Bruhdows/klink/hardware/electronics/hub/uart-allocation.csv

interface | tx_pin | tx_gpio | rx_pin | rx_gpio | af | rx_dma | tx_dma
USART1 | 58 | PB6 | 59 | PB7 | 7 | DMA2:S2:C4 | DMA2:S7:C4
USART2 | 16 | PA2 | 17 | PA3 | 7 | DMA1:S5:C4 | DMA1:S6:C4
USART3 | 29 | PB10 | 30 | PB11 | 7 | DMA1:S1:C4 | DMA1:S3:C4
UART4 | 14 | PA0 | 15 | PA1 | 8 | DMA1:S2:C4 | DMA1:S4:C4
UART5 | 53 | PC12 | 54 | PD2 | 8 | DMA1:S0:C4 | DMA1:S7:C4
USART6 | 37 | PC6 | 38 | PC7 | 8 | DMA2:S1:C5 | DMA2:S6:C5
