Bruhdows/klink/docs/images/gate-3d.png

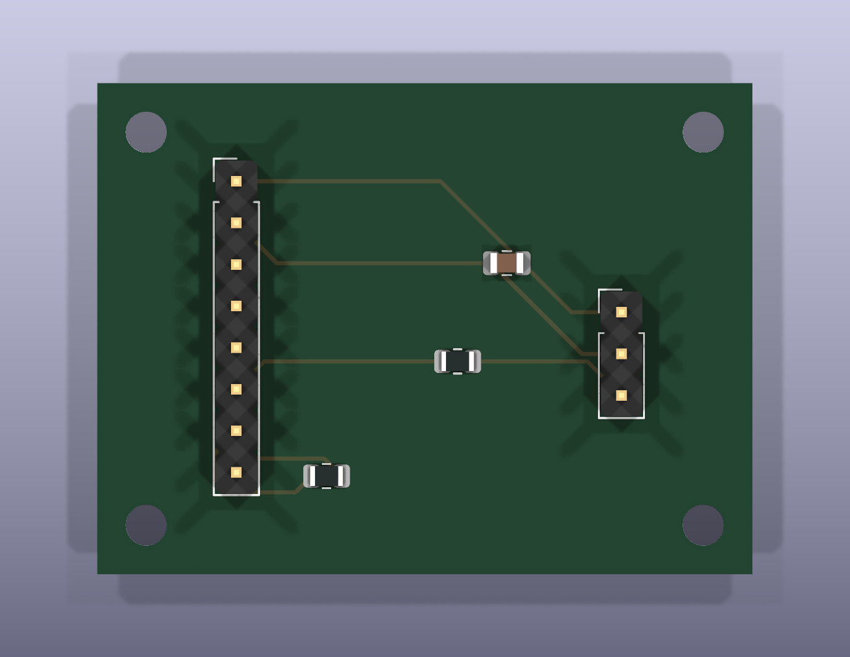
docs/images/gate-3d.png
