Bruhdows/klink/bom.csv

item | manufacturer | mpn | quantity_required | purchase_quantity | unit_price | extended_price | currency | purchase_url | supplier | ownership | price_status | checked_date | quantity_trial_3 | cost_trial_3 | quantity_trial_5 | cost_trial_5 | references | notes | budget_class
0466001.NR | Littelfuse | 0466001.NR | 80 | 80 | 0.555 | 44.4 | USD | https://www.mouser.com/en/ProductDetail/Littelfuse/0466001.NR?qs=ar9f0rk5DXDy6tpNfF8WnQ%3D%3D | Mouser | purchase required | supplier reference listing; not a quote | 2026-11-08 | 15 | 9.9 | 25 | 16.5 | tile:F1; tile:F2; tile:F3; tile:F4; tile:F5 | LCSC C151134 unavailable; use Mouser cut tape; 50+ USD 0.555. No full reel or MouseReel. | base_estimate
430476085716 | Wurth Elektronik | 430476085716 | 1 | 1 | 1.2 | 1.2 | USD | https://www.mouser.com/ProductDetail/Wurth-Elektronik/430476085716 | Mouser / assembler RFQ | purchase required | engineering allowance; NOT a verified supplier price |  | 1 | 1.2 | 1 | 1.2 | button:SW1 | Unquoted allowance; exact MPN retained; confirm stock, JLC classification and package before purchase. | base_estimate
120uF 6.3V | Panasonic | 6TPE120MAZB | 16 | 16 | 1.2 | 19.2 | USD | https://www.mouser.com/ProductDetail/Panasonic/6TPE120MAZB | Mouser / assembler RFQ | purchase required | engineering allowance; NOT a verified supplier price |  | 3 | 3.6 | 5 | 6.0 | tile:C7 | Unquoted allowance; exact MPN retained; confirm stock, JLC classification and package before purchase. | base_estimate
AP2112K-3.3TRG1 | Diodes Incorporated | AP2112K-3.3TRG1 | 19 | 20 | 0.1848 | 3.696 | USD | https://www.lcsc.com/product-detail/C51118.html | LCSC | purchase required | supplier reference listing; not a quote | 2026-11-08 | 10 | 1.848 | 10 | 1.848 | tile:U2; hub:U62; elevator:U2; marble-sensor:U1 | 9025 shown; minimum/multiple 5 | base_estimate
ASE-8.000MHZ-LC-T | Abracon | ASE-8.000MHZ-LC-T | 1 | 1 | 1.5 | 1.5 | USD | https://www.mouser.com/ProductDetail/Abracon/ASE-8.000MHZ-LC-T | Mouser / assembler RFQ | purchase required | engineering allowance; NOT a verified supplier price |  | 1 | 1.5 | 1 | 1.5 | hub:Y70 | Unquoted allowance; exact MPN retained; confirm stock, JLC classification and package before purchase. | base_estimate
ATtiny404-SSN | Microchip | ATTINY404-SSN | 1 | 1 | 0.7 | 0.7 | USD | https://www.mouser.com/ProductDetail/Microchip/ATTINY404-SSN | Mouser / assembler RFQ | purchase required | engineering allowance; NOT a verified supplier price |  | 1 | 0.7 | 1 | 0.7 | elevator:U4 | Unquoted allowance; exact MPN retained; confirm stock, JLC classification and package before purchase. | base_estimate
RESET | Omron | B3U-1000P | 3 | 3 | 0.7 | 2.1 | USD | https://www.mouser.com/ProductDetail/Omron/B3U-1000P | Mouser / assembler RFQ | purchase required | engineering allowance; NOT a verified supplier price |  | 3 | 2.1 | 3 | 2.1 | hub:SW1; hub:SW2; hub:SW3 | Unquoted allowance; exact MPN retained; confirm stock, JLC classification and package before purchase. | base_estimate
BAT54S,215 | Nexperia | BAT54S,215 | 1 | 1 | 0.15 | 0.15 | USD | https://www.mouser.com/ProductDetail/Nexperia/BAT54S%2C215 | Mouser / assembler RFQ | purchase required | engineering allowance; NOT a verified supplier price |  | 1 | 0.15 | 1 | 0.15 | elevator:D2 | Unquoted allowance; exact MPN retained; confirm stock, JLC classification and package before purchase. | base_estimate
BSS138LT1G | onsemi | BSS138LT1G | 9 | 9 | 0.15 | 1.35 | USD | https://www.mouser.com/ProductDetail/onsemi/BSS138LT1G | Mouser / assembler RFQ | purchase required | engineering allowance; NOT a verified supplier price |  | 9 | 1.35 | 9 | 1.35 | hub:Q2; hub:Q11; hub:Q13; hub:Q15; hub:Q17; hub:Q19; hub:Q21; hub:Q70; hub:Q71 | Unquoted allowance; exact MPN retained; confirm stock, JLC classification and package before purchase. | base_estimate
22uF 25V X7R | KEMET | C1210C226K3RACTU | 36 | 36 | 0.35 | 12.6 | USD | https://www.mouser.com/ProductDetail/KEMET/C1210C226K3RACTU | Mouser / assembler RFQ | purchase required | engineering allowance; NOT a verified supplier price |  | 10 | 3.5 | 14 | 4.9 | tile:C11; tile:C12; hub:C405; hub:C406; elevator:C4; elevator:C5 | Unquoted allowance; exact MPN retained; confirm stock, JLC classification and package before purchase. | base_estimate
1nF 50V | TDK | C2012C0G1H102J125AA | 1 | 1 | 0.1 | 0.1 | USD | https://www.mouser.com/ProductDetail/TDK/C2012C0G1H102J125AA | Mouser / assembler RFQ | purchase required | engineering allowance; NOT a verified supplier price |  | 1 | 0.1 | 1 | 0.1 | marble-sensor:C3 | Unquoted allowance; exact MPN retained; confirm stock, JLC classification and package before purchase. | base_estimate
22nF 50V C0G | TDK | C2012C0G1H223J125AA | 7 | 7 | 0.1 | 0.7 | USD | https://www.mouser.com/ProductDetail/TDK/C2012C0G1H223J125AA | Mouser / assembler RFQ | purchase required | engineering allowance; NOT a verified supplier price |  | 7 | 0.7 | 7 | 0.7 | hub:C103; hub:C113; hub:C123; hub:C133; hub:C143; hub:C153; elevator:C11 | Unquoted allowance; exact MPN retained; confirm stock, JLC classification and package before purchase. | base_estimate
2.2uF 16V X7R | TDK | C2012X7R1C225K125AB | 2 | 2 | 0.1 | 0.2 | USD | https://www.mouser.com/ProductDetail/TDK/C2012X7R1C225K125AB | Mouser / assembler RFQ | purchase required | engineering allowance; NOT a verified supplier price |  | 2 | 0.2 | 2 | 0.2 | hub:C415; hub:C416 | Unquoted allowance; exact MPN retained; confirm stock, JLC classification and package before purchase. | base_estimate
4.7uF | TDK | C2012X7R1C475K125AB | 18 | 18 | 0.1 | 1.8 | USD | https://www.mouser.com/ProductDetail/TDK/C2012X7R1C475K125AB | Mouser / assembler RFQ | purchase required | engineering allowance; NOT a verified supplier price |  | 5 | 0.5 | 7 | 0.7 | tile:C2; hub:C414; elevator:C8 | Unquoted allowance; exact MPN retained; confirm stock, JLC classification and package before purchase. | base_estimate
100nF 50V X7R | TDK | C2012X7R1H104K125AE | 322 | 322 | 0.1 | 32.2 | USD | https://www.mouser.com/ProductDetail/TDK/C2012X7R1H104K125AE | Mouser / assembler RFQ | purchase required | engineering allowance; NOT a verified supplier price |  | 101 | 10.1 | 135 | 13.5 | tile:C1; tile:C5; tile:C6; tile:C9; tile:C10; tile:C14; tile:C15; tile:C17; tile:C20; tile:C21; tile:C22; tile:C23; tile:C25; tile:C29; tile:C30; tile:C31; tile:C32; hub:C4; hub:C5; hub:C7; hub:C8; hub:C10; hub:C11; hub:C12; hub:C13; hub:C462; hub:C104; hub:C114; hub:C124; hub:C134; hub:C144; hub:C154; hub:C300; hub:C303; hub:C306; hub:C307; hub:C308; hub:C309; hub:C310; hub:C311; hub:C312; hub:C313; hub:C400; hub:C401; hub:C403; hub:C410; hub:C411; hub:C412; hub:C413; hub:C417; hub:C419; hub:C420; hub:C421; hub:C440; hub:C443; hub:C450; hub:C451; hub:C452; hub:C453; hub:C460; hub:C461; elevator:C2; elevator:C9; elevator:C10; elevator:C12; elevator:C13; gate:C1 | Unquoted allowance; exact MPN retained; confirm stock, JLC classification and package before purchase. | base_estimate
1uF | TDK | C2012X7R1H105K125AB | 94 | 94 | 0.1 | 9.4 | USD | https://www.mouser.com/ProductDetail/TDK/C2012X7R1H105K125AB | Mouser / assembler RFQ | purchase required | engineering allowance; NOT a verified supplier price |  | 42 | 4.2 | 50 | 5.0 | tile:C3; tile:C18; tile:C19; tile:C24; hub:C1; hub:C2; hub:C3; hub:C6; hub:C14; hub:C100; hub:C101; hub:C102; hub:C110; hub:C111; hub:C112; hub:C120; hub:C121; hub:C122; hub:C130; hub:C131; hub:C132; hub:C140; hub:C141; hub:C142; hub:C150; hub:C151; hub:C152; hub:C404; hub:C407; hub:C418; elevator:C3; elevator:C7; marble-sensor:C1; marble-sensor:C2 | Unquoted allowance; exact MPN retained; confirm stock, JLC classification and package before purchase. | base_estimate
10µF | TDK | C3216X7R1C106K160AC | 17 | 17 | 0.35 | 5.95 | USD | https://www.mouser.com/ProductDetail/TDK/C3216X7R1C106K160AC | Mouser / assembler RFQ | purchase required | engineering allowance; NOT a verified supplier price |  | 4 | 1.4 | 6 | 2.1 | tile:C4; hub:C408 | Unquoted allowance; exact MPN retained; confirm stock, JLC classification and package before purchase. | base_estimate
10uF 50V X7R | TDK | C3216X7R1H106K160AC | 19 | 19 | 0.35 | 6.65 | USD | https://www.mouser.com/ProductDetail/TDK/C3216X7R1H106K160AC | Mouser / assembler RFQ | purchase required | engineering allowance; NOT a verified supplier price |  | 6 | 2.1 | 8 | 2.8 | tile:C8; hub:C9; hub:C402; elevator:C1 | Unquoted allowance; exact MPN retained; confirm stock, JLC classification and package before purchase. | base_estimate
10nF 50V | Yageo | CC0805KRX7R9BB103 | 50 | 50 | 0.1 | 5.0 | USD | https://www.mouser.com/ProductDetail/Yageo/CC0805KRX7R9BB103 | Mouser / assembler RFQ | purchase required | engineering allowance; NOT a verified supplier price |  | 11 | 1.1 | 17 | 1.7 | tile:C13; tile:C16; tile:C33; elevator:C14; elevator:C15 | Unquoted allowance; exact MPN retained; confirm stock, JLC classification and package before purchase. | base_estimate
CH32X035G8U6 | WCH | CH32X035G8U6 | 16 | 16 | 0.4234 | 6.7744 | USD | https://www.lcsc.com/product-detail/C7437027.html | LCSC | purchase required | supplier reference listing; not a quote | 2026-11-08 | 3 | 1.6197 | 5 | 2.6995 | tile:U1 | 8785 shown | base_estimate
CSD19537Q3 | Texas Instruments | CSD19537Q3 | 7 | 7 | 1.5 | 10.5 | USD | https://www.mouser.com/ProductDetail/Texas-Instruments/CSD19537Q3 | Mouser / assembler RFQ | purchase required | engineering allowance; NOT a verified supplier price |  | 7 | 10.5 | 7 | 10.5 | hub:Q1; hub:Q10; hub:Q12; hub:Q14; hub:Q16; hub:Q18; hub:Q20 | Unquoted allowance; exact MPN retained; confirm stock, JLC classification and package before purchase. | base_estimate
DRV8876PWPR |  | DRV8876PWPR | 1 | 1 | 2.5 | 2.5 | USD | https://www.mouser.com/ProductDetail//DRV8876PWPR | Mouser / assembler RFQ | purchase required | engineering allowance; NOT a verified supplier price |  | 1 | 2.5 | 1 | 2.5 | elevator:U3 | Unquoted allowance; exact MPN retained; confirm stock, JLC classification and package before purchase. | base_estimate
100uF 25V | Panasonic | EEH-ZC1E101XP | 1 | 1 | 1.5 | 1.5 | USD | https://www.mouser.com/ProductDetail/Panasonic/EEH-ZC1E101XP | Mouser / assembler RFQ | purchase required | engineering allowance; NOT a verified supplier price |  | 1 | 1.5 | 1 | 1.5 | elevator:C6 | Unquoted allowance; exact MPN retained; confirm stock, JLC classification and package before purchase. | base_estimate
10.5k 0.1% | Panasonic | ERA6AEB1052V | 1 | 1 | 0.3 | 0.3 | USD | https://www.mouser.com/ProductDetail/Panasonic/ERA6AEB1052V | Mouser / assembler RFQ | purchase required | engineering allowance; NOT a verified supplier price |  | 1 | 0.3 | 1 | 0.3 | hub:R14 | Unquoted allowance; exact MPN retained; confirm stock, JLC classification and package before purchase. | base_estimate
INA301A1IDGKR | Texas Instruments | INA301A1IDGKR | 7 | 7 | 3.5 | 24.5 | USD | https://www.mouser.com/ProductDetail/Texas-Instruments/INA301A1IDGKR | Mouser / assembler RFQ | purchase required | engineering allowance; NOT a verified supplier price |  | 7 | 24.5 | 7 | 24.5 | hub:U4; hub:U21; hub:U23; hub:U25; hub:U27; hub:U29; hub:U31 | Unquoted allowance; exact MPN retained; confirm stock, JLC classification and package before purchase. | base_estimate
LMR36510ADDAR | Texas Instruments | LMR36510ADDAR | 1 | 1 | 1.7 | 1.7 | USD | https://www.mouser.com/ProductDetail/Texas-Instruments/LMR36510ADDAR | Mouser / assembler RFQ | purchase required | engineering allowance; NOT a verified supplier price |  | 1 | 1.7 | 1 | 1.7 | elevator:U1 | Unquoted allowance; exact MPN retained; confirm stock, JLC classification and package before purchase. | base_estimate
LMR36520ADDAR | Texas Instruments | LMR36520ADDAR | 17 | 17 | 1.0022 | 17.0374 | USD | https://www.lcsc.com/product-detail/C2879422.html | LCSC | purchase required | supplier reference listing; not a quote | 2026-11-08 | 4 | 4.8516 | 6 | 7.2774 | tile:U4; hub:U61 | 5727 shown | base_estimate
IR_EMITTER | Harwin | M20-9990246 | 2 | 2 | 0.7 | 1.4 | USD | https://www.mouser.com/ProductDetail/Harwin/M20-9990246 | Mouser / assembler RFQ | purchase required | engineering allowance; NOT a verified supplier price |  | 2 | 1.4 | 2 | 1.4 | marble-sensor:J2; marble-sensor:J3 | Unquoted allowance; exact MPN retained; confirm stock, JLC classification and package before purchase. | base_estimate
FS90_SERVO | Harwin | M20-9990346 | 1 | 1 | 0.7 | 0.7 | USD | https://www.mouser.com/ProductDetail/Harwin/M20-9990346 | Mouser / assembler RFQ | purchase required | engineering allowance; NOT a verified supplier price |  | 1 | 0.7 | 1 | 0.7 | gate:J2 | Unquoted allowance; exact MPN retained; confirm stock, JLC classification and package before purchase. | base_estimate
MODULE_SERVICE | Harwin | M20-9990846 | 3 | 3 | 0.7 | 2.1 | USD | https://www.mouser.com/ProductDetail/Harwin/M20-9990846 | Mouser / assembler RFQ | purchase required | engineering allowance; NOT a verified supplier price |  | 3 | 2.1 | 3 | 2.1 | button:J1; marble-sensor:J1; gate:J1 | Unquoted allowance; exact MPN retained; confirm stock, JLC classification and package before purchase. | base_estimate
100k | Yageo | RC0805FR-07100KL | 76 | 76 | 0.04 | 3.04 | USD | https://www.mouser.com/ProductDetail/Yageo/RC0805FR-07100KL | Mouser / assembler RFQ | purchase required | engineering allowance; NOT a verified supplier price |  | 24 | 0.96 | 32 | 1.28 | tile:R10; tile:R13; tile:R14; tile:R47; hub:R303; hub:R404; hub:R416; hub:R471; hub:R472; hub:R494; elevator:R2; elevator:R10; elevator:R11; elevator:R12; elevator:R13; elevator:R14 | Unquoted allowance; exact MPN retained; confirm stock, JLC classification and package before purchase. | base_estimate
10k | Yageo | RC0805FR-0710KL | 222 | 300 | 0.0049 | 1.47 | USD | https://www.lcsc.com/product-detail/C84376.html | LCSC | purchase required | supplier reference listing; not a quote | 2026-11-08 | 100 | 0.49 | 100 | 0.49 | tile:R4; tile:R7; tile:R8; tile:R9; tile:R12; tile:R15; tile:R19; tile:R20; tile:R27; tile:R46; tile:R48; tile:R49; hub:R2; hub:R6; hub:R7; hub:R16; hub:R17; hub:R18; hub:R473; hub:R109; hub:R129; hub:R149; hub:R169; hub:R189; hub:R209; hub:R405; hub:R408; hub:R412; hub:R413; hub:R414; hub:R415; hub:R417; hub:R418; hub:R420; hub:R480; hub:R481; hub:R482; hub:R470; elevator:R3; elevator:R9; elevator:R18; marble-sensor:R3 | supplier reference listing; verify current tier | base_estimate
12k 1% | Yageo | RC0805FR-0712KL | 16 | 16 | 0.04 | 0.64 | USD | https://www.mouser.com/ProductDetail/Yageo/RC0805FR-0712KL | Mouser / assembler RFQ | purchase required | engineering allowance; NOT a verified supplier price |  | 3 | 0.12 | 5 | 0.2 | tile:R21 | Unquoted allowance; exact MPN retained; confirm stock, JLC classification and package before purchase. | base_estimate
150k 1% | Yageo | RC0805FR-07150KL | 17 | 17 | 0.04 | 0.68 | USD | https://www.mouser.com/ProductDetail/Yageo/RC0805FR-07150KL | Mouser / assembler RFQ | purchase required | engineering allowance; NOT a verified supplier price |  | 4 | 0.16 | 6 | 0.24 | tile:R11; elevator:R16 | Unquoted allowance; exact MPN retained; confirm stock, JLC classification and package before purchase. | base_estimate
1k | Yageo | RC0805FR-071KL | 74 | 74 | 0.04 | 2.96 | USD | https://www.mouser.com/ProductDetail/Yageo/RC0805FR-071KL | Mouser / assembler RFQ | purchase required | engineering allowance; NOT a verified supplier price |  | 22 | 0.88 | 30 | 1.2 | tile:R5; tile:R6; tile:R24; tile:R50; hub:R419; hub:R483; hub:R484; hub:R485; elevator:R15; elevator:R20; button:R1; button:R2; marble-sensor:R4; gate:R2 | Unquoted allowance; exact MPN retained; confirm stock, JLC classification and package before purchase. | base_estimate
1M 1% | Yageo | RC0805FR-071ML | 1 | 1 | 0.04 | 0.04 | USD | https://www.mouser.com/ProductDetail/Yageo/RC0805FR-071ML | Mouser / assembler RFQ | purchase required | engineering allowance; NOT a verified supplier price |  | 1 | 0.04 | 1 | 0.04 | hub:R495 | Unquoted allowance; exact MPN retained; confirm stock, JLC classification and package before purchase. | base_estimate
22k 1% | Yageo | RC0805FR-0722KL | 17 | 17 | 0.04 | 0.68 | USD | https://www.mouser.com/ProductDetail/Yageo/RC0805FR-0722KL | Mouser / assembler RFQ | purchase required | engineering allowance; NOT a verified supplier price |  | 17 | 0.68 | 17 | 0.68 | hub:R15; hub:R19; hub:R103; hub:R104; hub:R123; hub:R124; hub:R143; hub:R144; hub:R163; hub:R164; hub:R183; hub:R184; hub:R203; hub:R204; hub:R302; elevator:R1; elevator:R17 | Unquoted allowance; exact MPN retained; confirm stock, JLC classification and package before purchase. | base_estimate
22 1% | Yageo | RC0805FR-0722RL | 2 | 2 | 0.04 | 0.08 | USD | https://www.mouser.com/ProductDetail/Yageo/RC0805FR-0722RL | Mouser / assembler RFQ | purchase required | engineering allowance; NOT a verified supplier price |  | 2 | 0.08 | 2 | 0.08 | hub:R492; hub:R493 | Unquoted allowance; exact MPN retained; confirm stock, JLC classification and package before purchase. | base_estimate
24k 1% | Yageo | RC0805FR-0724KL | 16 | 16 | 0.04 | 0.64 | USD | https://www.mouser.com/ProductDetail/Yageo/RC0805FR-0724KL | Mouser / assembler RFQ | purchase required | engineering allowance; NOT a verified supplier price |  | 3 | 0.12 | 5 | 0.2 | tile:R16 | Unquoted allowance; exact MPN retained; confirm stock, JLC classification and package before purchase. | base_estimate
2.2k 1% | Yageo | RC0805FR-072K2L | 1 | 1 | 0.04 | 0.04 | USD | https://www.mouser.com/ProductDetail/Yageo/RC0805FR-072K2L | Mouser / assembler RFQ | purchase required | engineering allowance; NOT a verified supplier price |  | 1 | 0.04 | 1 | 0.04 | marble-sensor:R1 | Unquoted allowance; exact MPN retained; confirm stock, JLC classification and package before purchase. | base_estimate
330 | Yageo | RC0805FR-07330RL | 16 | 16 | 0.04 | 0.64 | USD | https://www.mouser.com/ProductDetail/Yageo/RC0805FR-07330RL | Mouser / assembler RFQ | purchase required | engineering allowance; NOT a verified supplier price |  | 3 | 0.12 | 5 | 0.2 | tile:R3 | Unquoted allowance; exact MPN retained; confirm stock, JLC classification and package before purchase. | base_estimate
33 1% | Yageo | RC0805FR-0733RL | 1 | 1 | 0.04 | 0.04 | USD | https://www.mouser.com/ProductDetail/Yageo/RC0805FR-0733RL | Mouser / assembler RFQ | purchase required | engineering allowance; NOT a verified supplier price |  | 1 | 0.04 | 1 | 0.04 | hub:R411 | Unquoted allowance; exact MPN retained; confirm stock, JLC classification and package before purchase. | base_estimate
402k 1% | Yageo | RC0805FR-07402KL | 33 | 33 | 0.04 | 1.32 | USD | https://www.mouser.com/ProductDetail/Yageo/RC0805FR-07402KL | Mouser / assembler RFQ | purchase required | engineering allowance; NOT a verified supplier price |  | 7 | 0.28 | 11 | 0.44 | tile:R22; tile:R23; hub:R401 | Unquoted allowance; exact MPN retained; confirm stock, JLC classification and package before purchase. | base_estimate
40.2k 1% | Yageo | RC0805FR-0740K2L | 1 | 1 | 0.04 | 0.04 | USD | https://www.mouser.com/ProductDetail/Yageo/RC0805FR-0740K2L | Mouser / assembler RFQ | purchase required | engineering allowance; NOT a verified supplier price |  | 1 | 0.04 | 1 | 0.04 | hub:R400 | Unquoted allowance; exact MPN retained; confirm stock, JLC classification and package before purchase. | base_estimate
47k | Yageo | RC0805FR-0747KL | 142 | 142 | 0.04 | 5.68 | USD | https://www.mouser.com/ProductDetail/Yageo/RC0805FR-0747KL | Mouser / assembler RFQ | purchase required | engineering allowance; NOT a verified supplier price |  | 38 | 1.52 | 54 | 2.16 | tile:R32; tile:R33; tile:R36; tile:R37; tile:R40; tile:R41; tile:R44; tile:R45; hub:R304; hub:R442; hub:R443; hub:R446; hub:R447; hub:R450; hub:R451; hub:R454; hub:R455; hub:R458; hub:R459; hub:R462; hub:R463; hub:R496 | Unquoted allowance; exact MPN retained; confirm stock, JLC classification and package before purchase. | base_estimate
4.7k | Yageo | RC0805FR-074K7L | 36 | 36 | 0.04 | 1.44 | USD | https://www.mouser.com/ProductDetail/Yageo/RC0805FR-074K7L | Mouser / assembler RFQ | purchase required | engineering allowance; NOT a verified supplier price |  | 10 | 0.4 | 14 | 0.56 | tile:R1; tile:R2; hub:R3; hub:R4; hub:R5; gate:R1 | Unquoted allowance; exact MPN retained; confirm stock, JLC classification and package before purchase. | base_estimate
5.1k 1% | Yageo | RC0805FR-075K1L | 2 | 2 | 0.04 | 0.08 | USD | https://www.mouser.com/ProductDetail/Yageo/RC0805FR-075K1L | Mouser / assembler RFQ | purchase required | engineering allowance; NOT a verified supplier price |  | 2 | 0.08 | 2 | 0.08 | hub:R490; hub:R491 | Unquoted allowance; exact MPN retained; confirm stock, JLC classification and package before purchase. | base_estimate
150 1% 0.25W | Yageo | RC1206FR-07150RL | 1 | 1 | 0.1 | 0.1 | USD | https://www.mouser.com/ProductDetail/Yageo/RC1206FR-07150RL | Mouser / assembler RFQ | purchase required | engineering allowance; NOT a verified supplier price |  | 1 | 0.1 | 1 | 0.1 | elevator:R19 | Unquoted allowance; exact MPN retained; confirm stock, JLC classification and package before purchase. | base_estimate
220 1% 0.25W | Yageo | RC1206FR-07220RL | 1 | 1 | 0.1 | 0.1 | USD | https://www.mouser.com/ProductDetail/Yageo/RC1206FR-07220RL | Mouser / assembler RFQ | purchase required | engineering allowance; NOT a verified supplier price |  | 1 | 0.1 | 1 | 0.1 | marble-sensor:R2 | Unquoted allowance; exact MPN retained; confirm stock, JLC classification and package before purchase. | base_estimate
2.2k 1% 0.25W | Yageo | RC1206FR-072K2L | 140 | 140 | 0.1 | 14.0 | USD | https://www.mouser.com/ProductDetail/Yageo/RC1206FR-072K2L | Mouser / assembler RFQ | purchase required | engineering allowance; NOT a verified supplier price |  | 36 | 3.6 | 52 | 5.2 | tile:R30; tile:R31; tile:R34; tile:R35; tile:R38; tile:R39; tile:R42; tile:R43; hub:R440; hub:R441; hub:R444; hub:R445; hub:R448; hub:R449; hub:R452; hub:R453; hub:R456; hub:R457; hub:R460; hub:R461 | Unquoted allowance; exact MPN retained; confirm stock, JLC classification and package before purchase. | base_estimate
10k 1% 0.25W | Yageo | RC1206FR0710KL | 7 | 7 | 0.1 | 0.7 | USD | https://www.mouser.com/ProductDetail/Yageo/RC1206FR0710KL | Mouser / assembler RFQ | purchase required | engineering allowance; NOT a verified supplier price |  | 7 | 0.7 | 7 | 0.7 | hub:R20; hub:R110; hub:R130; hub:R150; hub:R170; hub:R190; hub:R210 | Unquoted allowance; exact MPN retained; confirm stock, JLC classification and package before purchase. | base_estimate
470 1% 2W | Yageo | RC2512FK-7W470RL | 1 | 1 | 0.1 | 0.1 | USD | https://www.mouser.com/ProductDetail/Yageo/RC2512FK-7W470RL | Mouser / assembler RFQ | purchase required | engineering allowance; NOT a verified supplier price |  | 1 | 0.1 | 1 | 0.1 | hub:R1 | Unquoted allowance; exact MPN retained; confirm stock, JLC classification and package before purchase. | base_estimate
100k 0.1% | Yageo | RT0805BRD07100KL | 17 | 17 | 0.3 | 5.1 | USD | https://www.mouser.com/ProductDetail/Yageo/RT0805BRD07100KL | Mouser / assembler RFQ | purchase required | engineering allowance; NOT a verified supplier price |  | 4 | 1.2 | 6 | 1.8 | tile:R28; hub:R406 | Unquoted allowance; exact MPN retained; confirm stock, JLC classification and package before purchase. | base_estimate
103k 0.1% | Yageo | RT0805BRD07103KL | 16 | 16 | 0.3 | 4.8 | USD | https://www.mouser.com/ProductDetail/Yageo/RT0805BRD07103KL | Mouser / assembler RFQ | purchase required | engineering allowance; NOT a verified supplier price |  | 3 | 0.9 | 5 | 1.5 | tile:R51 | Unquoted allowance; exact MPN retained; confirm stock, JLC classification and package before purchase. | base_estimate
10k 0.1% | Yageo | RT0805BRD0710KL | 67 | 80 | 0.0433 | 3.464 | USD | https://www.lcsc.com/product-detail/C110775.html | LCSC | purchase required | supplier reference listing; not a quote | 2026-11-08 | 20 | 0.866 | 40 | 1.732 | tile:R18; tile:R55; tile:R26; tile:R52; hub:R403; elevator:R5; elevator:R7 | supplier reference listing; verify current tier | base_estimate
110k 0.1% | Yageo | RT0805BRD07110KL | 1 | 1 | 0.3 | 0.3 | USD | https://www.mouser.com/ProductDetail/Yageo/RT0805BRD07110KL | Mouser / assembler RFQ | purchase required | engineering allowance; NOT a verified supplier price |  | 1 | 0.3 | 1 | 0.3 | elevator:R4 | Unquoted allowance; exact MPN retained; confirm stock, JLC classification and package before purchase. | base_estimate
187k 0.1% | Yageo | RT0805BRD07187KL | 33 | 33 | 0.3 | 9.9 | USD | https://www.mouser.com/ProductDetail/Yageo/RT0805BRD07187KL | Mouser / assembler RFQ | purchase required | engineering allowance; NOT a verified supplier price |  | 7 | 2.1 | 11 | 3.3 | tile:R17; tile:R25; hub:R402 | Unquoted allowance; exact MPN retained; confirm stock, JLC classification and package before purchase. | base_estimate
23.2k 0.1% | Yageo | RT0805BRD0723K2L | 1 | 1 | 0.3 | 0.3 | USD | https://www.mouser.com/ProductDetail/Yageo/RT0805BRD0723K2L | Mouser / assembler RFQ | purchase required | engineering allowance; NOT a verified supplier price |  | 1 | 0.3 | 1 | 0.3 | elevator:R6 | Unquoted allowance; exact MPN retained; confirm stock, JLC classification and package before purchase. | base_estimate
24.9k 0.1% | Yageo | RT0805BRD0724K9L | 17 | 17 | 0.3 | 5.1 | USD | https://www.mouser.com/ProductDetail/Yageo/RT0805BRD0724K9L | Mouser / assembler RFQ | purchase required | engineering allowance; NOT a verified supplier price |  | 4 | 1.2 | 6 | 1.8 | tile:R29; hub:R407 | Unquoted allowance; exact MPN retained; confirm stock, JLC classification and package before purchase. | base_estimate
2.87k 0.1% | Yageo | RT0805BRD072K87L | 1 | 1 | 0.3 | 0.3 | USD | https://www.mouser.com/ProductDetail/Yageo/RT0805BRD072K87L | Mouser / assembler RFQ | purchase required | engineering allowance; NOT a verified supplier price |  | 1 | 0.3 | 1 | 0.3 | elevator:R8 | Unquoted allowance; exact MPN retained; confirm stock, JLC classification and package before purchase. | base_estimate
35.7k 0.1% | Yageo | RT0805BRD0735K7L | 16 | 16 | 0.3 | 4.8 | USD | https://www.mouser.com/ProductDetail/Yageo/RT0805BRD0735K7L | Mouser / assembler RFQ | purchase required | engineering allowance; NOT a verified supplier price |  | 3 | 0.9 | 5 | 1.5 | tile:R54 | Unquoted allowance; exact MPN retained; confirm stock, JLC classification and package before purchase. | base_estimate
3.32k 0.1% | Yageo | RT0805BRD073K32L | 16 | 16 | 0.3 | 4.8 | USD | https://www.mouser.com/ProductDetail/Yageo/RT0805BRD073K32L | Mouser / assembler RFQ | purchase required | engineering allowance; NOT a verified supplier price |  | 3 | 0.9 | 5 | 1.5 | tile:R53 | Unquoted allowance; exact MPN retained; confirm stock, JLC classification and package before purchase. | base_estimate
SMBJ13A-E3/52 | Vishay | SMBJ13A-E3/52 | 1 | 1 | 0.35 | 0.35 | USD | https://www.mouser.com/ProductDetail/Vishay/SMBJ13A-E3%2F52 | Mouser / assembler RFQ | purchase required | engineering allowance; NOT a verified supplier price |  | 1 | 0.35 | 1 | 0.35 | elevator:D1 | Unquoted allowance; exact MPN retained; confirm stock, JLC classification and package before purchase. | base_estimate
SMBJ22A-E3/52 | Vishay | SMBJ22A-E3/52 | 39 | 39 | 0.35 | 13.65 | USD | https://www.mouser.com/ProductDetail/Vishay/SMBJ22A-E3%2F52 | Mouser / assembler RFQ | purchase required | engineering allowance; NOT a verified supplier price |  | 13 | 4.55 | 17 | 5.95 | tile:D6; tile:D7; hub:D8; hub:D100; hub:D101; hub:D102; hub:D103; hub:D104; hub:D105 | Unquoted allowance; exact MPN retained; confirm stock, JLC classification and package before purchase. | base_estimate
SMBJ22CA-E3/52 | Vishay | SMBJ22CA-E3/52 | 32 | 32 | 0.35 | 11.2 | USD | https://www.mouser.com/ProductDetail/Vishay/SMBJ22CA-E3%2F52 | Mouser / assembler RFQ | purchase required | engineering allowance; NOT a verified supplier price |  | 6 | 2.1 | 10 | 3.5 | tile:D4; tile:D5 | Unquoted allowance; exact MPN retained; confirm stock, JLC classification and package before purchase. | base_estimate
SN74AHCT1G125DBVR | Texas Instruments | SN74AHCT1G125DBVR | 16 | 20 | 0.1009 | 2.018 | USD | https://www.lcsc.com/product-detail/C7484.html | LCSC | purchase required | supplier reference listing; not a quote | 2026-11-08 | 5 | 0.5045 | 5 | 0.5045 | tile:U6 | 13395 shown; minimum/multiple 5 | base_estimate
SN74HCS11PWR | Texas Instruments | SN74HCS11PWR | 2 | 2 | 0.7 | 1.4 | USD | https://www.mouser.com/ProductDetail/Texas-Instruments/SN74HCS11PWR | Mouser / assembler RFQ | purchase required | engineering allowance; NOT a verified supplier price |  | 2 | 1.4 | 2 | 1.4 | hub:U40; hub:U43 | Unquoted allowance; exact MPN retained; confirm stock, JLC classification and package before purchase. | base_estimate
SN74LVC1G04DBVR | Texas Instruments | SN74LVC1G04DBVR | 1 | 1 | 0.7 | 0.7 | USD | https://www.mouser.com/ProductDetail/Texas-Instruments/SN74LVC1G04DBVR | Mouser / assembler RFQ | purchase required | engineering allowance; NOT a verified supplier price |  | 1 | 0.7 | 1 | 0.7 | hub:U49 | Unquoted allowance; exact MPN retained; confirm stock, JLC classification and package before purchase. | base_estimate
SN74LVC1G08DBVR | Texas Instruments | SN74LVC1G08DBVR | 17 | 20 | 0.0489 | 0.978 | USD | https://www.lcsc.com/product-detail/C7666.html | LCSC | purchase required | supplier reference listing; not a quote | 2026-11-08 | 10 | 0.489 | 10 | 0.489 | tile:U15; hub:U47 | 90360 shown; minimum/multiple 10 | base_estimate
SN74LVC1G11DBVR | Texas Instruments | SN74LVC1G11DBVR | 1 | 1 | 0.7 | 0.7 | USD | https://www.mouser.com/ProductDetail/Texas-Instruments/SN74LVC1G11DBVR | Mouser / assembler RFQ | purchase required | engineering allowance; NOT a verified supplier price |  | 1 | 0.7 | 1 | 0.7 | hub:U6 | Unquoted allowance; exact MPN retained; confirm stock, JLC classification and package before purchase. | base_estimate
SN74LVC1G14DBVR | Texas Instruments | SN74LVC1G14DBVR | 1 | 1 | 0.7 | 0.7 | USD | https://www.mouser.com/ProductDetail/Texas-Instruments/SN74LVC1G14DBVR | Mouser / assembler RFQ | purchase required | engineering allowance; NOT a verified supplier price |  | 1 | 0.7 | 1 | 0.7 | hub:U5 | Unquoted allowance; exact MPN retained; confirm stock, JLC classification and package before purchase. | base_estimate
SN74LVC1G32DBVR | Texas Instruments | SN74LVC1G32DBVR | 2 | 2 | 0.7 | 1.4 | USD | https://www.mouser.com/ProductDetail/Texas-Instruments/SN74LVC1G32DBVR | Mouser / assembler RFQ | purchase required | engineering allowance; NOT a verified supplier price |  | 2 | 1.4 | 2 | 1.4 | hub:U46; hub:U48 | Unquoted allowance; exact MPN retained; confirm stock, JLC classification and package before purchase. | base_estimate
SN74LVC1G97DBVR | Texas Instruments | SN74LVC1G97DBVR | 1 | 1 | 0.7 | 0.7 | USD | https://www.mouser.com/ProductDetail/Texas-Instruments/SN74LVC1G97DBVR | Mouser / assembler RFQ | purchase required | engineering allowance; NOT a verified supplier price |  | 1 | 0.7 | 1 | 0.7 | hub:U79 | Unquoted allowance; exact MPN retained; confirm stock, JLC classification and package before purchase. | base_estimate
SN74LVC244APWR | Texas Instruments | SN74LVC244APWR | 18 | 20 | 0.3026 | 6.052 | USD | https://www.lcsc.com/product-detail/C7668.html | LCSC | purchase required | supplier reference listing; not a quote | 2026-11-08 | 5 | 1.513 | 10 | 3.026 | tile:U8; hub:U80; hub:U83 | search-index listing; recheck before ordering | base_estimate
SN74LVC2G17DBVR | Texas Instruments | SN74LVC2G17DBVR | 2 | 2 | 0.7 | 1.4 | USD | https://www.mouser.com/ProductDetail/Texas-Instruments/SN74LVC2G17DBVR | Mouser / assembler RFQ | purchase required | engineering allowance; NOT a verified supplier price |  | 2 | 1.4 | 2 | 1.4 | hub:U51; hub:U53 | Unquoted allowance; exact MPN retained; confirm stock, JLC classification and package before purchase. | base_estimate
SN74LVC74APWR | Texas Instruments | SN74LVC74APWR | 1 | 1 | 0.7 | 0.7 | USD | https://www.mouser.com/ProductDetail/Texas-Instruments/SN74LVC74APWR | Mouser / assembler RFQ | purchase required | engineering allowance; NOT a verified supplier price |  | 1 | 0.7 | 1 | 0.7 | hub:U50 | Unquoted allowance; exact MPN retained; confirm stock, JLC classification and package before purchase. | base_estimate
SRP7050TA-150M | Bourns | SRP7050TA-150M | 17 | 17 | 1.1 | 18.7 | USD | https://www.mouser.com/ProductDetail/Bourns/SRP7050TA-150M | Mouser / assembler RFQ | purchase required | engineering allowance; NOT a verified supplier price |  | 4 | 4.4 | 6 | 6.6 | tile:L1; hub:L60 | Unquoted allowance; exact MPN retained; confirm stock, JLC classification and package before purchase. | base_estimate
33uH | Bourns | SRP7050TA-330M | 1 | 1 | 1.5 | 1.5 | USD | https://www.mouser.com/ProductDetail/Bourns/SRP7050TA-330M | Mouser / assembler RFQ | purchase required | engineering allowance; NOT a verified supplier price |  | 1 | 1.5 | 1 | 1.5 | elevator:L1 | Unquoted allowance; exact MPN retained; confirm stock, JLC classification and package before purchase. | base_estimate
STM32F405RGT6 | STMicroelectronics | STM32F405RGT6 | 1 | 1 | 7 | 7 | USD | https://www.mouser.com/ProductDetail/STMicroelectronics/STM32F405RGT6 | Mouser / assembler RFQ | purchase required | engineering allowance; NOT a verified supplier price |  | 1 | 7 | 1 | 7 | hub:U70 | Unquoted allowance; exact MPN retained; confirm stock, JLC classification and package before purchase. | base_estimate
STUSB4500QTR | STMicroelectronics | STUSB4500QTR | 1 | 1 | 3 | 3 | USD | https://www.mouser.com/ProductDetail/STMicroelectronics/STUSB4500QTR | Mouser / assembler RFQ | purchase required | engineering allowance; NOT a verified supplier price |  | 1 | 3 | 1 | 3 | hub:U1 | Unquoted allowance; exact MPN retained; confirm stock, JLC classification and package before purchase. | base_estimate
TCA9535PWR | Texas Instruments | TCA9535PWR | 1 | 1 | 1 | 1 | USD | https://www.mouser.com/ProductDetail/Texas-Instruments/TCA9535PWR | Mouser / assembler RFQ | purchase required | engineering allowance; NOT a verified supplier price |  | 1 | 1 | 1 | 1 | hub:U77 | Unquoted allowance; exact MPN retained; confirm stock, JLC classification and package before purchase. | base_estimate
TEFT4300 (off-board) | Vishay | TEFT4300 | 1 | 1 | 0.55 | 0.55 | USD | https://www.mouser.com/ProductDetail/Vishay/TEFT4300 | Mouser / assembler RFQ | purchase required | engineering allowance; NOT a verified supplier price |  | 1 | 0.55 | 1 | 0.55 | marble-sensor:Q1 | Unquoted allowance; exact MPN retained; confirm stock, JLC classification and package before purchase. | base_estimate
TMUX1511PWR | Texas Instruments | TMUX1511PWR | 35 | 35 | 0.3304 | 11.564 | USD | https://www.lcsc.com/product-detail/C2866750.html | LCSC | purchase required | supplier reference listing; not a quote | 2026-11-08 | 9 | 4.0293 | 13 | 4.9179 | tile:U12; tile:U13; hub:U74; hub:U75; hub:U76 | 7205 shown | base_estimate
10k 0.1% | Vishay | TNPW080510K0BEEA | 20 | 20 | 0.3 | 6.0 | USD | https://www.mouser.com/ProductDetail/Vishay/TNPW080510K0BEEA | Mouser / assembler RFQ | purchase required | engineering allowance; NOT a verified supplier price |  | 20 | 6.0 | 20 | 6.0 | hub:R10; hub:R12; hub:R101; hub:R106; hub:R108; hub:R121; hub:R126; hub:R128; hub:R141; hub:R146; hub:R148; hub:R161; hub:R166; hub:R168; hub:R181; hub:R186; hub:R188; hub:R201; hub:R206; hub:R208 | Unquoted allowance; exact MPN retained; confirm stock, JLC classification and package before purchase. | base_estimate
130k 0.1% | Vishay | TNPW0805130KBEEA | 6 | 6 | 0.3 | 1.8 | USD | https://www.mouser.com/ProductDetail/Vishay/TNPW0805130KBEEA | Mouser / assembler RFQ | purchase required | engineering allowance; NOT a verified supplier price |  | 6 | 1.8 | 6 | 1.8 | hub:R105; hub:R125; hub:R145; hub:R165; hub:R185; hub:R205 | Unquoted allowance; exact MPN retained; confirm stock, JLC classification and package before purchase. | base_estimate
135k 0.1% | Vishay | TNPW0805135KBEEA | 1 | 1 | 0.3 | 0.3 | USD | https://www.mouser.com/ProductDetail/Vishay/TNPW0805135KBEEA | Mouser / assembler RFQ | purchase required | engineering allowance; NOT a verified supplier price |  | 1 | 0.3 | 1 | 0.3 | hub:R9 | Unquoted allowance; exact MPN retained; confirm stock, JLC classification and package before purchase. | base_estimate
172k 0.1% | Vishay | TNPW0805172KBEEA | 7 | 7 | 0.3 | 2.1 | USD | https://www.mouser.com/ProductDetail/Vishay/TNPW0805172KBEEA | Mouser / assembler RFQ | purchase required | engineering allowance; NOT a verified supplier price |  | 7 | 2.1 | 7 | 2.1 | hub:R11; hub:R107; hub:R127; hub:R147; hub:R167; hub:R187; hub:R207 | Unquoted allowance; exact MPN retained; confirm stock, JLC classification and package before purchase. | base_estimate
3k 0.1% | Vishay | TNPW08053K00BEEA | 7 | 7 | 0.3 | 2.1 | USD | https://www.mouser.com/ProductDetail/Vishay/TNPW08053K00BEEA | Mouser / assembler RFQ | purchase required | engineering allowance; NOT a verified supplier price |  | 7 | 2.1 | 7 | 2.1 | hub:R13; hub:R102; hub:R122; hub:R142; hub:R162; hub:R182; hub:R202 | Unquoted allowance; exact MPN retained; confirm stock, JLC classification and package before purchase. | base_estimate
TPS259470LRPWR | Texas Instruments | TPS259470LRPWR | 16 | 16 | .9211 | 14.7376 | USD | https://www.lcsc.com/product-image/C3662793.html | LCSC | purchase required | supplier reference listing; not a quote | 2026-11-09 | 3 | 3.0630 | 5 | 5.1050 | tile:U3 | Image-page reference listing: 10+ USD 0.9211, 1+ USD 1.021, 1333 shown, versus earlier cached 4. Product-detail page did not expose live stock. Reconfirm 16 plus assembler attrition and JLC availability before order. Not a reserved quote. | base_estimate
TPS26600PWPR | Texas Instruments | TPS26600PWPR | 33 | 33 | 1.0992 | 36.2736 | USD | https://www.lcsc.com/product-detail/C544399.html | LCSC | purchase required | supplier reference listing; not a quote | 2026-11-08 | 7 | 10.6631 | 11 | 13.7434 | tile:U5; tile:U7; hub:U60 | 6387 shown | base_estimate
TPS26630RGER | Texas Instruments | TPS26630RGER | 7 | 7 | 4.81 | 33.67 | USD | https://www.digikey.com/en/products/detail/texas-instruments/TPS26630RGET/10434724 | DigiKey (approved RGET packaging alternate) | purchase required | supplier reference listing; OUT OF STOCK; NOT a quote | 2026-11-09 | 7 | 33.67 | 7 | 33.67 | hub:U2; hub:U20; hub:U22; hub:U24; hub:U26; hub:U28; hub:U30 | Schematic MPN RGER retained; purchase same-die TPS26630RGET cut tape (296-TPS26630RGETCT-ND), approved 250-reel packaging alternate per TI SLVSE94G ordering table. Seven at USD4.81 cost33.67, less than buying ten at3.659 (36.59). No full reel/Digi-Reel fee. Stock0; 250 expected19-Nov-2026 is not a promise. TI also unavailable. Do not substitute another functional variant. | base_estimate
TPS3808G01DBVR | Texas Instruments | TPS3808G01DBVR | 17 | 17 | 0.7 | 11.9 | USD | https://www.mouser.com/ProductDetail/Texas-Instruments/TPS3808G01DBVR | Mouser / assembler RFQ | purchase required | engineering allowance; NOT a verified supplier price |  | 4 | 2.8 | 6 | 4.2 | tile:U14; hub:U52 | Unquoted allowance; exact MPN retained; confirm stock, JLC classification and package before purchase. | base_estimate
TPS3808G30DBVR | Texas Instruments | TPS3808G30DBVR | 2 | 2 | 0.7 | 1.4 | USD | https://www.mouser.com/ProductDetail/Texas-Instruments/TPS3808G30DBVR | Mouser / assembler RFQ | purchase required | engineering allowance; NOT a verified supplier price |  | 2 | 1.4 | 2 | 1.4 | hub:U7; hub:U78 | Unquoted allowance; exact MPN retained; confirm stock, JLC classification and package before purchase. | base_estimate
TPS70933DBVR | Texas Instruments | TPS70933DBVR | 1 | 1 | 0.7 | 0.7 | USD | https://www.mouser.com/ProductDetail/Texas-Instruments/TPS70933DBVR | Mouser / assembler RFQ | purchase required | engineering allowance; NOT a verified supplier price |  | 1 | 0.7 | 1 | 0.7 | hub:U3 | Unquoted allowance; exact MPN retained; confirm stock, JLC classification and package before purchase. | base_estimate
TS3USB30EDGSR | Texas Instruments | TS3USB30EDGSR | 1 | 1 | 0.7 | 0.7 | USD | https://www.mouser.com/ProductDetail/Texas-Instruments/TS3USB30EDGSR | Mouser / assembler RFQ | purchase required | engineering allowance; NOT a verified supplier price |  | 1 | 0.7 | 1 | 0.7 | hub:U72 | Unquoted allowance; exact MPN retained; confirm stock, JLC classification and package before purchase. | base_estimate
TSAL6200 (off-board) | Vishay | TSAL6200 | 1 | 1 | 0.45 | 0.45 | USD | https://www.mouser.com/ProductDetail/Vishay/TSAL6200 | Mouser / assembler RFQ | purchase required | engineering allowance; NOT a verified supplier price |  | 1 | 0.45 | 1 | 0.45 | marble-sensor:D1 | Unquoted allowance; exact MPN retained; confirm stock, JLC classification and package before purchase. | base_estimate
MOTOR | Samtec | TSW-102-07-G-S | 2 | 2 | 0.7 | 1.4 | USD | https://www.mouser.com/ProductDetail/Samtec/TSW-102-07-G-S | Mouser / assembler RFQ | purchase required | engineering allowance; NOT a verified supplier price |  | 2 | 1.4 | 2 | 1.4 | elevator:J2; elevator:J3 | Unquoted allowance; exact MPN retained; confirm stock, JLC classification and package before purchase. | base_estimate
UPDI | Samtec | TSW-103-07-G-S | 1 | 1 | 0.7 | 0.7 | USD | https://www.mouser.com/ProductDetail/Samtec/TSW-103-07-G-S | Mouser / assembler RFQ | purchase required | engineering allowance; NOT a verified supplier price |  | 1 | 0.7 | 1 | 0.7 | elevator:J5 | Unquoted allowance; exact MPN retained; confirm stock, JLC classification and package before purchase. | base_estimate
INDEX_SENSOR | Samtec | TSW-104-07-G-S | 1 | 1 | 0.7 | 0.7 | USD | https://www.mouser.com/ProductDetail/Samtec/TSW-104-07-G-S | Mouser / assembler RFQ | purchase required | engineering allowance; NOT a verified supplier price |  | 1 | 0.7 | 1 | 0.7 | elevator:J4 | Unquoted allowance; exact MPN retained; confirm stock, JLC classification and package before purchase. | base_estimate
SWD | Samtec | TSW-106-07-G-S | 1 | 1 | 0.7 | 0.7 | USD | https://www.mouser.com/ProductDetail/Samtec/TSW-106-07-G-S | Mouser / assembler RFQ | purchase required | engineering allowance; NOT a verified supplier price |  | 1 | 0.7 | 1 | 0.7 | hub:J4 | Unquoted allowance; exact MPN retained; confirm stock, JLC classification and package before purchase. | base_estimate
PD_SERVICE | Samtec | TSW-108-07-G-S | 2 | 2 | 0.7 | 1.4 | USD | https://www.mouser.com/ProductDetail/Samtec/TSW-108-07-G-S | Mouser / assembler RFQ | purchase required | engineering allowance; NOT a verified supplier price |  | 2 | 1.4 | 2 | 1.4 | hub:J2; elevator:J1 | Unquoted allowance; exact MPN retained; confirm stock, JLC classification and package before purchase. | base_estimate
USB4105-GF-A | GCT | USB4105-GF-A | 2 | 2 | 0.9 | 1.8 | USD | https://www.mouser.com/ProductDetail/GCT/USB4105-GF-A | Mouser / assembler RFQ | purchase required | engineering allowance; NOT a verified supplier price |  | 2 | 1.8 | 2 | 1.8 | hub:J1; hub:J3 | Unquoted allowance; exact MPN retained; confirm stock, JLC classification and package before purchase. | base_estimate
USBLC6-2SC6 | STMicroelectronics | USBLC6-2SC6 | 1 | 1 | 0.7 | 0.7 | USD | https://www.mouser.com/ProductDetail/STMicroelectronics/USBLC6-2SC6 | Mouser / assembler RFQ | purchase required | engineering allowance; NOT a verified supplier price |  | 1 | 0.7 | 1 | 0.7 | hub:U73 | Unquoted allowance; exact MPN retained; confirm stock, JLC classification and package before purchase. | base_estimate
W25Q32JVSSIQ | Winbond | W25Q32JVSSIQ | 1 | 1 | 0.8 | 0.8 | USD | https://www.mouser.com/ProductDetail/Winbond/W25Q32JVSSIQ | Mouser / assembler RFQ | purchase required | engineering allowance; NOT a verified supplier price |  | 1 | 0.8 | 1 | 0.8 | hub:U71 | Unquoted allowance; exact MPN retained; confirm stock, JLC classification and package before purchase. | base_estimate
WS2812B-V5 | Worldsemi | WS2812B-V5 | 32 | 32 | 0.18 | 5.76 | USD | https://www.mouser.com/ProductDetail/Worldsemi/WS2812B-V5 | Mouser / assembler RFQ | purchase required | engineering allowance; NOT a verified supplier price |  | 6 | 1.08 | 10 | 1.8 | tile:D1; tile:D3 | Unquoted allowance; exact MPN retained; confirm stock, JLC classification and package before purchase. | base_estimate
10m 1% 1W | Vishay | WSL2512R0100FEA | 7 | 7 | 0.7 | 4.9 | USD | https://www.mouser.com/ProductDetail/Vishay/WSL2512R0100FEA | Mouser / assembler RFQ | purchase required | engineering allowance; NOT a verified supplier price |  | 7 | 4.9 | 7 | 4.9 | hub:R8; hub:R100; hub:R120; hub:R140; hub:R160; hub:R180; hub:R200 | Unquoted allowance; exact MPN retained; confirm stock, JLC classification and package before purchase. | base_estimate
Tile main PCB fabrication, 4 layers 68x68mm |  |  | 16 | 16 | 2 | 32 | USD | https://cart.jlcpcb.com/quote/ | supplier selection pending | purchase required | engineering allowance; NOT a quote |  | 5 | 10 | 5 | 10 |  | 1.6mm; standard stackup; green; geometry and connector release pending. Batch price allowance, not a quote. | base_estimate
Tile assembly including setup/stencil/feeders/X-ray |  |  | 1 | 1 | 170 | 170 | USD | https://jlcpcb.com/help/article/pcb-assembly-price | supplier selection pending | purchase required | engineering allowance; NOT a quote |  | 1 | 155 | 1 | 160 |  | 16 boards. Economic eligibility requires 0.10mm fanout, parts, stencil and assembly approval. Quote before release. | base_estimate
Hub PCB fabrication and assembly |  |  | 1 | 1 | 150 | 150 | USD | https://cart.jlcpcb.com/quote/ | supplier selection pending | purchase required | engineering allowance; NOT a quote |  | 1 | 150 | 1 | 150 |  | 148x68mm plus USB tabs; assembler minimum population quantity and TPS26630 supply unresolved; quote required. | base_estimate
Elevator PCB fabrication and assembly |  |  | 1 | 1 | 65 | 65 | USD | https://cart.jlcpcb.com/quote/ | supplier selection pending | purchase required | engineering allowance; NOT a quote |  | 1 | 65 | 1 | 65 |  | 60x44mm notched 4-layer; minimum fabrication/assembly batch is unquoted; no production release. | base_estimate
Button, sensor and gate PCB fabrication/hand assembly |  |  | 1 | 1 | 20 | 20 | USD | https://cart.jlcpcb.com/quote/ | supplier selection pending | purchase required | engineering allowance; NOT a quote |  | 1 | 20 | 1 | 20 |  | Owned tools and labor; unquoted batch allowance; five-part gate service board is routed. | base_estimate
Edge carrier PCB fabrication and attachment |  |  | 70 | 70 | 0.65 | 45.5 | USD | https://cart.jlcpcb.com/quote/ | supplier selection pending | purchase required | engineering allowance; NOT a quote |  | 18 | 11.7 | 26 | 16.9 |  | 64 tile + 6 Hub faces. Retained budget until qualified direct contacts replace them. Finish and attachment unquoted. | base_estimate
SAMZO edge spring sample/production bodies | SAMZO | 03E315320 | 35 | 35 | 0.6 | 21.0 | USD | https://www.lcsc.com/product-detail/C42402947.html | LCSC | purchase required | engineering allowance; NOT a quote |  | 9 | 5.4 | 13 | 7.8 |  | 32 tile +3 Hub sprung faces; sample candidate only. 2026-11-09 image-page listing shows25 stock, below35 production +5 wear bodies. 30+ USD0.4748 tier cannot currently supply required40; retain USD0.60 allowance pending delivered quotation. No carrier-removal saving assumed. | base_estimate
SAMZO qualification wear samples | SAMZO | 03E315320 | 5 | 5 | .6701 | 3.3505 | USD | https://www.lcsc.com/product-image/C42402947.html?whichImg=0 | LCSC | purchase required | supplier reference listing; not a quote | 2026-11-09 | 5 | 3.3505 | 5 | 3.3505 |  | Five consumed qualification bodies, 25 contacts, separate from35 production bodies. Listing25 stock; 1+ USD0.6701, 10+0.5399, 30+0.4748. Combined40-body kit exceeds shown stock; no unavailable30+ saving counted. Do not fit worn samples to production. | base_estimate
Top module qualification contacts |  | candidate C7471693 | 8 | 8 | 0.3 | 2.4 | USD | https://www.lcsc.com/product-detail/C7471693.html | LCSC | purchase required | engineering allowance; NOT a quote |  | 8 | 2.4 | 8 | 2.4 |  | One eight-contact interface for destructive/misalignment qualification, separate from final module contacts. Candidate only; obtain drawing before purchase. | base_estimate
Top module spring contacts |  | candidate C7471693 | 32 | 32 | 0.3 | 9.6 | USD | https://www.lcsc.com/product-detail/C7471693.html | LCSC | purchase required | engineering allowance; NOT a quote |  | 32 | 9.6 | 32 | 9.6 |  | Four electronic modules x8; provisional candidate, not selected. Passive tracks need no contacts. | base_estimate
6x3mm axial magnets including module and Hub retention | Magnesy Hunter | MAGN_17#4_W/6x3 | 268 | 268 | 0.1262120988 | 33.8248 | USD | https://magnesyhunter.pl/pl/p/Magnes-neodymowy-6x3-mm-N45-walcowy/175 | Magnesy Hunter (Poland) | purchase required | quantity-tier supplier listing; FX estimate including listed domestic shipping; NOT a quote | 2026-11-09 | 70 | 11.0947 | 100 | 14.5386 |  | 268 modeled requirement: 192 bases +12 Hub +64 module. Piece sales; no ten-piece MOQ. N45, axial, NiCuNi, nominal 6x3mm; tolerance, holding force, adhesive and printed fit require samples. PLN 0.45 gross at 10+; 268 cost PLN 120.60 +11.99 domestic delivery =132.59 gross. Page also shows conflicting headline prices; conservative published 10+ table used, basket confirmation pending. USD conversion at NBP table 218/A/2026, 2026-11-09: 1 USD=3.9199 PLN. Unit price includes allocated delivery. No order placed. | base_estimate
Magnet-retention adhesive (small epoxy pack) | Bison | Epoxy 5 Minutes 24ml | 1 | 1 | 6 | 6 | USD | https://www.bison.net/en-en/products/bison-epoxy-5-minutes-blister-24-ml-multi-lan-1 | supplier selection pending | purchase required | engineering allowance; NOT a quote |  | 1 | 6 | 1 | 6 |  | 24ml maximum pack allowance. Candidate only; PETG/Ni-Cu-Ni adhesion and retention need sample tests. Select a local retailer quote; do not assume this bond is qualified. | base_estimate
PETG from existing stock (kg) |  |  | 3 | 3 | 0 | 0 | USD | https://www.prusa3d.com/product/prusament-petg-jet-black-1kg/ | supplier selection pending | owned | owned; no purchase requested |  | 1 | 0 | 1 | 0 |  | Owned stock, brand unspecified; link is a material reference. Confirm sliced mass and available stock; no grant charge. | owned
Elevator gearmotor | Pololu | 3044 | 1 | 1 | 26.45 | 26.45 | USD | https://www.pololu.com/product/3044 | Pololu | purchase required | manufacturer reference listing checked 2026-11-08; not a quote |  | 1 | 26.45 | 1 | 26.45 |  | Retain selected 12V 250:1 HPCB motor. Manufacturer price last checked 2026-11-06; recheck. Cheaper N20 not qualified. | base_estimate
Gate servo | FEETECH | FS90 | 1 | 1 | 8.4 | 8.4 | USD | https://www.pololu.com/product/2818 | Pololu | purchase required | engineering allowance; NOT a quote |  | 1 | 8.4 | 1 | 8.4 |  | FS90 selected for the gate service prototype; 3.3V-compatible control. Clamp, horn and stall/load qualification required. | base_estimate
Elevator index sensor | Vishay | TCST2103 | 1 | 1 | 2 | 2 | USD | https://www.mouser.com/ProductDetail/Vishay-Semiconductors/TCST2103 | supplier selection pending | purchase required | engineering allowance; NOT a quote |  | 1 | 2 | 1 | 2 |  | Off-board; PCB J4 cable required. | base_estimate
Normally closed stop switch | Omron | D2F-01L | 1 | 1 | 2 | 2 | USD | https://www.mouser.com/ProductDetail/Omron-Electronics/D2F-01L | supplier selection pending | purchase required | engineering allowance; NOT a quote |  | 1 | 2 | 1 | 2 |  | Use NC and COM; wire opening must stop motor; lever/interface fit pending. | base_estimate
Elevator idler bearing | SKF | 623-2Z | 1 | 1 | 2 | 2 | USD | https://www.skf.com/group/products/rolling-bearings/ball-bearings/deep-groove-ball-bearings/productid-623-2Z | supplier selection pending | purchase required | engineering allowance; NOT a quote |  | 1 | 2 | 1 | 2 |  | 3x10x4mm; retention/shaft fit test required. | base_estimate
M2x16 chain hinge screws and M2 nuts (pairs) |  |  | 30 | 30 | 0.1 | 3.0 | USD | https://www.accu.co.uk/metric-cap-head-screws/426961-SSC-M2-16-A2 | supplier selection pending | purchase required | engineering allowance; NOT a quote |  | 30 | 3.0 | 30 | 3.0 |  | 30 links; nut <=1.6mm high; washers under heads only. | base_estimate
PCB/frame screws, nuts, washers and axle hardware (lot) |  |  | 1 | 1 | 12 | 12 | USD | https://www.accu.co.uk/metric-cap-head-screws | supplier selection pending | purchase required | engineering allowance; NOT a quote |  | 1 | 12 | 1 | 12 |  | PCB mounts: 64 M2x8 (tile) and 6 M2x30 with two thin washers each (Hub), 4 M2x10 (elevator), 4 M2x6 (gate) and 8 input-board mounts with unfinished cases. M2 nuts <=1.6mm. Gate clamp 2 M2x30; gate axle M3x12; idler axle M3x40; lift frame/idler hardware remain fit-review items. M4/M6 support fixings are separate rows. | base_estimate
M6 rod material (one-metre lengths) |  |  | 5 | 5 | 2 | 10 | USD | https://www.accu.co.uk/metric-threaded-rods | supplier selection pending | purchase required | engineering allowance; NOT a quote |  | 0 | 0 | 0 | 0 |  | Eighteen cut support rods; public rod-cut-list.csv fits five 1m bars with 2mm kerf and 4mm end trim per bar. Assumes 12mm baseboard; measure before cutting. | base_estimate
M6 nuts and washers (pairs) |  |  | 96 | 96 | 0.08 | 7.68 | USD | https://www.accu.co.uk/metric-hexagon-nuts | supplier selection pending | purchase required | engineering allowance; NOT a quote |  | 0 | 0 | 0 | 0 |  | 30 modeled rod/track seats use two nuts/washers each; 18 rod anchors use two more each: 96 pairs total. Confirm washer/nut stack before cutting. | base_estimate
M4x25 support-foot bolt/nut/washer sets |  |  | 36 | 36 | 0.15 | 5.4 | USD | https://www.accu.co.uk/metric-cap-head-screws | supplier selection pending | purchase required | engineering allowance; NOT a quote |  | 0 | 0.0 | 0 | 0.0 |  | Four fixings per foot for nine feet; 6mm foot + 12mm plywood + washer/nut. Unquoted set allowance. | base_estimate
Baseboard 700x700x12mm |  |  | 1 | 1 | 12 | 12 | USD | https://www.castorama.pl/produkty/budowa/drewno-i-plyty-drewnopochodne/plyty-drewnopochodne/sklejki.html | supplier selection pending | purchase required | engineering allowance; NOT a quote |  | 0 | 0 | 0 | 0 |  | 12mm nominal plywood allowance; local cut-to-size quote and actual thickness needed; include support-foot fasteners. | base_estimate
16mm glass marbles |  |  | 10 | 10 | 0.2 | 2.0 | USD | https://www.opitec.com/ | supplier selection pending | purchase required | engineering allowance; NOT a quote |  | 10 | 2.0 | 10 | 2.0 |  | Minimum circulation/test set; exact product link and diameter tolerance pending. | base_estimate
20V USB-C PD supply, 100W class |  |  | 1 | 1 | 30 | 30 | USD | https://www.meanwell.co.uk/power-supplies/external-power-supplies/nge100-series | supplier selection pending | purchase required | engineering allowance; NOT a quote |  | 1 | 30 | 1 | 30 |  | NGE100 candidate: manufacturer specifies 20V/5A on USB-C with other ports unused. Regional plug, stock and delivered quote pending. Hub cutoff around 4.2A, not guaranteed 100W delivery. | base_estimate
5A electronically marked USB-C power cable | StarTech | USB2C5C1M | 1 | 1 | 8 | 8 | USD | https://www.startech.com/en-us/cables/usb2c5c1m | supplier selection pending | purchase required | engineering allowance; NOT a quote |  | 1 | 8 | 1 | 8 |  | 1m USB2C5C1M candidate; 20V/5A capability and current supply listing to confirm. | base_estimate
Separate USB data cable | StarTech | USB2AC1M | 1 | 1 | 4 | 4 | USD | https://www.startech.com/en-us/cables/usb2ac1m | supplier selection pending | purchase required | engineering allowance; NOT a quote |  | 1 | 4 | 1 | 4 |  | USB-A to C or host-compatible data cable; exact host connection pending. | base_estimate
Module harnesses, motor leads and mating headers (lot) |  |  | 1 | 1 | 10 | 10 | USD | https://www.harwin.com/products/M20-1060800 | supplier selection pending | purchase required | engineering allowance; NOT a quote |  | 1 | 10 | 1 | 10 |  | Service-header prototypes; final top contact assembly remains unreleased. Crimp contacts and wire included as an allowance. | base_estimate
Contact qualification coupons and fixture fabrication (lot) |  |  | 1 | 1 | 18 | 18 | USD | https://cart.jlcpcb.com/quote/ | supplier selection pending | purchase required | engineering allowance; NOT a quote |  | 1 | 18 | 1 | 18 |  | Existing SAMZO plus direct side-contact coupons; use owned PETG. No main-board order until contact/protection release. | base_estimate
Harwin side-contact samples | Harwin | S1961-46R | 5 | 5 | 0.75 | 3.75 | USD | https://www.harwin.com/products/S1961-46R | supplier selection pending | purchase required | engineering allowance; NOT a quote |  | 5 | 3.75 | 5 | 3.75 |  | Five-channel test coupon only; no speculative production stock. Distributor quote required. | base_estimate
Shipping, import charges and VAT allowance |  |  | 1 | 1 | 140 | 140 | USD | https://www.lcsc.com/shipping | supplier selection pending | purchase required | engineering allowance; NOT a quote |  | 1 | 80 | 1 | 85 |  | Unquoted Poland electronics/import/VAT reserve; magnet domestic freight and VAT now included in magnet line. Other baskets/tax/assembly quotes still pending; not a tax determination. | base_estimate
Uncertainty allowance (25 percent) |  |  | 1 | 0 | 343.22 | 343.22 | USD | https://github.com/Bruhdows/klink/blob/main/docs/specifications/BOM.md | not a purchase item | budget allowance | uncertainty allowance; NOT a supplier quote |  | 1 | 224.32 | 1 | 240.47 |  | Budget contingency, not a purchasable item. Replace allowances with delivered supplier quotes and request only the confirmed required amount. | uncertainty
