Bruhdows/klink/hardware/manufacturing/button/assembly-bom.csv

Comment | Designator | Footprint | LCSC Part # | MPN | Assembly status
1k 1% | R1 | Resistor_SMD:R_0805_2012Metric |  | RC0805FR-071KL | quote and rotation review required
1k 1% | R2 | Resistor_SMD:R_0805_2012Metric |  | RC0805FR-071KL | quote and rotation review required
