Bruhdows/klink/hardware/cad/step/manifest.csv

step_file | design_source | source_sha256 | step_sha256 | export_type | solid_count | volume_mm3 | extent_x_mm | extent_y_mm | extent_z_mm
base.step | hardware/cad/base/base_tile.scad | 2e37439acec7ab25fe511692aa8559a325c66442196c7dea1cadb71aaae2ac55 | ccef84b18530e76869c1f2c25618286cb1ba72fda005896e21d756a21896af05 | faceted print-mesh BRep | 1 | 45449.417 | 80.0 | 80.0 | 20.0
baseboard.step | hardware/cad/tracks/continuous_return.scad | 695afc458c34bb881ba1da2c6967240722880962c42af5388692db79ae59e686 | b8c88fc5c4b1bfe9d35e162d492419754e8ba2d4314911e85b62ebeb5e6d9041 | CSG-derived BRep | 1 | 5865961.793 | 700.0 | 700.0 | 12.0
elevator-carrier.step | hardware/cad/elevator/elevator.scad | aabd5648ff9c57e232d1a73a492ea436f617041655be35951e40a48b6071ca42 | 738ac734ecd4c2152dacee318f9470cc396785df917684262116f1ec5be03a01 | CSG-derived BRep | 1 | 1565.622 | 31.2 | 30.4 | 16.8
elevator-drive.step | hardware/cad/elevator/elevator.scad | aabd5648ff9c57e232d1a73a492ea436f617041655be35951e40a48b6071ca42 | 0cd7622515c9d1cca2be77eb971e43590ea3a5306a3163a1f8e23662390c16bb | CSG-derived BRep | 1 | 11063.313 | 50.917 | 51.0 | 20.2
elevator-exit.step | hardware/cad/elevator/elevator.scad | aabd5648ff9c57e232d1a73a492ea436f617041655be35951e40a48b6071ca42 | 58b8fb4608eff60a52236fee1f0d829080a3d2ab5794494cb6be0b9ea7821061 | CSG-derived BRep | 1 | 4109.548 | 84.0 | 48.0 | 30.285
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
side-contact-bed.step | hardware/cad/base/side_contact_fixture.scad | abdb8330873e66137693fbdea601d5a09937c62445a49138565375ce4bae8ea4 | c38c472b514a390f4a2a07aac99148433031b111502bf0eb7f7bb7ced74dfc30 | CSG-derived BRep | 1 | 10638.123 | 56.0 | 52.0 | 10.0
side-contact-slider.step | hardware/cad/base/side_contact_fixture.scad | abdb8330873e66137693fbdea601d5a09937c62445a49138565375ce4bae8ea4 | 0ba83b906729f917ed0091f8d1fc249934280a166e0684db28d30c5a1408ff00 | CSG-derived BRep | 1 | 2938.821 | 46.0 | 10.0 | 15.0
straight-track.step | hardware/cad/tracks/straight_track.scad | 612be4a61fda30e6233dd967aa1002a9633def60d7a4862669992e52cc60de59 | ce6aeabc4b46038ec1f294c02134bf6db4b033ee97e5ef518e914c1de6d1e992 | CSG-derived BRep | 1 | 44241.992 | 80.0 | 80.0 | 16.5
