Bruhdows/klink/hardware/cad/assembly.FCStd

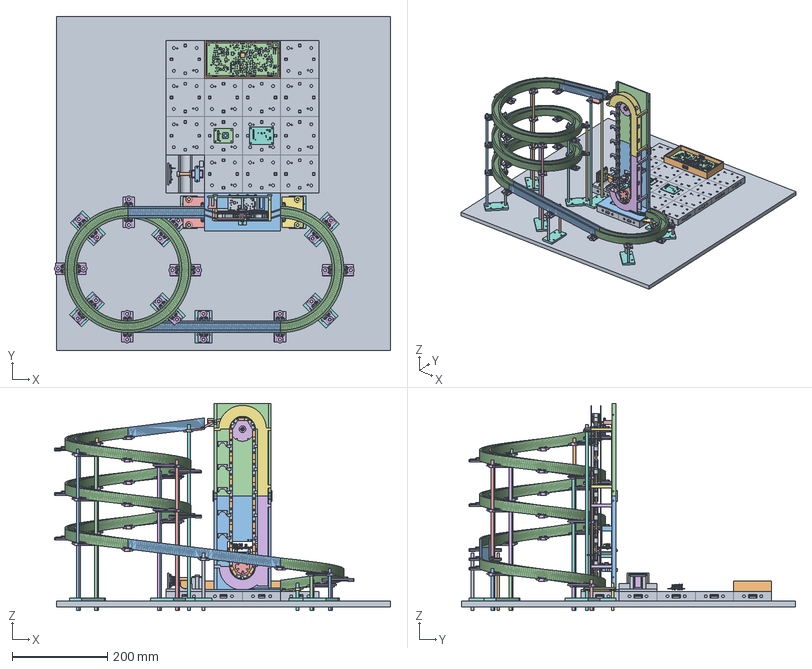
[picture p6: CAD file, 2026-11-09]
hardware/cad/assembly.FCStd
703.9 x 700.0 x 434.0 mm
BaseSource x 16
HubCase
LiftLowerFrame
LiftUpperFrame
LiftExit
LiftGuidesLower
LiftGuidesUpper
LiftSensorBracket
MotorStrap
AntiRollbackPawl
LiftSplice
LiftSplice001
DriveWheel
IdlerWheel
IdlerFrontSpacer
IdlerRearSpacer
CarrierSource x 15
PlainLinkSource x 15
ReturnStraightSource x 3
ReturnCurveSource x 24
ReturnEntrySource
ReturnSaddleSource x 26
ReturnEndSource
FootSource x 9
R_0805_2012Metric x 16
R_0805_2012Metric002 x 16
R_0805_2012Metric004 x 16
R_0805_2012Metric006 x 16
C_0805_2012Metric x 16
C_0805_2012Metric002 x 16
C_0805_2012Metric004 x 16
R_0805_2012Metric008 x 16
R_0805_2012Metric010 x 16
R_0805_2012Metric012 x 16
R_0805_2012Metric014 x 16
R_1206_3216Metric x 16
R_0805_2012Metric016 x 16
D_SMB x 16
R_0805_2012Metric018 x 16
C_0805_2012Metric006 x 16
R_0805_2012Metric020 x 16
R_0805_2012Metric022 x 16
C_0805_2012Metric008 x 16
Fuse_1206_3216Metric x 16
C_0805_2012Metric010 x 16
R_0805_2012Metric024 x 16
R_0805_2012Metric026 x 16
Fuse_1206_3216Metric002 x 16
R_0805_2012Metric028 x 16
TSSOP-14_4.4x5mm_P0.65mm x 16
R_0805_2012Metric030 x 16
R_0805_2012Metric032 x 16
C_1206_3216Metric x 16
R_0805_2012Metric034 x 16
C_0805_2012Metric012 x 16
R_0805_2012Metric036 x 16
R_0805_2012Metric038 x 16
R_0805_2012Metric040 x 16
C_0805_2012Metric014 x 16
R_1206_3216Metric002 x 16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
