Bruhdows/klink/hardware/cad/base/base_tile.stl

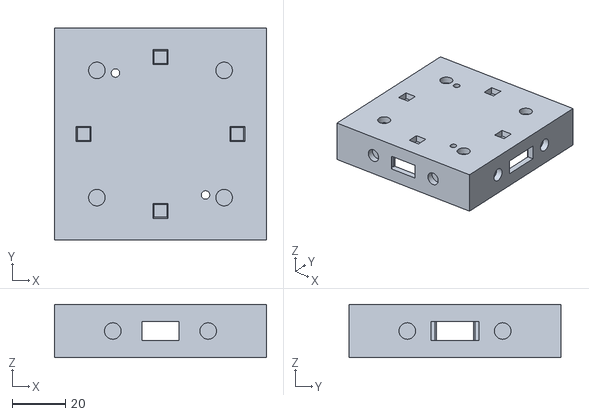
[picture p7: CAD file, 2026-11-09]
hardware/cad/base/base_tile.stl
80.0 x 80.0 x 20.0
