Bruhdows/klink/hardware/cad/base/print/side-contact-slider.stl

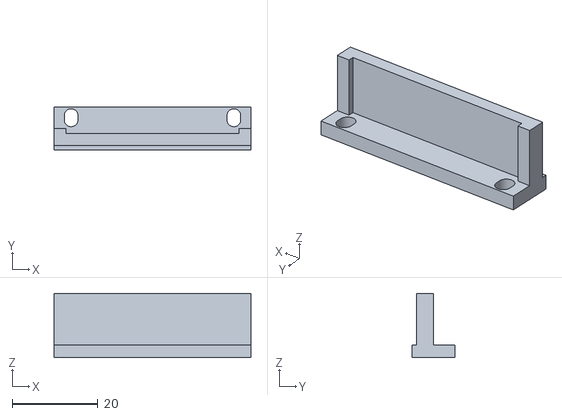
[picture p8: CAD file, 2026-11-09]
hardware/cad/base/print/side-contact-slider.stl
46.0 x 10.0 x 15.0
