Bruhdows/klink/hardware/cad/common/magnet_test.stl

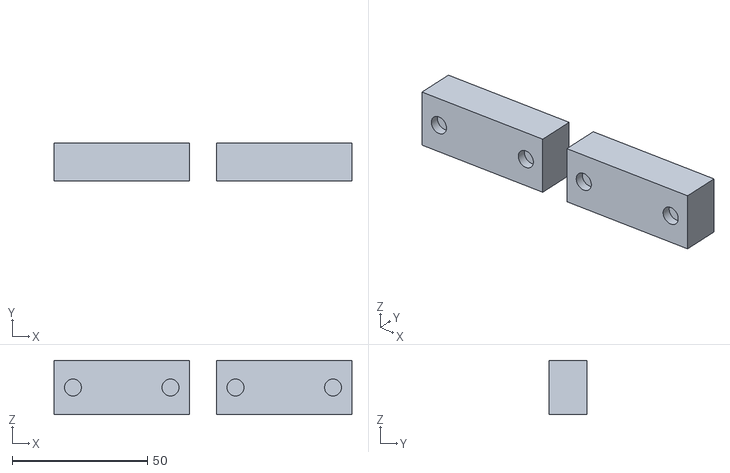
[picture p9: CAD file, 2026-11-01]
hardware/cad/common/magnet_test.stl
110.0 x 14.0 x 20.0
