Bruhdows/klink/hardware/cad/elevator/print/elevator-spacer_rear.stl

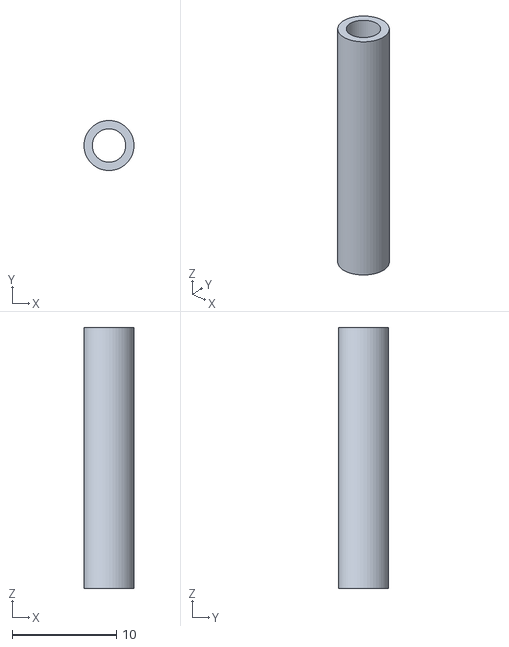
[picture p10: CAD file, 2026-11-09]
hardware/cad/elevator/print/elevator-spacer_rear.stl
4.80 x 4.80 x 25.0
