Bruhdows/klink/hardware/cad/hub/hub_envelope.stl

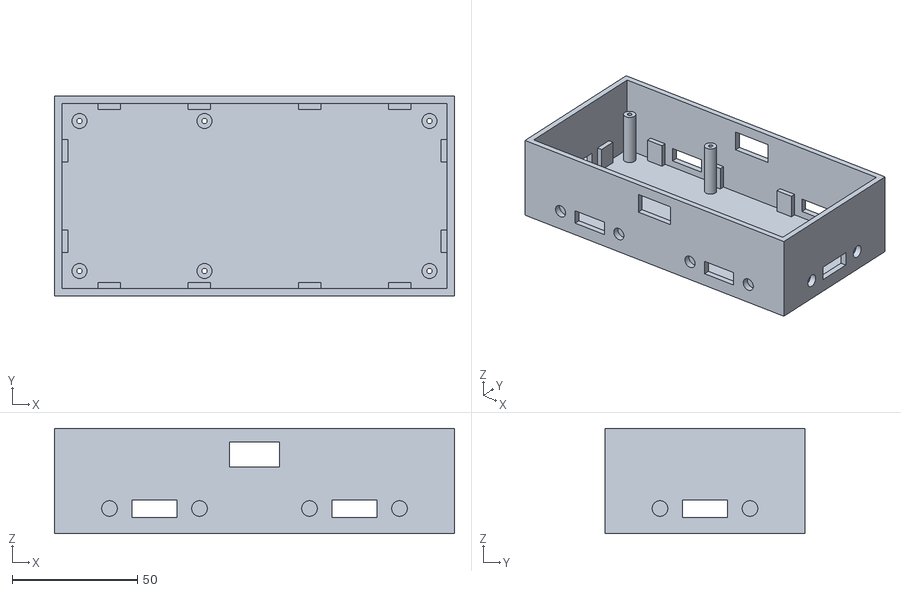
[picture p11: CAD file, 2026-11-09]
hardware/cad/hub/hub_envelope.stl
160.0 x 80.0 x 42.0
