Bruhdows/klink/hardware/cad/modules/print/key-tile.stl

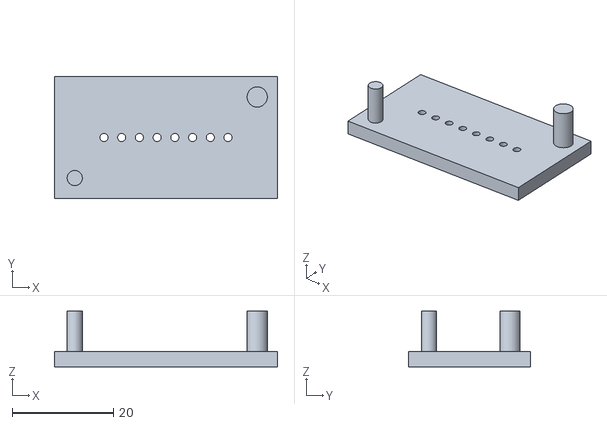
[picture p12: CAD file, 2026-11-09]
hardware/cad/modules/print/key-tile.stl
44.0 x 24.0 x 11.0
