Bruhdows/klink/hardware/cad/pcb/elevator.step

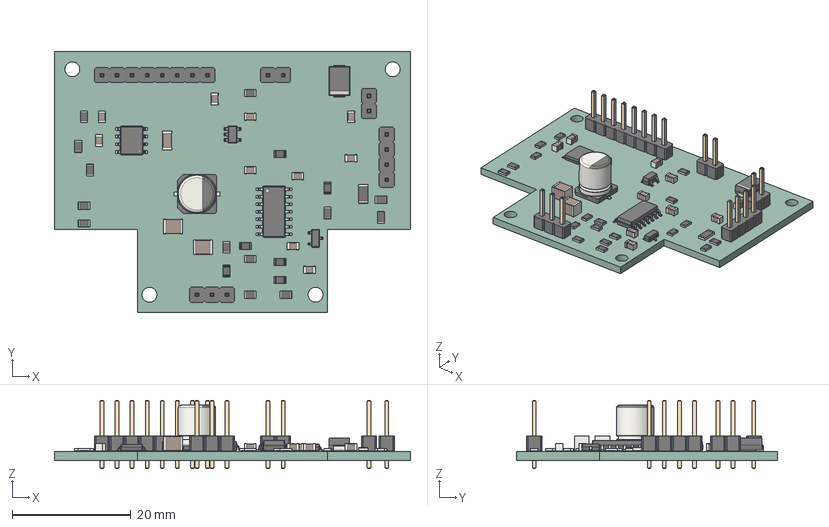
[picture p13: CAD file, 2026-11-09]
hardware/cad/pcb/elevator.step
60.0 x 44.0 x 11.5 mm
C_0805_2012Metric x 10
PinHeader_1x03_P254mm_Vertical
PinHeader_1x04_P254mm_Vertical
R_0805_2012Metric x 19
TI_SO-PowerPAD-8
C_1210_3225Metric x 2
PinHeader_1x02_P254mm_Vertical x 2
D_SMB
C_1206_3216Metric
R_1206_3216Metric
PinHeader_1x08_P254mm_Vertical
SOIC-14_3.9x8.7mm_P1.27mm
CP_Elec_63x77
SOT-23
SOT-23-5
elevator_PCB
