Bruhdows/klink/hardware/cad/step/samzo-neighbor.step

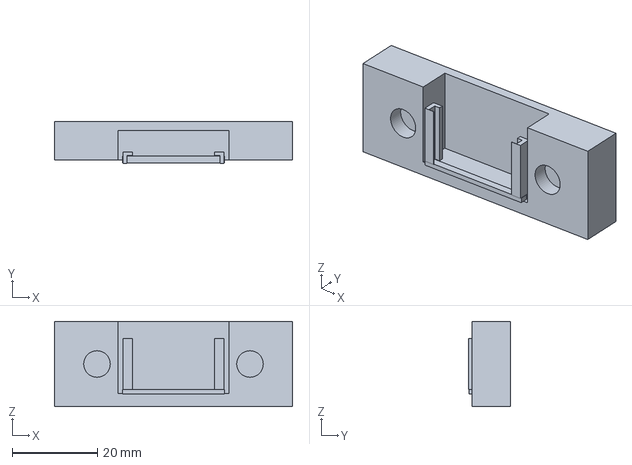
[picture p14: CAD file, 2026-11-09]
hardware/cad/step/samzo-neighbor.step
56.0 x 9.88 x 20.0 mm
