Bruhdows/klink/hardware/cad/tracks/print/return-entry-support.stl

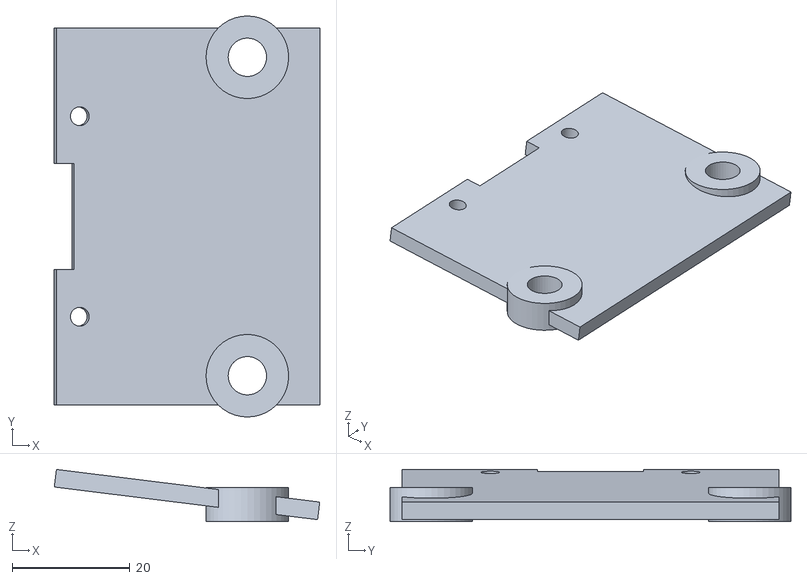
[picture p15: CAD file, 2026-11-09]
hardware/cad/tracks/print/return-entry-support.stl
45.0 x 68.0 x 8.84
