Bruhdows/klink/hardware/cad/tracks/straight_track.stl

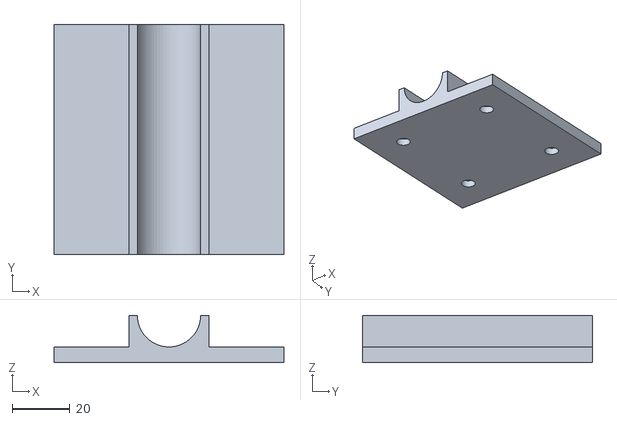
[picture p16: CAD file, 2026-11-09]
hardware/cad/tracks/straight_track.stl
80.0 x 80.0 x 16.5
