Bruhdows/klink/hardware/cad/base/base_tile_fit_test.stl

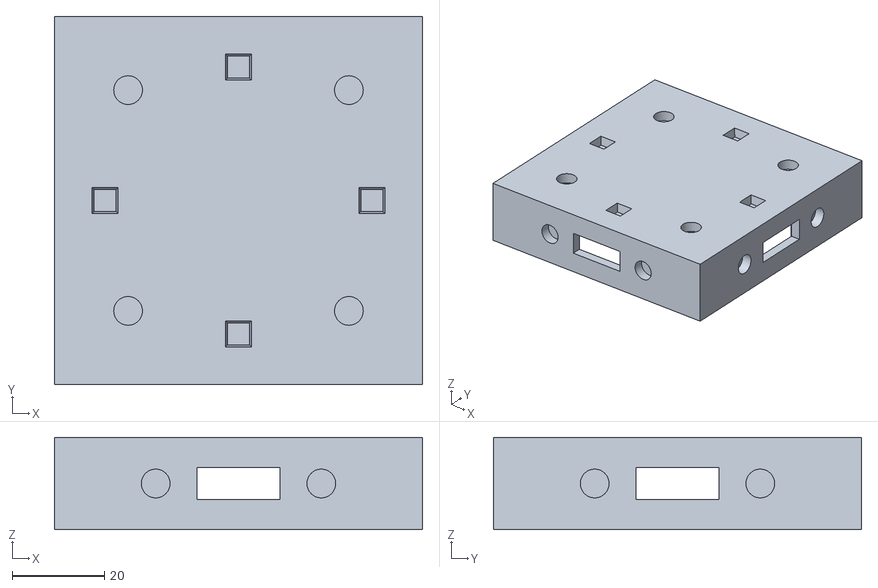
[picture p17: CAD file, 2026-11-04]
hardware/cad/base/base_tile_fit_test.stl
80.0 x 80.0 x 20.0
