Bruhdows/klink/hardware/cad/elevator/print/elevator-upper_frame.stl

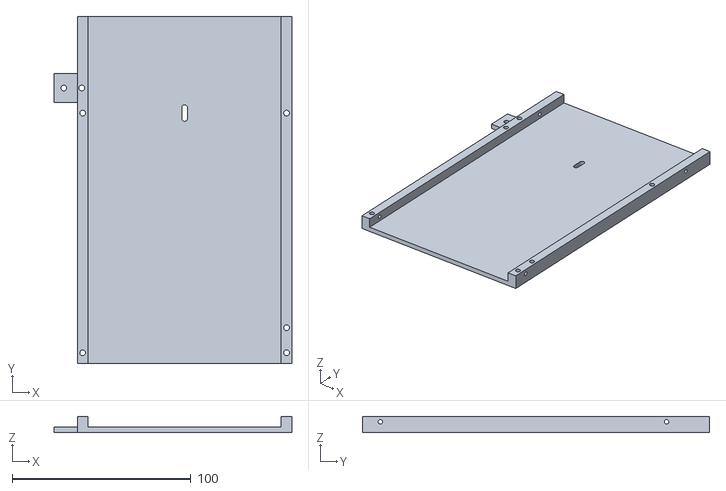
[picture p18: CAD file, 2026-11-09]
hardware/cad/elevator/print/elevator-upper_frame.stl
133.0 x 194.0 x 9.00
