Bruhdows/klink/hardware/cad/modules/print/gate-clamp.stl

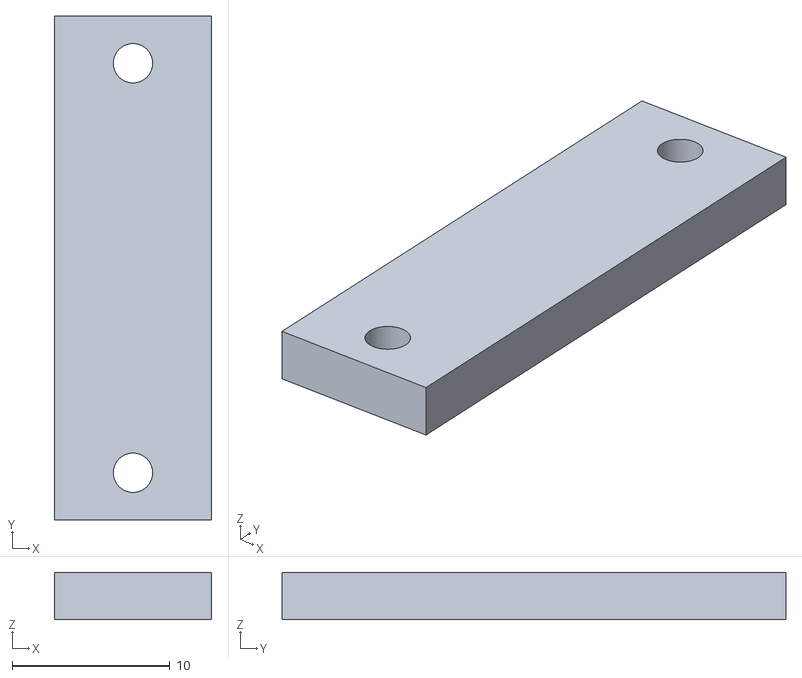
[picture p19: CAD file, 2026-11-09]
hardware/cad/modules/print/gate-clamp.stl
10.0 x 32.0 x 3.00
