Bruhdows/klink/hardware/cad/pcb/hub.step

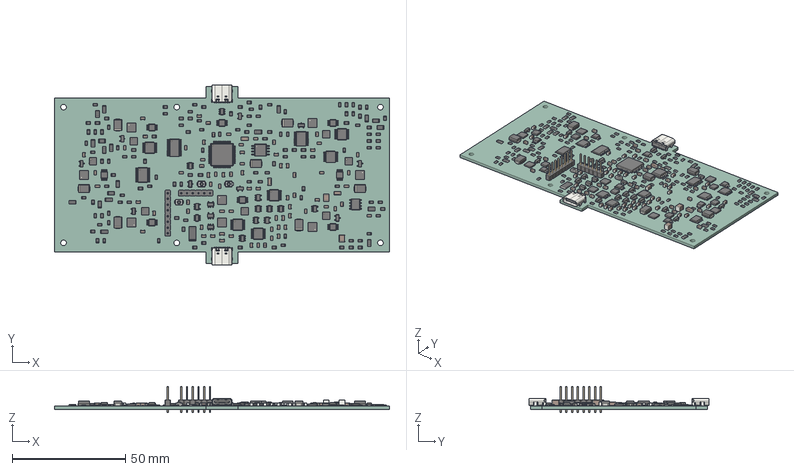
[picture p20: CAD file, 2026-11-09]
hardware/cad/pcb/hub.step
148.0 x 79.3 x 11.5 mm
C_0805_2012Metric x 73
R_0805_2012Metric x 122
TSSOP-14_4.4x5mm_P0.65mm x 6
VSON_8_33x33mm_Pitch065mm_NexFET x 7
C_1210_3225Metric x 2
SOT-23 x 9
C_1206_3216Metric x 3
Texas_RGE0024H_VQFN-24-1EP_4x4mm_P0.5mm_EP2.7x2.7mm x 7
SW_SPST_B3U-1000P x 3
SOT-23-6 x 8
VSSOP-8_3x3mm_P0.65mm x 7
USB_C_Receptacle_16P_TopMnt_Horizontal_GCT_USB4105-xx-A x 2
D_SMB x 7
R_1206_3216Metric x 19
TSSOP-10_3x3mm_P0.5mm
SOT-23-5 x 7
TSSOP-20_4.4x6.5mm_P0.65mm x 2
TSSOP-24_4.4x7.8mm_P0.65mm
R_2512_6332Metric
TI_SO-PowerPAD-8
PinHeader_1x06_P254mm_Vertical
SOIC-8_5.3x5.3mm_P1.27mm
QFN-24-1EP_4x4mm_P0.5mm_EP2.7x2.7mm
LQFP-64_10x10mm_P0.5mm
PinHeader_1x08_P254mm_Vertical
hub_PCB
