Bruhdows/klink/hardware/cad/step/elevator-pawl.step

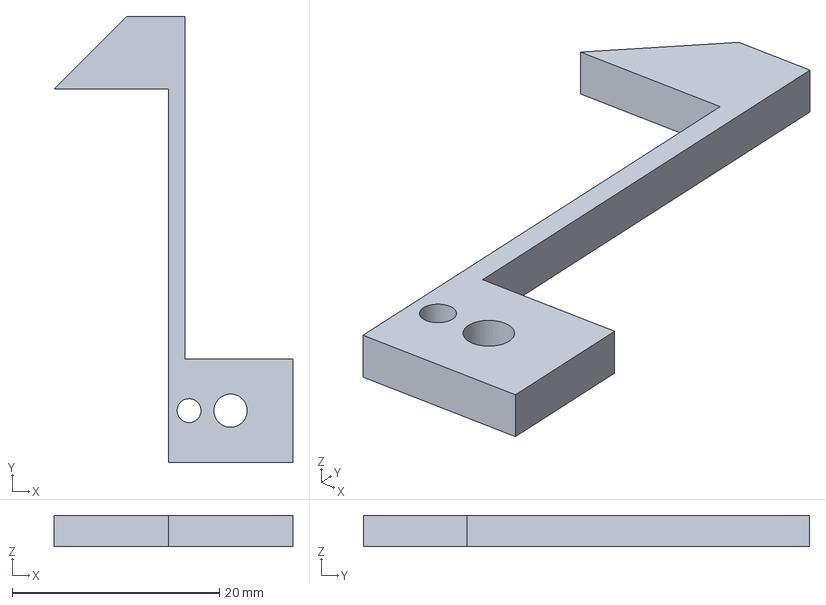
[picture p21: CAD file, 2026-11-09]
hardware/cad/step/elevator-pawl.step
23.0 x 43.0 x 3.00 mm
