Bruhdows/klink/hardware/cad/tracks/print/return-straight160.stl

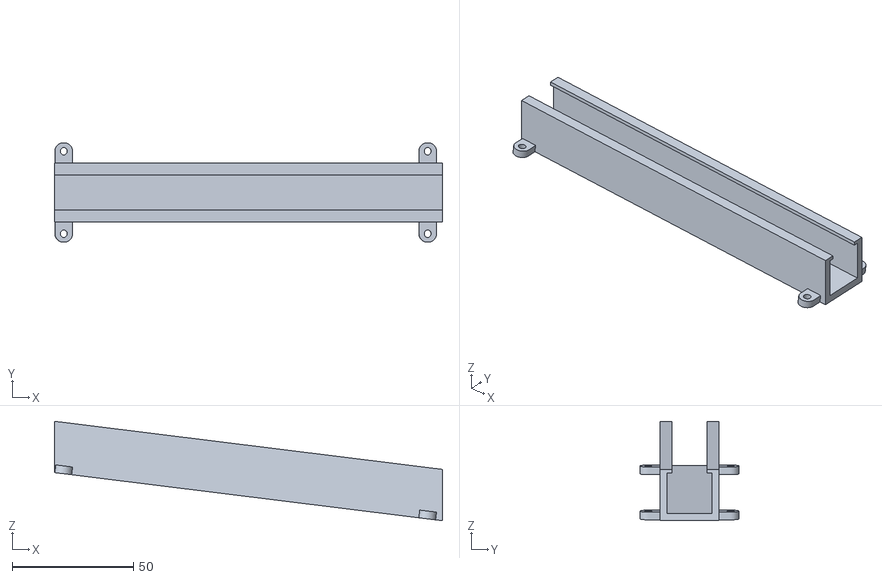
[picture p22: CAD file, 2026-11-09]
hardware/cad/tracks/print/return-straight160.stl
160.0 x 41.0 x 41.0
