Bruhdows/klink/hardware/cad/base/edge_fit_test.FCStd

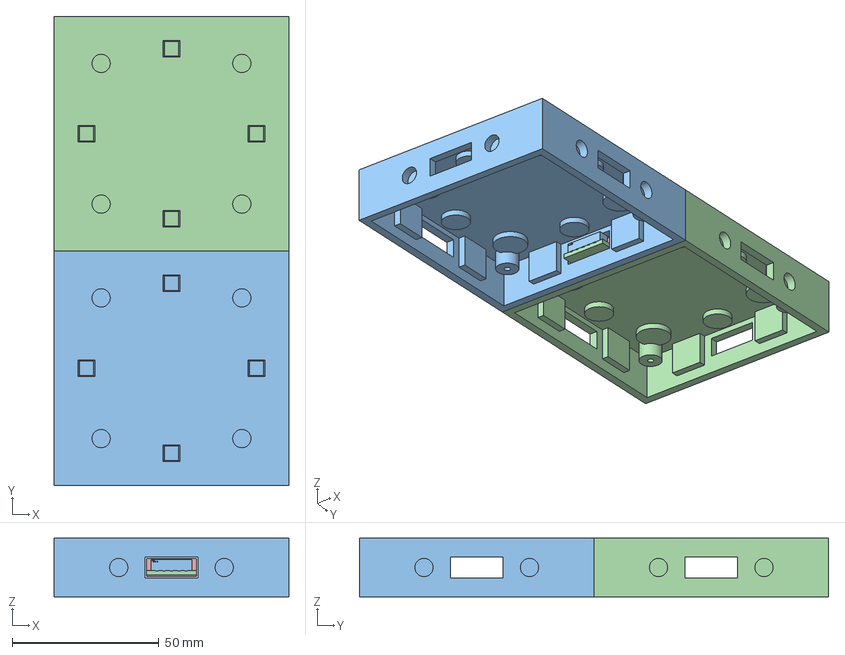
[picture p23: CAD file, 2026-11-04]
hardware/cad/base/edge_fit_test.FCStd
80.0 x 160.0 x 20.0 mm
BAT-SMD_009155004541006
BAT-SMD_009155004541007
BAT-SMD_009155004541008
BAT-SMD_009155004541009
BAT-SMD_009155004541010
BAT-SMD_009155004541011
BAT-SMD_009155004541012
BAT-SMD_009155004541013
BAT-SMD_009155004541014
BAT-SMD_009155004541015
BAT-SMD_009155004541016
BAT-SMD_009155004541017
BAT-SMD_009155004541018
BAT-SMD_009155004541019
BAT-SMD_009155004541020
BAT-SMD_009155004541021
BAT-SMD_009155004541022
BAT-SMD_009155004541023
BAT-SMD_009155004541024
NorthPCBTab
LandingPCBPreview
LandingPad1
LandingPad2
LandingPad3
LandingPad4
LandingPad5
base_tile_fit_test
NorthNeighbor
