Bruhdows/klink/hardware/cad/base/print/samzo-center.stl

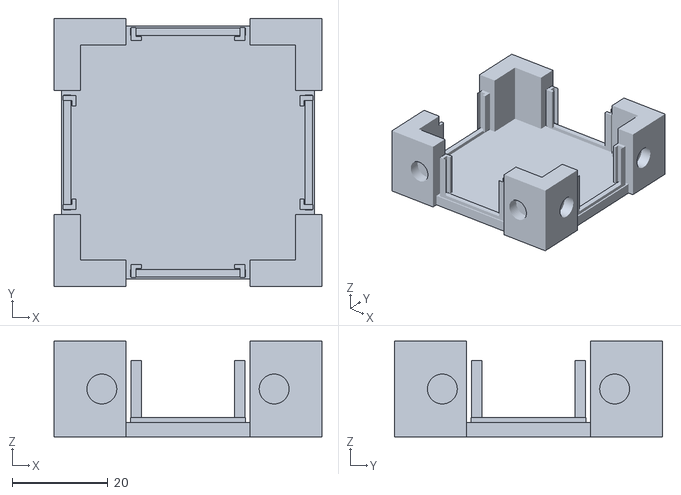
[picture p24: CAD file, 2026-11-09]
hardware/cad/base/print/samzo-center.stl
56.0 x 56.0 x 20.0
