Bruhdows/klink/hardware/cad/elevator/print/elevator-idler.stl

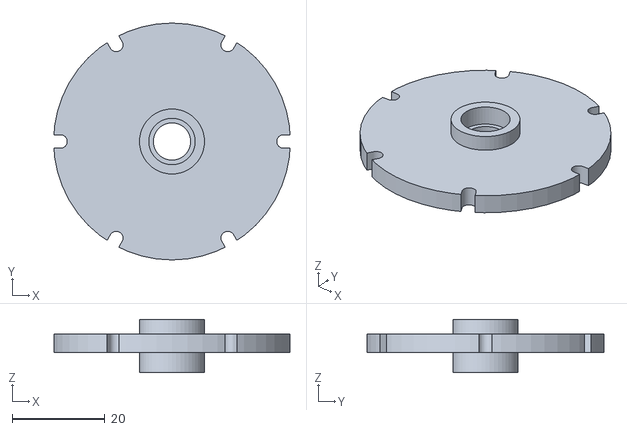
[picture p25: CAD file, 2026-11-09]
hardware/cad/elevator/print/elevator-idler.stl
50.8 x 51.0 x 11.5
