Bruhdows/klink/hardware/cad/modules/print/gate-flap.stl

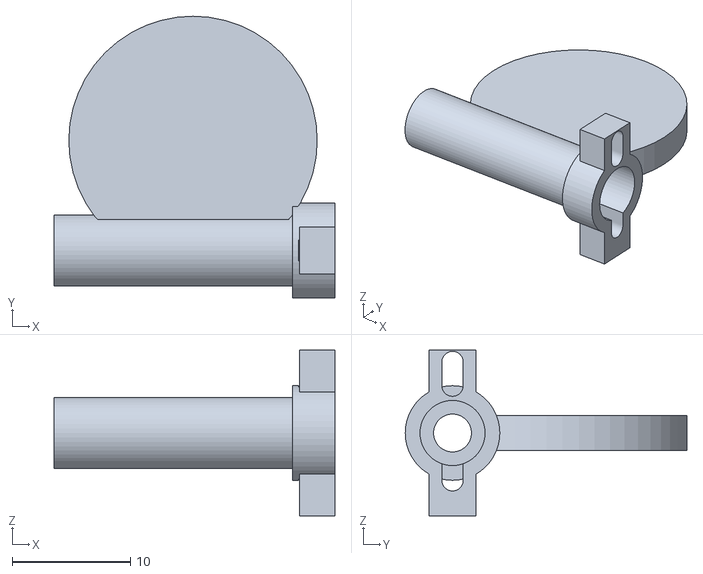
[picture p26: CAD file, 2026-11-09]
hardware/cad/modules/print/gate-flap.stl
23.8 x 23.8 x 14.0
