Bruhdows/klink/hardware/cad/pcb/button.step

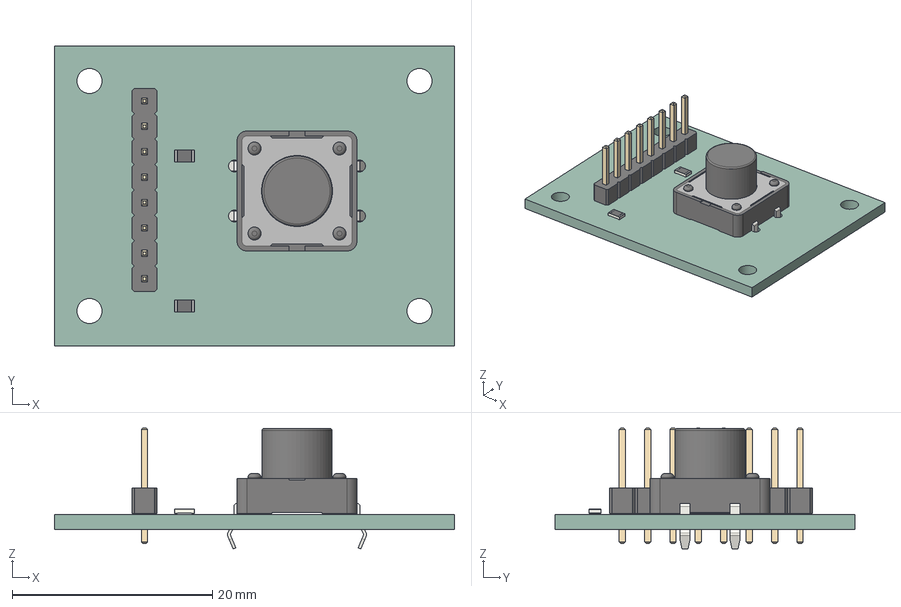
[picture p27: CAD file, 2026-11-09]
hardware/cad/pcb/button.step
40.0 x 30.0 x 12.1 mm
R_0805_2012Metric x 2
PinHeader_1x08_P254mm_Vertical
SW_PUSH-12mm_Wuerth-430476085716
button_PCB
