Bruhdows/klink/hardware/cad/step/gate-base.step

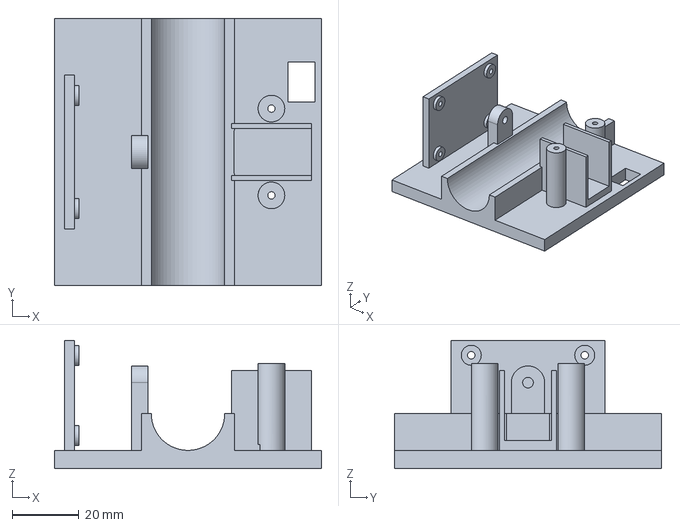
[picture p28: CAD file, 2026-11-09]
hardware/cad/step/gate-base.step
80.0 x 80.0 x 38.5 mm
