Bruhdows/klink/hardware/cad/tracks/print/return-foot.stl

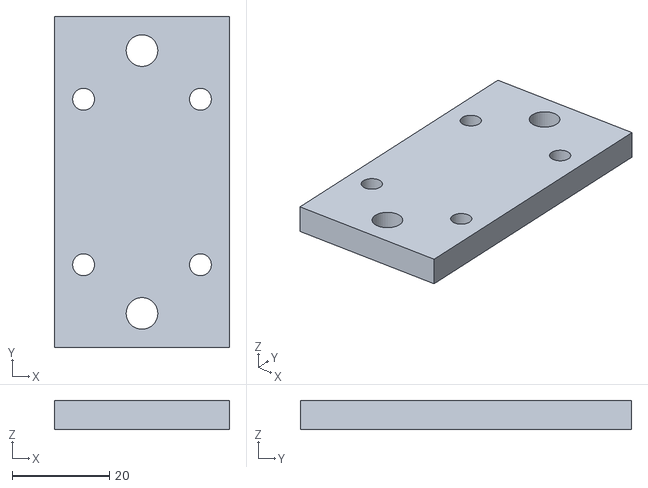
[picture p29: CAD file, 2026-11-09]
hardware/cad/tracks/print/return-foot.stl
36.0 x 68.0 x 6.00
