Bruhdows/klink/hardware/cad/base/magnet_test.stl

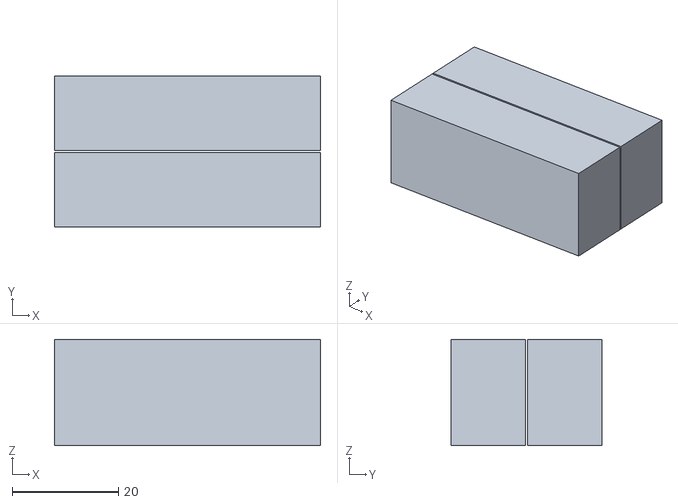
[picture p30: CAD file, 2026-10-31]
hardware/cad/base/magnet_test.stl
50.0 x 28.4 x 20.0
