Bruhdows/klink/hardware/cad/base/print/side-contact-bed.stl

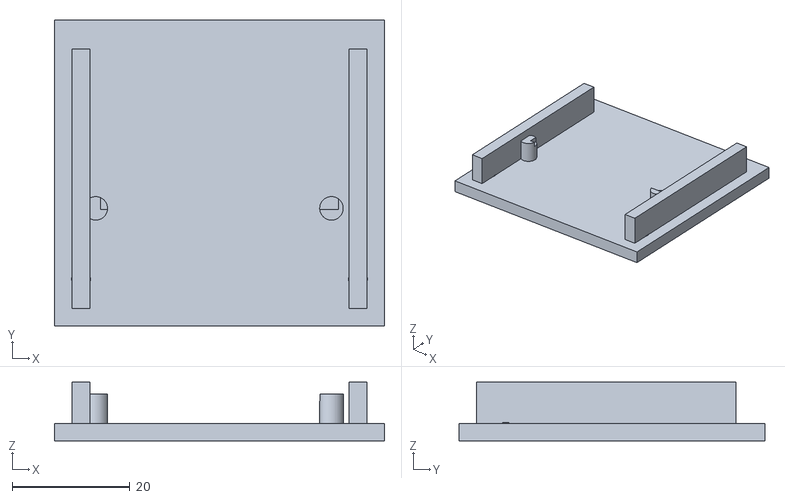
[picture p31: CAD file, 2026-11-09]
hardware/cad/base/print/side-contact-bed.stl
56.0 x 52.0 x 10.0
