Bruhdows/klink/hardware/cad/elevator/print/elevator-strap.stl

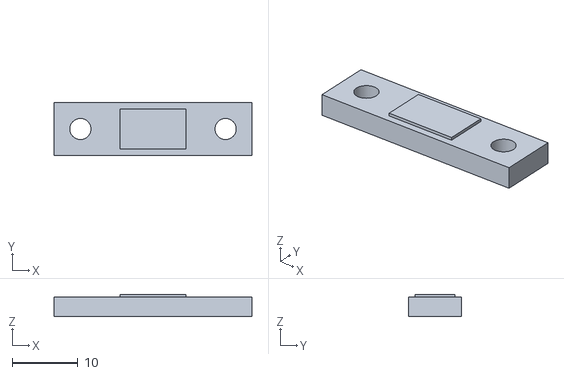
[picture p32: CAD file, 2026-11-09]
hardware/cad/elevator/print/elevator-strap.stl
30.0 x 8.00 x 3.40
