Bruhdows/klink/hardware/cad/pcb/marble-sensor.step

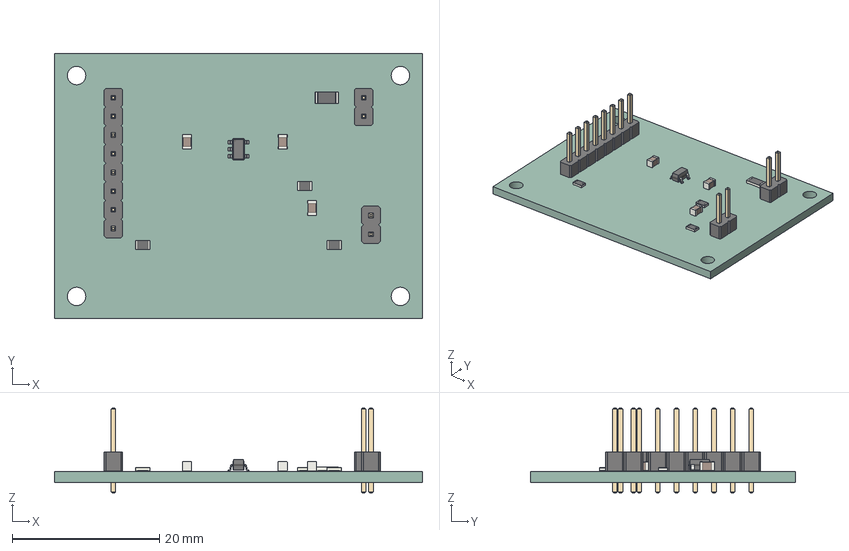
[picture p33: CAD file, 2026-11-09]
hardware/cad/pcb/marble-sensor.step
50.0 x 36.0 x 11.5 mm
C_0805_2012Metric x 3
R_0805_2012Metric x 3
PinHeader_1x02_P254mm_Vertical x 2
R_1206_3216Metric
PinHeader_1x08_P254mm_Vertical
SOT-23-5
marble-sensor_PCB
