Bruhdows/klink/hardware/cad/tracks/print/return-saddle.stl

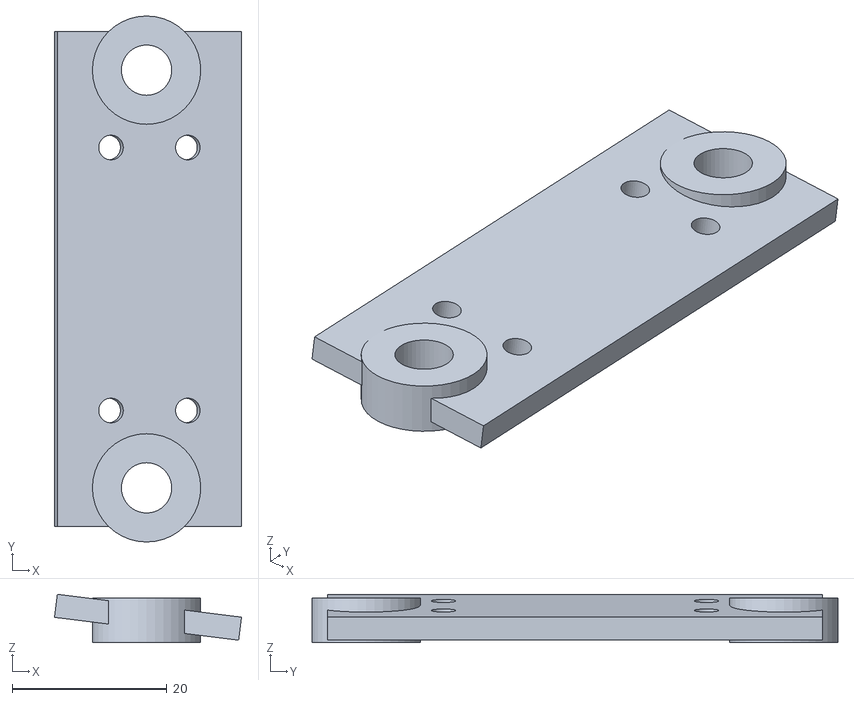
[picture p34: CAD file, 2026-11-09]
hardware/cad/tracks/print/return-saddle.stl
24.2 x 68.0 x 6.25
