Bruhdows/klink/hardware/cad/elevator/print/elevator-lower_frame.stl

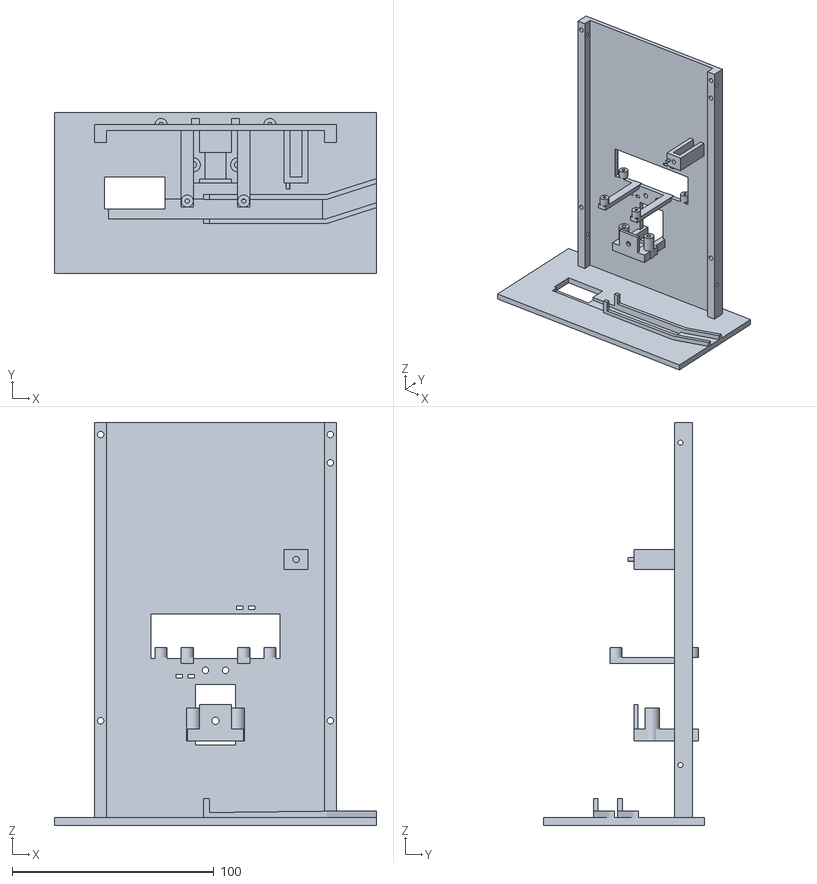
[picture p35: CAD file, 2026-11-09]
hardware/cad/elevator/print/elevator-lower_frame.stl
160.0 x 80.0 x 200.0
