Bruhdows/klink/hardware/cad/modules/print/key-module.stl

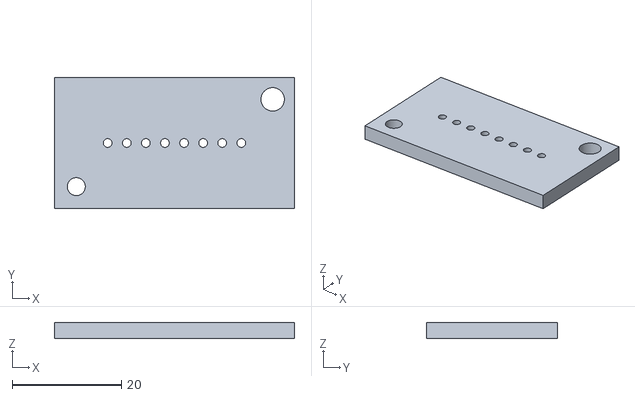
[picture p36: CAD file, 2026-11-09]
hardware/cad/modules/print/key-module.stl
44.0 x 24.0 x 3.00
