Bruhdows/klink/hardware/cad/pcb/gate.step

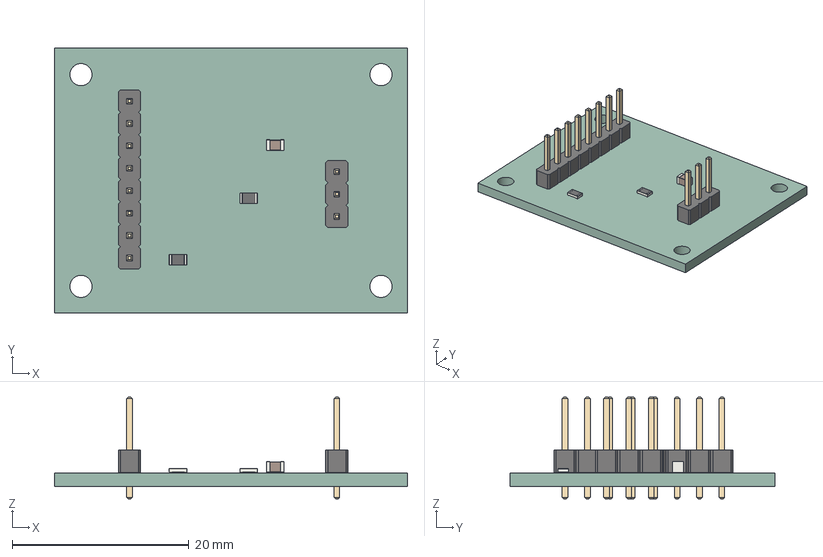
[picture p37: CAD file, 2026-11-09]
hardware/cad/pcb/gate.step
40.0 x 30.0 x 11.5 mm
PinHeader_1x08_P254mm_Vertical
R_0805_2012Metric x 2
PinHeader_1x03_P254mm_Vertical
C_0805_2012Metric
gate_PCB
