Bruhdows/klink/hardware/cad/tracks/print/return-end-support.stl

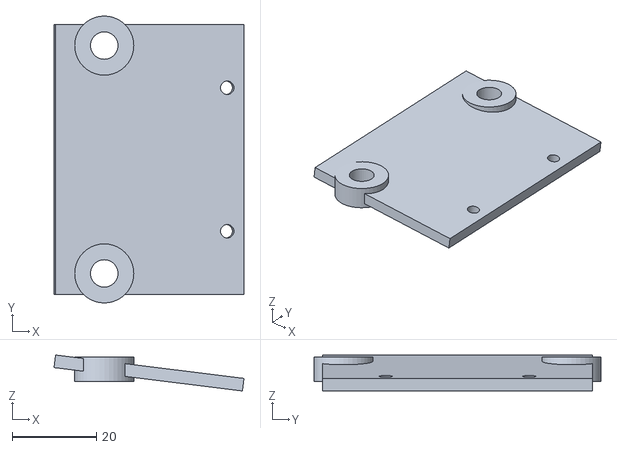
[picture p38: CAD file, 2026-11-09]
hardware/cad/tracks/print/return-end-support.stl
45.0 x 68.0 x 8.51
