Bruhdows/klink/hardware/cad/elevator/print/elevator-guides_upper.stl

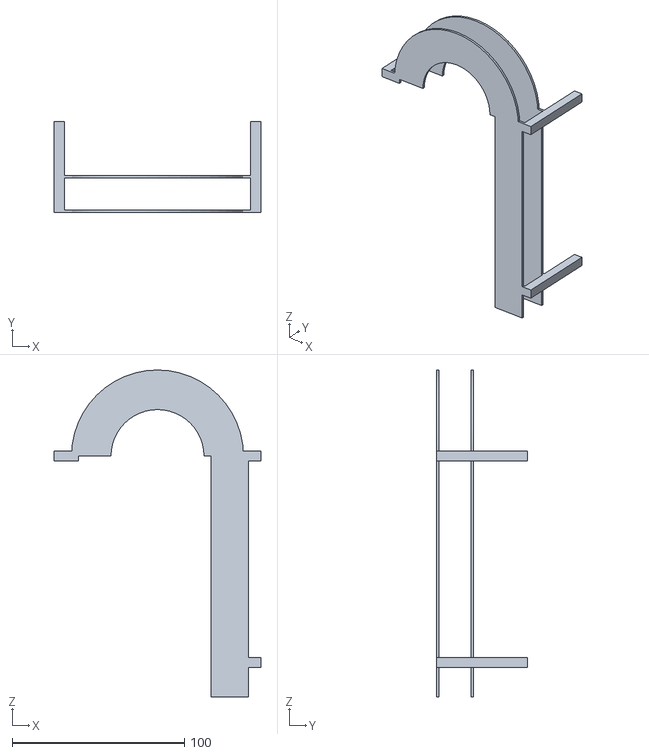
[picture p39: CAD file, 2026-11-09]
hardware/cad/elevator/print/elevator-guides_upper.stl
120.0 x 52.8 x 190.0
