Bruhdows/klink/hardware/cad/pcb/tile.step

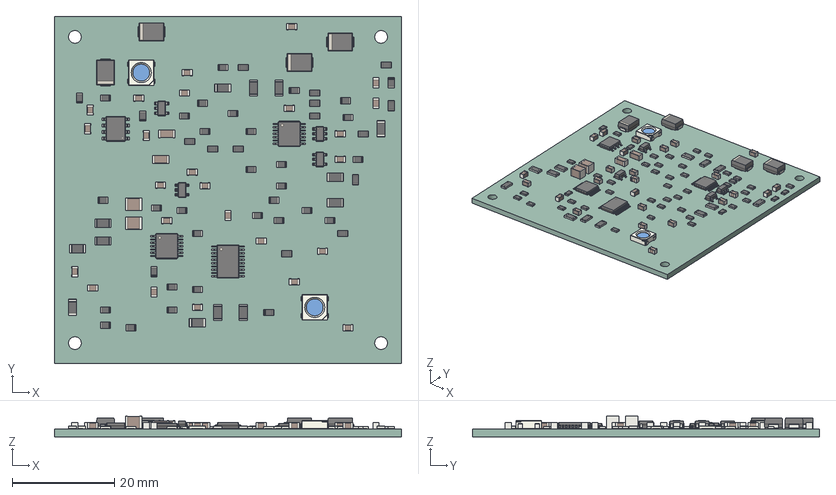
[picture p40: CAD file, 2026-11-09]
hardware/cad/pcb/tile.step
68.0 x 68.0 x 4.09 mm
R_0805_2012Metric x 47
C_0805_2012Metric x 25
R_1206_3216Metric x 8
D_SMB x 4
Fuse_1206_3216Metric x 5
TSSOP-14_4.4x5mm_P0.65mm x 2
C_1206_3216Metric x 2
LED_WS2812B_PLCC4_50x50mm_P32mm x 2
TI_SO-PowerPAD-8
SOT-23-5 x 3
TSSOP-20_4.4x6.5mm_P0.65mm
C_1210_3225Metric x 2
SOT-23-6
tile_PCB
