Bruhdows/klink/hardware/cad/step/return-curve45.step

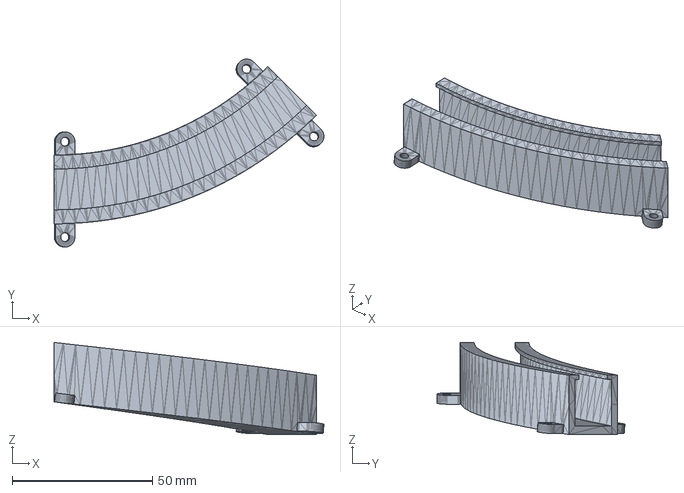
[picture p41: CAD file, 2026-11-09]
hardware/cad/step/return-curve45.step
96.2 x 67.0 x 32.9 mm
