Bruhdows/klink/hardware/cad/elevator/print/elevator-carrier.stl

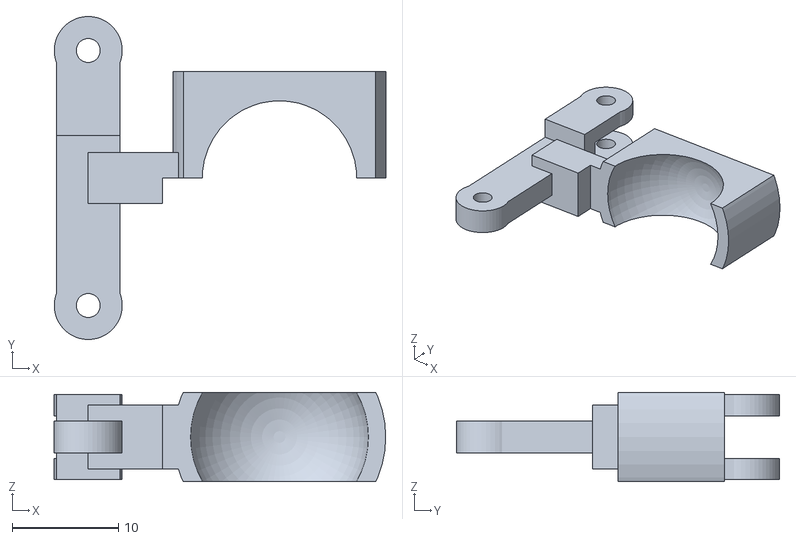
[picture p42: CAD file, 2026-11-09]
hardware/cad/elevator/print/elevator-carrier.stl
31.2 x 30.4 x 8.40
