Bruhdows/klink/hardware/cad/step/elevator-guard_upper.step

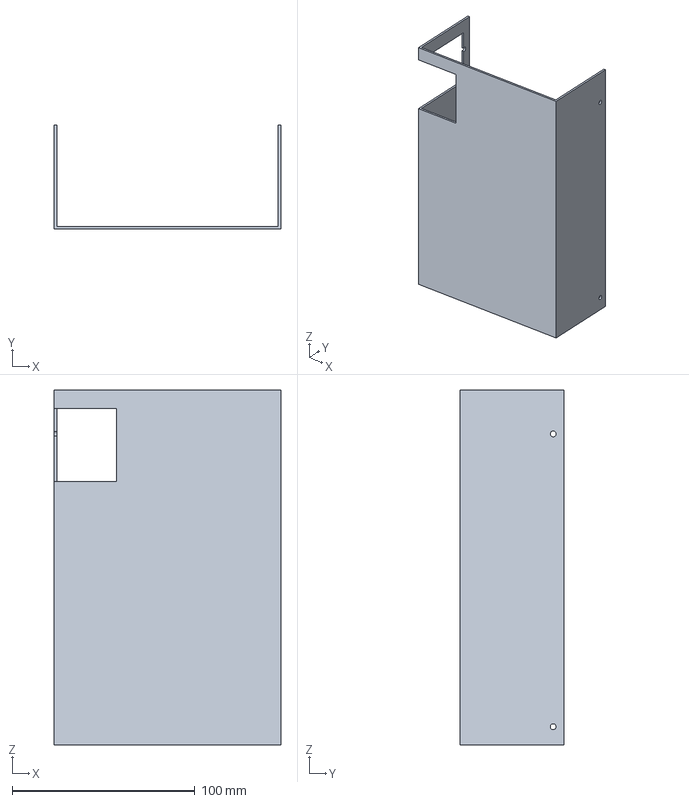
[picture p43: CAD file, 2026-11-09]
hardware/cad/step/elevator-guard_upper.step
124.0 x 57.0 x 194.0 mm
