Bruhdows/klink/hardware/cad/elevator/print/elevator-guides_lower.stl

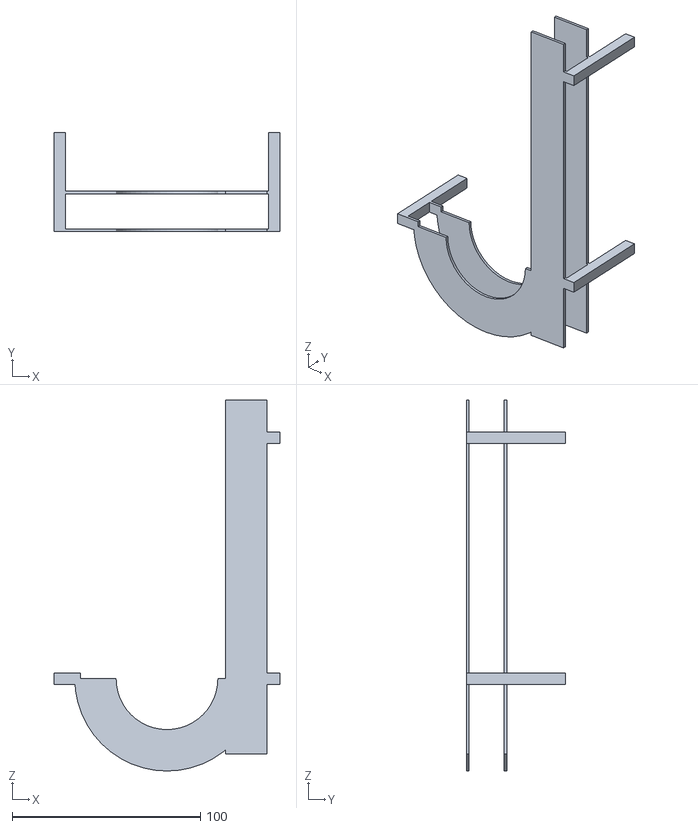
[picture p44: CAD file, 2026-11-09]
hardware/cad/elevator/print/elevator-guides_lower.stl
120.0 x 52.8 x 197.0
