Bruhdows/klink/hardware/cad/elevator/print/elevator-link.stl

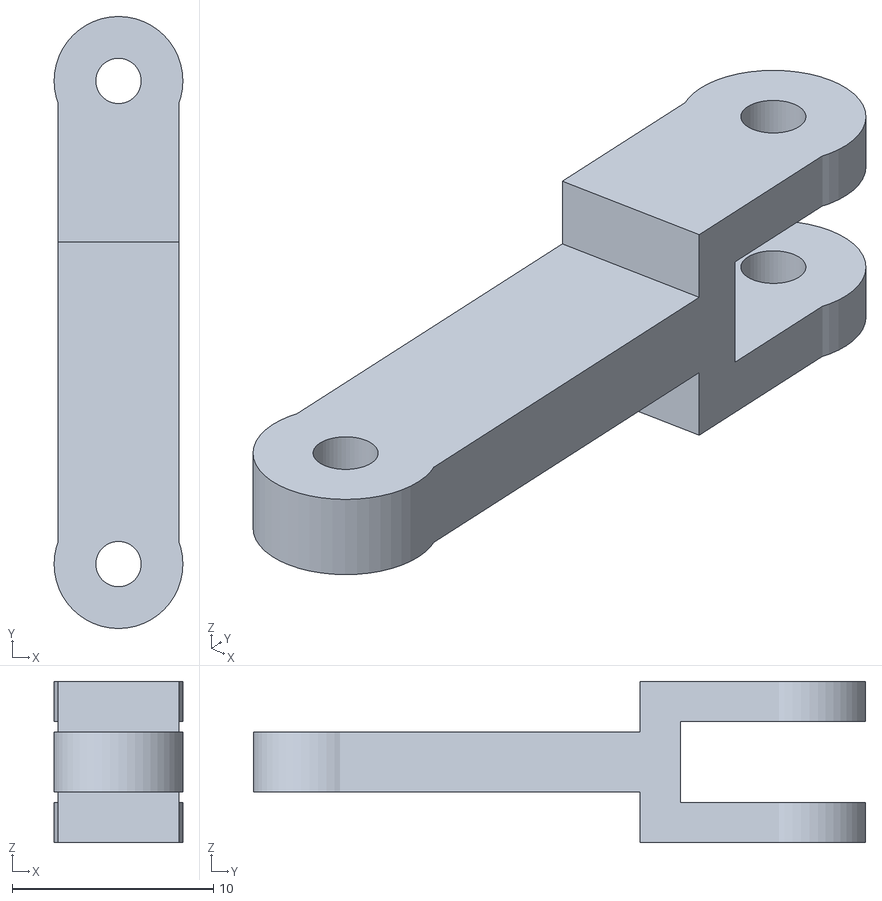
[picture p45: CAD file, 2026-11-09]
hardware/cad/elevator/print/elevator-link.stl
6.40 x 30.4 x 8.00
