Bruhdows/klink/hardware/cad/step/elevator-spacer_front.step

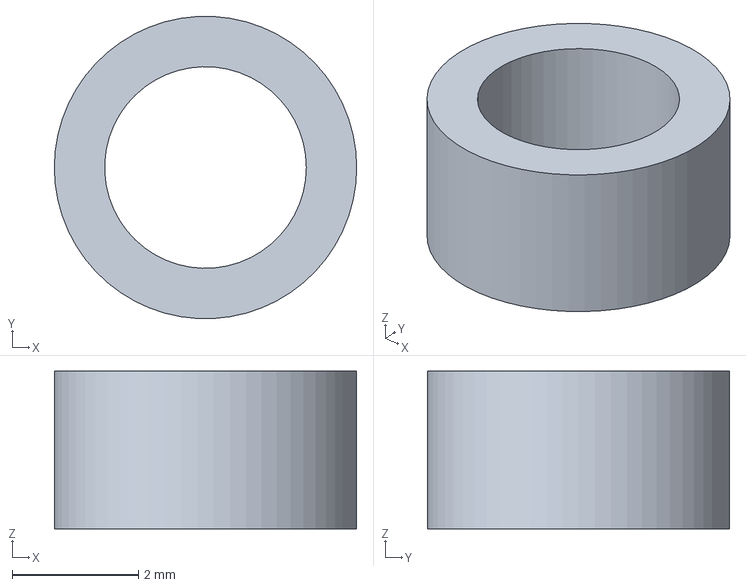
[picture p46: CAD file, 2026-11-09]
hardware/cad/step/elevator-spacer_front.step
4.80 x 4.79 x 2.50 mm
