Bruhdows/klink/hardware/cad/elevator/print/elevator-drive.stl

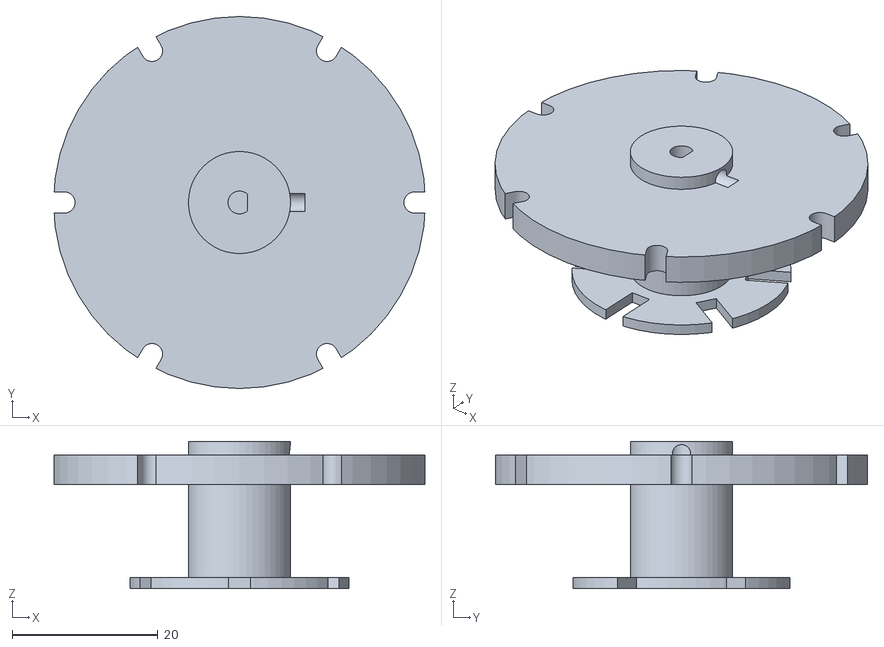
[picture p47: CAD file, 2026-11-09]
hardware/cad/elevator/print/elevator-drive.stl
50.8 x 51.0 x 20.2
