Bruhdows/klink/hardware/cad/elevator/print/elevator-sensor_bracket.stl

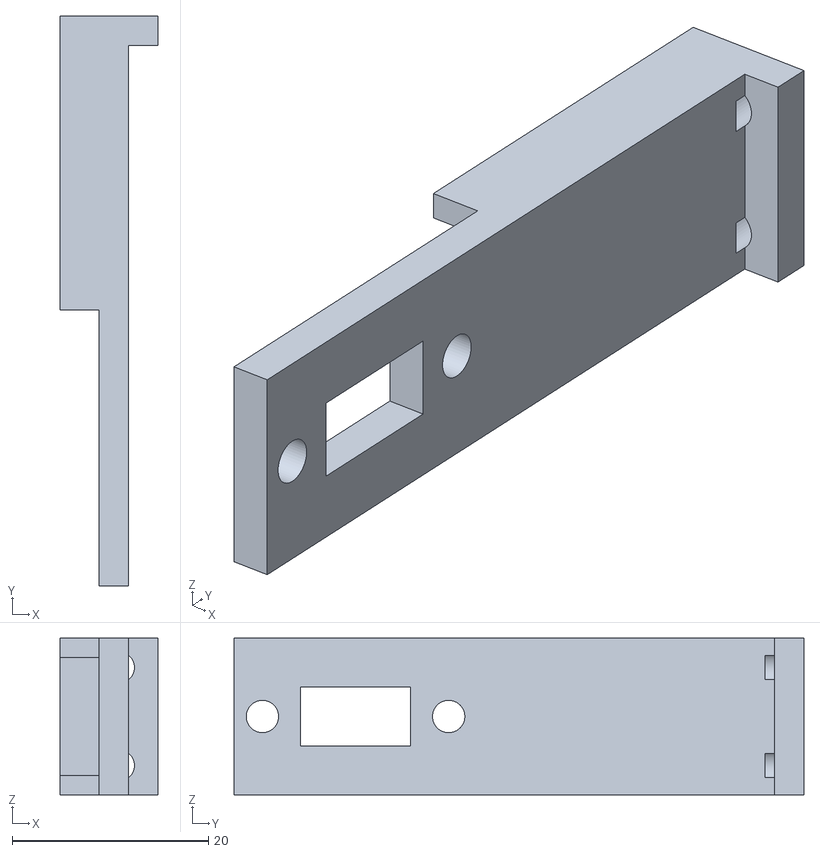
[picture p48: CAD file, 2026-11-09]
hardware/cad/elevator/print/elevator-sensor_bracket.stl
10.0 x 58.1 x 16.0
