Bruhdows/klink/hardware/cad/elevator/print/elevator-guard_lower.stl

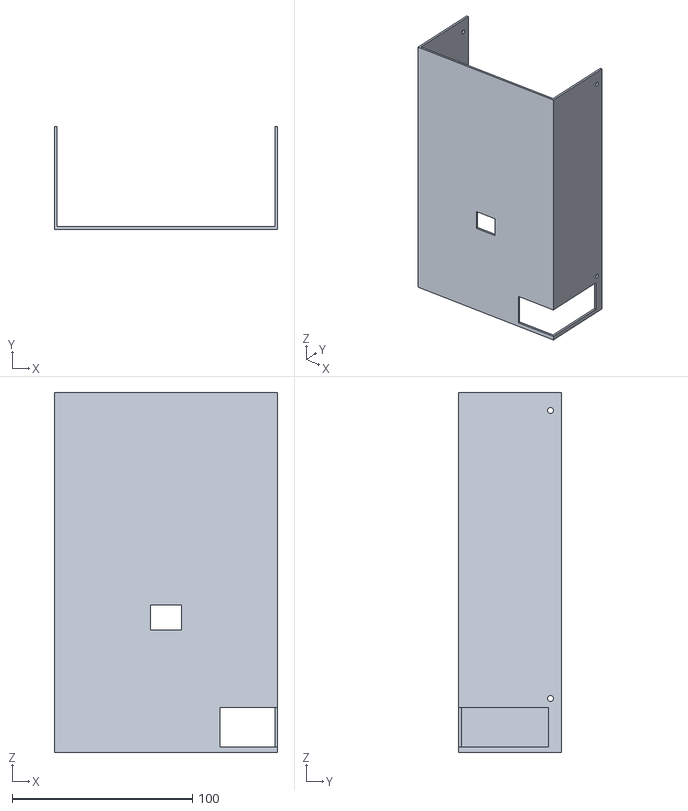
[picture p49: CAD file, 2026-11-09]
hardware/cad/elevator/print/elevator-guard_lower.stl
124.0 x 57.0 x 200.0
