Bruhdows/klink/hardware/cad/step/elevator-splice.step

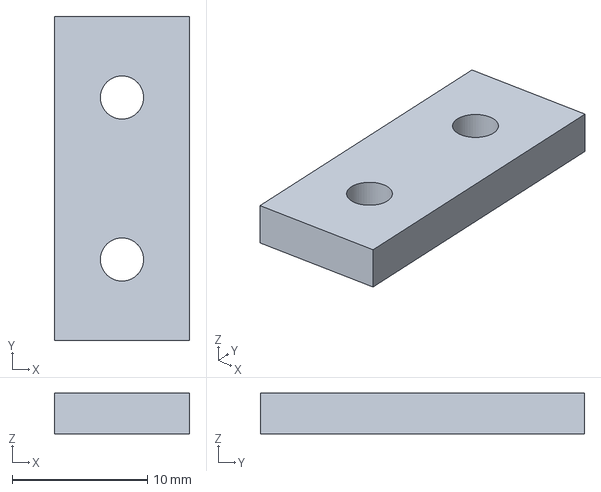
[picture p50: CAD file, 2026-11-09]
hardware/cad/step/elevator-splice.step
10.0 x 24.0 x 3.00 mm
