Bruhdows/klink/hardware/cad/elevator/print/elevator-exit.stl

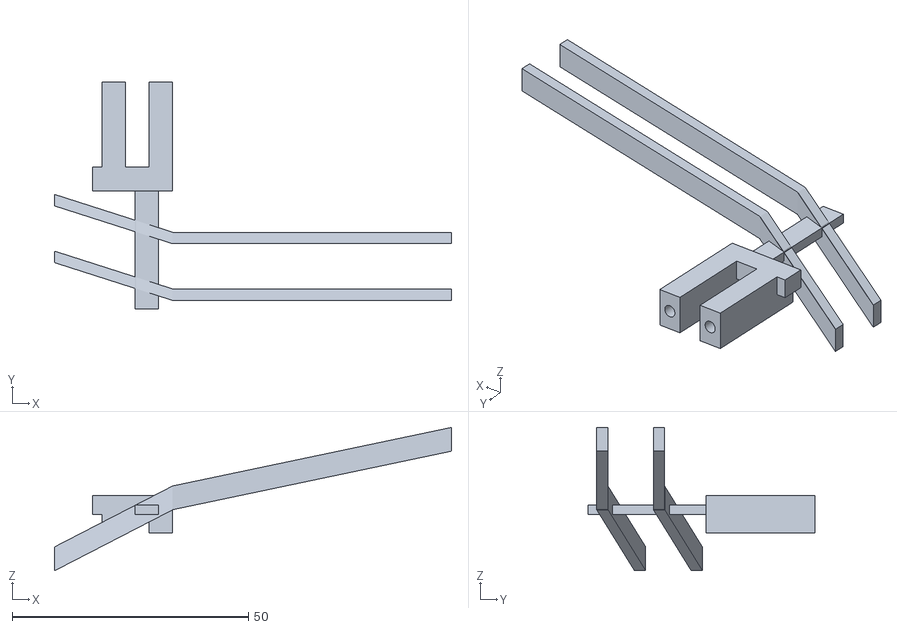
[picture p51: CAD file, 2026-11-09]
hardware/cad/elevator/print/elevator-exit.stl
84.0 x 48.0 x 30.3
