Bruhdows/klink/hardware/cad/step/baseboard.step

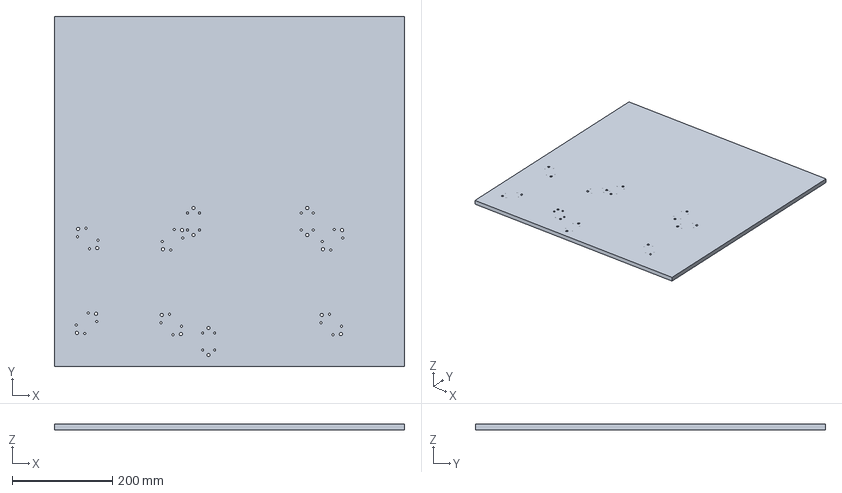
[picture p52: CAD file, 2026-11-09]
hardware/cad/step/baseboard.step
700.0 x 700.0 x 12.0 mm
