Bruhdows/klink/hardware/cad/common/connector_03e315320.scad

// SAMZO drawing 03E31-P991 A1 (2018-06-14), five-contact variant.
// Envelope only: no spring curve, working stroke, force or mating qualification.
samzo_pitch = 2;
samzo_contacts = 5;
samzo_body_width = 10;
samzo_body_depth = 6.5;
samzo_free_height = 1.27;
samzo_peg_pitch = 8;
samzo_peg_diameter = 0.8;
samzo_peg_length = 1.05; // drawing tolerance +/-0.20
samzo_hole_diameter = 1;
samzo_land_row_pitch = 5.38;
samzo_land_length = 1.62;
// Drawing omits recommended land width. This is a test-coupon choice.
samzo_test_land_width = 1.4;
samzo_test_board_width = 20;
samzo_test_board_height = 12;
