Bruhdows/klink/(list of files, cad)

Other CAD files:
hardware/cad/base/print/samzo-neighbor.stl
hardware/cad/modules/print/gate-base.stl
hardware/cad/step/return-foot.step
hardware/cad/step/elevator-idler.step
hardware/cad/tracks/print/return-curve45.stl
hardware/cad/step/hub-envelope.step
hardware/cad/step/elevator-link.step
hardware/cad/elevator/print/elevator-pawl.stl
hardware/cad/step/return-end-support.step
hardware/cad/step/gate-clamp.step
hardware/cad/step/elevator-guides_upper.step
hardware/cad/elevator/print/elevator-guard_upper.stl
hardware/cad/elevator/print/elevator-splice.stl
hardware/cad/step/elevator-drive.step
hardware/cad/elevator/print/elevator-spacer_front.stl
hardware/cad/step/key-tile.step
hardware/cad/step/side-contact-slider.step
hardware/cad/step/side-contact-bed.step
hardware/cad/step/straight-track.step
hardware/cad/step/elevator-sensor_bracket.step
hardware/cad/step/samzo-center.step
hardware/cad/step/return-saddle.step
hardware/cad/step/elevator-upper_frame.step
hardware/cad/step/base.step
hardware/cad/step/elevator-strap.step
hardware/cad/step/elevator-lower_frame.step
hardware/cad/step/key-module.step
hardware/cad/step/return-entry-support.step
hardware/cad/step/gate-flap.step
hardware/cad/step/elevator-guard_lower.step
hardware/cad/step/return-straight160.step
hardware/cad/step/elevator-spacer_rear.step
hardware/cad/step/elevator-carrier.step
hardware/cad/step/elevator-exit.step
hardware/cad/step/elevator-guides_lower.step
