Bruhdows/klink/hardware/manufacturing/baseboard-drill.csv

station | fixing | cad_x_mm | cad_y_mm | from_left_mm | from_front_mm | diameter_mm
0 | M6 | -112.019 | 27.0 | 277.981 | 317.0 | 6.5
0 | M6 | -112.019 | -27.0 | 277.981 | 263.0 | 6.5
0 | M4 | -100.019 | 17.0 | 289.981 | 307.0 | 4.5
0 | M4 | -100.019 | -17.0 | 289.981 | 273.0 | 4.5
0 | M4 | -124.019 | 17.0 | 265.981 | 307.0 | 4.5
0 | M4 | -124.019 | -17.0 | 265.981 | 273.0 | 4.5
2 | M6 | -342.726 | -14.837 | 47.274 | 275.163 | 6.5
2 | M6 | -304.543 | -53.021 | 85.457 | 236.979 | 6.5
2 | M4 | -327.17 | -13.423 | 62.83 | 276.577 | 4.5
2 | M4 | -303.129 | -37.465 | 86.871 | 252.535 | 4.5
2 | M4 | -344.141 | -30.393 | 45.859 | 259.607 | 4.5
2 | M4 | -320.099 | -54.435 | 69.901 | 235.565 | 4.5
4 | M6 | -345.163 | -222.726 | 44.837 | 67.274 | 6.5
4 | M6 | -306.979 | -184.543 | 83.021 | 105.457 | 6.5
4 | M4 | -346.577 | -207.17 | 43.423 | 82.83 | 4.5
4 | M4 | -322.535 | -183.129 | 67.465 | 106.871 | 4.5
4 | M4 | -329.607 | -224.141 | 60.393 | 65.859 | 4.5
4 | M4 | -305.565 | -200.099 | 84.435 | 89.901 | 4.5
6 | M6 | -137.274 | -225.163 | 252.726 | 64.837 | 6.5
6 | M6 | -175.457 | -186.979 | 214.543 | 103.021 | 6.5
6 | M4 | -152.83 | -226.577 | 237.17 | 63.423 | 4.5
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
