Bruhdows/klink/hardware/manufacturing/rod-cut-list.csv

stock_bar | station | side | cut_length_mm | nominal_model_length_mm | kerf_allowance_mm | stock_length_mm | end_trim_total_mm
1 | 0 | -1 | 390 | 389.422 | 2 | 1000 | 4
1 | 0 | 1 | 390 | 389.422 | 2 | 1000 | 4
1 | 22 | -1 | 121 | 120.193 | 2 | 1000 | 4
1 | 26 | -1 | 66 | 65.293 | 2 | 1000 | 4
2 | 2 | -1 | 363 | 362.08 | 2 | 1000 | 4
2 | 2 | 1 | 363 | 362.08 | 2 | 1000 | 4
2 | 22 | 1 | 121 | 120.193 | 2 | 1000 | 4
2 | 24 | -1 | 89 | 88.666 | 2 | 1000 | 4
3 | 4 | -1 | 339 | 338.706 | 2 | 1000 | 4
3 | 4 | 1 | 339 | 338.706 | 2 | 1000 | 4
3 | 8 | -1 | 292 | 291.96 | 2 | 1000 | 4
4 | 6 | -1 | 316 | 315.333 | 2 | 1000 | 4
4 | 6 | 1 | 316 | 315.333 | 2 | 1000 | 4
4 | 8 | 1 | 292 | 291.96 | 2 | 1000 | 4
4 | 27 | -1 | 58 | 57.79 | 2 | 1000 | 4
5 | 24 | 1 | 89 | 88.666 | 2 | 1000 | 4
5 | 26 | 1 | 66 | 65.293 | 2 | 1000 | 4
5 | 27 | 1 | 58 | 57.79 | 2 | 1000 | 4
