Bruhdows/klink/hardware/electronics/tile/tile.kicad_pcb

## KiCad design hardware/electronics/tile/tile.kicad_pcb (2026-11-09)

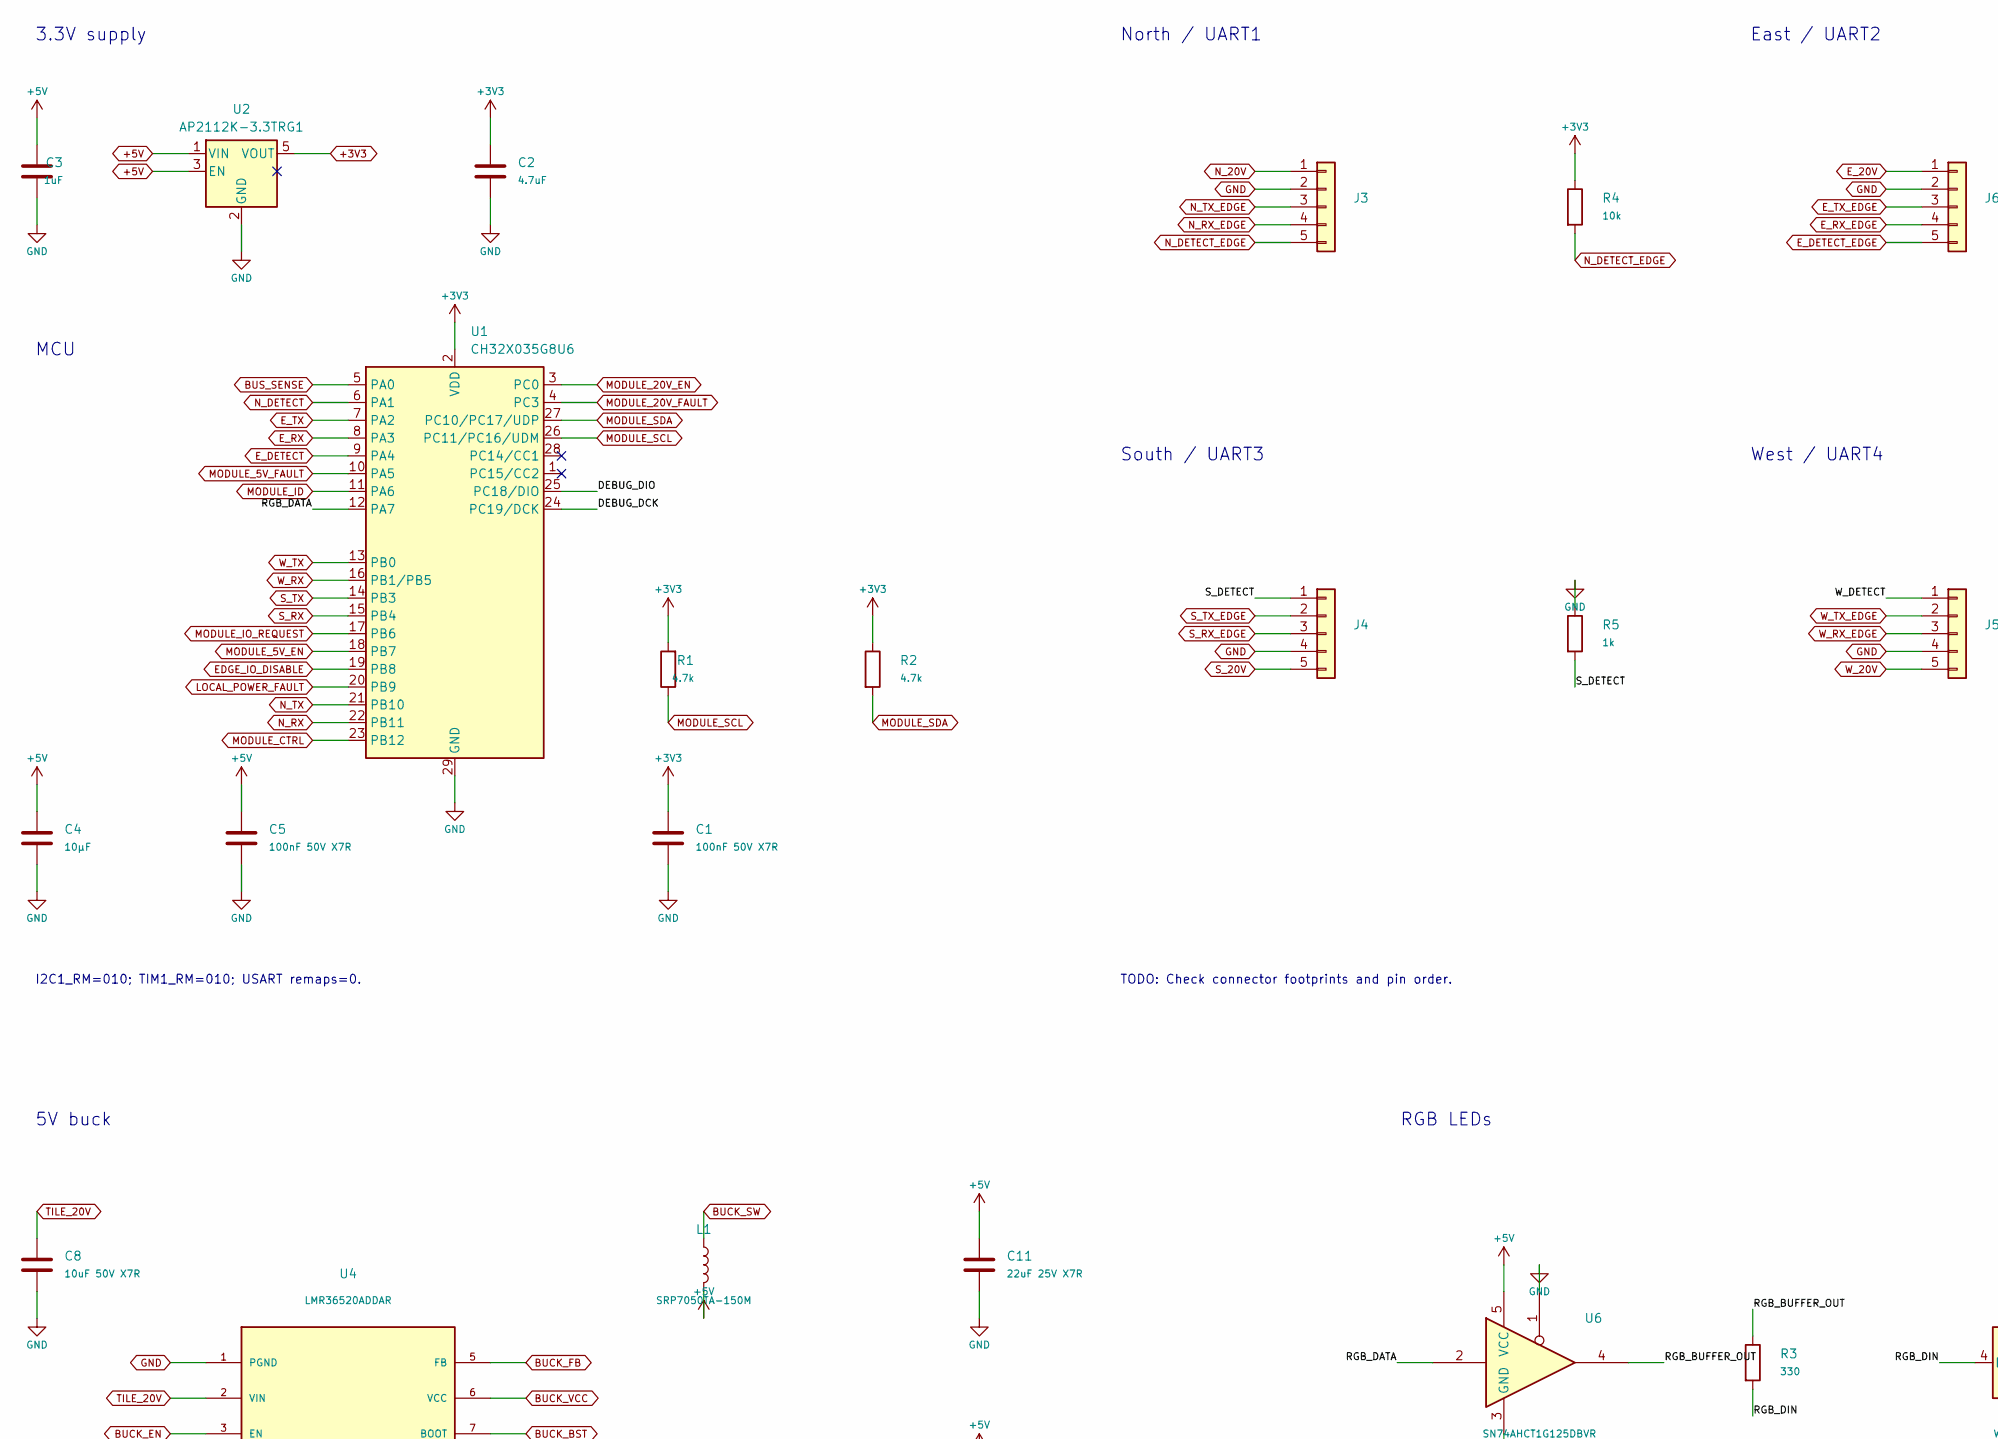
[picture p53: schematic tile.kicad_sch, Smart tile, part in row 1, column 1]

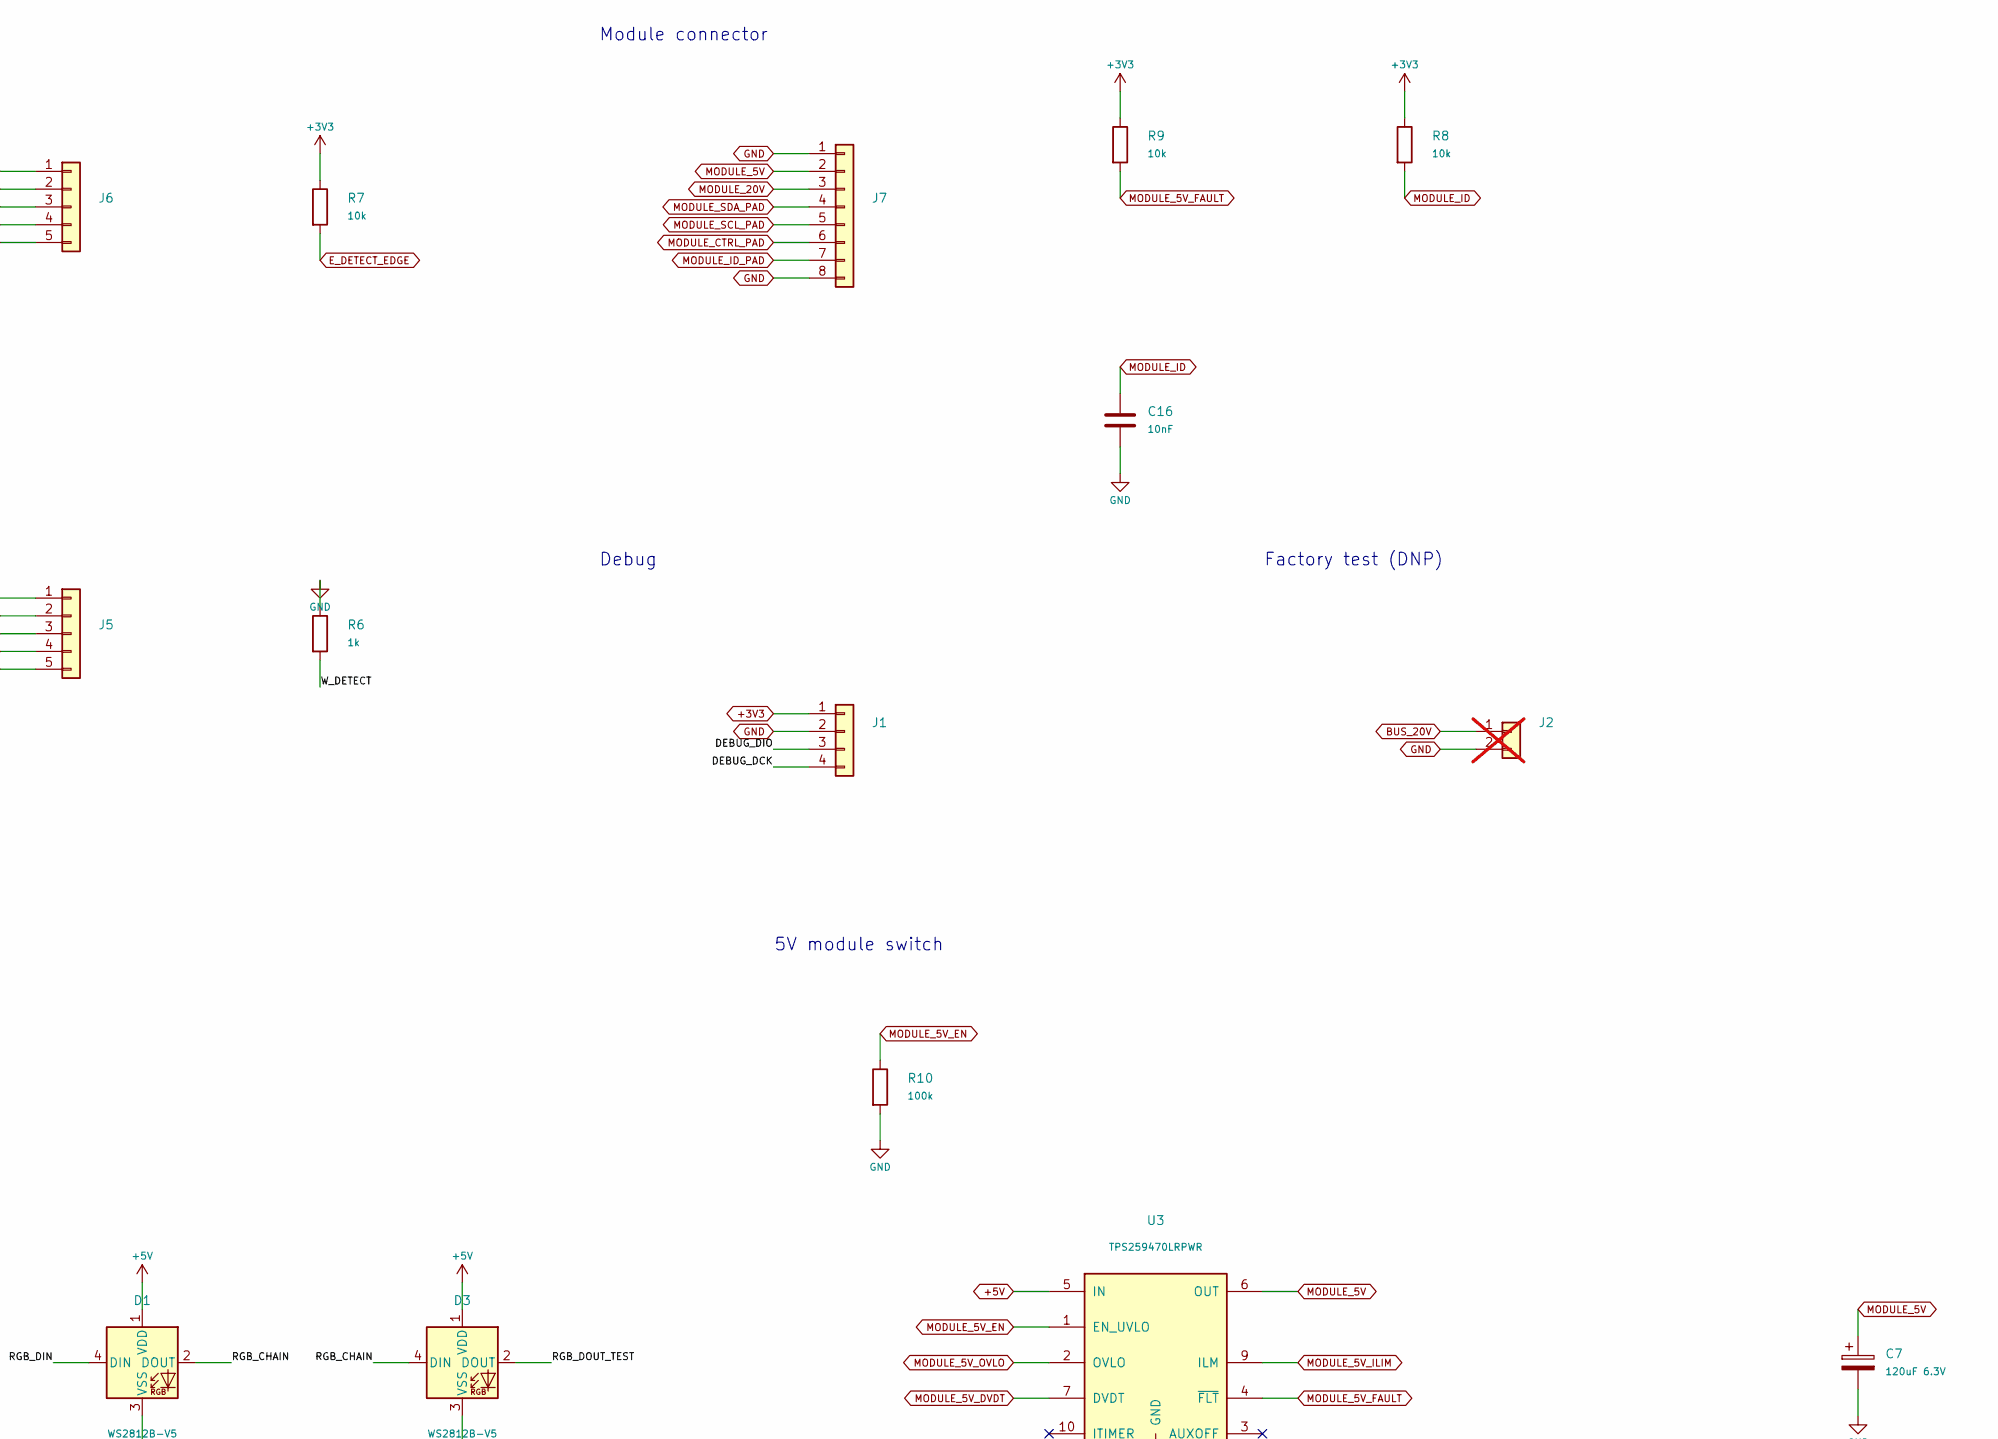
[picture p54: schematic tile.kicad_sch, Smart tile, part in row 1, column 2]

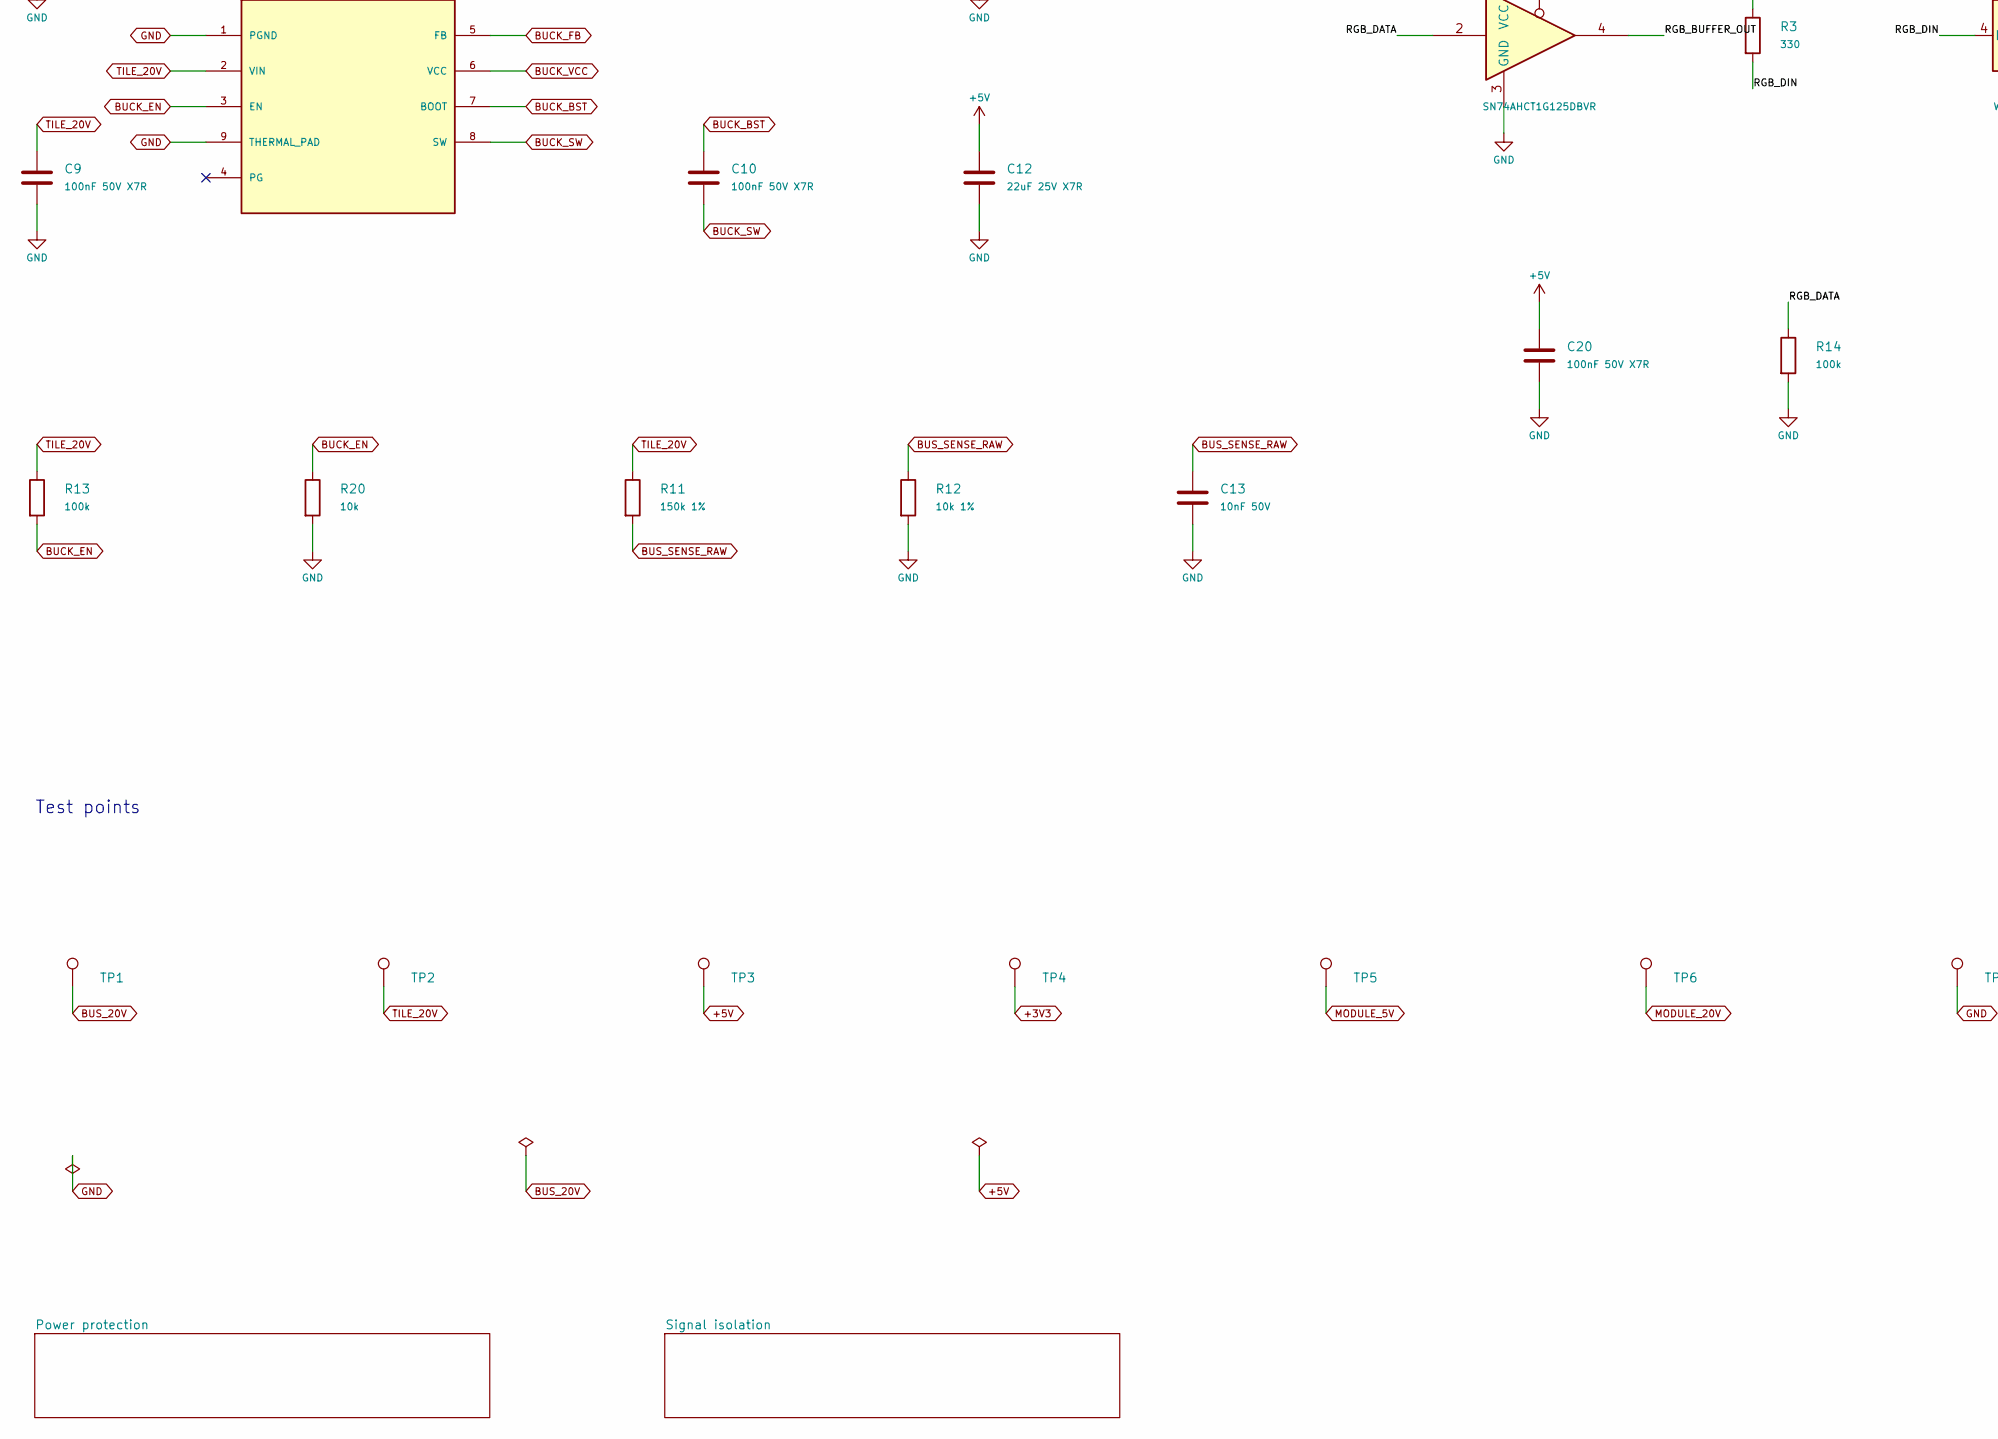
[picture p55: schematic tile.kicad_sch, Smart tile, part in row 2, column 1]

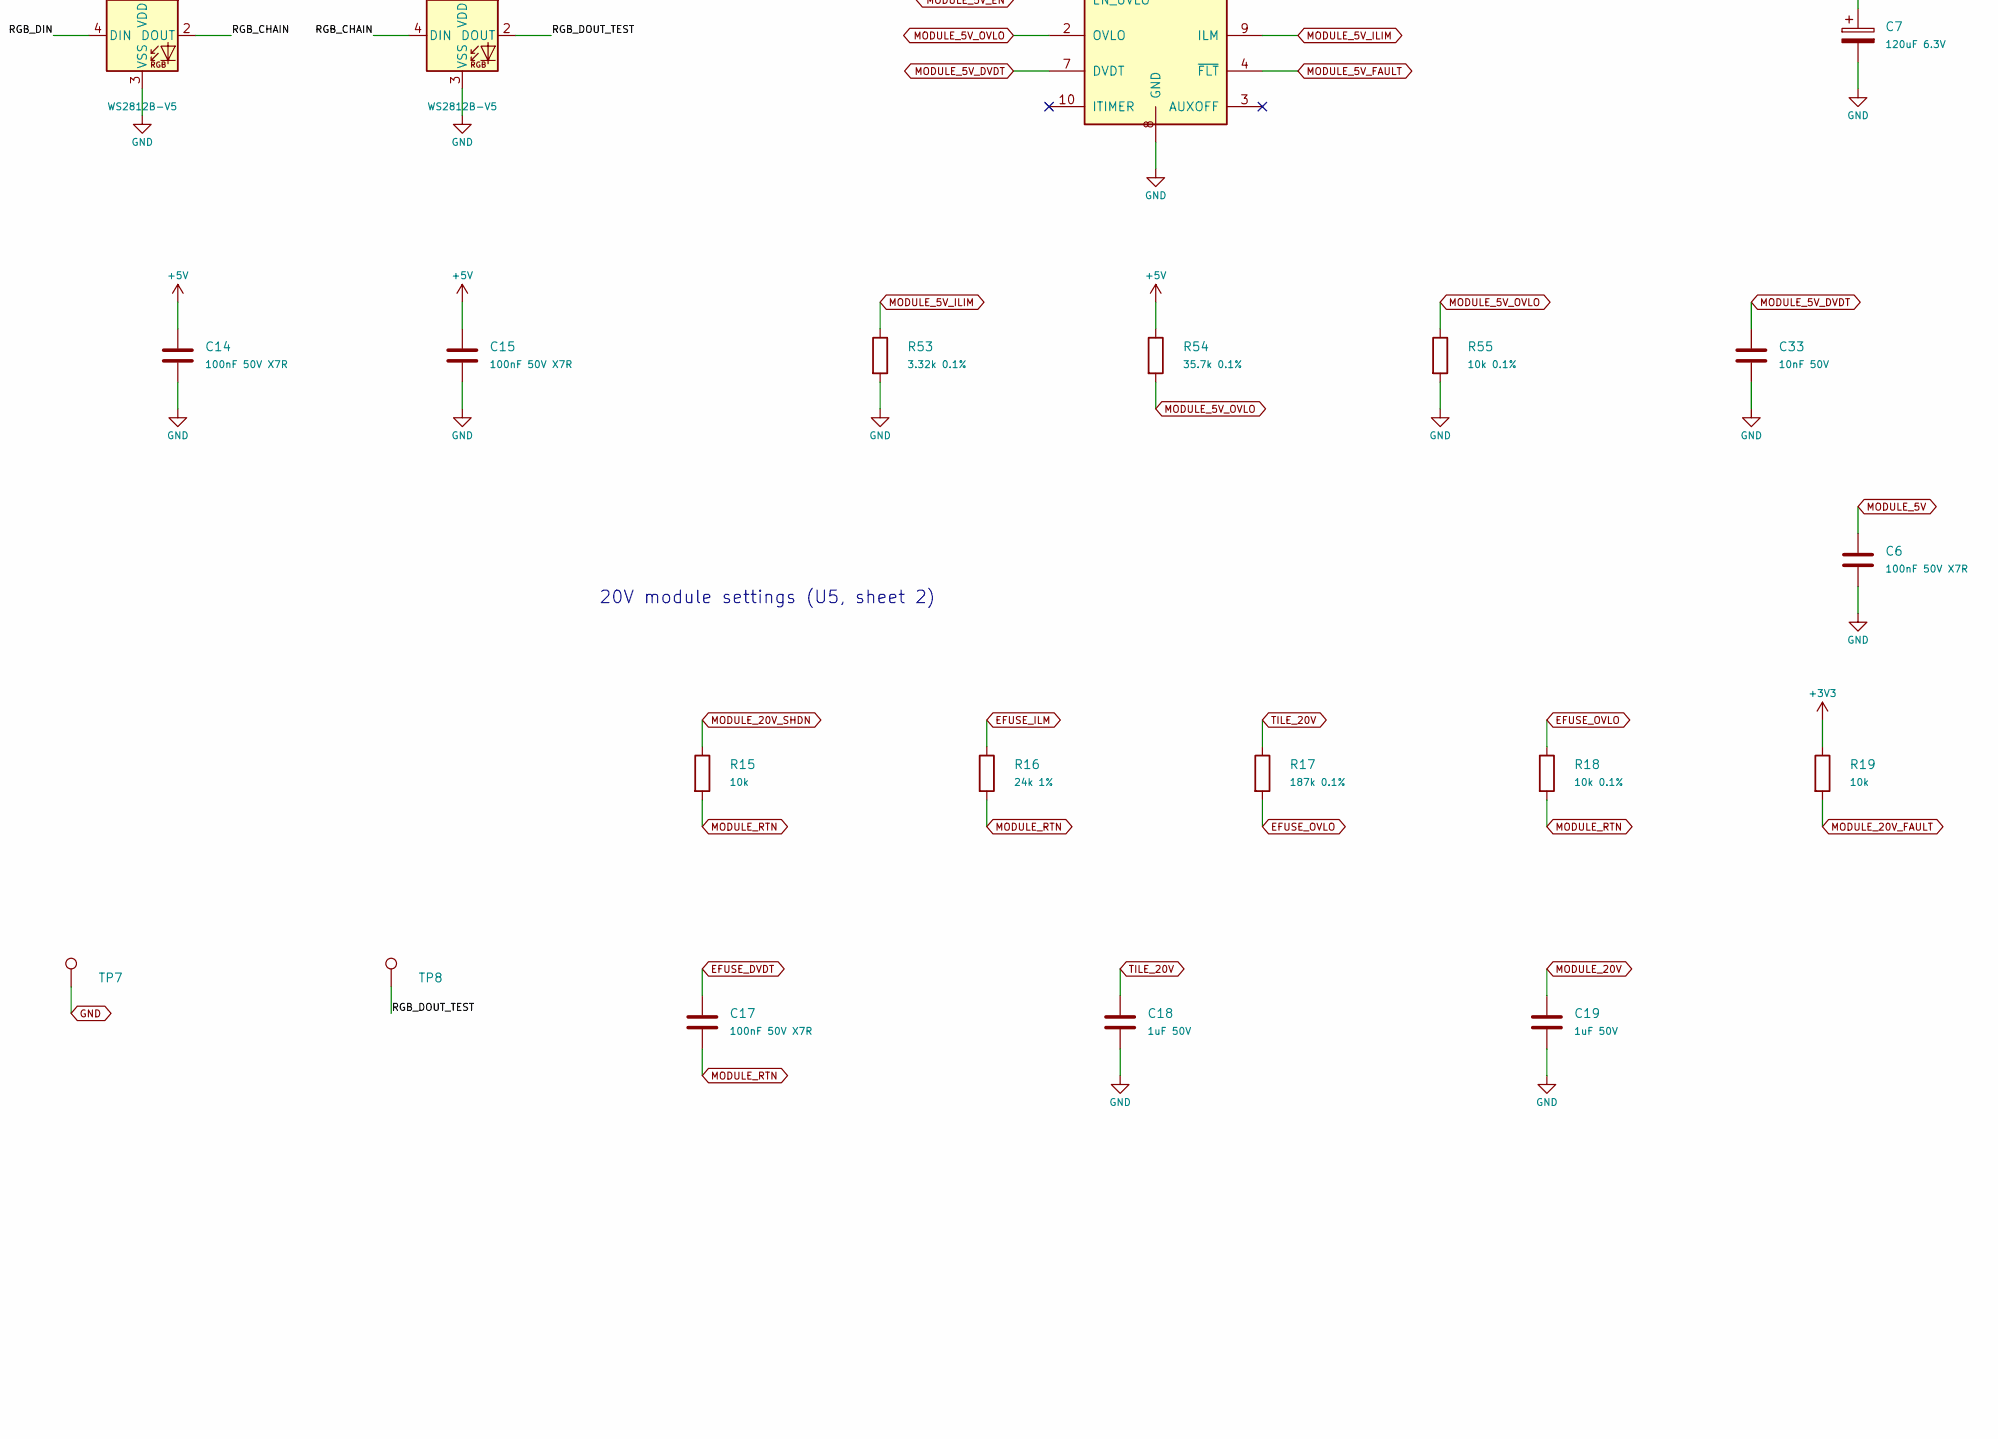
[picture p56: schematic tile.kicad_sch, Smart tile, part in row 2, column 2]

Parts:
C1, C5, C6, C9, C10, C14, C15, C17, C20: 100nF 50V X7R; C_0805_2012Metric; MPN C2012X7R1H104K125AE
C2: 4.7uF; C_0805_2012Metric; MPN C2012X7R1C475K125AB
C3: 1uF; C_0805_2012Metric; MPN C2012X7R1H105K125AB
C4: 10µF; C_1206_3216Metric; MPN C3216X7R1C106K160AC
C7: 120uF 6.3V; CP_Panasonic_POSCAP_B2; ManufacturerPartNumber 6TPE120MAZB
C8: 10uF 50V X7R; C_1206_3216Metric; MPN C3216X7R1H106K160AC
C11, C12: 22uF 25V X7R; C_1210_3225Metric; MPN C1210C226K3RACTU
C13, C33: 10nF 50V; C_0805_2012Metric; MPN CC0805KRX7R9BB103
C16: 10nF; C_0805_2012Metric; MPN CC0805KRX7R9BB103
C18, C19: 1uF 50V; C_0805_2012Metric; MPN C2012X7R1H105K125AB
D1, D3: WS2812B-V5; LED_WS2812B_PLCC4_5.0x5.0mm_P3.2mm
J1: DEBUG_3V3_MONITOR; Debug_1x04_P2.54_Pads
J2: DNP_FACTORY_BUS_TEST; not fitted
J3, J4, J5, J6: EDGE_5P_TBD
J7: Conn_01x08
L1: SRP7050TA-150M; L_Bourns_SRP7050TA
R1, R2: 4.7k; R_0805_2012Metric; MPN RC0805FR-074K7L
R3: 330; R_0805_2012Metric; MPN RC0805FR-07330RL
R4, R7, R8, R9, R15, R19, R20: 10k; R_0805_2012Metric; MPN RC0805FR-0710KL
R5, R6: 1k; R_0805_2012Metric; MPN RC0805FR-071KL
R10, R13, R14: 100k; R_0805_2012Metric; MPN RC0805FR-07100KL
R11: 150k 1%; R_0805_2012Metric; MPN RC0805FR-07150KL
R12: 10k 1%; R_0805_2012Metric; MPN RC0805FR-0710KL
R16: 24k 1%; R_0805_2012Metric; MPN RC0805FR-0724KL
R17: 187k 0.1%; R_0805_2012Metric; MPN RT0805BRD07187KL
R18, R55: 10k 0.1%; R_0805_2012Metric; MPN RT0805BRD0710KL
R53: 3.32k 0.1%; R_0805_2012Metric; MPN RT0805BRD073K32L
R54: 35.7k 0.1%; R_0805_2012Metric; MPN RT0805BRD0735K7L
TP1: BUS_20V; TestPoint_Pad_D2.0mm
TP2: TILE_20V; TestPoint_Pad_D2.0mm
TP3: +5V; TestPoint_Pad_D2.0mm
TP4: +3V3; TestPoint_Pad_D2.0mm
TP5: MODULE_5V; TestPoint_Pad_D2.0mm
TP6: MODULE_20V; TestPoint_Pad_D2.0mm
TP7: GND; TestPoint_Pad_D2.0mm
TP8: RGB_DOUT_TEST; TestPoint_Pad_D2.0mm
U1: CH32X035G8U6; WQFN-28-1EP_4x4mm_P0.4mm_EP2.7x2.7mm
U2: AP2112K-3.3TRG1; SOT-23-5
U3: TPS259470LRPWR; TI_RPW0010A_2x2mm
U4: LMR36520ADDAR; TI_SO-PowerPAD-8
U6: SN74AHCT1G125DBVR; SOT-23-5

Connections:
+3V3: C1.1, C2.1, J1.1, R1.2, R2.1, R4.1, R7.1, R8.1, R9.1, R19.1, TP4.1, U1.2 (VDD), U2.5 (VOUT); also elsewhere on the board
+5V: C3.2, C4.1, C5.1, C11.1, C12.1, C14.1, C15.1, C20.1, D1.1 (VDD), D3.1 (VDD), L1.2, R54.1, TP3.1, U2.1 (VIN), U2.3 (EN), U3.5 (IN), U6.5 (VCC); also elsewhere on the board
/DEBUG_DCK: J1.4, U1.24 (PC19/DCK)
/DEBUG_DIO: J1.3, U1.25 (PC18/DIO)
/RGB_BUFFER_OUT: R3.1, U6.4
/RGB_CHAIN: D1.2 (DOUT), D3.4 (DIN)
/RGB_DATA: R14.1, U1.12 (PA7), U6.2
/RGB_DIN: D1.4 (DIN), R3.2
/RGB_DOUT_TEST: D3.2 (DOUT), TP8.1
/S_DETECT: J4.1, R5.2
/W_DETECT: J5.1, R6.2
BUCK_BST: C10.1, U4.7 (BOOT)
BUCK_EN: R13.2, R20.1, U4.3 (EN)
BUCK_FB: U4.5 (FB); also elsewhere on the board
BUCK_SW: C10.2, L1.1, U4.8 (SW)
BUCK_VCC: U4.6 (VCC); also elsewhere on the board
BUS_20V: J2.1, TP1.1; also elsewhere on the board
BUS_SENSE: U1.5 (PA0); also elsewhere on the board
BUS_SENSE_RAW: C13.1, R11.2, R12.1; also elsewhere on the board
EDGE_IO_DISABLE: U1.19 (PB8); also elsewhere on the board
EFUSE_DVDT: C17.1; also elsewhere on the board
EFUSE_ILM: R16.1; also elsewhere on the board
EFUSE_OVLO: R17.2, R18.1; also elsewhere on the board
E_DETECT: U1.9 (PA4); also elsewhere on the board
E_DETECT_EDGE: J6.5, R7.2; also elsewhere on the board
E_RX: U1.8 (PA3); also elsewhere on the board
E_TX: U1.7 (PA2); also elsewhere on the board
GND: C1.2, C2.2, C3.1, C4.2, C5.2, C6.2, C7.2, C8.2, C9.2, C11.2, C12.2, C13.2, C14.2, C15.2, C16.2, C18.2, C19.2, C20.2, C33.2, D1.3 (VSS), D3.3 (VSS), J1.2, J2.2, J3.2, J4.4, J5.4, J6.2, J7.1, J7.8, R5.1, R6.1, R10.2, R12.2, R14.2, R20.2, R53.2, R55.2, TP7.1, U1.29 (GND), U2.2 (GND), U3.8 (GND), U4.1 (PGND), U4.9 (THERMAL_PAD), U6.1, U6.3 (GND); also elsewhere on the board
LOCAL_POWER_FAULT: U1.20 (PB9); also elsewhere on the board
MODULE_5V: C6.1, C7.1, J7.2, TP5.1, U3.6 (OUT); also elsewhere on the board
MODULE_5V_DVDT: C33.1, U3.7 (DVDT)
MODULE_5V_EN: R10.1, U1.18 (PB7), U3.1 (EN_UVLO)
MODULE_5V_FAULT: R9.2, U1.10 (PA5), U3.4 (~FLT)
MODULE_5V_ILIM: R53.1, U3.9 (ILM)
MODULE_5V_OVLO: R54.2, R55.1, U3.2 (OVLO)
MODULE_20V: C19.1, J7.3, TP6.1; also elsewhere on the board
MODULE_20V_EN: U1.3 (PC0); also elsewhere on the board
MODULE_20V_FAULT: R19.2, U1.4 (PC3); also elsewhere on the board
MODULE_20V_SHDN: R15.1; also elsewhere on the board
MODULE_CTRL: U1.23 (PB12); also elsewhere on the board
MODULE_ID: C16.1, R8.2, U1.11 (PA6); also elsewhere on the board
MODULE_IO_REQUEST: U1.17 (PB6); also elsewhere on the board
MODULE_RTN: C17.2, R15.2, R16.2, R18.2; also elsewhere on the board
MODULE_SCL: R1.1, U1.26 (PC11/PC16/UDM); also elsewhere on the board
MODULE_SDA: R2.2, U1.27 (PC10/PC17/UDP); also elsewhere on the board
N_DETECT: U1.6 (PA1); also elsewhere on the board
N_DETECT_EDGE: J3.5, R4.2; also elsewhere on the board
N_RX: U1.22 (PB11); also elsewhere on the board
N_TX: U1.21 (PB10); also elsewhere on the board
S_RX: U1.15 (PB4); also elsewhere on the board
S_TX: U1.14 (PB3); also elsewhere on the board
TILE_20V: C8.1, C9.1, C18.1, R11.1, R13.1, R17.1, TP2.1, U4.2 (VIN); also elsewhere on the board
W_RX: U1.16 (PB1/PB5); also elsewhere on the board
W_TX: U1.13 (PB0); also elsewhere on the board

Notes on the sheet:
3.3V supply
MCU
North / UART1
East / UART2
South / UART3
West / UART4
Module connector
Debug
Factory test (DNP)
5V buck
RGB LEDs
5V module switch
20V module settings (U5, sheet 2)
Test points
I2C1_RM=010; TIM1_RM=010; USART remaps=0.
TODO: Check connector footprints and pin order.
