Bruhdows/klink/hardware/electronics/tile/tile.kicad_pcb

## KiCad design hardware/electronics/tile/tile.kicad_pcb (continued)

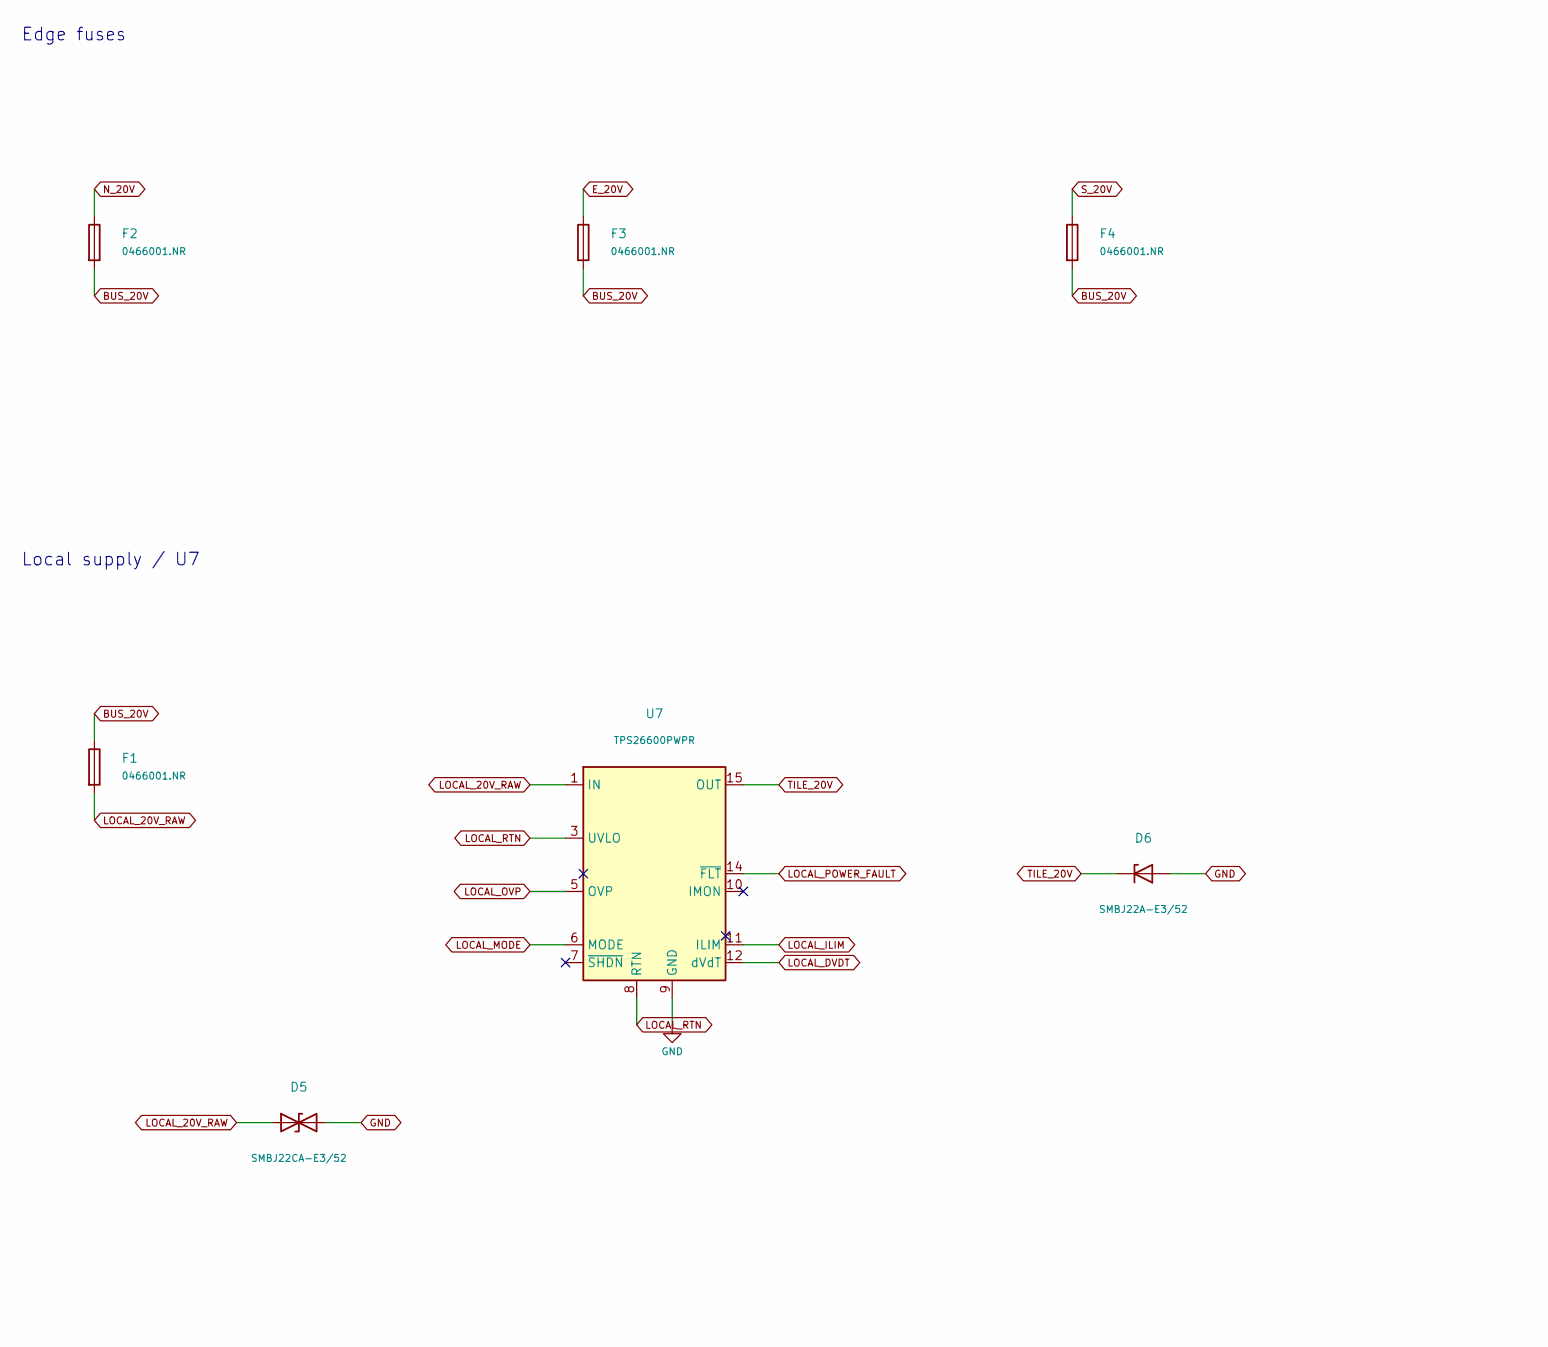
[picture p57: schematic power-protection.kicad_sch, 20V protection, part in row 1, column 1]

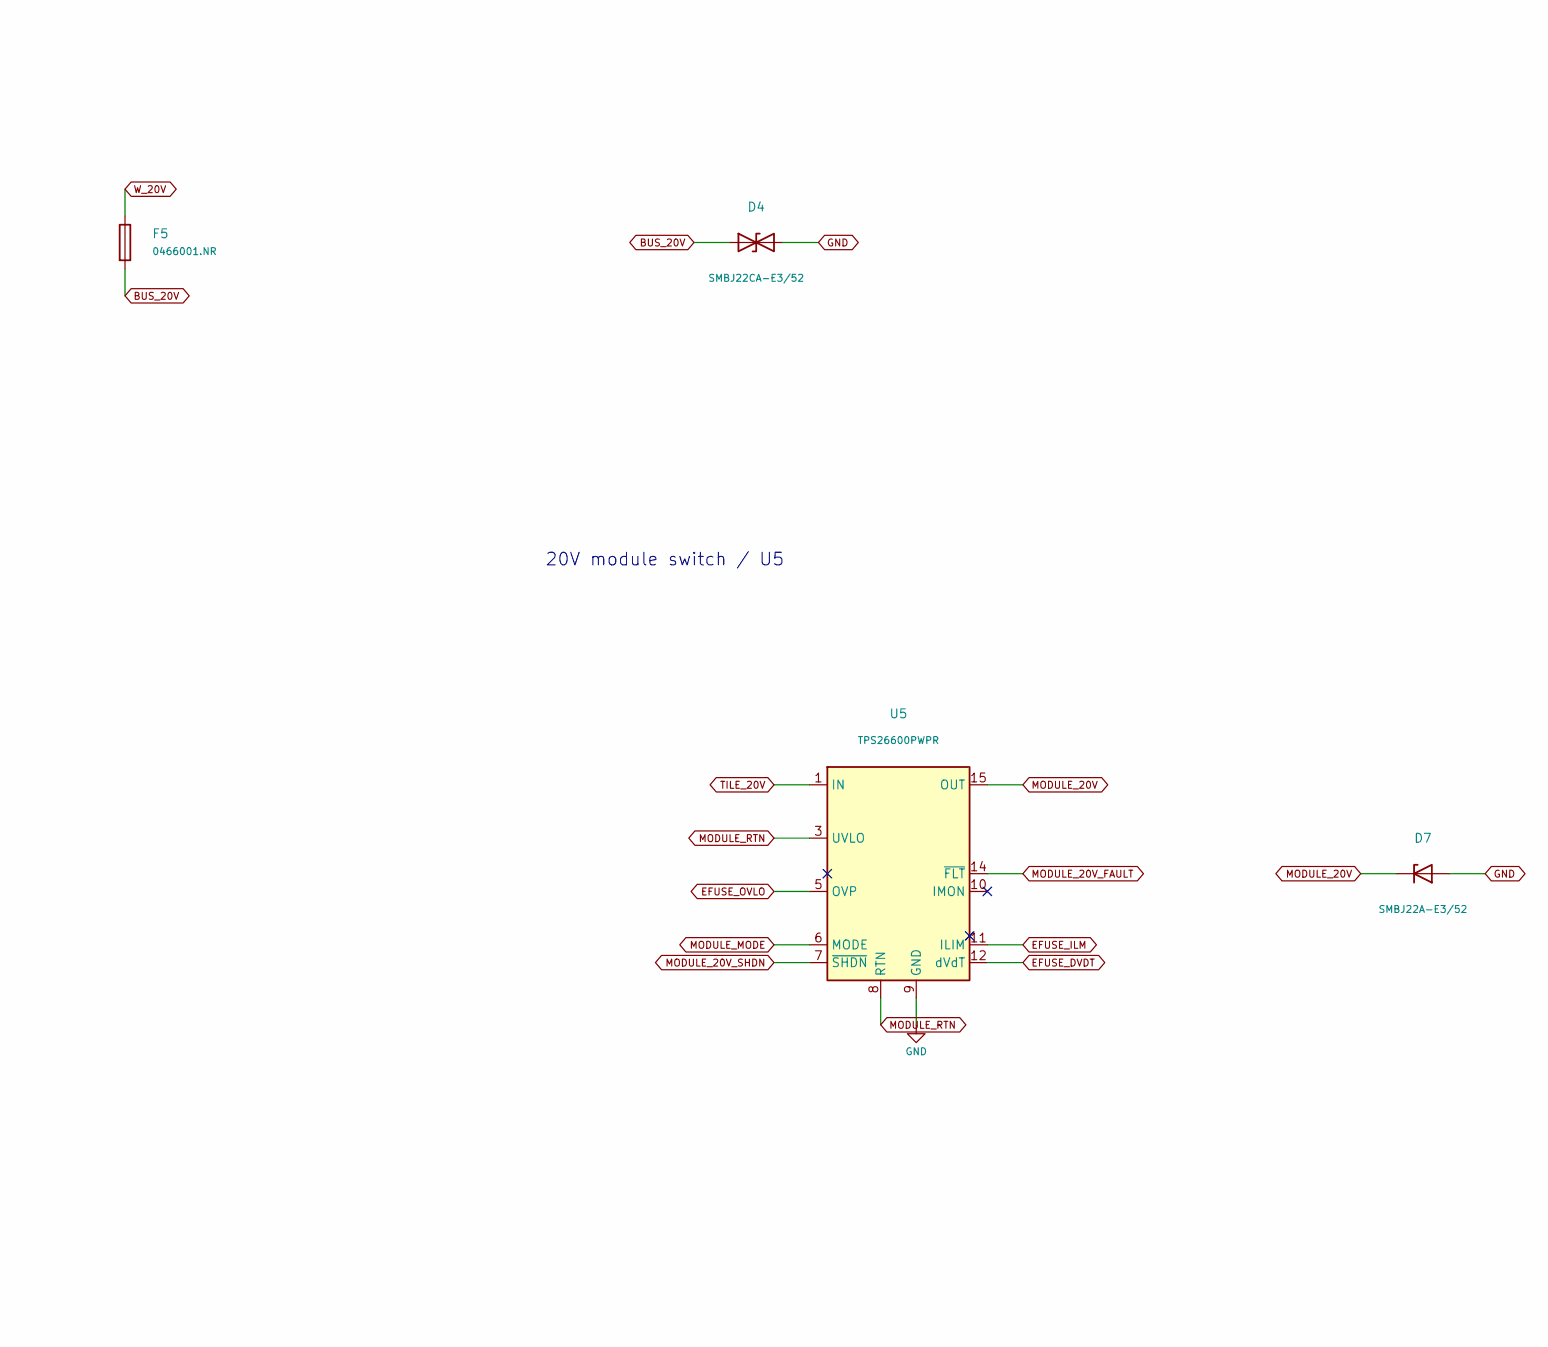
[picture p58: schematic power-protection.kicad_sch, 20V protection, part in row 1, column 2]

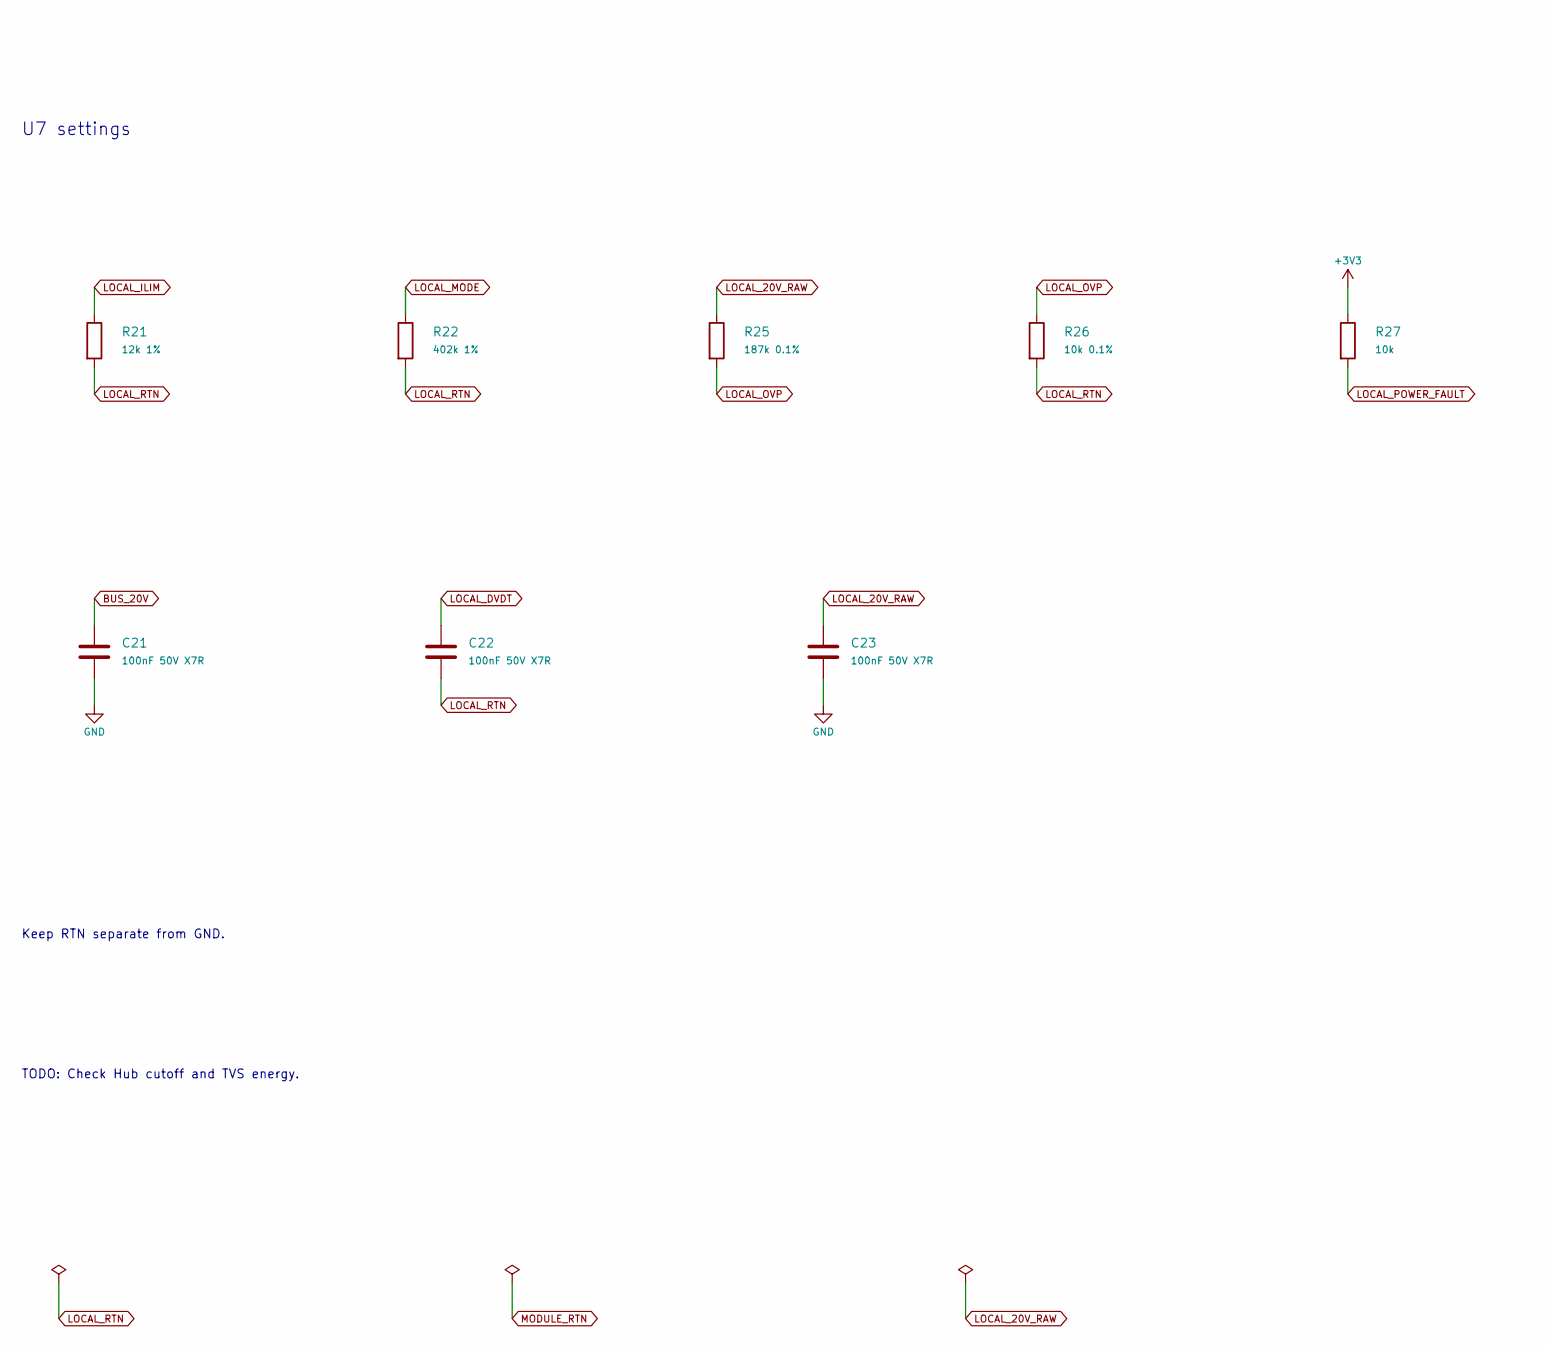
[picture p59: schematic power-protection.kicad_sch, 20V protection, part in row 2, column 1]

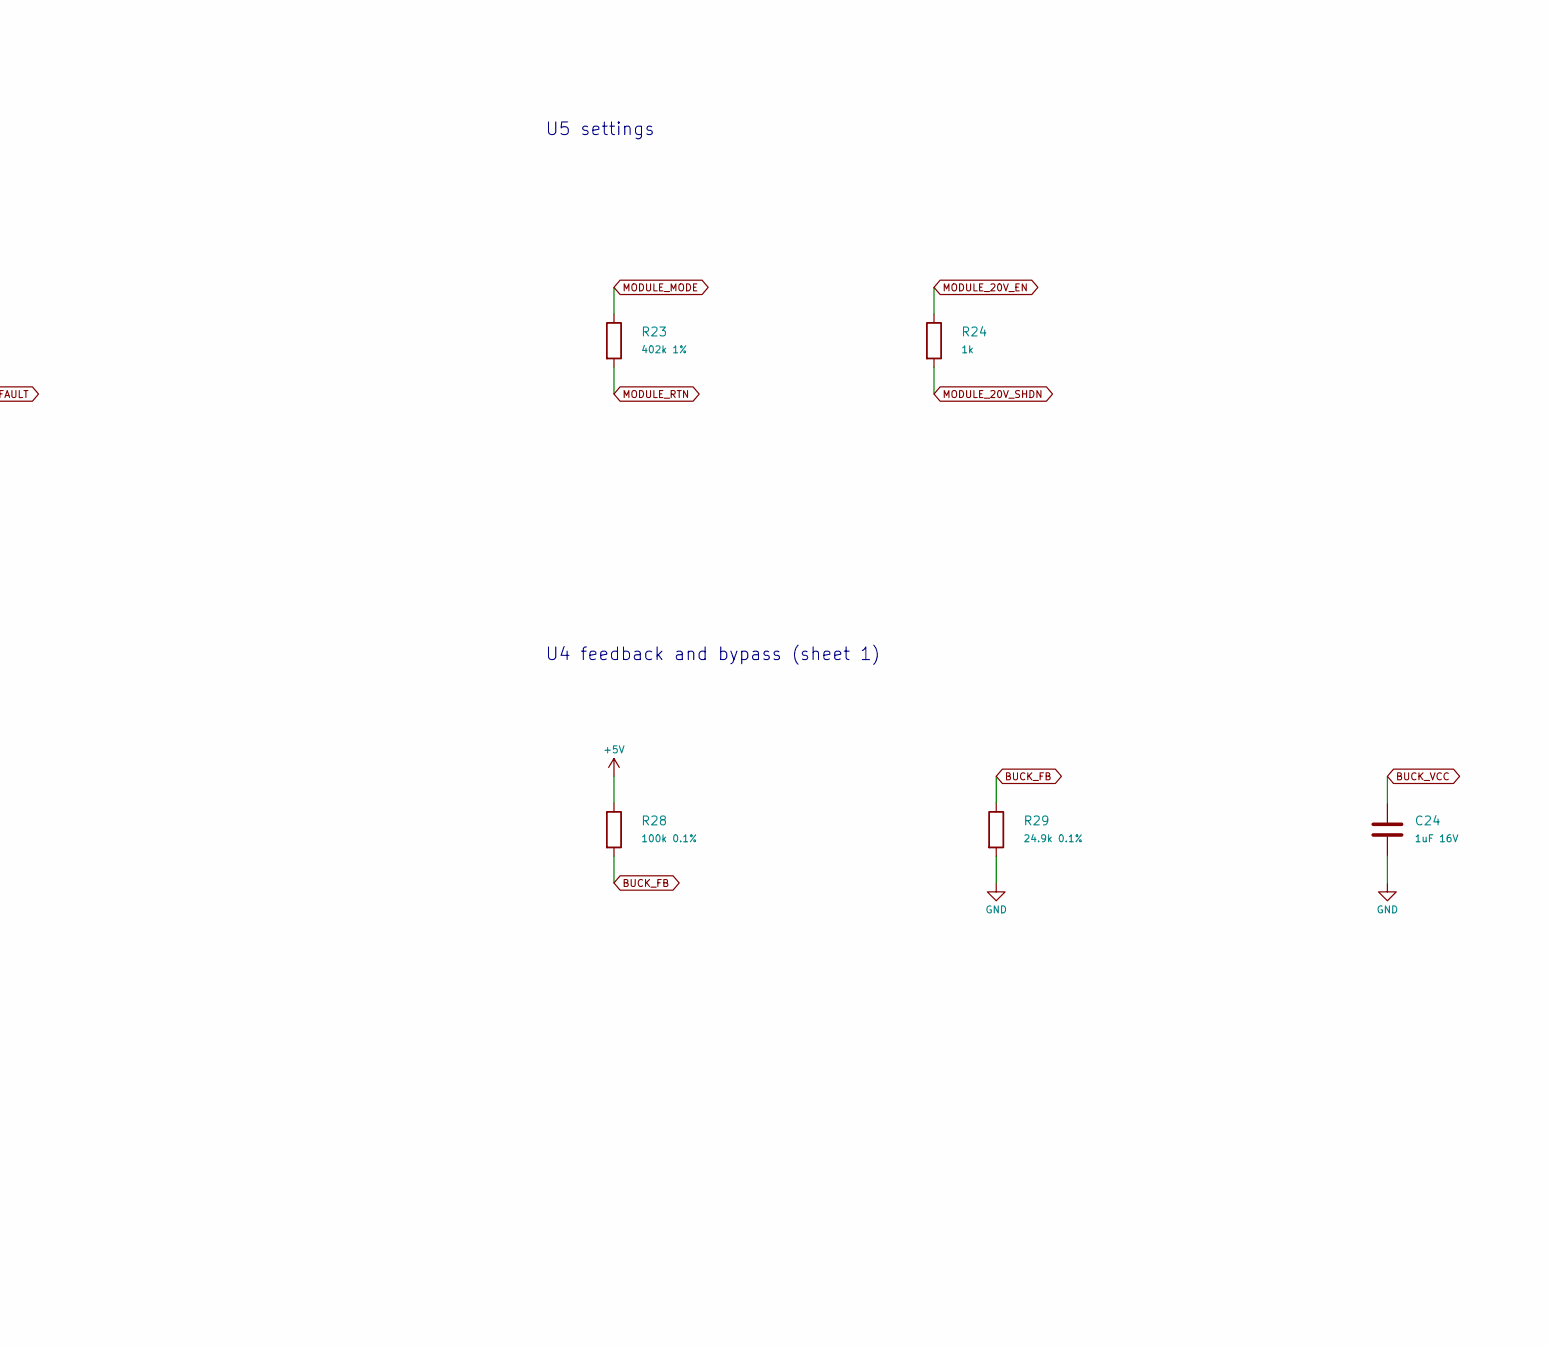
[picture p60: schematic power-protection.kicad_sch, 20V protection, part in row 2, column 2]

Parts:
C21, C22, C23: 100nF 50V X7R; C_0805_2012Metric; MPN C2012X7R1H104K125AE
C24: 1uF 16V; C_0805_2012Metric; MPN C2012X7R1H105K125AB
D4, D5: SMBJ22CA-E3/52; D_SMB
D6, D7: SMBJ22A-E3/52; D_SMB
F1, F2, F3, F4, F5: 0466001.NR; Fuse_1206_3216Metric
R21: 12k 1%; R_0805_2012Metric; MPN RC0805FR-0712KL
R22, R23: 402k 1%; R_0805_2012Metric; MPN RC0805FR-07402KL
R24: 1k; R_0805_2012Metric; MPN RC0805FR-071KL
R25: 187k 0.1%; R_0805_2012Metric; MPN RT0805BRD07187KL
R26: 10k 0.1%; R_0805_2012Metric; MPN RT0805BRD0710KL
R27: 10k; R_0805_2012Metric; MPN RC0805FR-0710KL
R28: 100k 0.1%; R_0805_2012Metric; MPN RT0805BRD07100KL
R29: 24.9k 0.1%; R_0805_2012Metric; MPN RT0805BRD0724K9L
U5, U7: TPS26600PWPR; TI_PWP0016A_Mask3.3x3.3

Connections:
+3V3: R27.1; also elsewhere on the board
+5V: R28.1; also elsewhere on the board
BUCK_FB: R28.2, R29.1; also elsewhere on the board
BUCK_VCC: C24.1; also elsewhere on the board
BUS_20V: C21.1, D4.1 (A1), F1.1, F2.2, F3.2, F4.2, F5.2; also elsewhere on the board
EFUSE_DVDT: U5.12 (dVdT); also elsewhere on the board
EFUSE_ILM: U5.11 (ILIM); also elsewhere on the board
EFUSE_OVLO: U5.5 (OVP); also elsewhere on the board
E_20V: F3.1
GND: C21.2, C23.2, C24.2, D4.2 (A2), D5.2 (A2), D6.2 (A), D7.2 (A), R29.2, U5.9 (GND), U7.9 (GND); also elsewhere on the board
LOCAL_20V_RAW: C23.1, D5.1 (A1), F1.2, R25.1, U7.1 (IN), U7.2 (IN)
LOCAL_DVDT: C22.1, U7.12 (dVdT)
LOCAL_ILIM: R21.1, U7.11 (ILIM)
LOCAL_MODE: R22.1, U7.6 (MODE)
LOCAL_OVP: R25.2, R26.1, U7.5 (OVP)
LOCAL_POWER_FAULT: R27.2, U7.14 (~FLT); also elsewhere on the board
LOCAL_RTN: C22.2, R21.2, R22.2, R26.2, U7.3 (UVLO), U7.8 (RTN), U7.17 (RTN)
MODULE_20V: D7.1 (K), U5.15 (OUT), U5.16 (OUT); also elsewhere on the board
MODULE_20V_EN: R24.1; also elsewhere on the board
MODULE_20V_FAULT: U5.14 (~FLT); also elsewhere on the board
MODULE_20V_SHDN: R24.2, U5.7 (~SHDN); also elsewhere on the board
MODULE_MODE: R23.1, U5.6 (MODE)
MODULE_RTN: R23.2, U5.3 (UVLO), U5.8 (RTN), U5.17 (RTN); also elsewhere on the board
N_20V: F2.1
S_20V: F4.1
TILE_20V: D6.1 (K), U5.1 (IN), U5.2 (IN), U7.15 (OUT), U7.16 (OUT); also elsewhere on the board
W_20V: F5.1

Notes on the sheet:
Edge fuses
Local supply / U7
20V module switch / U5
U7 settings
U5 settings
U4 feedback and bypass (sheet 1)
Keep RTN separate from GND.
TODO: Check Hub cutoff and TVS energy.

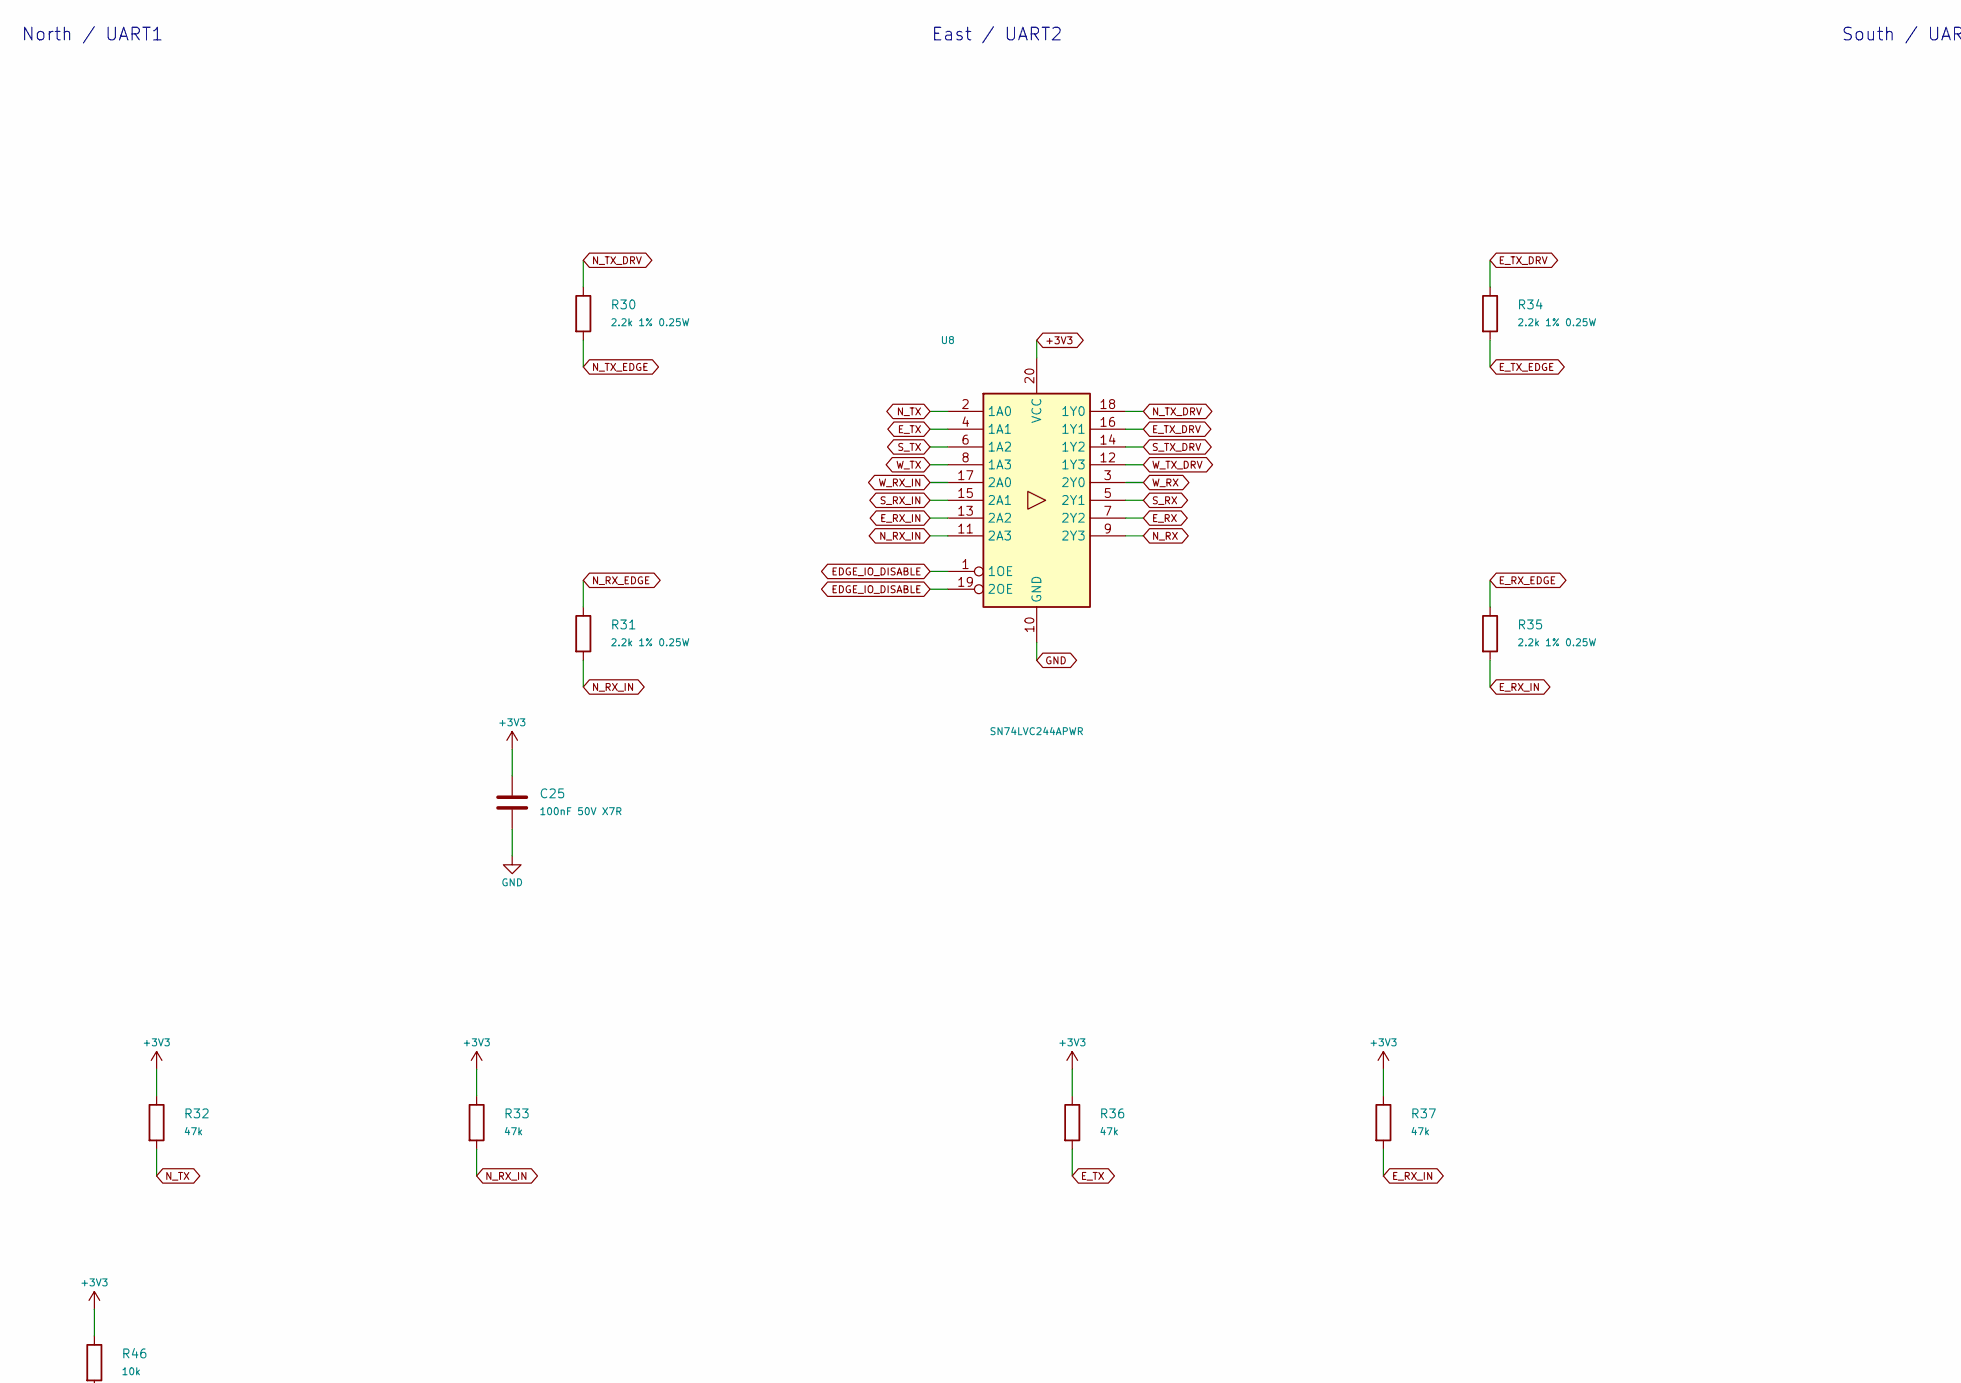
[picture p61: schematic signal-isolation.kicad_sch, Signal buffers, part in row 1, column 1]

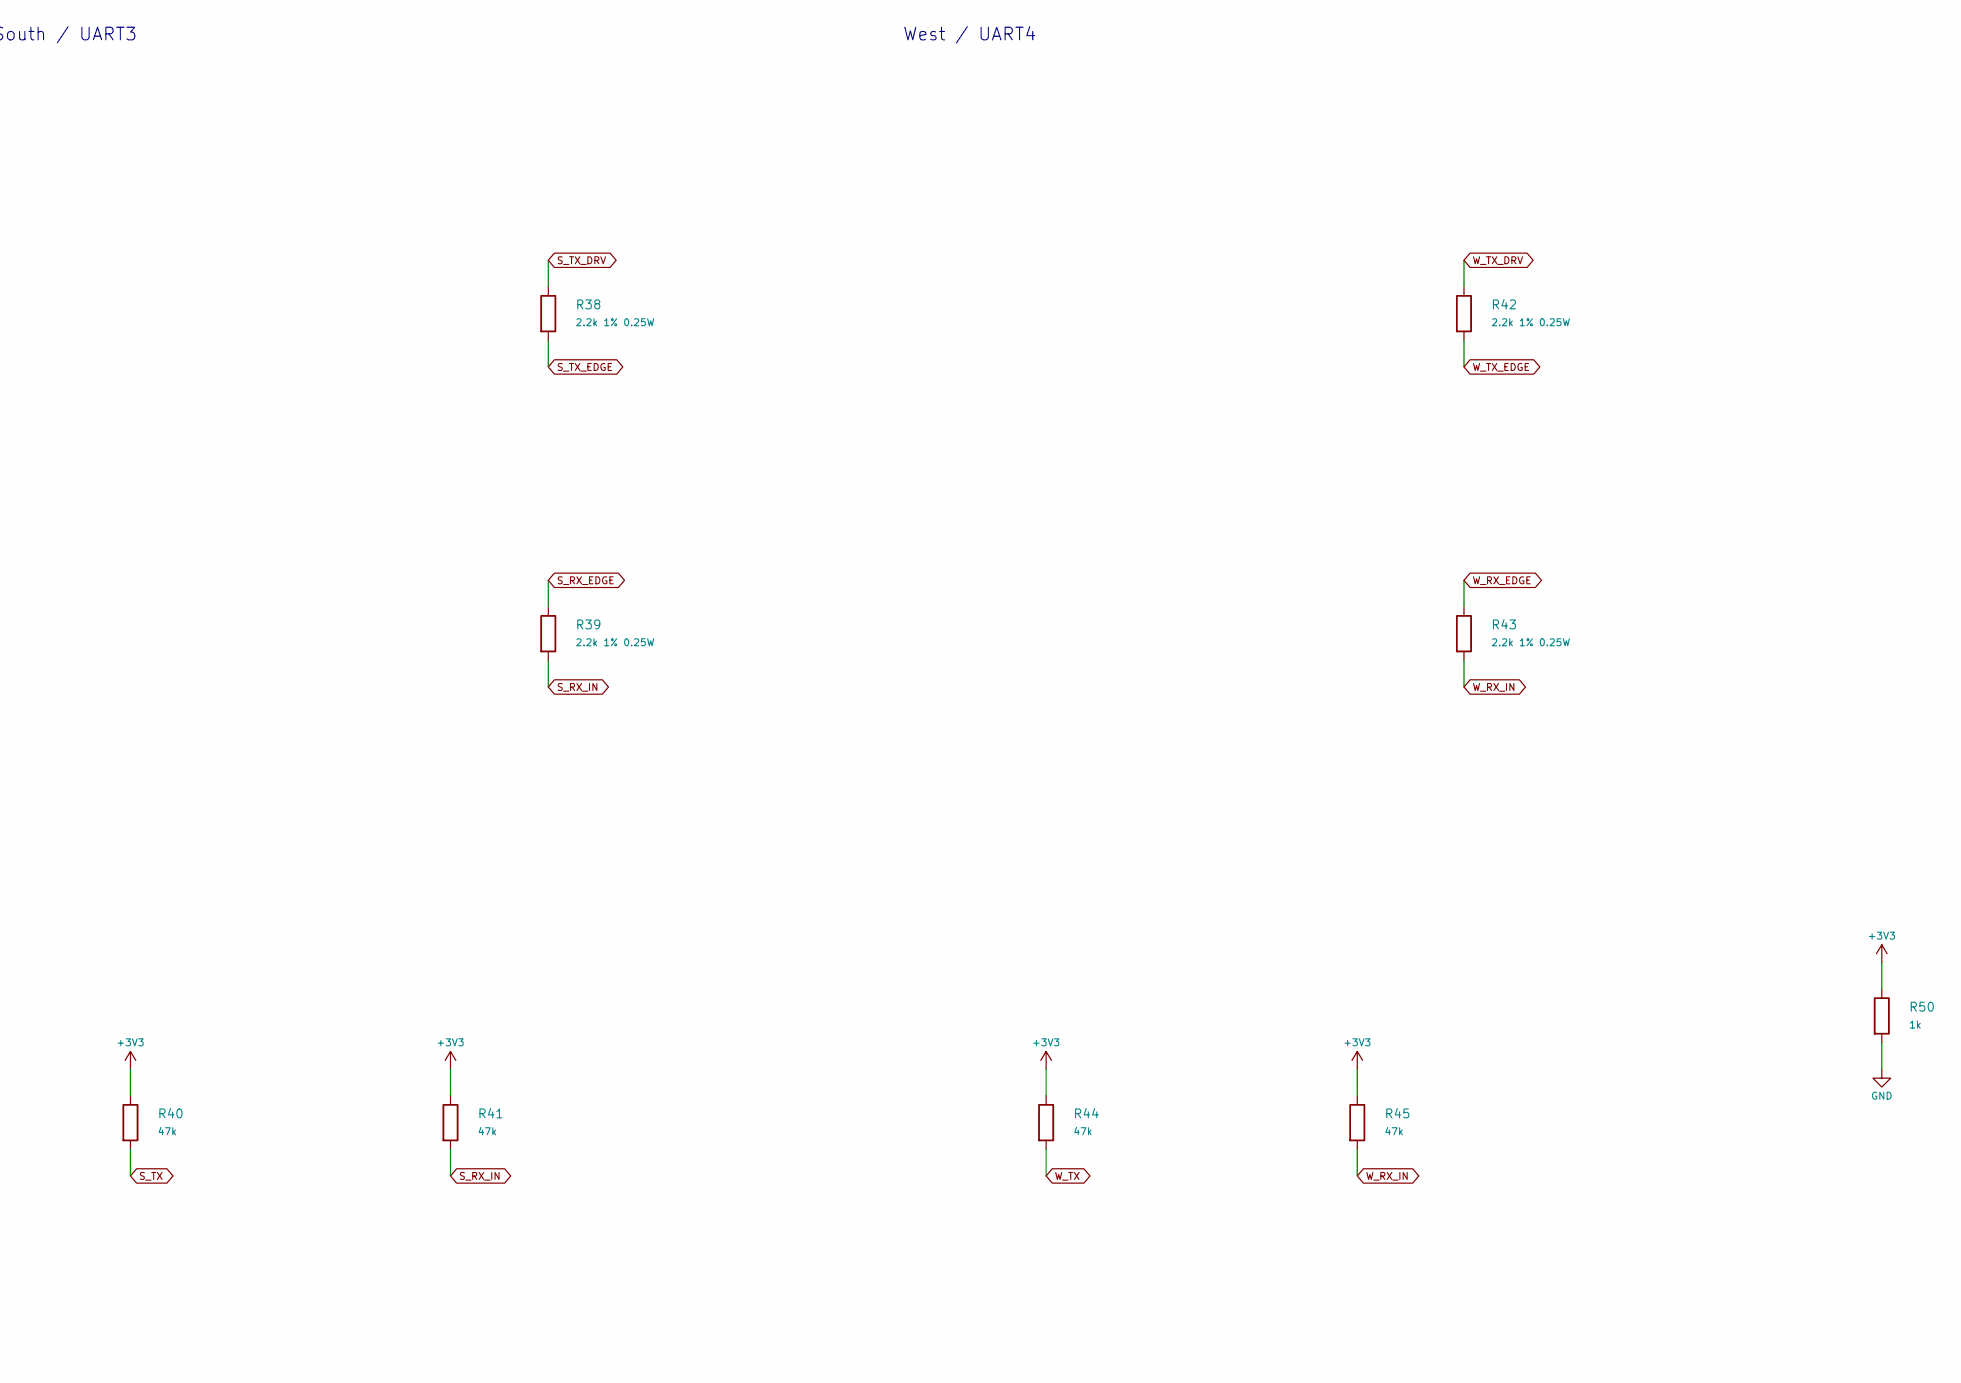
[picture p62: schematic signal-isolation.kicad_sch, Signal buffers, part in row 1, column 2]

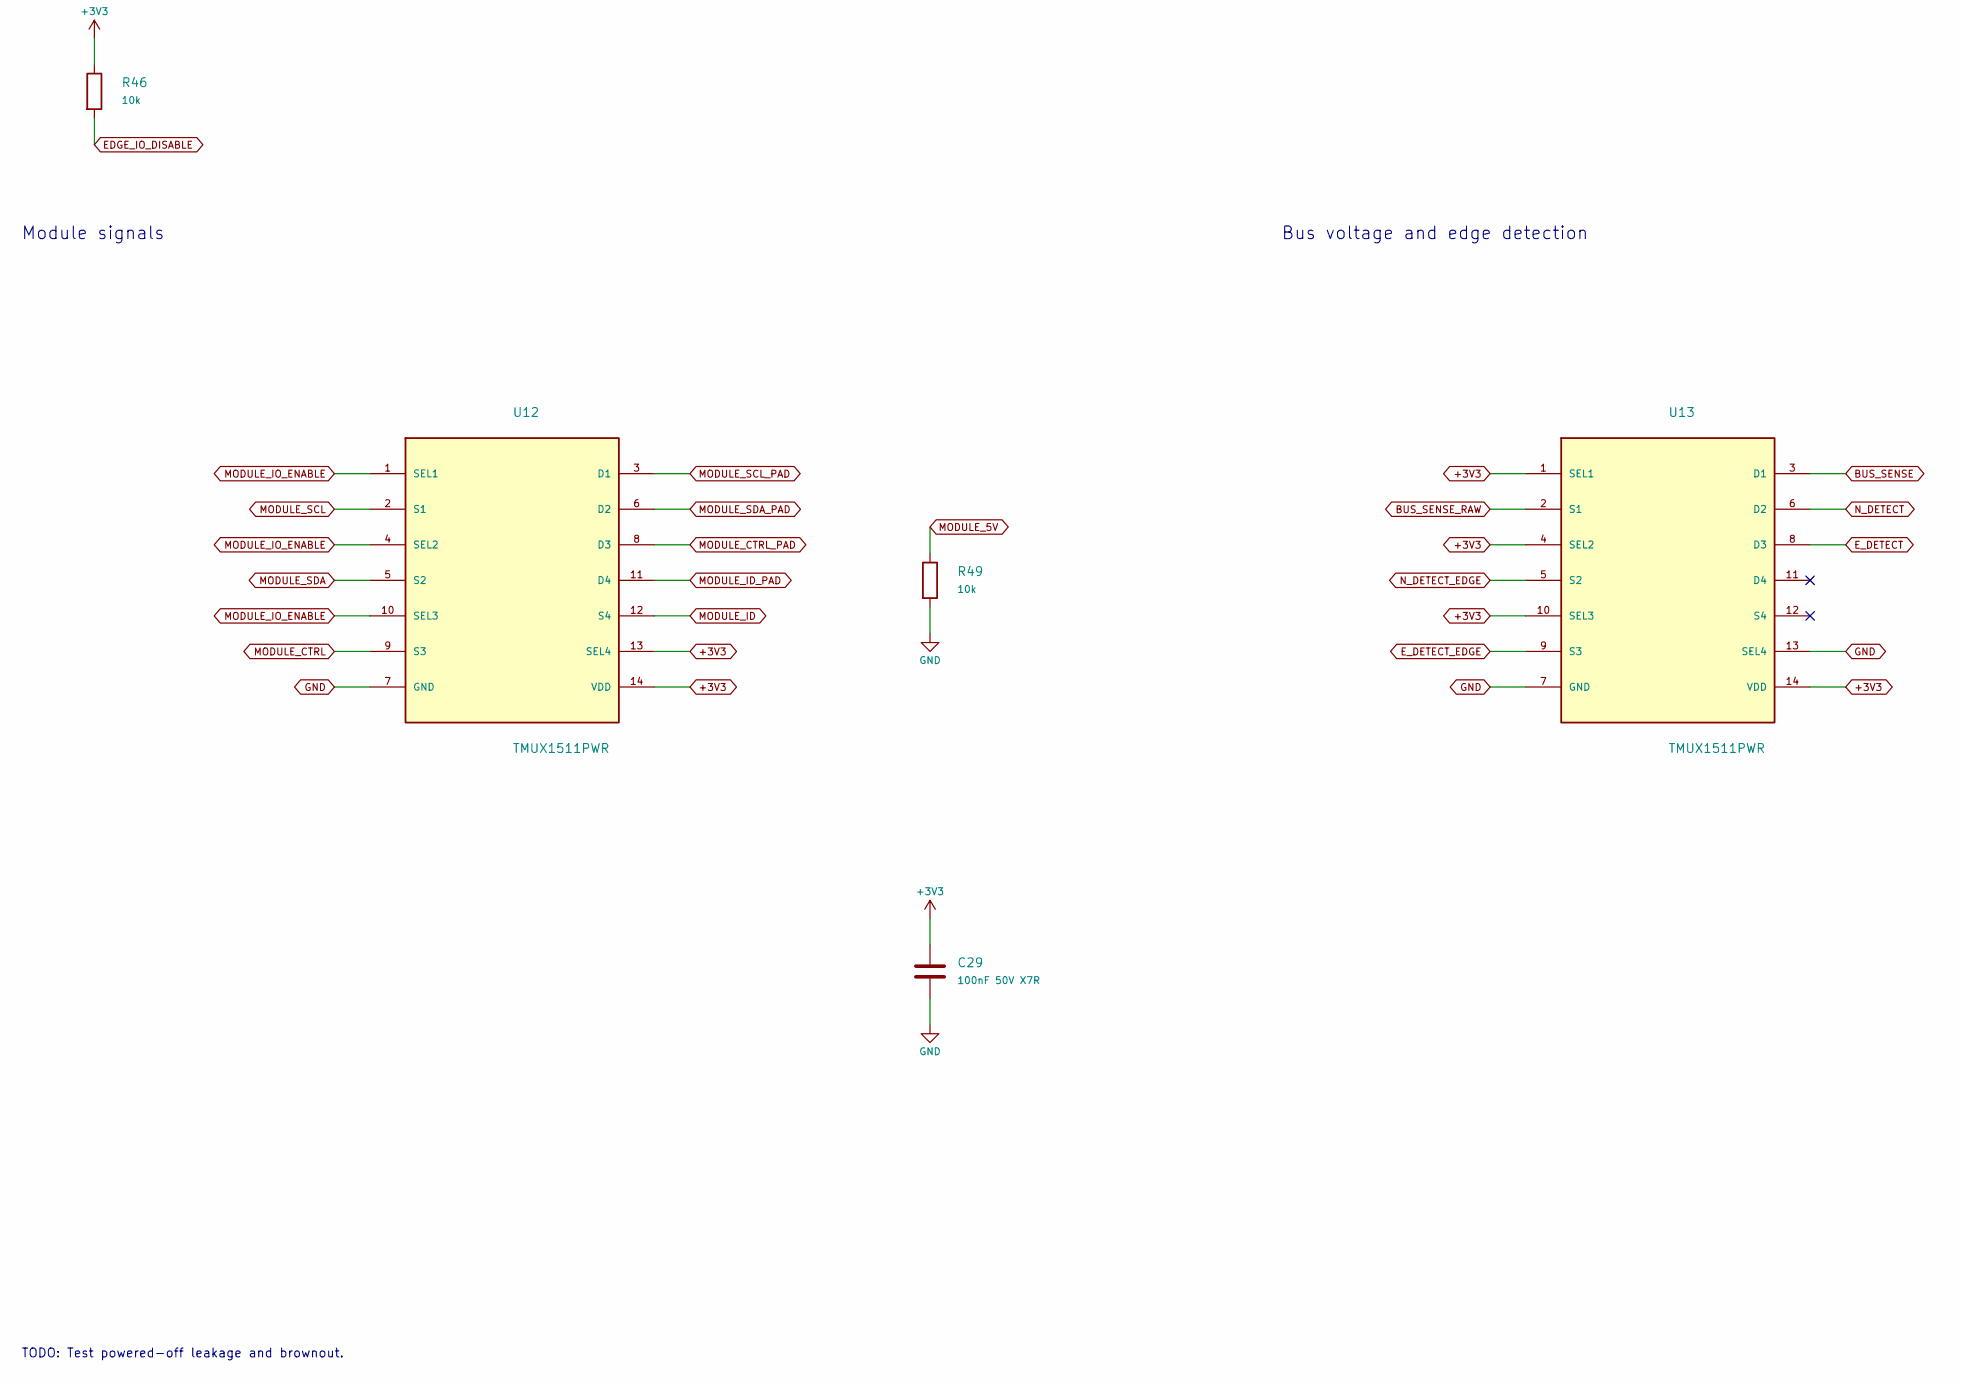
[picture p63: schematic signal-isolation.kicad_sch, Signal buffers, part in row 2, column 1]

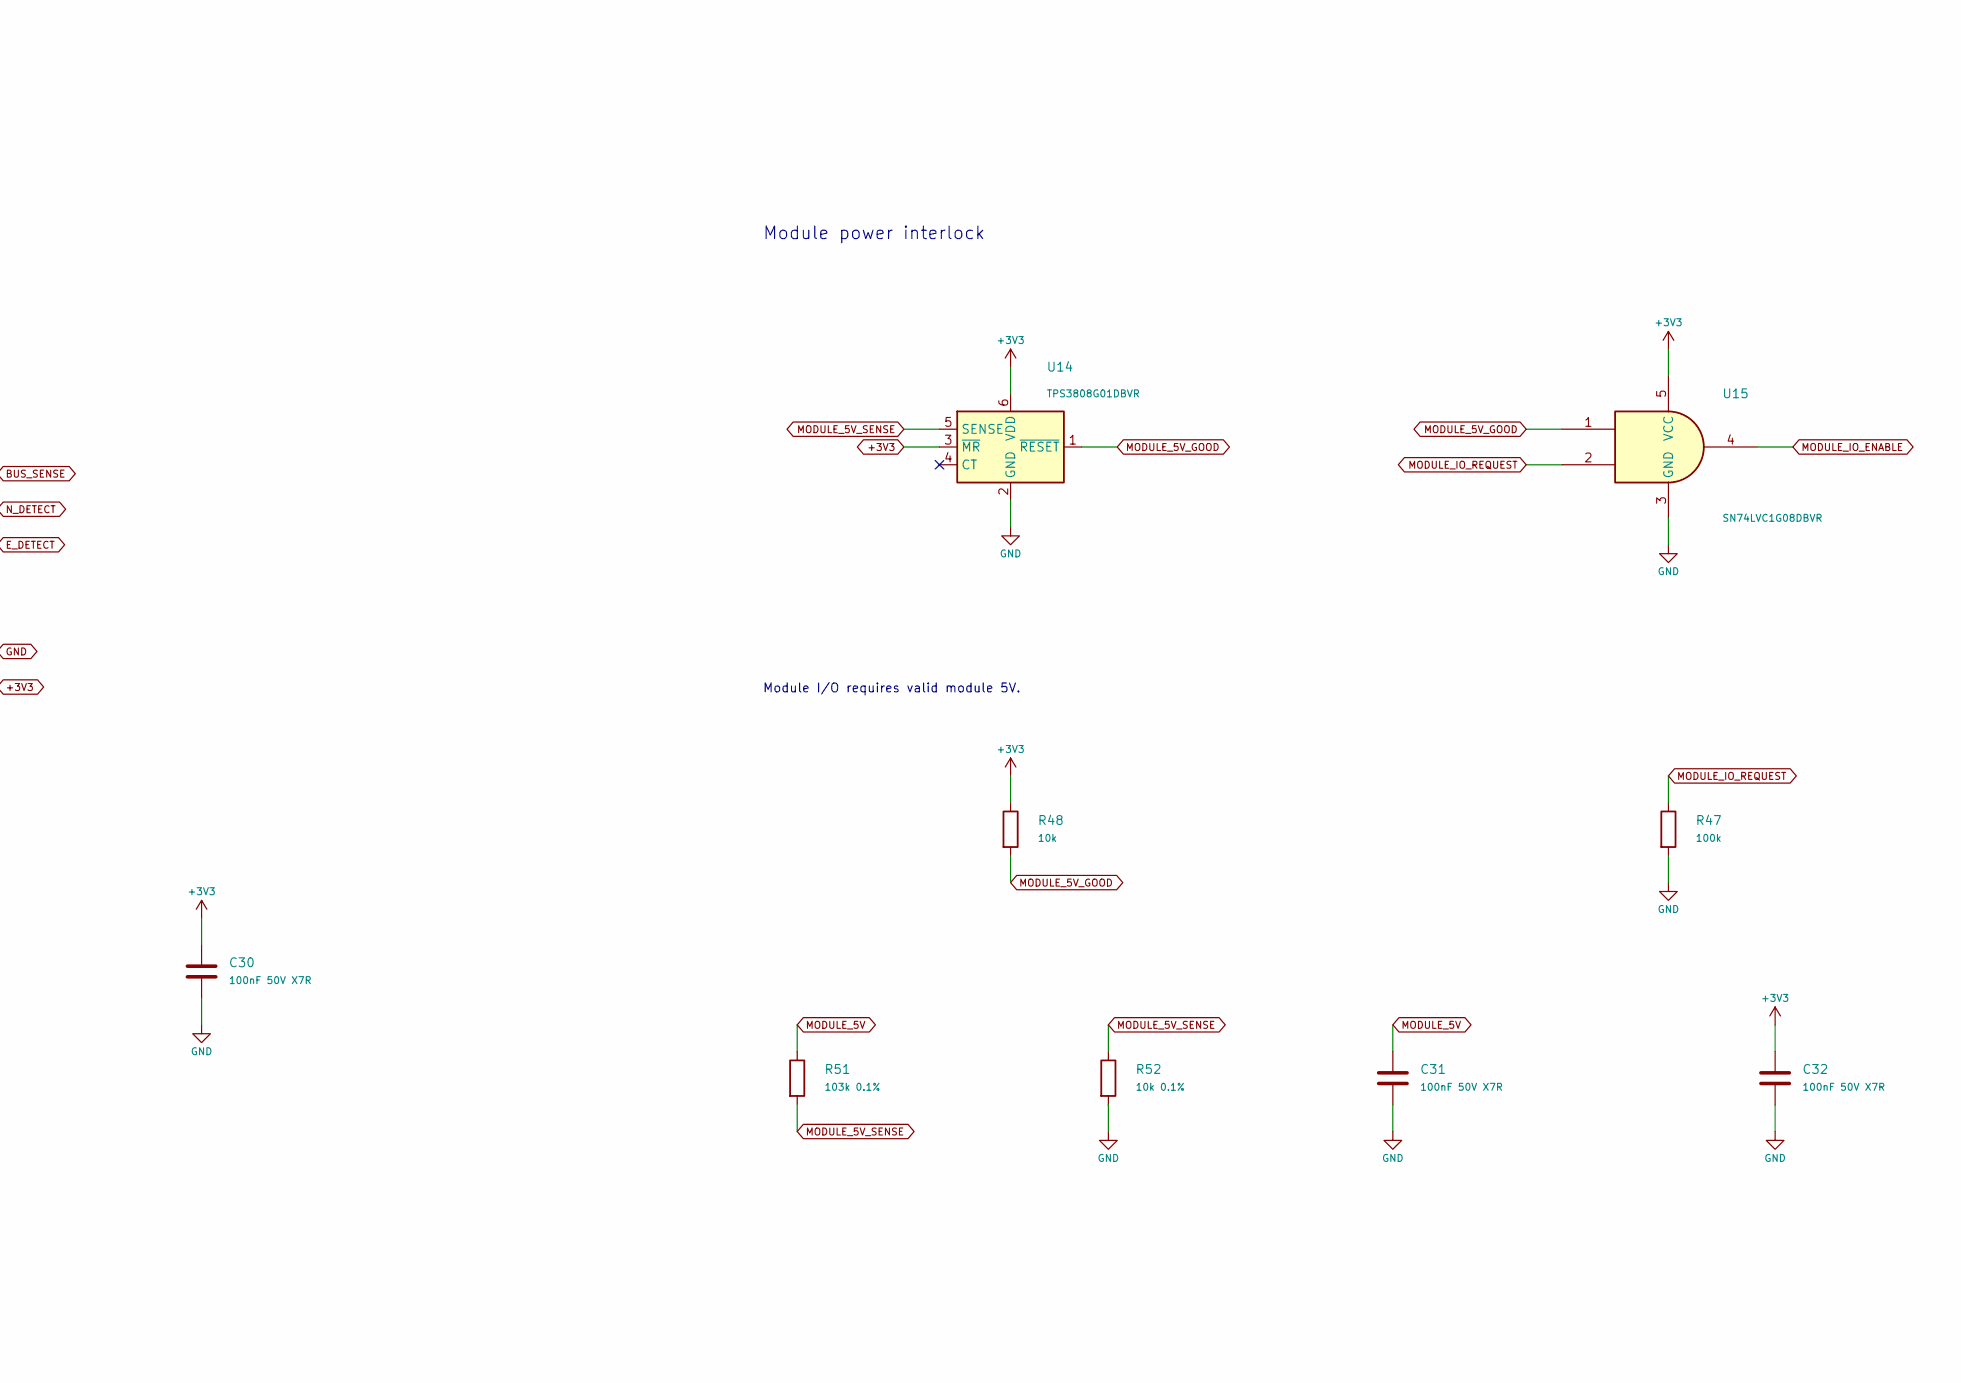
[picture p64: schematic signal-isolation.kicad_sch, Signal buffers, part in row 2, column 2]

Parts:
C25, C29, C30, C31, C32: 100nF 50V X7R; C_0805_2012Metric; MPN C2012X7R1H104K125AE
R30, R31, R34, R35, R38, R39, R42, R43: 2.2k 1% 0.25W; R_1206_3216Metric; MPN RC1206FR-072K2L
R32, R33, R36, R37, R40, R41, R44, R45: 47k; R_0805_2012Metric; MPN RC0805FR-0747KL
R46, R48, R49: 10k; R_0805_2012Metric; MPN RC0805FR-0710KL
R47: 100k; R_0805_2012Metric; MPN RC0805FR-07100KL
R50: 1k; R_0805_2012Metric; MPN RC0805FR-071KL
R51: 103k 0.1%; R_0805_2012Metric; MPN RT0805BRD07103KL
R52: 10k 0.1%; R_0805_2012Metric; MPN RT0805BRD0710KL
U8: SN74LVC244APWR; TSSOP-20_4.4x6.5mm_P0.65mm; MPN SN74LVC244APWR
U12, U13: TMUX1511PWR; TSSOP-14_4.4x5mm_P0.65mm
U14: TPS3808G01DBVR; SOT-23-6
U15: SN74LVC1G08DBVR; SOT-23-5

Connections:
+3V3: C25.1, C29.1, C30.1, C32.1, R32.1, R33.1, R36.1, R37.1, R40.1, R41.1, R44.1, R45.1, R46.1, R48.1, R50.1, U8.20 (VCC), U12.13 (SEL4), U12.14 (VDD), U13.1 (SEL1), U13.4 (SEL2), U13.10 (SEL3), U13.14 (VDD), U14.3 (~MR), U14.6 (VDD), U15.5 (VCC); also elsewhere on the board
BUS_SENSE: U13.3 (D1); also elsewhere on the board
BUS_SENSE_RAW: U13.2 (S1); also elsewhere on the board
EDGE_IO_DISABLE: R46.2, U8.1 (1OE), U8.19 (2OE); also elsewhere on the board
E_DETECT: U13.8 (D3); also elsewhere on the board
E_DETECT_EDGE: U13.9 (S3); also elsewhere on the board
E_RX: U8.7 (2Y2); also elsewhere on the board
E_RX_EDGE: R35.1
E_RX_IN: R35.2, R37.2, U8.13 (2A2)
E_TX: R36.2, U8.4 (1A1); also elsewhere on the board
E_TX_DRV: R34.1, U8.16 (1Y1)
E_TX_EDGE: R34.2
GND: C25.2, C29.2, C30.2, C31.2, C32.2, R47.2, R49.2, R50.2, R52.2, U8.10 (GND), U12.7 (GND), U13.7 (GND), U13.13 (SEL4), U14.2 (GND), U15.3 (GND); also elsewhere on the board
MODULE_5V: C31.1, R49.1, R51.1; also elsewhere on the board
MODULE_5V_GOOD: R48.2, U14.1 (~RESET), U15.1
MODULE_5V_SENSE: R51.2, R52.1, U14.5 (SENSE)
MODULE_CTRL: U12.9 (S3); also elsewhere on the board
MODULE_CTRL_PAD: U12.8 (D3)
MODULE_ID: U12.12 (S4); also elsewhere on the board
MODULE_ID_PAD: U12.11 (D4)
MODULE_IO_ENABLE: U12.1 (SEL1), U12.4 (SEL2), U12.10 (SEL3), U15.4
MODULE_IO_REQUEST: R47.1, U15.2; also elsewhere on the board
MODULE_SCL: U12.2 (S1); also elsewhere on the board
MODULE_SCL_PAD: U12.3 (D1)
MODULE_SDA: U12.5 (S2); also elsewhere on the board
MODULE_SDA_PAD: U12.6 (D2)
N_DETECT: U13.6 (D2); also elsewhere on the board
N_DETECT_EDGE: U13.5 (S2); also elsewhere on the board
N_RX: U8.9 (2Y3); also elsewhere on the board
N_RX_EDGE: R31.1
N_RX_IN: R31.2, R33.2, U8.11 (2A3)
N_TX: R32.2, U8.2 (1A0); also elsewhere on the board
N_TX_DRV: R30.1, U8.18 (1Y0)
N_TX_EDGE: R30.2
S_RX: U8.5 (2Y1); also elsewhere on the board
S_RX_EDGE: R39.1
S_RX_IN: R39.2, R41.2, U8.15 (2A1)
S_TX: R40.2, U8.6 (1A2); also elsewhere on the board
S_TX_DRV: R38.1, U8.14 (1Y2)
S_TX_EDGE: R38.2
W_RX: U8.3 (2Y0); also elsewhere on the board
W_RX_EDGE: R43.1
W_RX_IN: R43.2, R45.2, U8.17 (2A0)
W_TX: R44.2, U8.8 (1A3); also elsewhere on the board
W_TX_DRV: R42.1, U8.12 (1Y3)
W_TX_EDGE: R42.2

Notes on the sheet:
North / UART1
East / UART2
South / UART3
West / UART4
Module signals
Bus voltage and edge detection
Module power interlock
Module I/O requires valid module 5V.
TODO: Test powered-off leakage and brownout.
