Bruhdows/klink/hardware/electronics/tile/tile.kicad_pcb

## KiCad design hardware/electronics/tile/tile.kicad_pcb (continued)

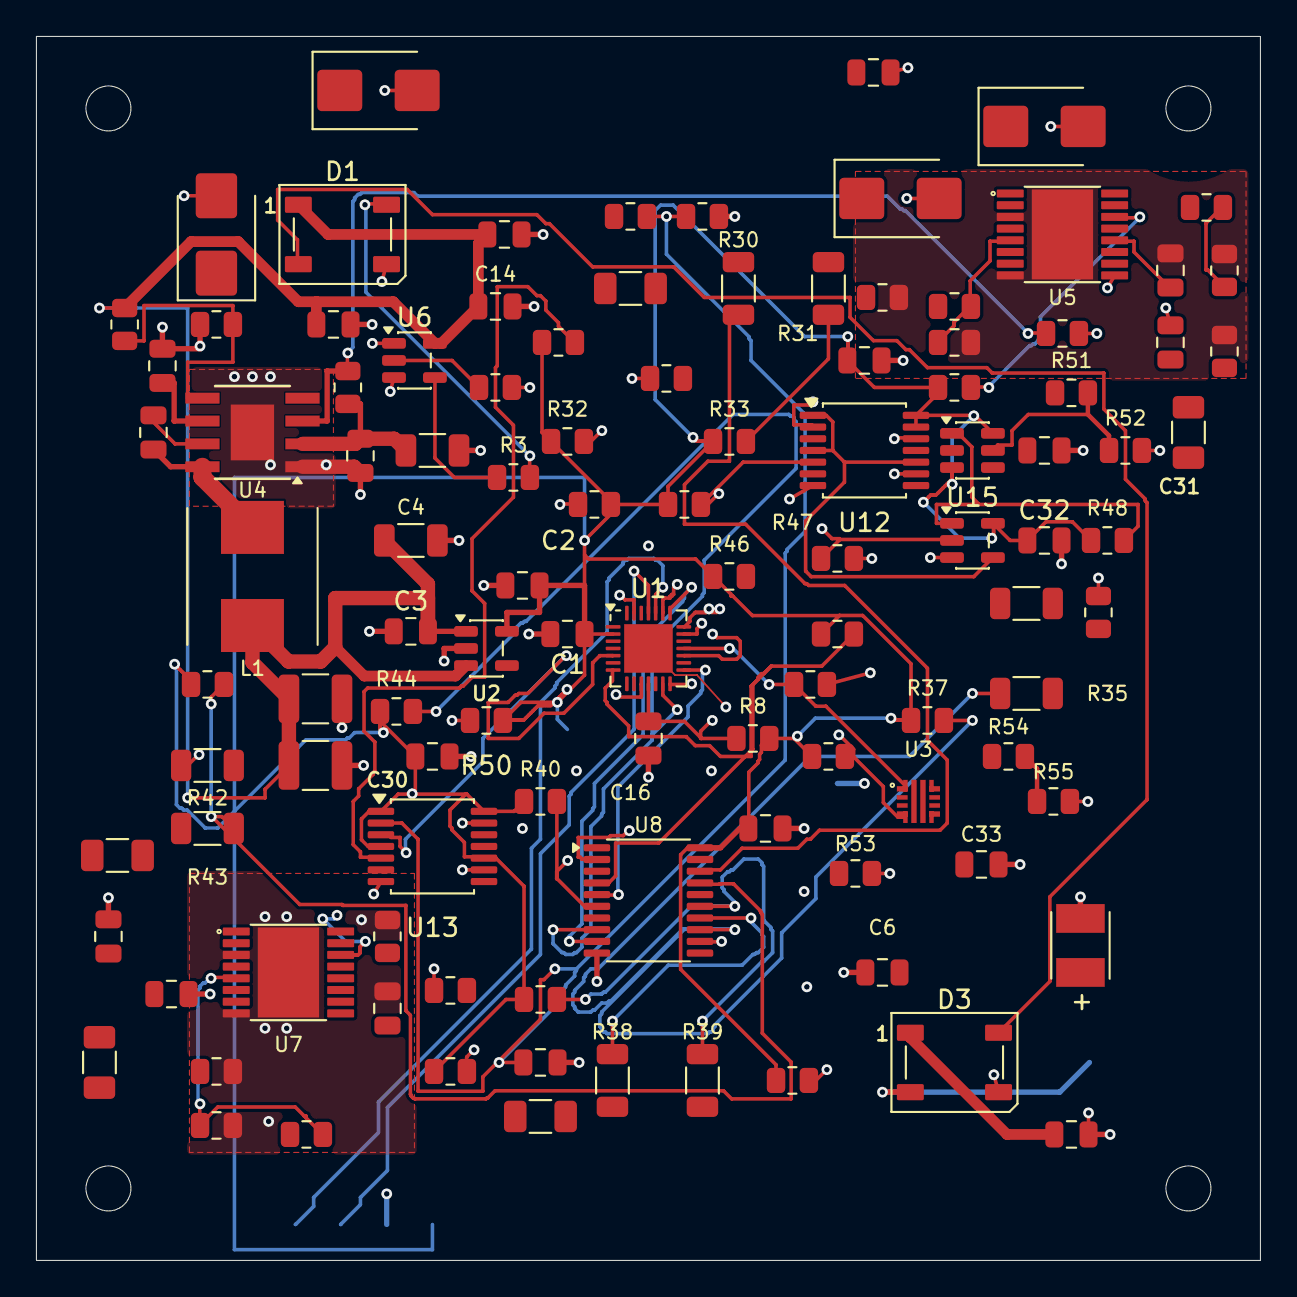
[picture p65: board tile.kicad_pcb from above]

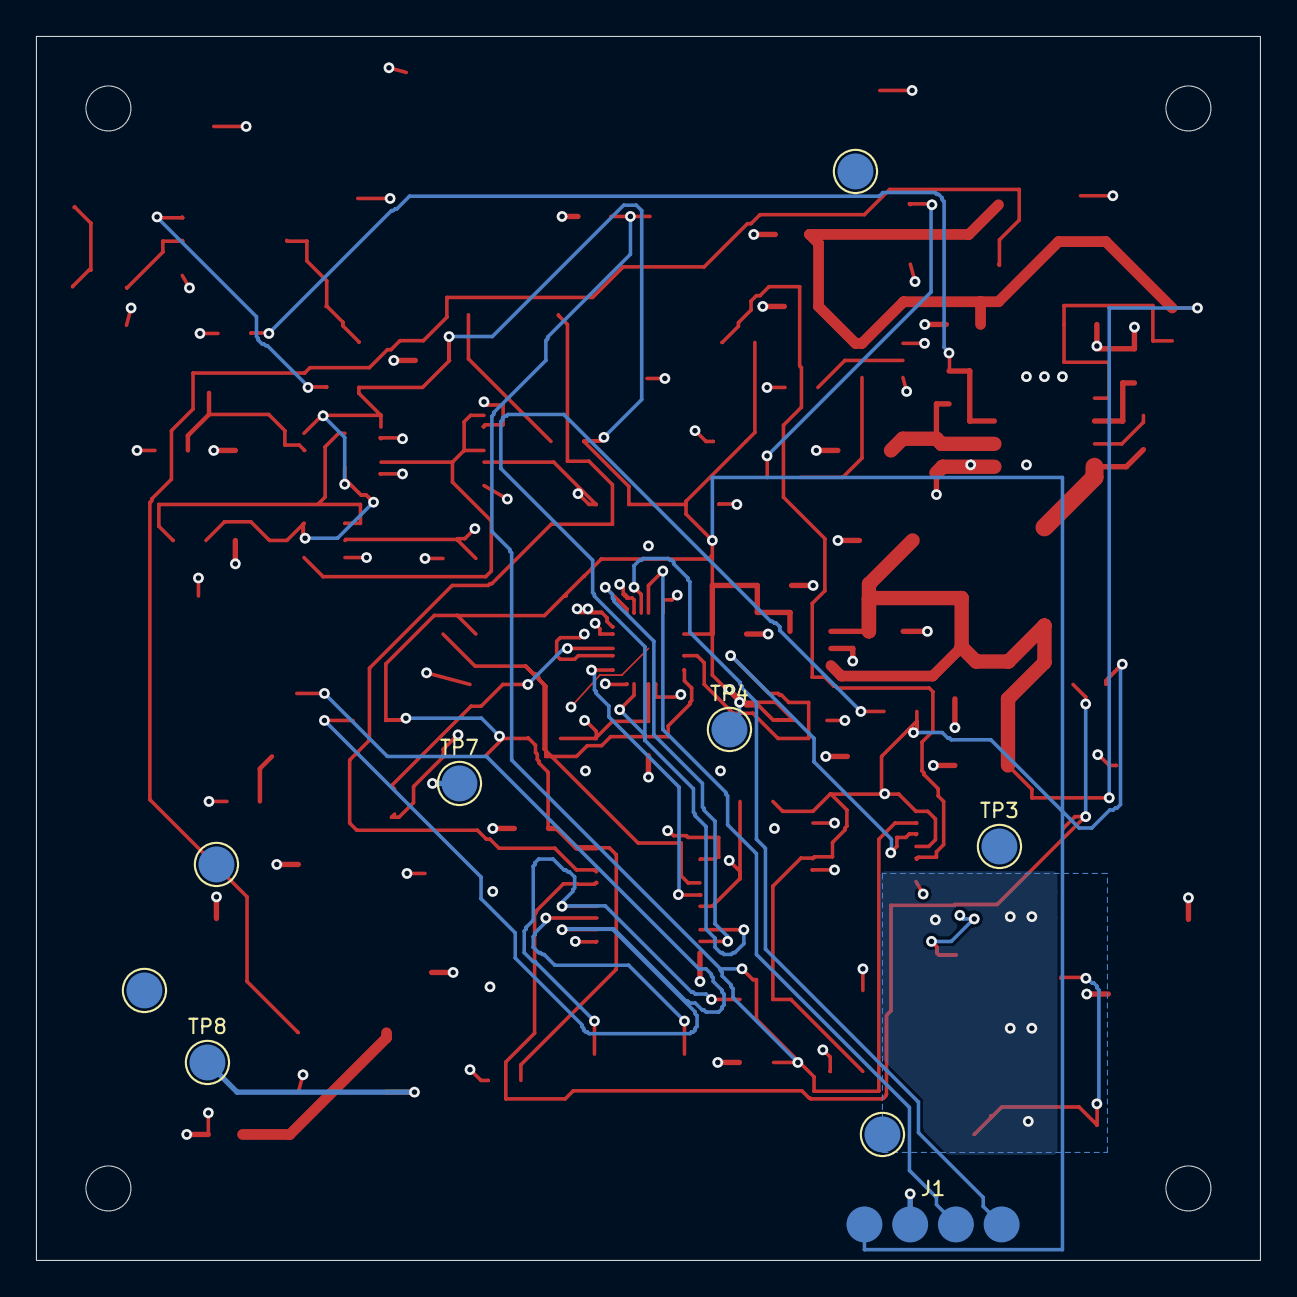
[picture p66: board tile.kicad_pcb from below]

Board: 4 copper layers, 68.0 x 68.0 mm, 122 parts (9 on the bottom side), 70 nets.

Other parts of the board:
H1, H2, H3, H4: MountingHole_2.5mm
