Bruhdows/klink/hardware/electronics/hub/hub.kicad_pcb

## KiCad design hardware/electronics/hub/hub.kicad_pcb (2026-11-09)

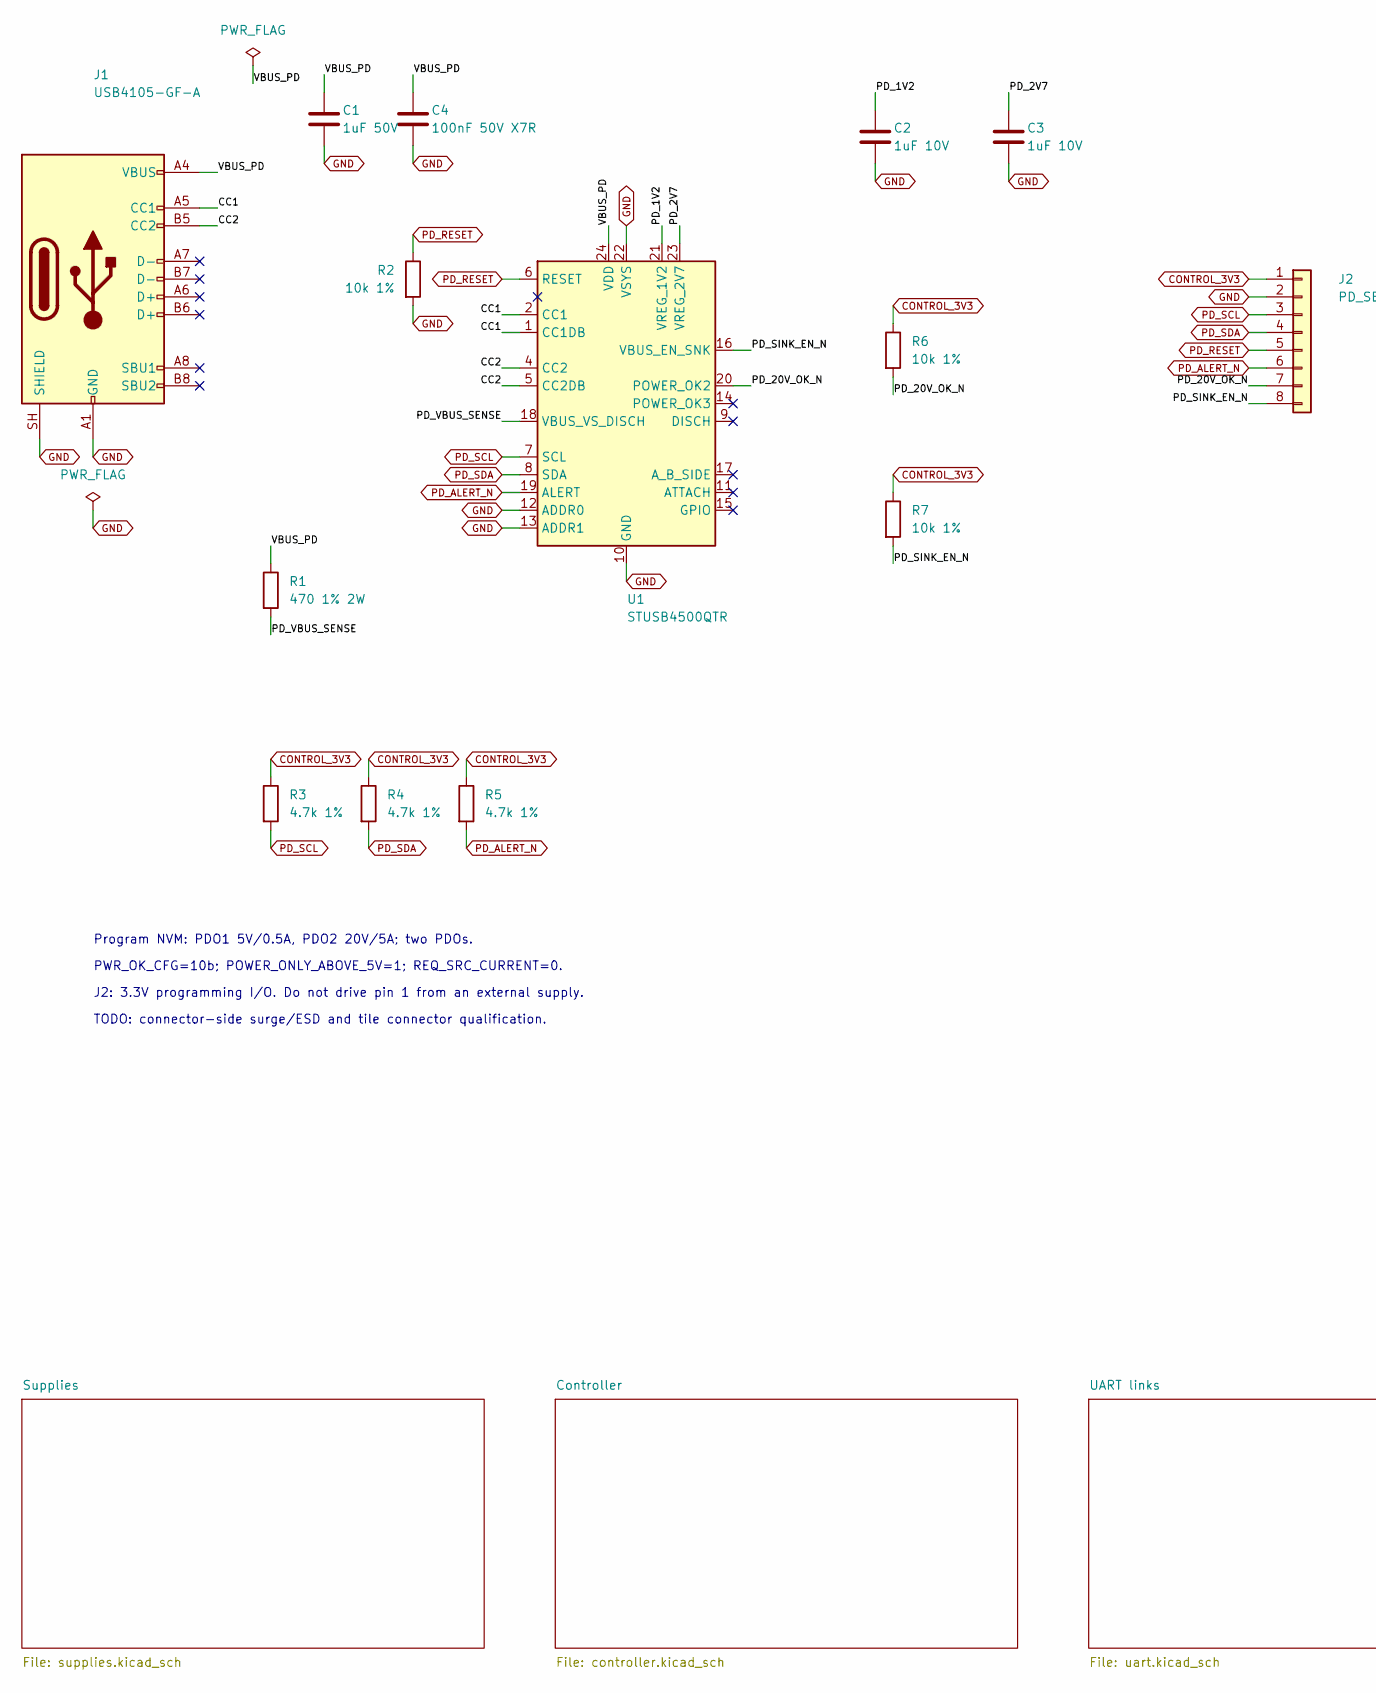
[picture p67: schematic hub.kicad_sch, Klink Hub, part in row 1, column 1]

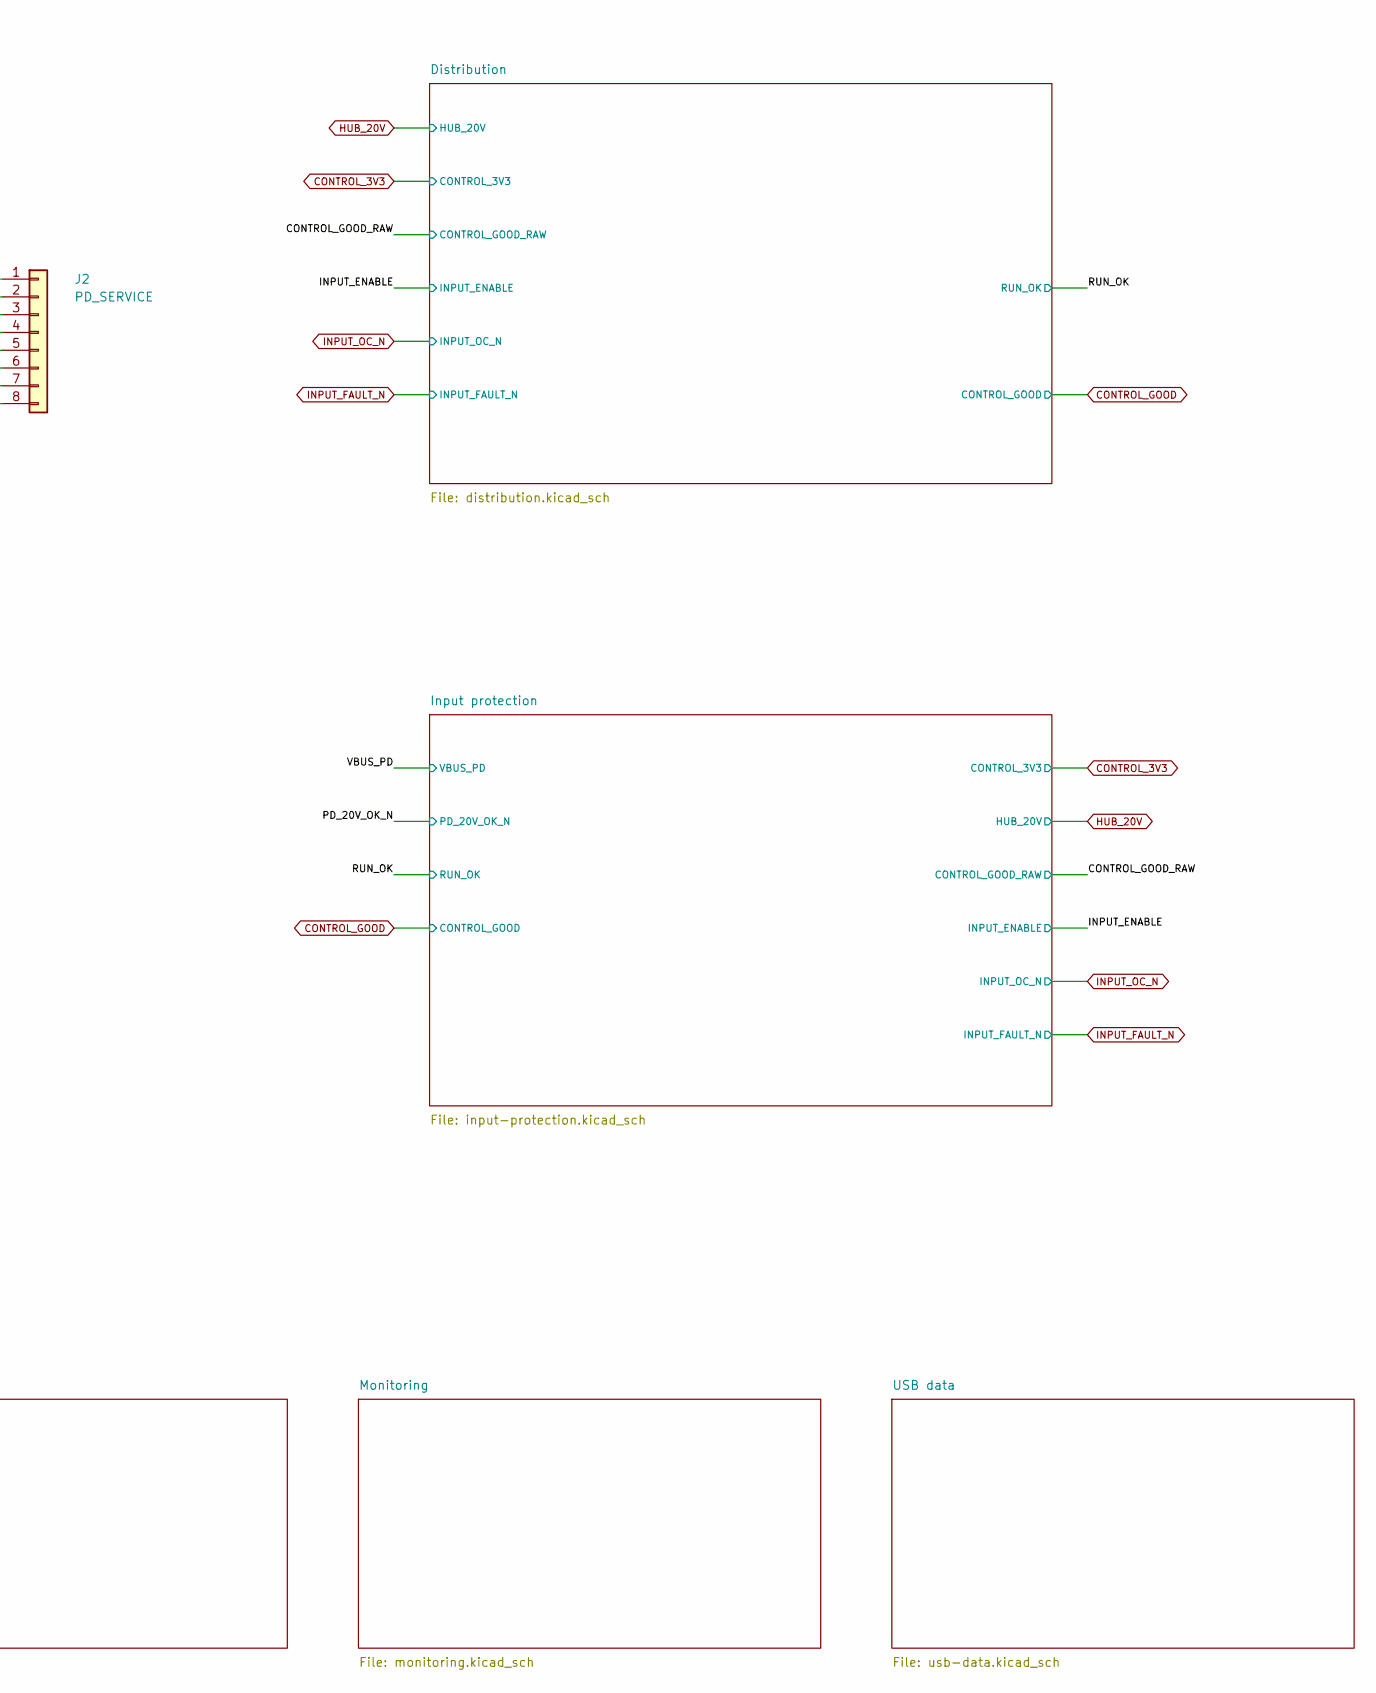
[picture p68: schematic hub.kicad_sch, Klink Hub, part in row 1, column 2]

Parts:
C1: 1uF 50V; C_0805_2012Metric; MPN C2012X7R1H105K125AB
C2, C3: 1uF 10V; C_0805_2012Metric; MPN C2012X7R1H105K125AB
C4: 100nF 50V X7R; C_0805_2012Metric; MPN C2012X7R1H104K125AE
J1: USB4105-GF-A; USB_C_Receptacle_GCT_USB4105_RoundedGround; MPN USB4105-GF-A
J2: PD_SERVICE; PinHeader_1x08_P2.54mm_Vertical; MPN TSW-108-07-G-S
R1: 470 1% 2W; R_2512_6332Metric; MPN RC2512FK-7W470RL
R2, R6, R7: 10k 1%; R_0805_2012Metric; MPN RC0805FR-0710KL
R3, R4, R5: 4.7k 1%; R_0805_2012Metric; MPN RC0805FR-074K7L
U1: STUSB4500QTR; QFN-24-1EP_4x4mm_P0.5mm_EP2.7x2.7mm; MPN STUSB4500QTR

Connections:
/CC1: J1.A5 (CC1), U1.1 (CC1DB), U1.2 (CC1)
/CC2: J1.B5 (CC2), U1.4 (CC2), U1.5 (CC2DB)
/PD_1V2: C2.1, U1.21 (VREG_1V2)
/PD_2V7: C3.1, U1.23 (VREG_2V7)
/PD_20V_OK_N: J2.7, R6.2, U1.20 (POWER_OK2); also elsewhere on the board
/PD_SINK_EN_N: J2.8, R7.2, U1.16 (VBUS_EN_SNK)
/PD_VBUS_SENSE: R1.2, U1.18 (VBUS_VS_DISCH)
/VBUS_PD: C1.1, C4.1, J1.A4 (VBUS), J1.A9 (VBUS), J1.B4 (VBUS), J1.B9 (VBUS), R1.1, U1.24 (VDD); also elsewhere on the board
CONTROL_3V3: J2.1, R3.1, R4.1, R5.1, R6.1, R7.1; also elsewhere on the board
GND: C1.2, C2.2, C3.2, C4.2, J1.A1 (GND), J1.A12 (GND), J1.B1 (GND), J1.B12 (GND), J1.SH (SHIELD), J2.2, R2.2, U1.10 (GND), U1.12 (ADDR0), U1.13 (ADDR1), U1.22 (VSYS), U1.25 (GND); also elsewhere on the board
PD_ALERT_N: J2.6, R5.2, U1.19 (ALERT); also elsewhere on the board
PD_RESET: J2.5, R2.1, U1.6 (RESET); also elsewhere on the board
PD_SCL: J2.3, R3.2, U1.7 (SCL); also elsewhere on the board
PD_SDA: J2.4, R4.2, U1.8 (SDA); also elsewhere on the board

Notes on the sheet:
Program NVM: PDO1 5V/0.5A, PDO2 20V/5A; two PDOs.
PWR_OK_CFG=10b; POWER_ONLY_ABOVE_5V=1; REQ_SRC_CURRENT=0.
J2: 3.3V programming I/O. Do not drive pin 1 from an external supply.
TODO: connector-side surge/ESD and tile connector qualification.

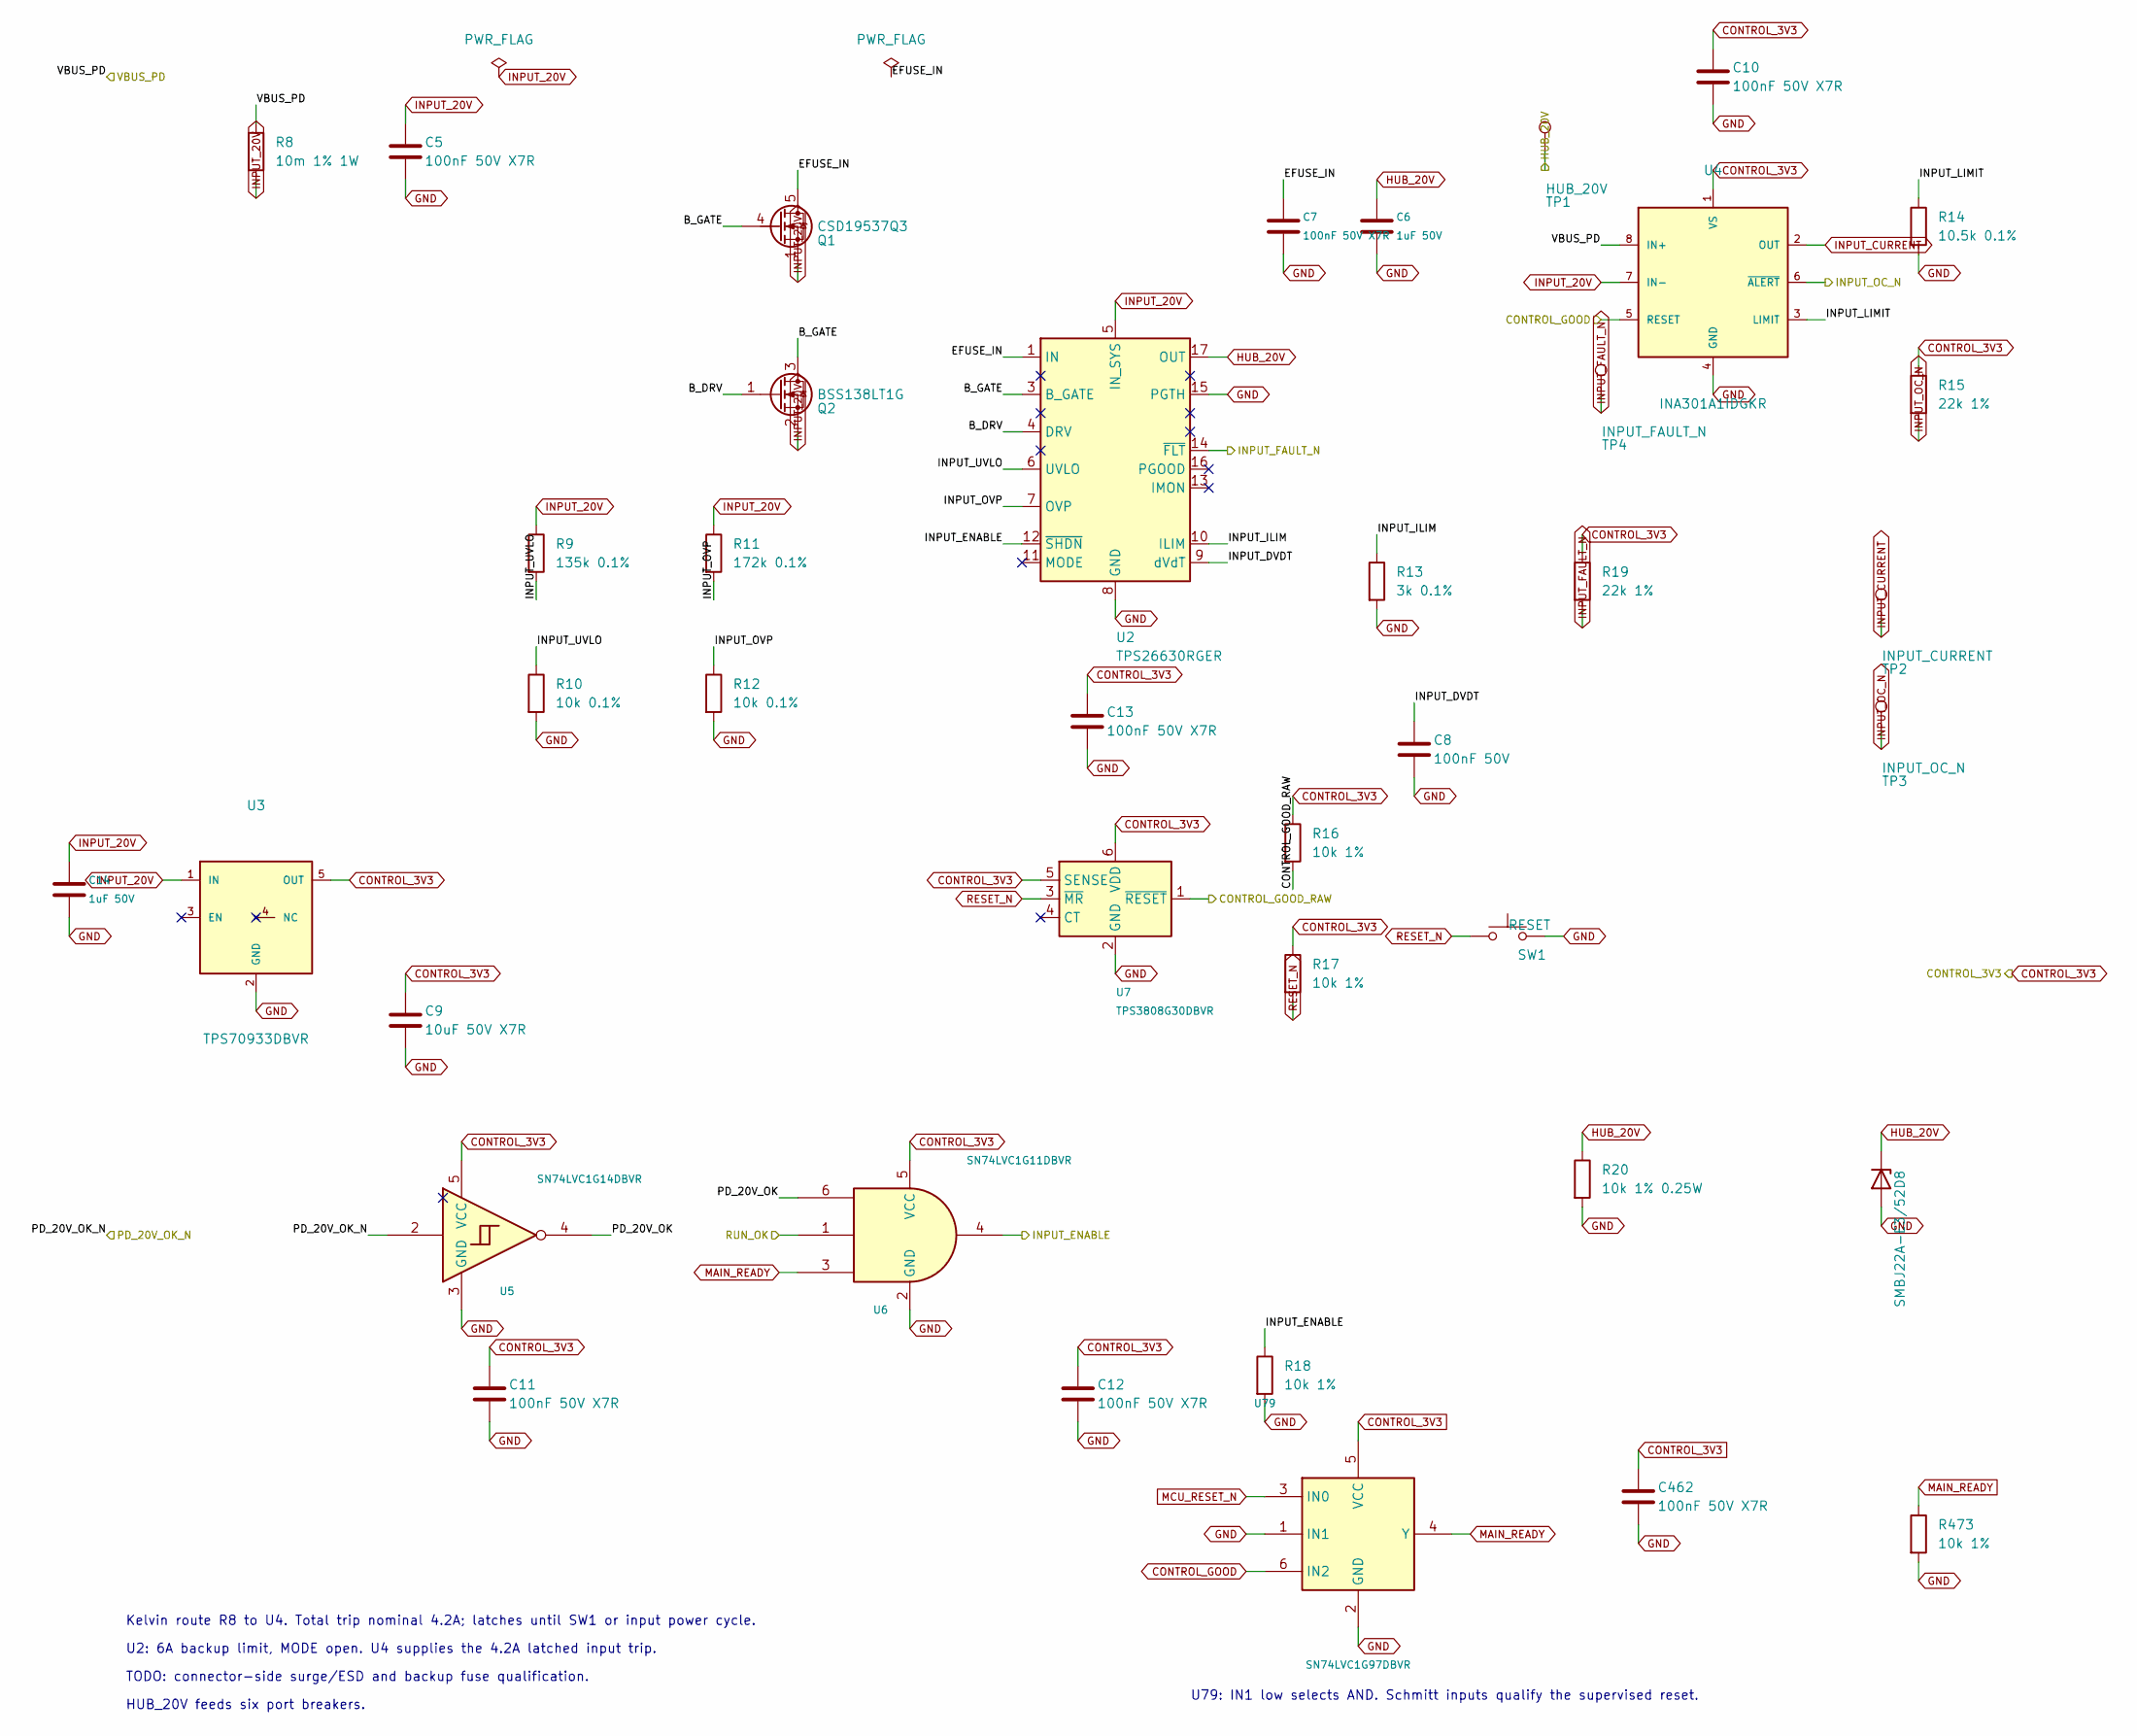
[picture p69: schematic input-protection.kicad_sch, Klink Hub - input protection]

Parts:
C5, C7, C10, C11, C12, C13, C462: 100nF 50V X7R; C_0805_2012Metric; MPN C2012X7R1H104K125AE
C6, C14: 1uF 50V; C_0805_2012Metric; MPN C2012X7R1H105K125AB
C8: 100nF 50V; C_0805_2012Metric; MPN C2012X7R1H104K125AE
C9: 10uF 50V X7R; C_1206_3216Metric; MPN C3216X7R1H106K160AC
D8: SMBJ22A-E3/52; D_SMB; MPN SMBJ22A-E3/52
Q1: CSD19537Q3; CSD19537Q3_TI; MPN CSD19537Q3
Q2: BSS138LT1G; SOT-23; MPN BSS138LT1G
R8: 10m 1% 1W; R_Vishay_WSL2512_10m; MPN WSL2512R0100FEA
R9: 135k 0.1%; R_0805_2012Metric; MPN TNPW0805135KBEEA
R10, R12: 10k 0.1%; R_0805_2012Metric; MPN TNPW080510K0BEEA
R11: 172k 0.1%; R_0805_2012Metric; MPN TNPW0805172KBEEA
R13: 3k 0.1%; R_0805_2012Metric; MPN TNPW08053K00BEEA
R14: 10.5k 0.1%; R_0805_2012Metric; MPN ERA6AEB1052V
R15, R19: 22k 1%; R_0805_2012Metric; MPN RC0805FR-0722KL
R16, R17, R18, R473: 10k 1%; R_0805_2012Metric; MPN RC0805FR-0710KL
R20: 10k 1% 0.25W; R_1206_3216Metric; MPN RC1206FR0710KL
SW1: RESET; SW_SPST_B3U-1000P; MPN B3U-1000P
TP1: HUB_20V; TestPoint_Pad_D2.0mm
TP2: INPUT_CURRENT; TestPoint_Pad_D2.0mm
TP3: INPUT_OC_N; TestPoint_Pad_D2.0mm
TP4: INPUT_FAULT_N; TestPoint_Pad_D2.0mm
U2: TPS26630RGER; Texas_RGE0024H_VQFN-24-1EP_4x4mm_P0.5mm_EP2.7x2.7mm_Thermal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; MPN TPS26630RGER
U3: TPS70933DBVR; SOT-23-5; MPN TPS70933DBVR
U4: INA301A1IDGKR; VSSOP-8_3x3mm_P0.65mm; MPN INA301A1IDGKR
U5: SN74LVC1G14DBVR; SOT-23-5; MPN SN74LVC1G14DBVR
U6: SN74LVC1G11DBVR; SOT-23-6; MPN SN74LVC1G11DBVR
U7: TPS3808G30DBVR; SOT-23-6; MPN TPS3808G30DBVR
U79: SN74LVC1G97DBVR; SOT-23-6; MPN SN74LVC1G97DBVR

Connections:
/CONTROL_GOOD_RAW: R16.2, U7.1 (~RESET); also elsewhere on the board
/INPUT_ENABLE: R18.1, U2.12 (~SHDN), U6.4; also elsewhere on the board
/Input protection/B_DRV: Q2.1 (G), U2.4 (DRV)
/Input protection/B_GATE: Q1.4 (G), Q2.3 (D), U2.3 (B_GATE)
/Input protection/EFUSE_IN: C7.1, Q1.5 (D), U2.1 (IN), U2.2 (IN)
/Input protection/INPUT_DVDT: C8.1, U2.9 (dVdT)
/Input protection/INPUT_ILIM: R13.1, U2.10 (ILIM)
/Input protection/INPUT_LIMIT: R14.1, U4.3 (LIMIT)
/Input protection/INPUT_OVP: R11.2, R12.1, U2.7 (OVP)
/Input protection/INPUT_UVLO: R9.2, R10.1, U2.6 (UVLO)
/Input protection/PD_20V_OK: U5.4, U6.6
/PD_20V_OK_N: U5.2; also elsewhere on the board
/RUN_OK: U6.1; also elsewhere on the board
/VBUS_PD: R8.1, U4.8 (IN+); also elsewhere on the board
CONTROL_3V3: C9.1, C10.1, C11.1, C12.1, C13.1, C462.1, R15.1, R16.1, R17.1, R19.1, U3.5 (OUT), U4.1 (VS), U5.5 (VCC), U6.5 (VCC), U7.5 (SENSE), U7.6 (VDD), U79.5 (VCC); also elsewhere on the board
CONTROL_GOOD: U4.5 (RESET), U79.6 (IN2); also elsewhere on the board
GND: C5.2, C6.2, C7.2, C8.2, C9.2, C10.2, C11.2, C12.2, C13.2, C14.2, C462.2, D8.2 (A), R10.2, R12.2, R13.2, R14.2, R18.2, R20.2, R473.2, SW1.2, U2.8 (GND), U2.15 (PGTH), U2.25 (GND), U3.2 (GND), U4.4 (GND), U5.3 (GND), U6.2 (GND), U7.2 (GND), U79.1 (IN1), U79.2 (GND); also elsewhere on the board
HUB_20V: C6.1, D8.1 (K), R20.1, TP1.1, U2.17 (OUT), U2.18 (OUT); also elsewhere on the board
INPUT_20V: C5.1, C14.1, Q1.1 (S), Q1.2 (S), Q1.3 (S), Q2.2 (S), R8.2, R9.1, R11.1, U2.5 (IN_SYS), U3.1 (IN), U4.7 (IN-); also elsewhere on the board
INPUT_CURRENT: TP2.1, U4.2 (OUT); also elsewhere on the board
INPUT_FAULT_N: R19.2, TP4.1, U2.14 (~FLT); also elsewhere on the board
INPUT_OC_N: R15.2, TP3.1, U4.6 (~ALERT); also elsewhere on the board
MAIN_READY: R473.1, U6.3, U79.4 (Y); also elsewhere on the board
MCU_RESET_N: U79.3 (IN0); also elsewhere on the board
RESET_N: R17.2, SW1.1, U7.3 (~MR); also elsewhere on the board

Notes on the sheet:
Kelvin route R8 to U4. Total trip nominal 4.2A; latches until SW1 or input power cycle.
U2: 6A backup limit, MODE open. U4 supplies the 4.2A latched input trip.
TODO: connector-side surge/ESD and backup fuse qualification.
HUB_20V feeds six port breakers.
U79: IN1 low selects AND. Schmitt inputs qualify the supervised reset.

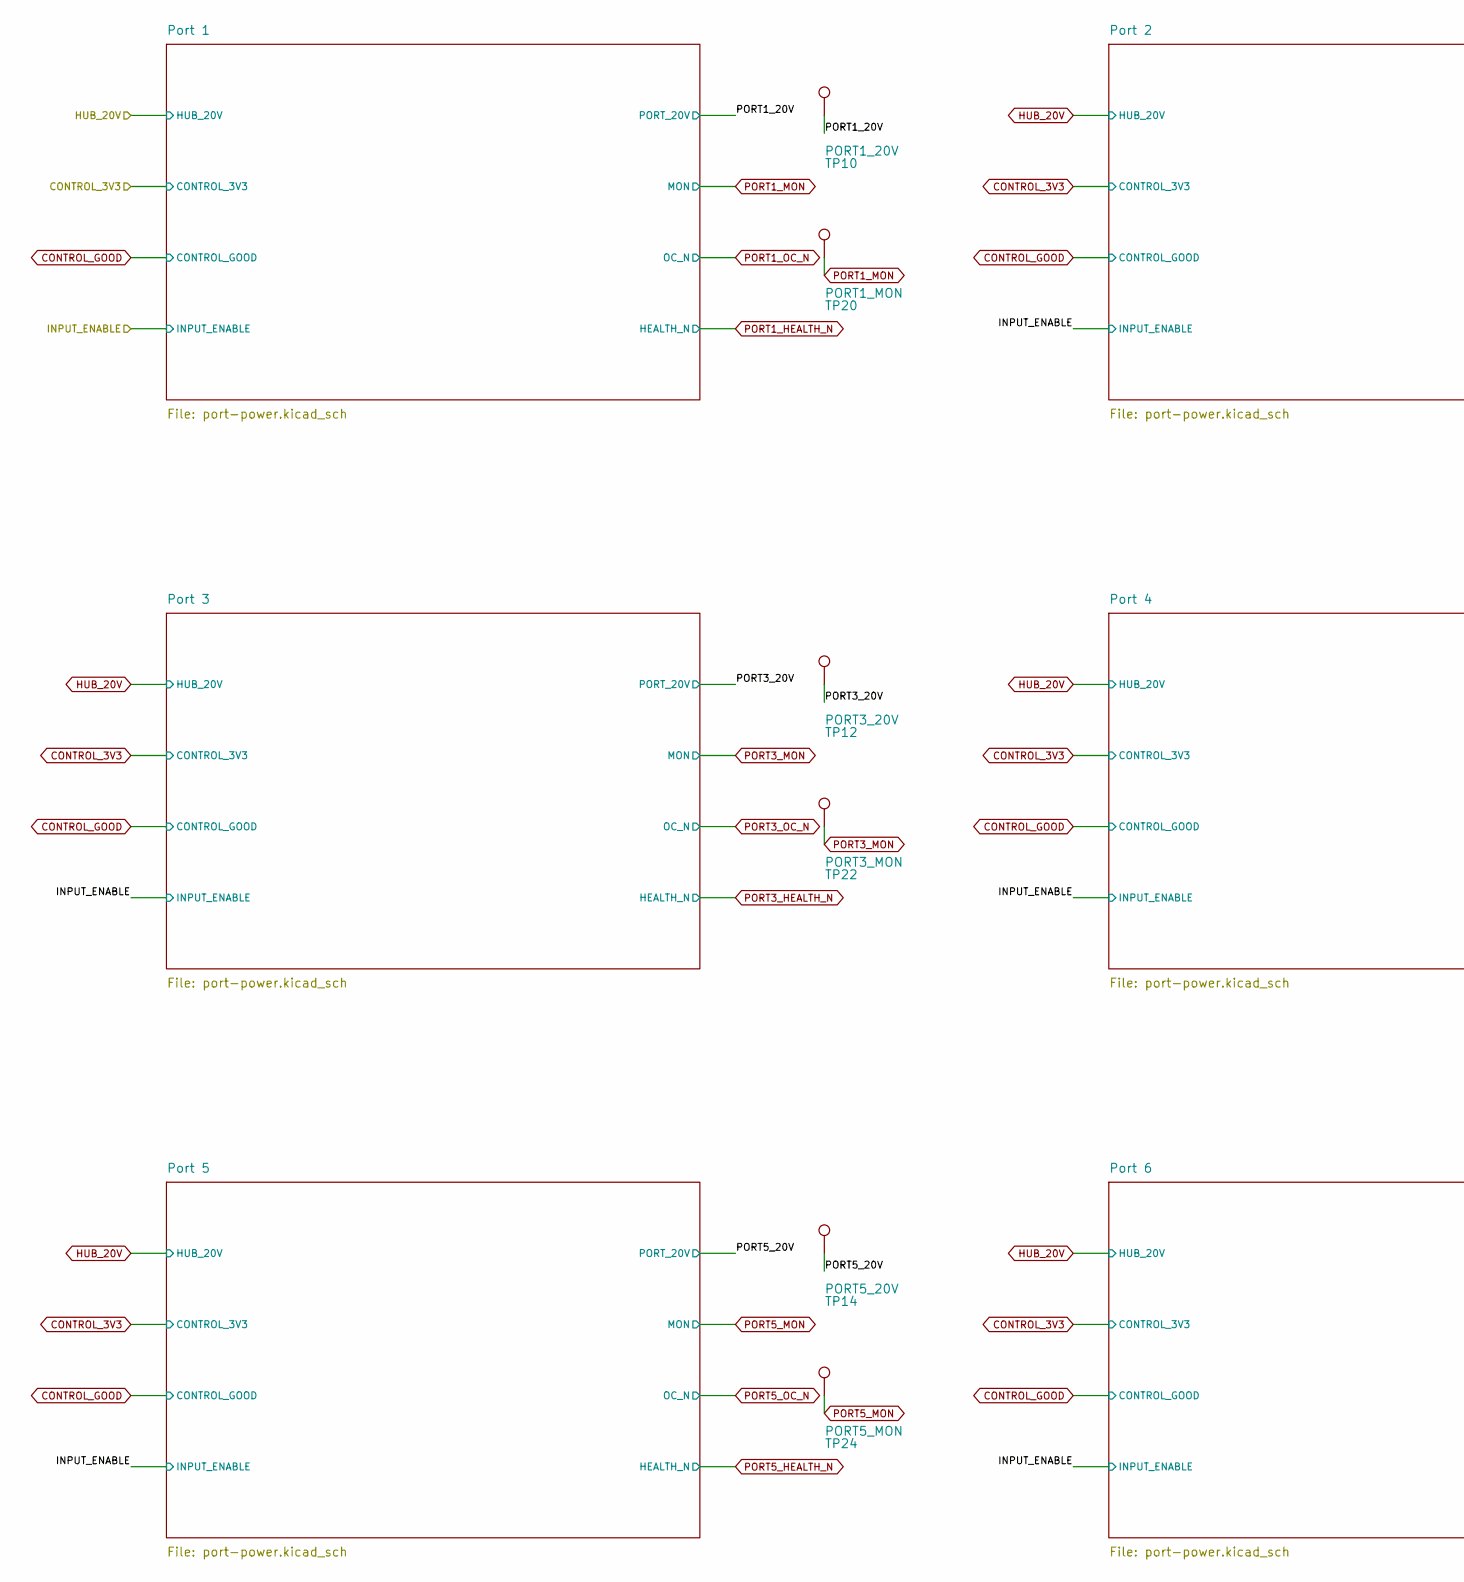
[picture p70: schematic distribution.kicad_sch, Klink Hub - distribution, part in row 1, column 1]

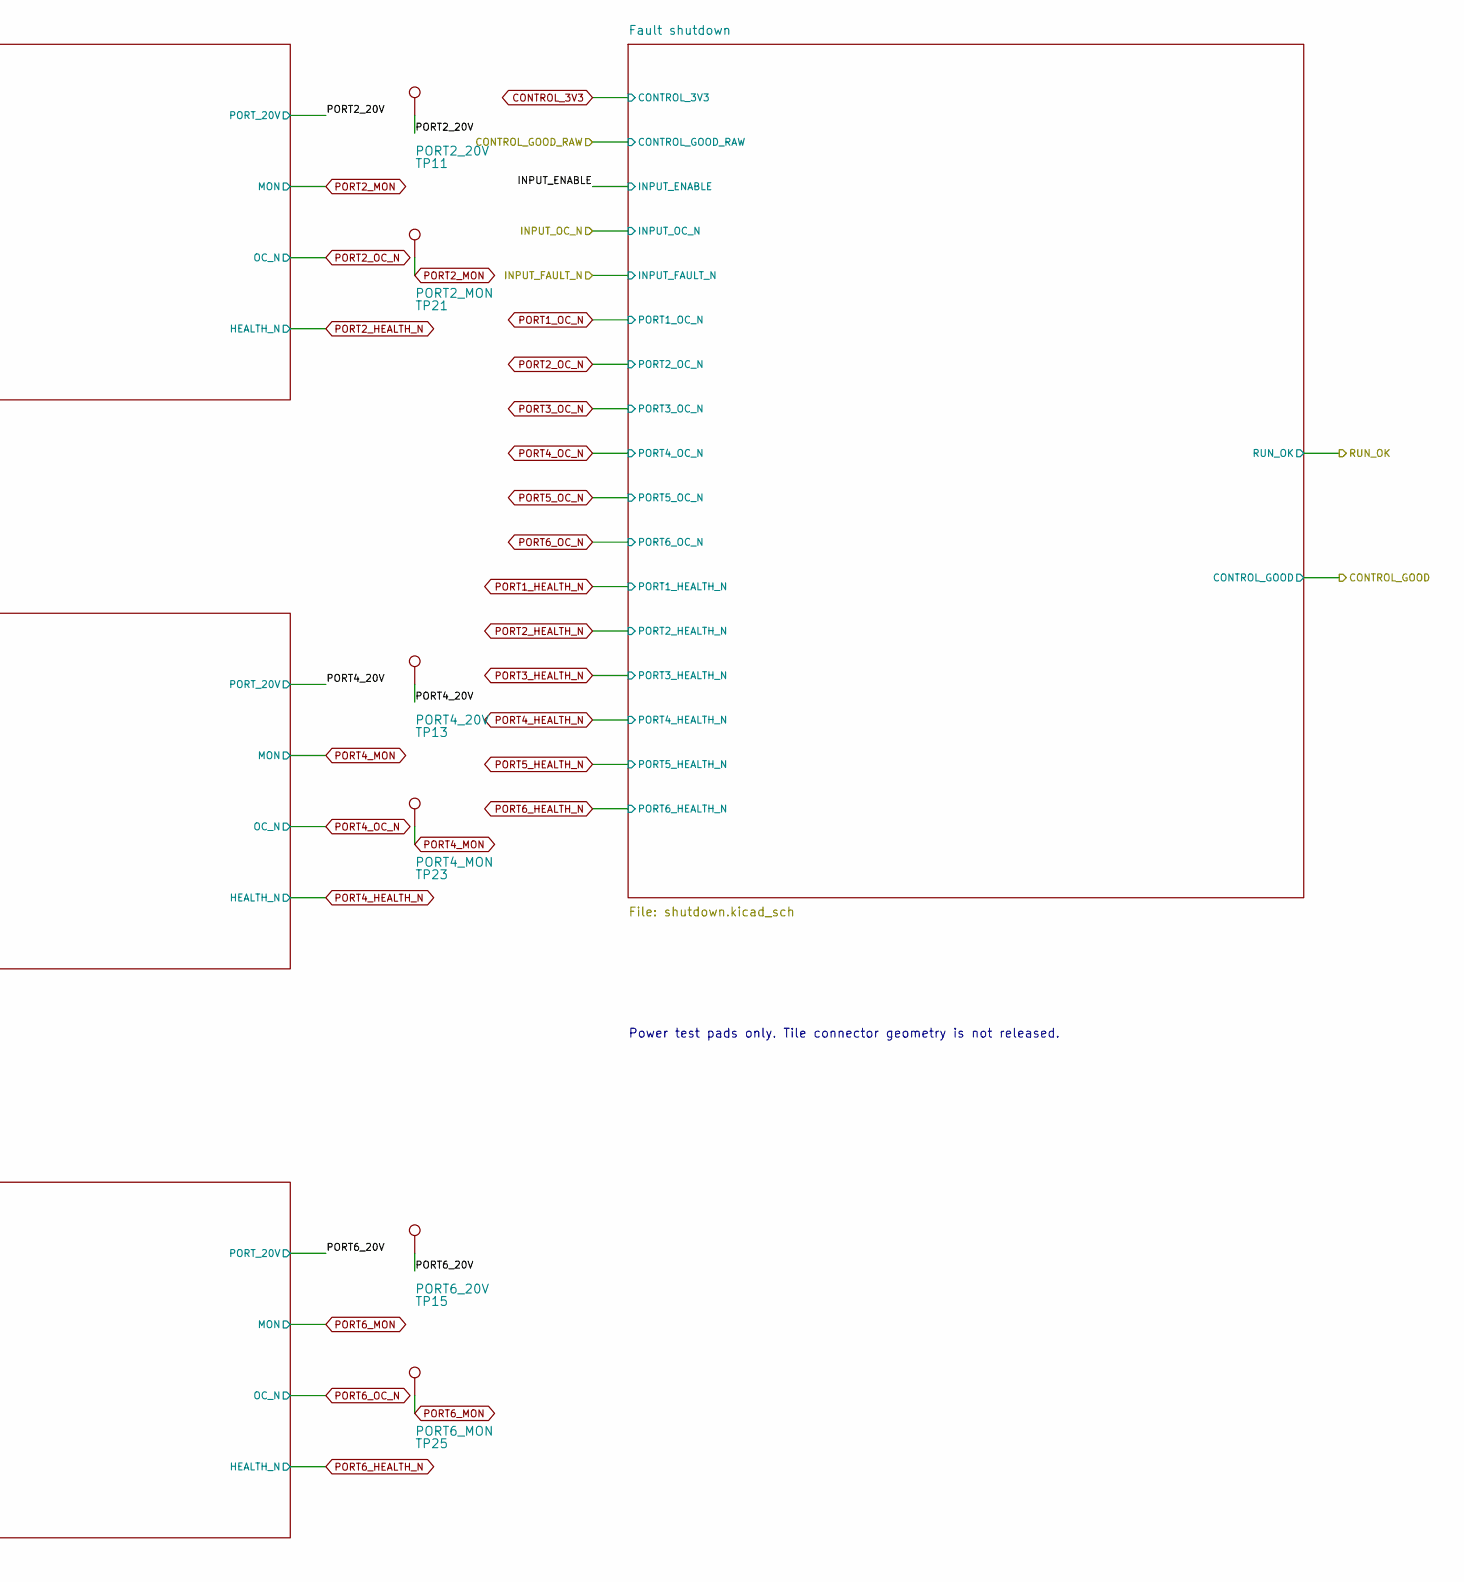
[picture p71: schematic distribution.kicad_sch, Klink Hub - distribution, part in row 1, column 2]

Parts:
TP10: PORT1_20V; TestPoint_Pad_D2.0mm
TP11: PORT2_20V; TestPoint_Pad_D2.0mm
TP12: PORT3_20V; TestPoint_Pad_D2.0mm
TP13: PORT4_20V; TestPoint_Pad_D2.0mm
TP14: PORT5_20V; TestPoint_Pad_D2.0mm
TP15: PORT6_20V; TestPoint_Pad_D2.0mm
TP20: PORT1_MON; TestPoint_Pad_D2.0mm
TP21: PORT2_MON; TestPoint_Pad_D2.0mm
TP22: PORT3_MON; TestPoint_Pad_D2.0mm
TP23: PORT4_MON; TestPoint_Pad_D2.0mm
TP24: PORT5_MON; TestPoint_Pad_D2.0mm
TP25: PORT6_MON; TestPoint_Pad_D2.0mm

Connections:
/Distribution/PORT1_20V: TP10.1; also elsewhere on the board
/Distribution/PORT2_20V: TP11.1; also elsewhere on the board
/Distribution/PORT3_20V: TP12.1; also elsewhere on the board
/Distribution/PORT4_20V: TP13.1; also elsewhere on the board
/Distribution/PORT5_20V: TP14.1; also elsewhere on the board
/Distribution/PORT6_20V: TP15.1; also elsewhere on the board
PORT1_MON: TP20.1; also elsewhere on the board
PORT2_MON: TP21.1; also elsewhere on the board
PORT3_MON: TP22.1; also elsewhere on the board
PORT4_MON: TP23.1; also elsewhere on the board
PORT5_MON: TP24.1; also elsewhere on the board
PORT6_MON: TP25.1; also elsewhere on the board

Notes on the sheet:
Power test pads only. Tile connector geometry is not released.
