Bruhdows/klink/hardware/electronics/hub/hub.kicad_pcb

## KiCad design hardware/electronics/hub/hub.kicad_pcb (continued)

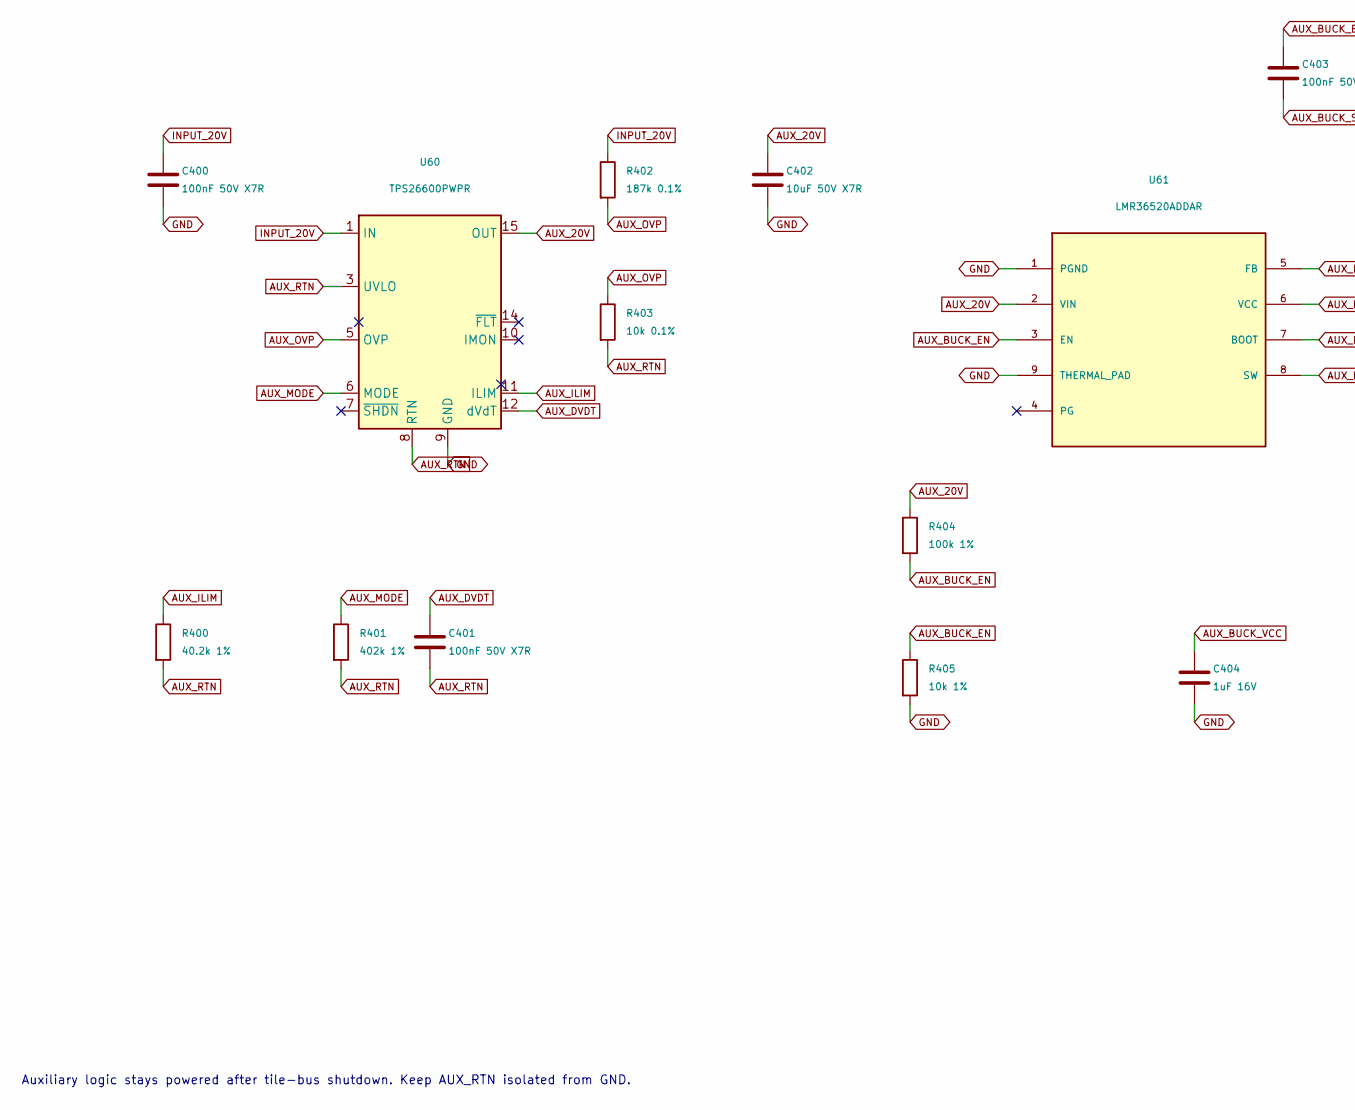
[picture p72: schematic supplies.kicad_sch, Klink Hub - supplies, part in row 1, column 1]

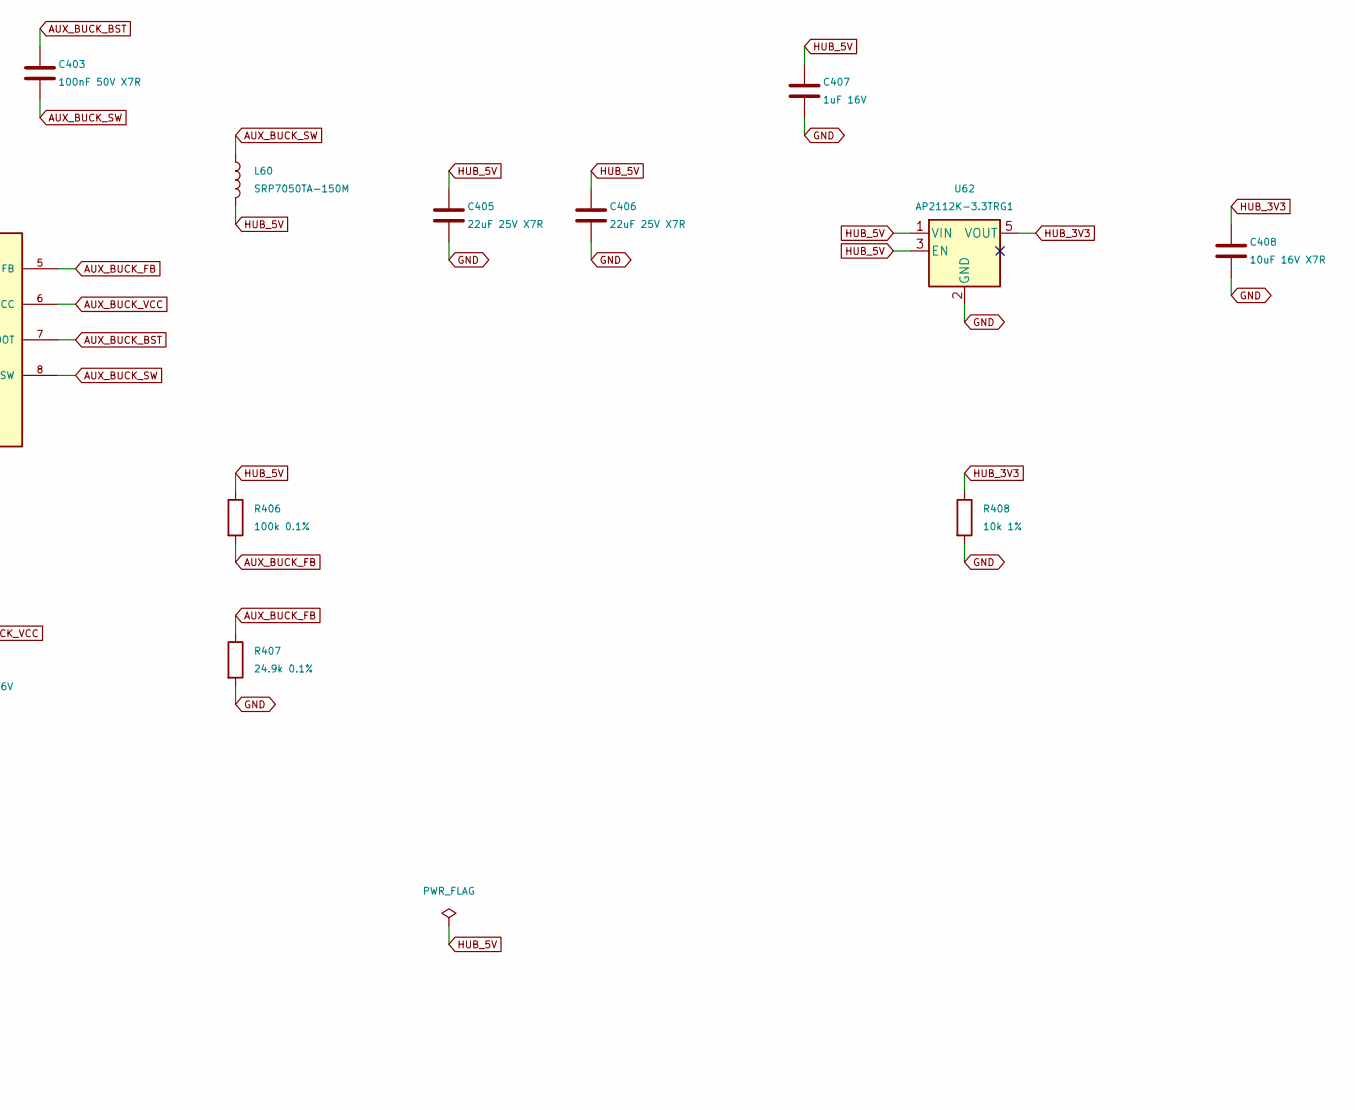
[picture p73: schematic supplies.kicad_sch, Klink Hub - supplies, part in row 1, column 2]

Parts:
C400, C401, C403: 100nF 50V X7R; C_0805_2012Metric; MPN C2012X7R1H104K125AE
C402: 10uF 50V X7R; C_1206_3216Metric; MPN C3216X7R1H106K160AC
C404, C407: 1uF 16V; C_0805_2012Metric; MPN C2012X7R1H105K125AB
C405, C406: 22uF 25V X7R; C_1210_3225Metric; MPN C1210C226K3RACTU
C408: 10uF 16V X7R; C_1206_3216Metric; MPN C3216X7R1C106K160AC
L60: SRP7050TA-150M; L_Bourns_SRP7050TA; MPN SRP7050TA-150M
R400: 40.2k 1%; R_0805_2012Metric; MPN RC0805FR-0740K2L
R401: 402k 1%; R_0805_2012Metric; MPN RC0805FR-07402KL
R402: 187k 0.1%; R_0805_2012Metric; MPN RT0805BRD07187KL
R403: 10k 0.1%; R_0805_2012Metric; MPN RT0805BRD0710KL
R404: 100k 1%; R_0805_2012Metric; MPN RC0805FR-07100KL
R405, R408: 10k 1%; R_0805_2012Metric; MPN RC0805FR-0710KL
R406: 100k 0.1%; R_0805_2012Metric; MPN RT0805BRD07100KL
R407: 24.9k 0.1%; R_0805_2012Metric; MPN RT0805BRD0724K9L
U60: TPS26600PWPR; TI_PWP0016A_Mask3.3x3.3; MPN TPS26600PWPR
U61: LMR36520ADDAR; TI_SO-PowerPAD-8; MPN LMR36520ADDAR
U62: AP2112K-3.3TRG1; SOT-23-5; MPN AP2112K-3.3TRG1

Connections:
AUX_20V: C402.1, R404.1, U60.15 (OUT), U60.16 (OUT), U61.2 (VIN)
AUX_BUCK_BST: C403.1, U61.7 (BOOT)
AUX_BUCK_EN: R404.2, R405.1, U61.3 (EN)
AUX_BUCK_FB: R406.2, R407.1, U61.5 (FB)
AUX_BUCK_SW: C403.2, L60.1, U61.8 (SW)
AUX_BUCK_VCC: C404.1, U61.6 (VCC)
AUX_DVDT: C401.1, U60.12 (dVdT)
AUX_ILIM: R400.1, U60.11 (ILIM)
AUX_MODE: R401.1, U60.6 (MODE)
AUX_OVP: R402.2, R403.1, U60.5 (OVP)
AUX_RTN: C401.2, R400.2, R401.2, R403.2, U60.3 (UVLO), U60.8 (RTN), U60.17 (RTN)
GND: C400.2, C402.2, C404.2, C405.2, C406.2, C407.2, C408.2, R405.2, R407.2, R408.2, U60.9 (GND), U61.1 (PGND), U61.9 (THERMAL_PAD), U62.2 (GND); also elsewhere on the board
HUB_3V3: C408.1, R408.1, U62.5 (VOUT); also elsewhere on the board
HUB_5V: C405.1, C406.1, C407.1, L60.2, R406.1, U62.1 (VIN), U62.3 (EN); also elsewhere on the board
INPUT_20V: C400.1, R402.1, U60.1 (IN), U60.2 (IN); also elsewhere on the board

Notes on the sheet:
Auxiliary logic stays powered after tile-bus shutdown. Keep AUX_RTN isolated from GND.

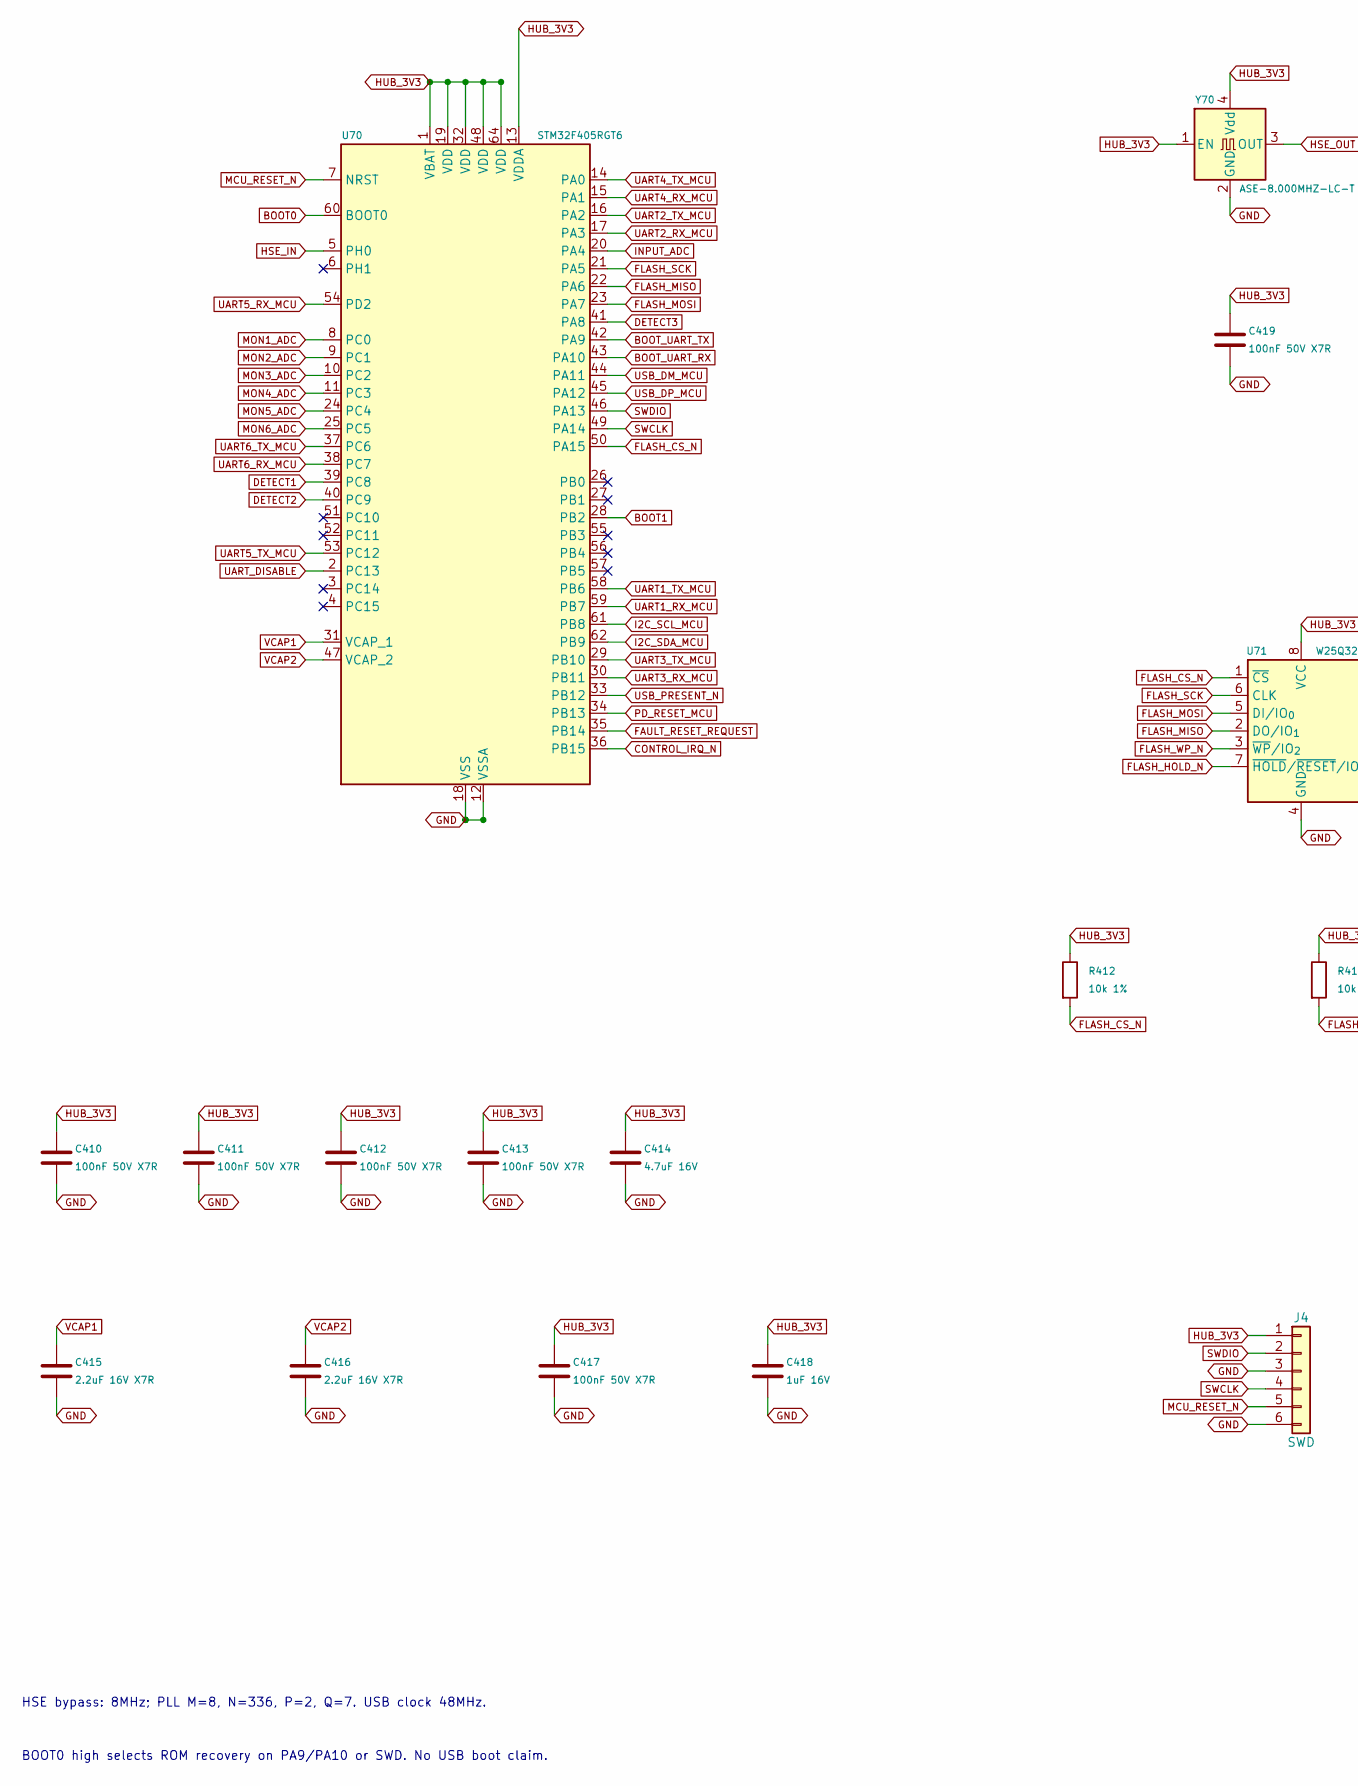
[picture p74: schematic controller.kicad_sch, Klink Hub - controller, part in row 1, column 1]

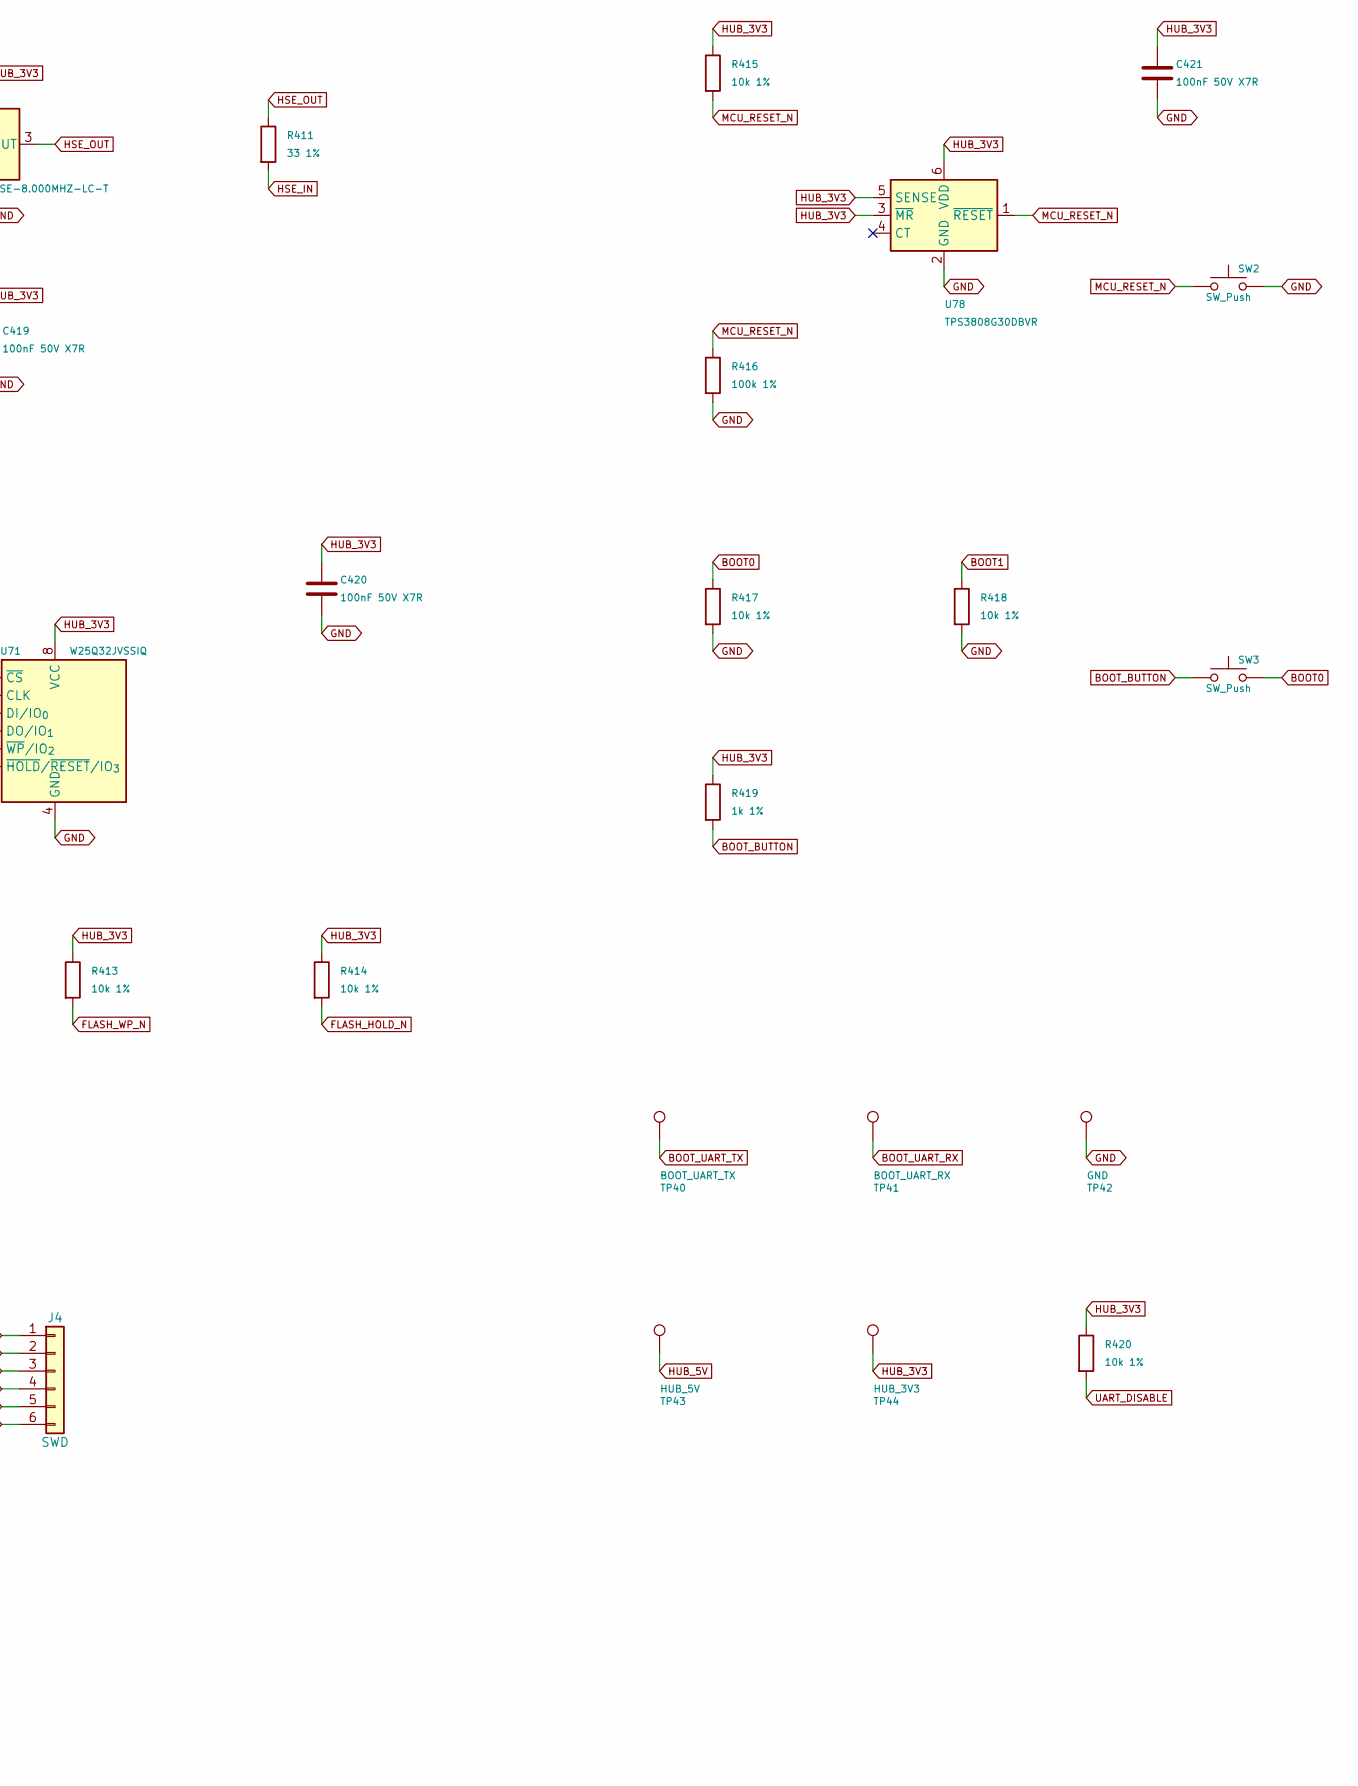
[picture p75: schematic controller.kicad_sch, Klink Hub - controller, part in row 1, column 2]

Parts:
C410, C411, C412, C413, C417, C419, C420, C421: 100nF 50V X7R; C_0805_2012Metric; MPN C2012X7R1H104K125AE
C414: 4.7uF 16V; C_0805_2012Metric; MPN C2012X7R1C475K125AB
C415, C416: 2.2uF 16V X7R; C_0805_2012Metric; MPN C2012X7R1C225K125AB
C418: 1uF 16V; C_0805_2012Metric; MPN C2012X7R1H105K125AB
J4: SWD; PinHeader_1x06_P2.54mm_Vertical; MPN TSW-106-07-G-S
R411: 33 1%; R_0805_2012Metric; MPN RC0805FR-0733RL
R412, R413, R414, R415, R417, R418, R420: 10k 1%; R_0805_2012Metric; MPN RC0805FR-0710KL
R416: 100k 1%; R_0805_2012Metric; MPN RC0805FR-07100KL
R419: 1k 1%; R_0805_2012Metric; MPN RC0805FR-071KL
SW2, SW3: SW_Push; SW_SPST_B3U-1000P; MPN B3U-1000P
TP40: BOOT_UART_TX; TestPoint_Pad_D2.0mm
TP41: BOOT_UART_RX; TestPoint_Pad_D2.0mm
TP42: GND; TestPoint_Pad_D2.0mm
TP43: HUB_5V; TestPoint_Pad_D2.0mm
TP44: HUB_3V3; TestPoint_Pad_D2.0mm
U70: STM32F405RGT6; LQFP-64_10x10mm_P0.5mm; MPN STM32F405RGT6
U71: W25Q32JVSSIQ; SOIC-8_5.3x5.3mm_P1.27mm; MPN W25Q32JVSSIQ
U78: TPS3808G30DBVR; SOT-23-6; MPN TPS3808G30DBVR
Y70: ASE-8.000MHZ-LC-T; Oscillator_SMD_Abracon_ASE-4Pin_3.2x2.5mm; MPN ASE-8.000MHZ-LC-T

Connections:
BOOT0: R417.1, SW3.2, U70.60 (BOOT0)
BOOT1: R418.1, U70.28 (PB2)
BOOT_BUTTON: R419.2, SW3.1
BOOT_UART_RX: TP41.1, U70.43 (PA10)
BOOT_UART_TX: TP40.1, U70.42 (PA9)
CONTROL_IRQ_N: U70.36 (PB15); also elsewhere on the board
DETECT1: U70.39 (PC8); also elsewhere on the board
DETECT2: U70.40 (PC9); also elsewhere on the board
DETECT3: U70.41 (PA8); also elsewhere on the board
FAULT_RESET_REQUEST: U70.35 (PB14); also elsewhere on the board
FLASH_CS_N: R412.2, U70.50 (PA15), U71.1 (~CS)
FLASH_HOLD_N: R414.2, U71.7 (~HOLD/~RESET/IO_{3})
FLASH_MISO: U70.22 (PA6), U71.2 (DO/IO_{1})
FLASH_MOSI: U70.23 (PA7), U71.5 (DI/IO_{0})
FLASH_SCK: U70.21 (PA5), U71.6 (CLK)
FLASH_WP_N: R413.2, U71.3 (~WP/IO_{2})
GND: C410.2, C411.2, C412.2, C413.2, C414.2, C415.2, C416.2, C417.2, C418.2, C419.2, C420.2, C421.2, J4.3, J4.6, R416.2, R417.2, R418.2, SW2.2, TP42.1, U70.12 (VSSA), U70.18 (VSS), U70.63 (VSS), U71.4 (GND), U78.2 (GND), Y70.2 (GND); also elsewhere on the board
HSE_IN: R411.2, U70.5 (PH0)
HSE_OUT: R411.1, Y70.3 (OUT)
HUB_3V3: C410.1, C411.1, C412.1, C413.1, C414.1, C417.1, C418.1, C419.1, C420.1, C421.1, J4.1, R412.1, R413.1, R414.1, R415.1, R419.1, R420.1, TP44.1, U70.1 (VBAT), U70.13 (VDDA), U70.19 (VDD), U70.32 (VDD), U70.48 (VDD), U70.64 (VDD), U71.8 (VCC), U78.3 (~MR), U78.5 (SENSE), U78.6 (VDD), Y70.1 (EN), Y70.4 (Vdd); also elsewhere on the board
HUB_5V: TP43.1; also elsewhere on the board
I2C_SCL_MCU: U70.61 (PB8); also elsewhere on the board
I2C_SDA_MCU: U70.62 (PB9); also elsewhere on the board
INPUT_ADC: U70.20 (PA4); also elsewhere on the board
MCU_RESET_N: J4.5, R415.2, R416.1, SW2.1, U70.7 (NRST), U78.1 (~RESET); also elsewhere on the board
MON1_ADC: U70.8 (PC0); also elsewhere on the board
MON2_ADC: U70.9 (PC1); also elsewhere on the board
MON3_ADC: U70.10 (PC2); also elsewhere on the board
MON4_ADC: U70.11 (PC3); also elsewhere on the board
MON5_ADC: U70.24 (PC4); also elsewhere on the board
MON6_ADC: U70.25 (PC5); also elsewhere on the board
PD_RESET_MCU: U70.34 (PB13); also elsewhere on the board
SWCLK: J4.4, U70.49 (PA14)
SWDIO: J4.2, U70.46 (PA13)
UART1_RX_MCU: U70.59 (PB7); also elsewhere on the board
UART1_TX_MCU: U70.58 (PB6); also elsewhere on the board
UART2_RX_MCU: U70.17 (PA3); also elsewhere on the board
UART2_TX_MCU: U70.16 (PA2); also elsewhere on the board
UART3_RX_MCU: U70.30 (PB11); also elsewhere on the board
UART3_TX_MCU: U70.29 (PB10); also elsewhere on the board
UART4_RX_MCU: U70.15 (PA1); also elsewhere on the board
UART4_TX_MCU: U70.14 (PA0); also elsewhere on the board
UART5_RX_MCU: U70.54 (PD2); also elsewhere on the board
UART5_TX_MCU: U70.53 (PC12); also elsewhere on the board
UART6_RX_MCU: U70.38 (PC7); also elsewhere on the board
UART6_TX_MCU: U70.37 (PC6); also elsewhere on the board
UART_DISABLE: R420.2, U70.2 (PC13); also elsewhere on the board
USB_DM_MCU: U70.44 (PA11); also elsewhere on the board
USB_DP_MCU: U70.45 (PA12); also elsewhere on the board
USB_PRESENT_N: U70.33 (PB12); also elsewhere on the board
VCAP1: C415.1, U70.31 (VCAP_1)
VCAP2: C416.1, U70.47 (VCAP_2)

Notes on the sheet:
HSE bypass: 8MHz; PLL M=8, N=336, P=2, Q=7. USB clock 48MHz.
BOOT0 high selects ROM recovery on PA9/PA10 or SWD. No USB boot claim.

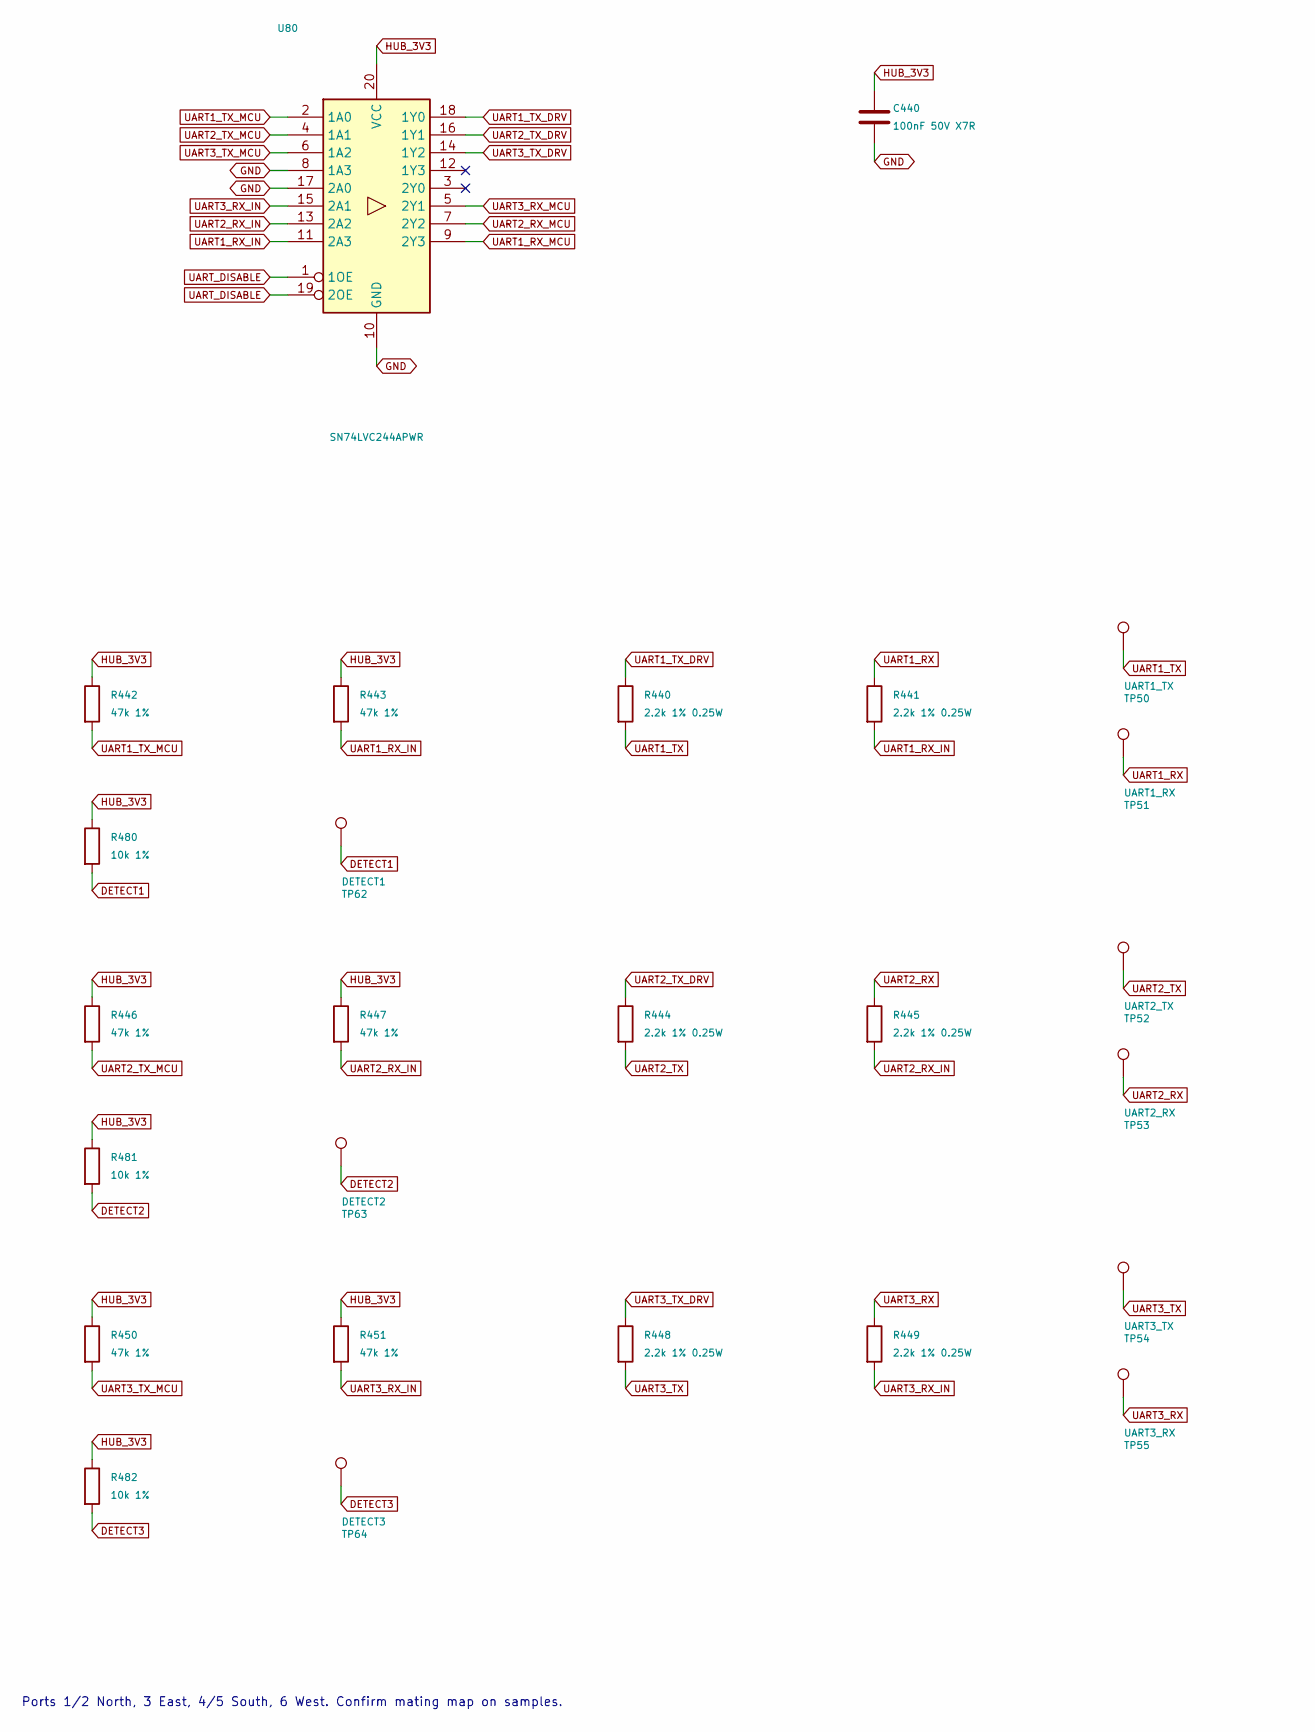
[picture p76: schematic uart.kicad_sch, Klink Hub - UART links, part in row 1, column 1]

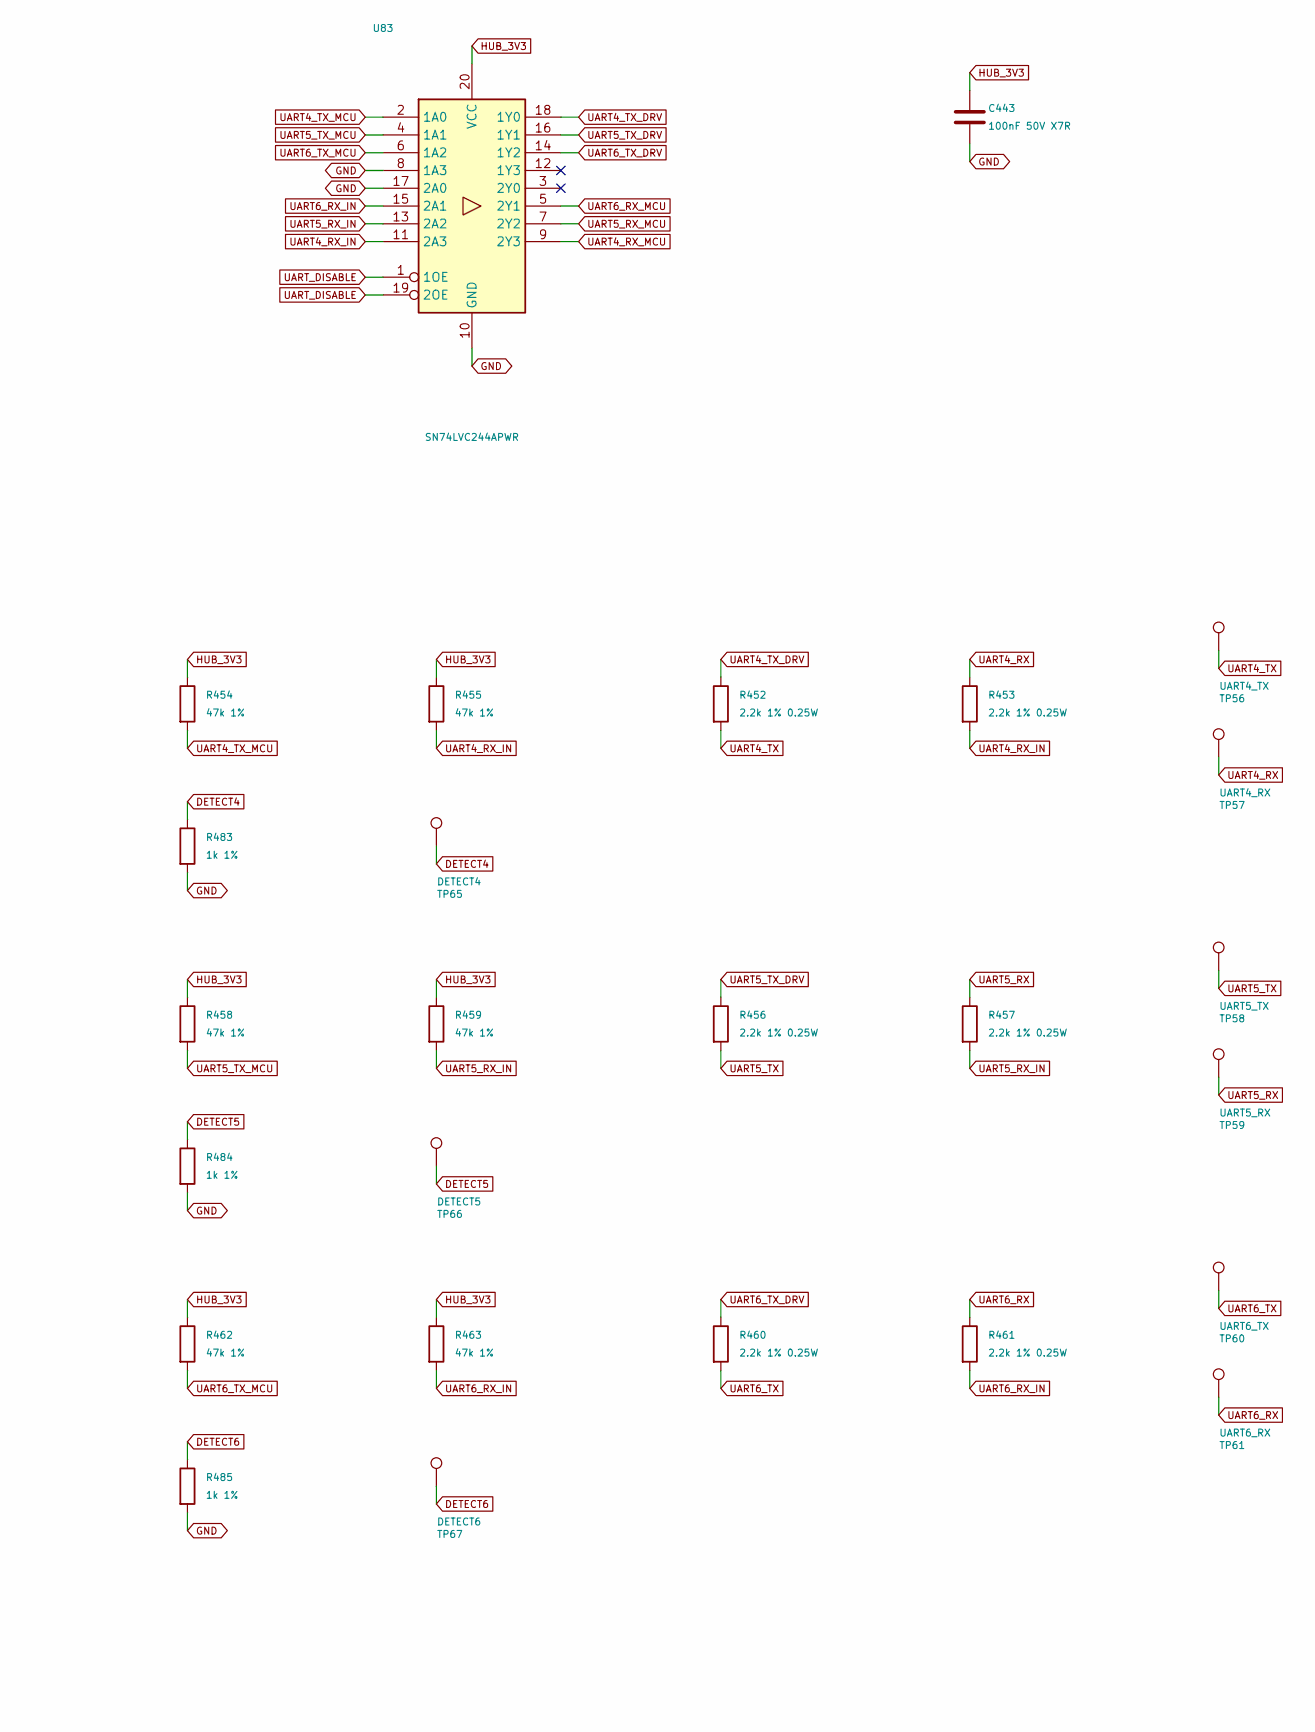
[picture p77: schematic uart.kicad_sch, Klink Hub - UART links, part in row 1, column 2]

Parts:
C440, C443: 100nF 50V X7R; C_0805_2012Metric; MPN C2012X7R1H104K125AE
R440, R441, R444, R445, R448, R449, R452, R453, R456, R457, R460, R461: 2.2k 1% 0.25W; R_1206_3216Metric; MPN RC1206FR-072K2L
R442, R443, R446, R447, R450, R451, R454, R455, R458, R459, R462, R463: 47k 1%; R_0805_2012Metric; MPN RC0805FR-0747KL
R480, R481, R482: 10k 1%; R_0805_2012Metric; MPN RC0805FR-0710KL
R483, R484, R485: 1k 1%; R_0805_2012Metric; MPN RC0805FR-071KL
TP50: UART1_TX; TestPoint_Pad_D2.0mm
TP51: UART1_RX; TestPoint_Pad_D2.0mm
TP52: UART2_TX; TestPoint_Pad_D2.0mm
TP53: UART2_RX; TestPoint_Pad_D2.0mm
TP54: UART3_TX; TestPoint_Pad_D2.0mm
TP55: UART3_RX; TestPoint_Pad_D2.0mm
TP56: UART4_TX; TestPoint_Pad_D2.0mm
TP57: UART4_RX; TestPoint_Pad_D2.0mm
TP58: UART5_TX; TestPoint_Pad_D2.0mm
TP59: UART5_RX; TestPoint_Pad_D2.0mm
TP60: UART6_TX; TestPoint_Pad_D2.0mm
TP61: UART6_RX; TestPoint_Pad_D2.0mm
TP62: DETECT1; TestPoint_Pad_D2.0mm
TP63: DETECT2; TestPoint_Pad_D2.0mm
TP64: DETECT3; TestPoint_Pad_D2.0mm
TP65: DETECT4; TestPoint_Pad_D2.0mm
TP66: DETECT5; TestPoint_Pad_D2.0mm
TP67: DETECT6; TestPoint_Pad_D2.0mm
U80, U83: SN74LVC244APWR; TSSOP-20_4.4x6.5mm_P0.65mm; MPN SN74LVC244APWR

Connections:
DETECT1: R480.2, TP62.1; also elsewhere on the board
DETECT2: R481.2, TP63.1; also elsewhere on the board
DETECT3: R482.2, TP64.1; also elsewhere on the board
DETECT4: R483.1, TP65.1
DETECT5: R484.1, TP66.1
DETECT6: R485.1, TP67.1
GND: C440.2, C443.2, R483.2, R484.2, R485.2, U80.8 (1A3), U80.10 (GND), U80.17 (2A0), U83.8 (1A3), U83.10 (GND), U83.17 (2A0); also elsewhere on the board
HUB_3V3: C440.1, C443.1, R442.1, R443.1, R446.1, R447.1, R450.1, R451.1, R454.1, R455.1, R458.1, R459.1, R462.1, R463.1, R480.1, R481.1, R482.1, U80.20 (VCC), U83.20 (VCC); also elsewhere on the board
UART1_RX: R441.1, TP51.1
UART1_RX_IN: R441.2, R443.2, U80.11 (2A3)
UART1_RX_MCU: U80.9 (2Y3); also elsewhere on the board
UART1_TX: R440.2, TP50.1
UART1_TX_DRV: R440.1, U80.18 (1Y0)
UART1_TX_MCU: R442.2, U80.2 (1A0); also elsewhere on the board
UART2_RX: R445.1, TP53.1
UART2_RX_IN: R445.2, R447.2, U80.13 (2A2)
UART2_RX_MCU: U80.7 (2Y2); also elsewhere on the board
UART2_TX: R444.2, TP52.1
UART2_TX_DRV: R444.1, U80.16 (1Y1)
UART2_TX_MCU: R446.2, U80.4 (1A1); also elsewhere on the board
UART3_RX: R449.1, TP55.1
UART3_RX_IN: R449.2, R451.2, U80.15 (2A1)
UART3_RX_MCU: U80.5 (2Y1); also elsewhere on the board
UART3_TX: R448.2, TP54.1
UART3_TX_DRV: R448.1, U80.14 (1Y2)
UART3_TX_MCU: R450.2, U80.6 (1A2); also elsewhere on the board
UART4_RX: R453.1, TP57.1
UART4_RX_IN: R453.2, R455.2, U83.11 (2A3)
UART4_RX_MCU: U83.9 (2Y3); also elsewhere on the board
UART4_TX: R452.2, TP56.1
UART4_TX_DRV: R452.1, U83.18 (1Y0)
UART4_TX_MCU: R454.2, U83.2 (1A0); also elsewhere on the board
UART5_RX: R457.1, TP59.1
UART5_RX_IN: R457.2, R459.2, U83.13 (2A2)
UART5_RX_MCU: U83.7 (2Y2); also elsewhere on the board
UART5_TX: R456.2, TP58.1
UART5_TX_DRV: R456.1, U83.16 (1Y1)
UART5_TX_MCU: R458.2, U83.4 (1A1); also elsewhere on the board
UART6_RX: R461.1, TP61.1
UART6_RX_IN: R461.2, R463.2, U83.15 (2A1)
UART6_RX_MCU: U83.5 (2Y1); also elsewhere on the board
UART6_TX: R460.2, TP60.1
UART6_TX_DRV: R460.1, U83.14 (1Y2)
UART6_TX_MCU: R462.2, U83.6 (1A2); also elsewhere on the board
UART_DISABLE: U80.1 (1OE), U80.19 (2OE), U83.1 (1OE), U83.19 (2OE); also elsewhere on the board

Notes on the sheet:
Ports 1/2 North, 3 East, 4/5 South, 6 West. Confirm mating map on samples.
