Bruhdows/klink/hardware/electronics/hub/hub.kicad_pcb

## KiCad design hardware/electronics/hub/hub.kicad_pcb (continued)

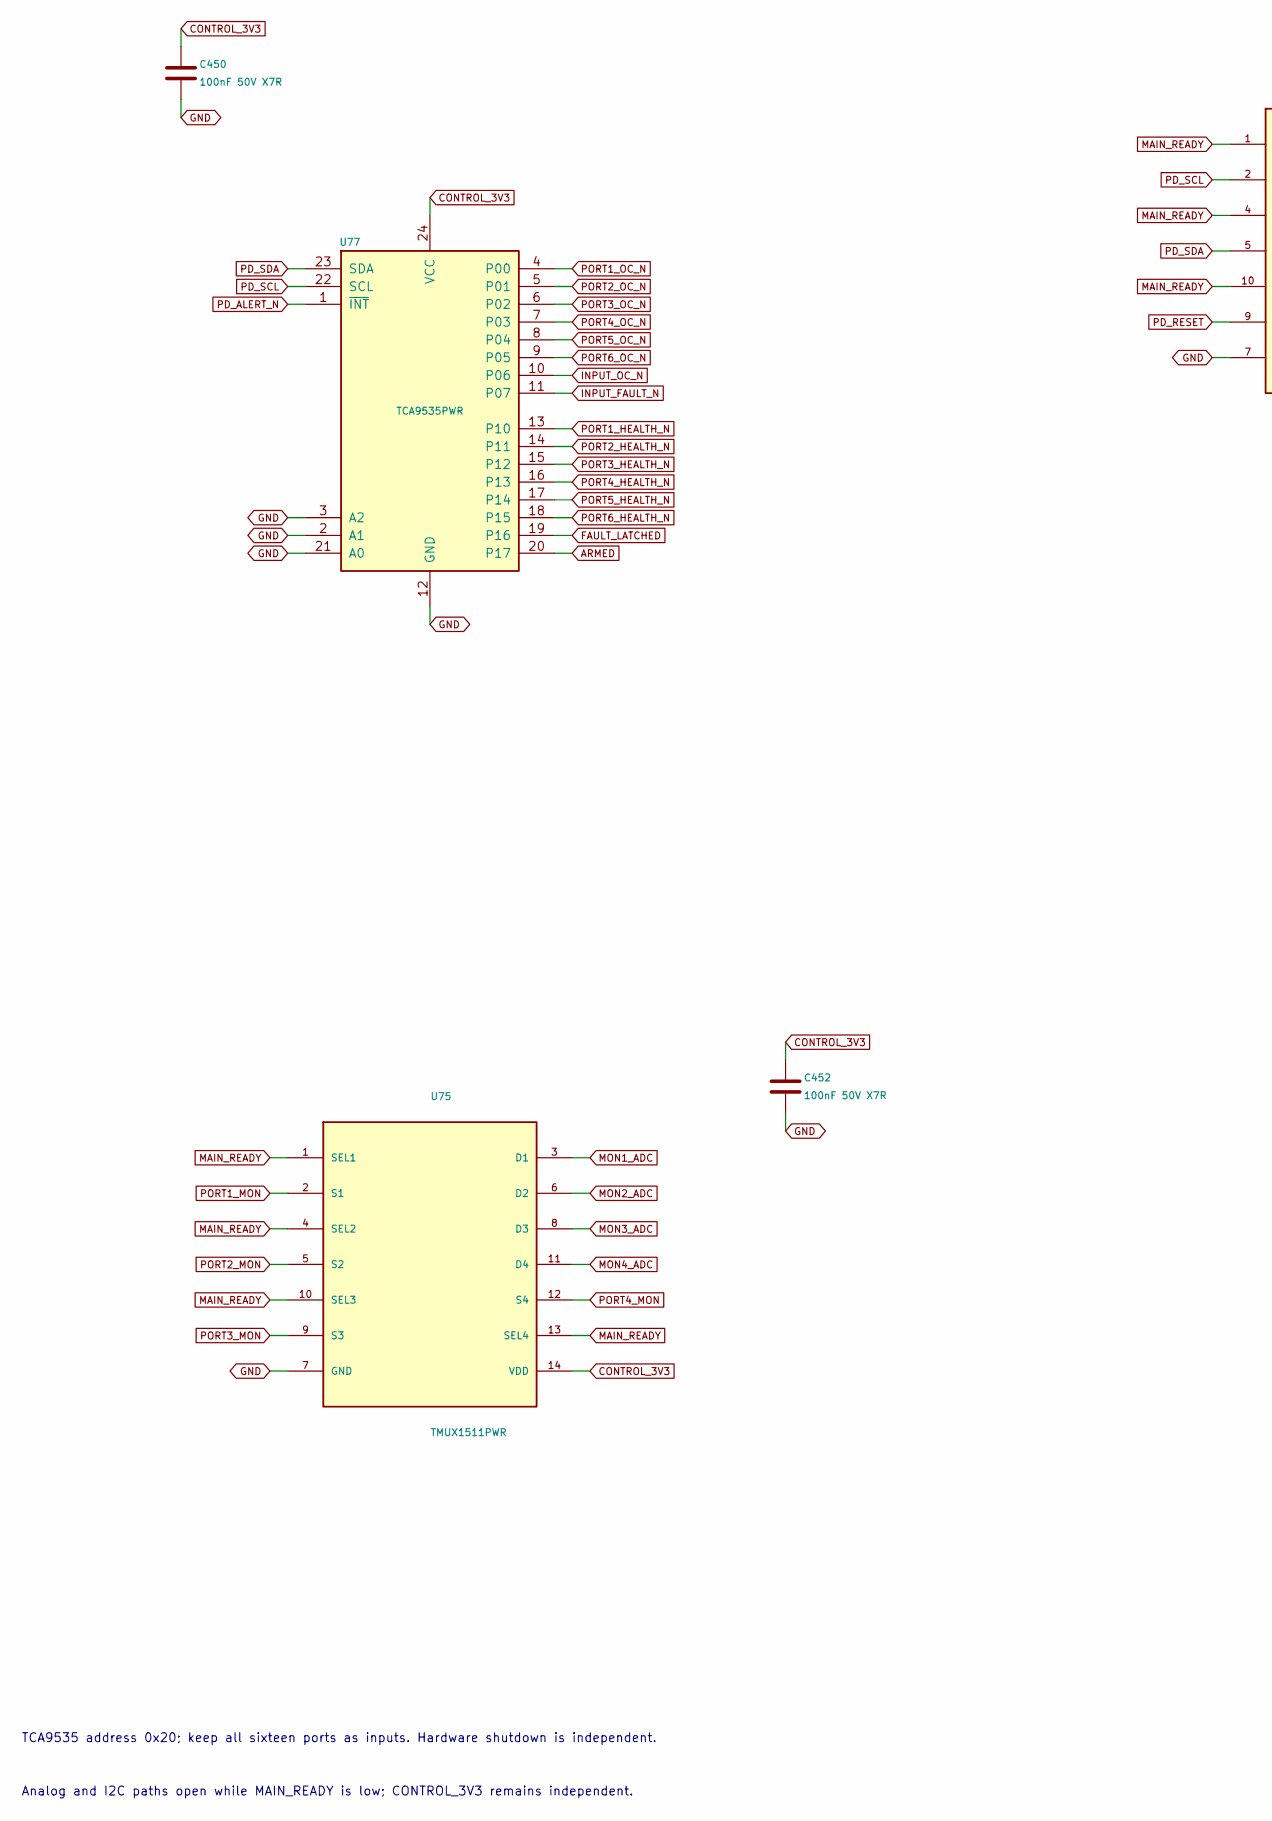
[picture p78: schematic monitoring.kicad_sch, Klink Hub - monitoring, part in row 1, column 1]

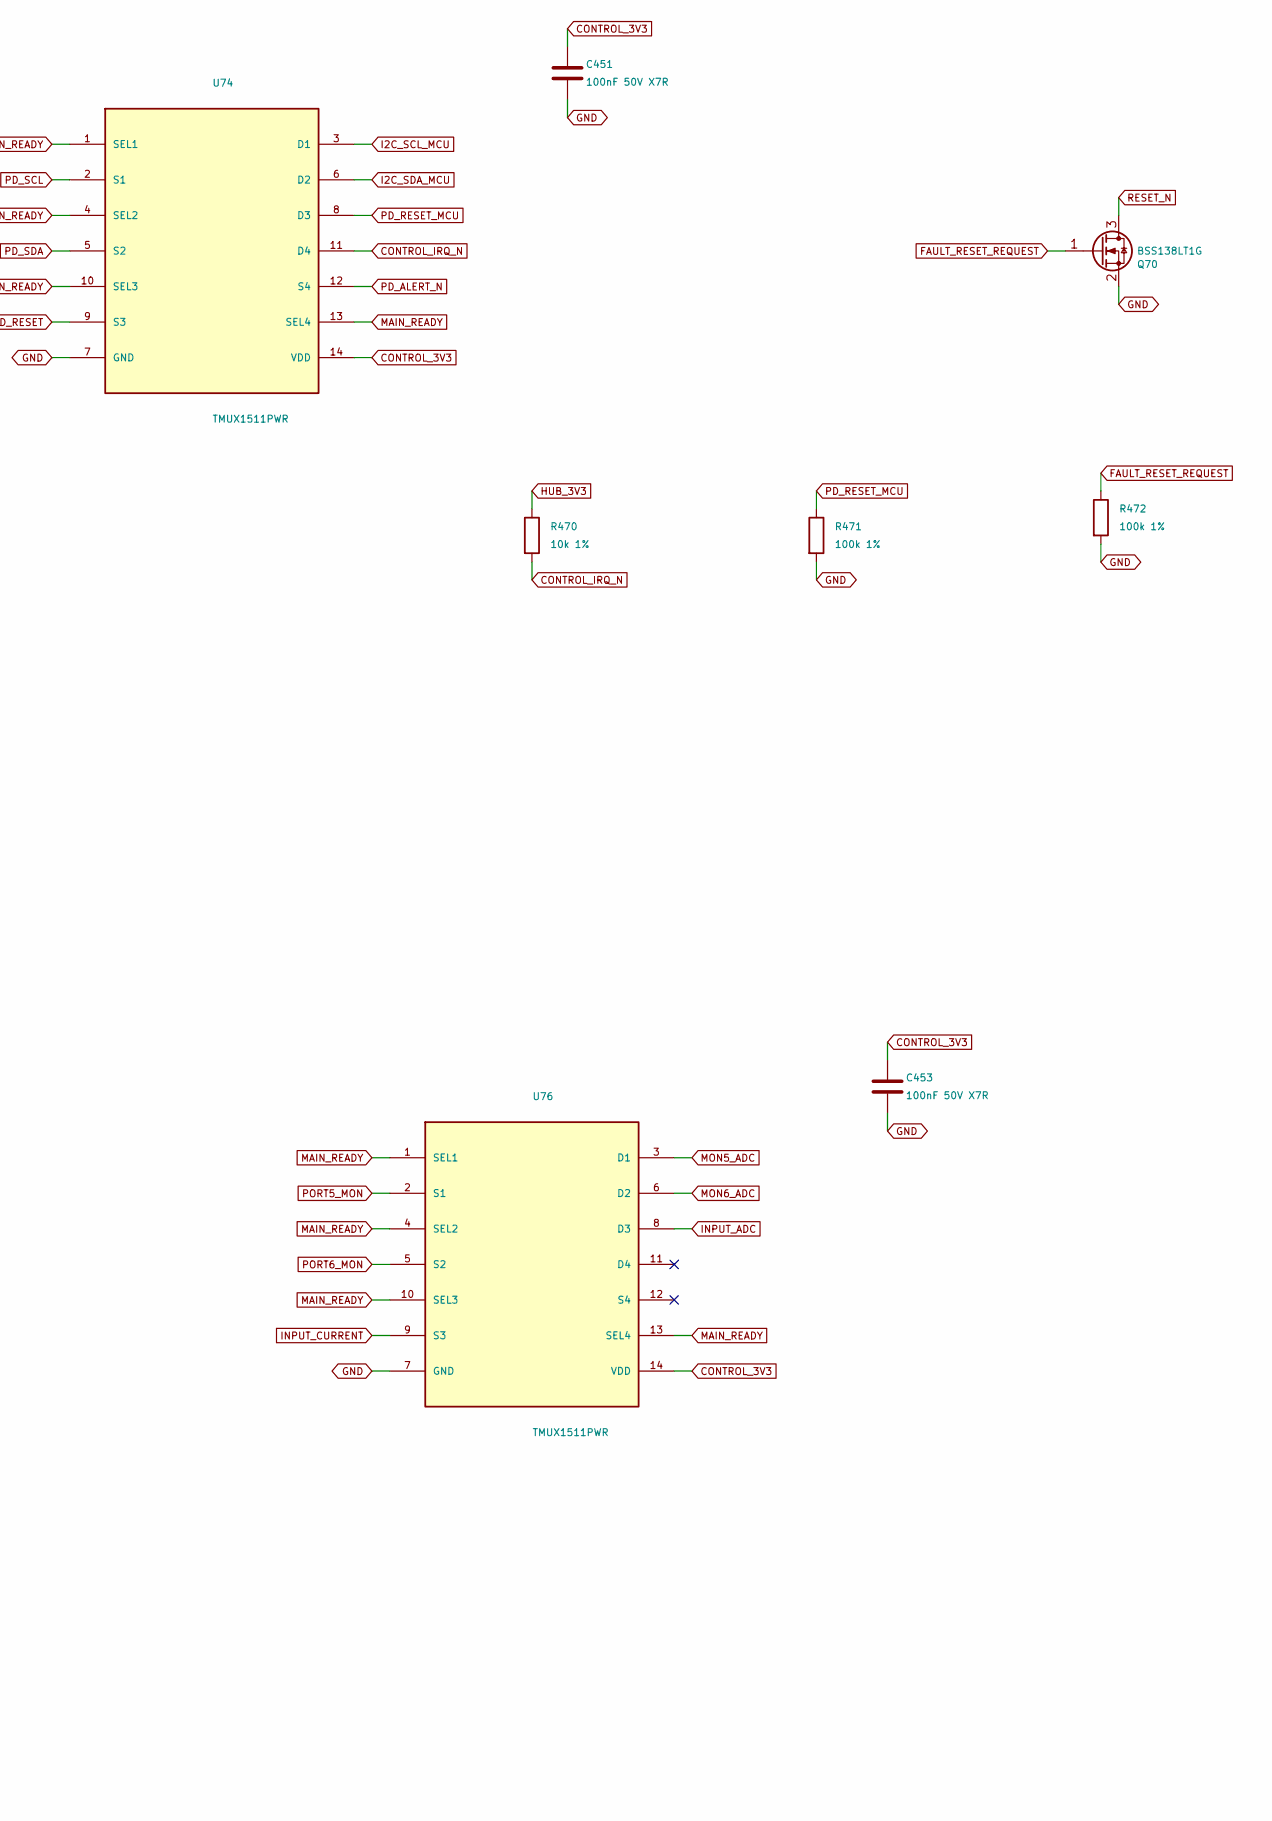
[picture p79: schematic monitoring.kicad_sch, Klink Hub - monitoring, part in row 1, column 2]

Parts:
C450, C451, C452, C453: 100nF 50V X7R; C_0805_2012Metric; MPN C2012X7R1H104K125AE
Q70: BSS138LT1G; SOT-23; MPN BSS138LT1G
R470: 10k 1%; R_0805_2012Metric; MPN RC0805FR-0710KL
R471, R472: 100k 1%; R_0805_2012Metric; MPN RC0805FR-07100KL
U74, U75, U76: TMUX1511PWR; TSSOP-14_4.4x5mm_P0.65mm; MPN TMUX1511PWR
U77: TCA9535PWR; TSSOP-24_4.4x7.8mm_P0.65mm; MPN TCA9535PWR

Connections:
ARMED: U77.20 (P17); also elsewhere on the board
CONTROL_3V3: C450.1, C451.1, C452.1, C453.1, U74.14 (VDD), U75.14 (VDD), U76.14 (VDD), U77.24 (VCC); also elsewhere on the board
CONTROL_IRQ_N: R470.2, U74.11 (D4); also elsewhere on the board
FAULT_LATCHED: U77.19 (P16); also elsewhere on the board
FAULT_RESET_REQUEST: Q70.1 (G), R472.1; also elsewhere on the board
GND: C450.2, C451.2, C452.2, C453.2, Q70.2 (S), R471.2, R472.2, U74.7 (GND), U75.7 (GND), U76.7 (GND), U77.2 (A1), U77.3 (A2), U77.12 (GND), U77.21 (A0); also elsewhere on the board
HUB_3V3: R470.1; also elsewhere on the board
I2C_SCL_MCU: U74.3 (D1); also elsewhere on the board
I2C_SDA_MCU: U74.6 (D2); also elsewhere on the board
INPUT_ADC: U76.8 (D3); also elsewhere on the board
INPUT_CURRENT: U76.9 (S3); also elsewhere on the board
INPUT_FAULT_N: U77.11 (P07); also elsewhere on the board
INPUT_OC_N: U77.10 (P06); also elsewhere on the board
MAIN_READY: U74.1 (SEL1), U74.4 (SEL2), U74.10 (SEL3), U74.13 (SEL4), U75.1 (SEL1), U75.4 (SEL2), U75.10 (SEL3), U75.13 (SEL4), U76.1 (SEL1), U76.4 (SEL2), U76.10 (SEL3), U76.13 (SEL4); also elsewhere on the board
MON1_ADC: U75.3 (D1); also elsewhere on the board
MON2_ADC: U75.6 (D2); also elsewhere on the board
MON3_ADC: U75.8 (D3); also elsewhere on the board
MON4_ADC: U75.11 (D4); also elsewhere on the board
MON5_ADC: U76.3 (D1); also elsewhere on the board
MON6_ADC: U76.6 (D2); also elsewhere on the board
PD_ALERT_N: U74.12 (S4), U77.1 (~INT); also elsewhere on the board
PD_RESET: U74.9 (S3); also elsewhere on the board
PD_RESET_MCU: R471.1, U74.8 (D3); also elsewhere on the board
PD_SCL: U74.2 (S1), U77.22 (SCL); also elsewhere on the board
PD_SDA: U74.5 (S2), U77.23 (SDA); also elsewhere on the board
PORT1_HEALTH_N: U77.13 (P10); also elsewhere on the board
PORT1_MON: U75.2 (S1); also elsewhere on the board
PORT1_OC_N: U77.4 (P00); also elsewhere on the board
PORT2_HEALTH_N: U77.14 (P11); also elsewhere on the board
PORT2_MON: U75.5 (S2); also elsewhere on the board
PORT2_OC_N: U77.5 (P01); also elsewhere on the board
PORT3_HEALTH_N: U77.15 (P12); also elsewhere on the board
PORT3_MON: U75.9 (S3); also elsewhere on the board
PORT3_OC_N: U77.6 (P02); also elsewhere on the board
PORT4_HEALTH_N: U77.16 (P13); also elsewhere on the board
PORT4_MON: U75.12 (S4); also elsewhere on the board
PORT4_OC_N: U77.7 (P03); also elsewhere on the board
PORT5_HEALTH_N: U77.17 (P14); also elsewhere on the board
PORT5_MON: U76.2 (S1); also elsewhere on the board
PORT5_OC_N: U77.8 (P04); also elsewhere on the board
PORT6_HEALTH_N: U77.18 (P15); also elsewhere on the board
PORT6_MON: U76.5 (S2); also elsewhere on the board
PORT6_OC_N: U77.9 (P05); also elsewhere on the board
RESET_N: Q70.3 (D); also elsewhere on the board

Notes on the sheet:
TCA9535 address 0x20; keep all sixteen ports as inputs. Hardware shutdown is independent.
Analog and I2C paths open while MAIN_READY is low; CONTROL_3V3 remains independent.

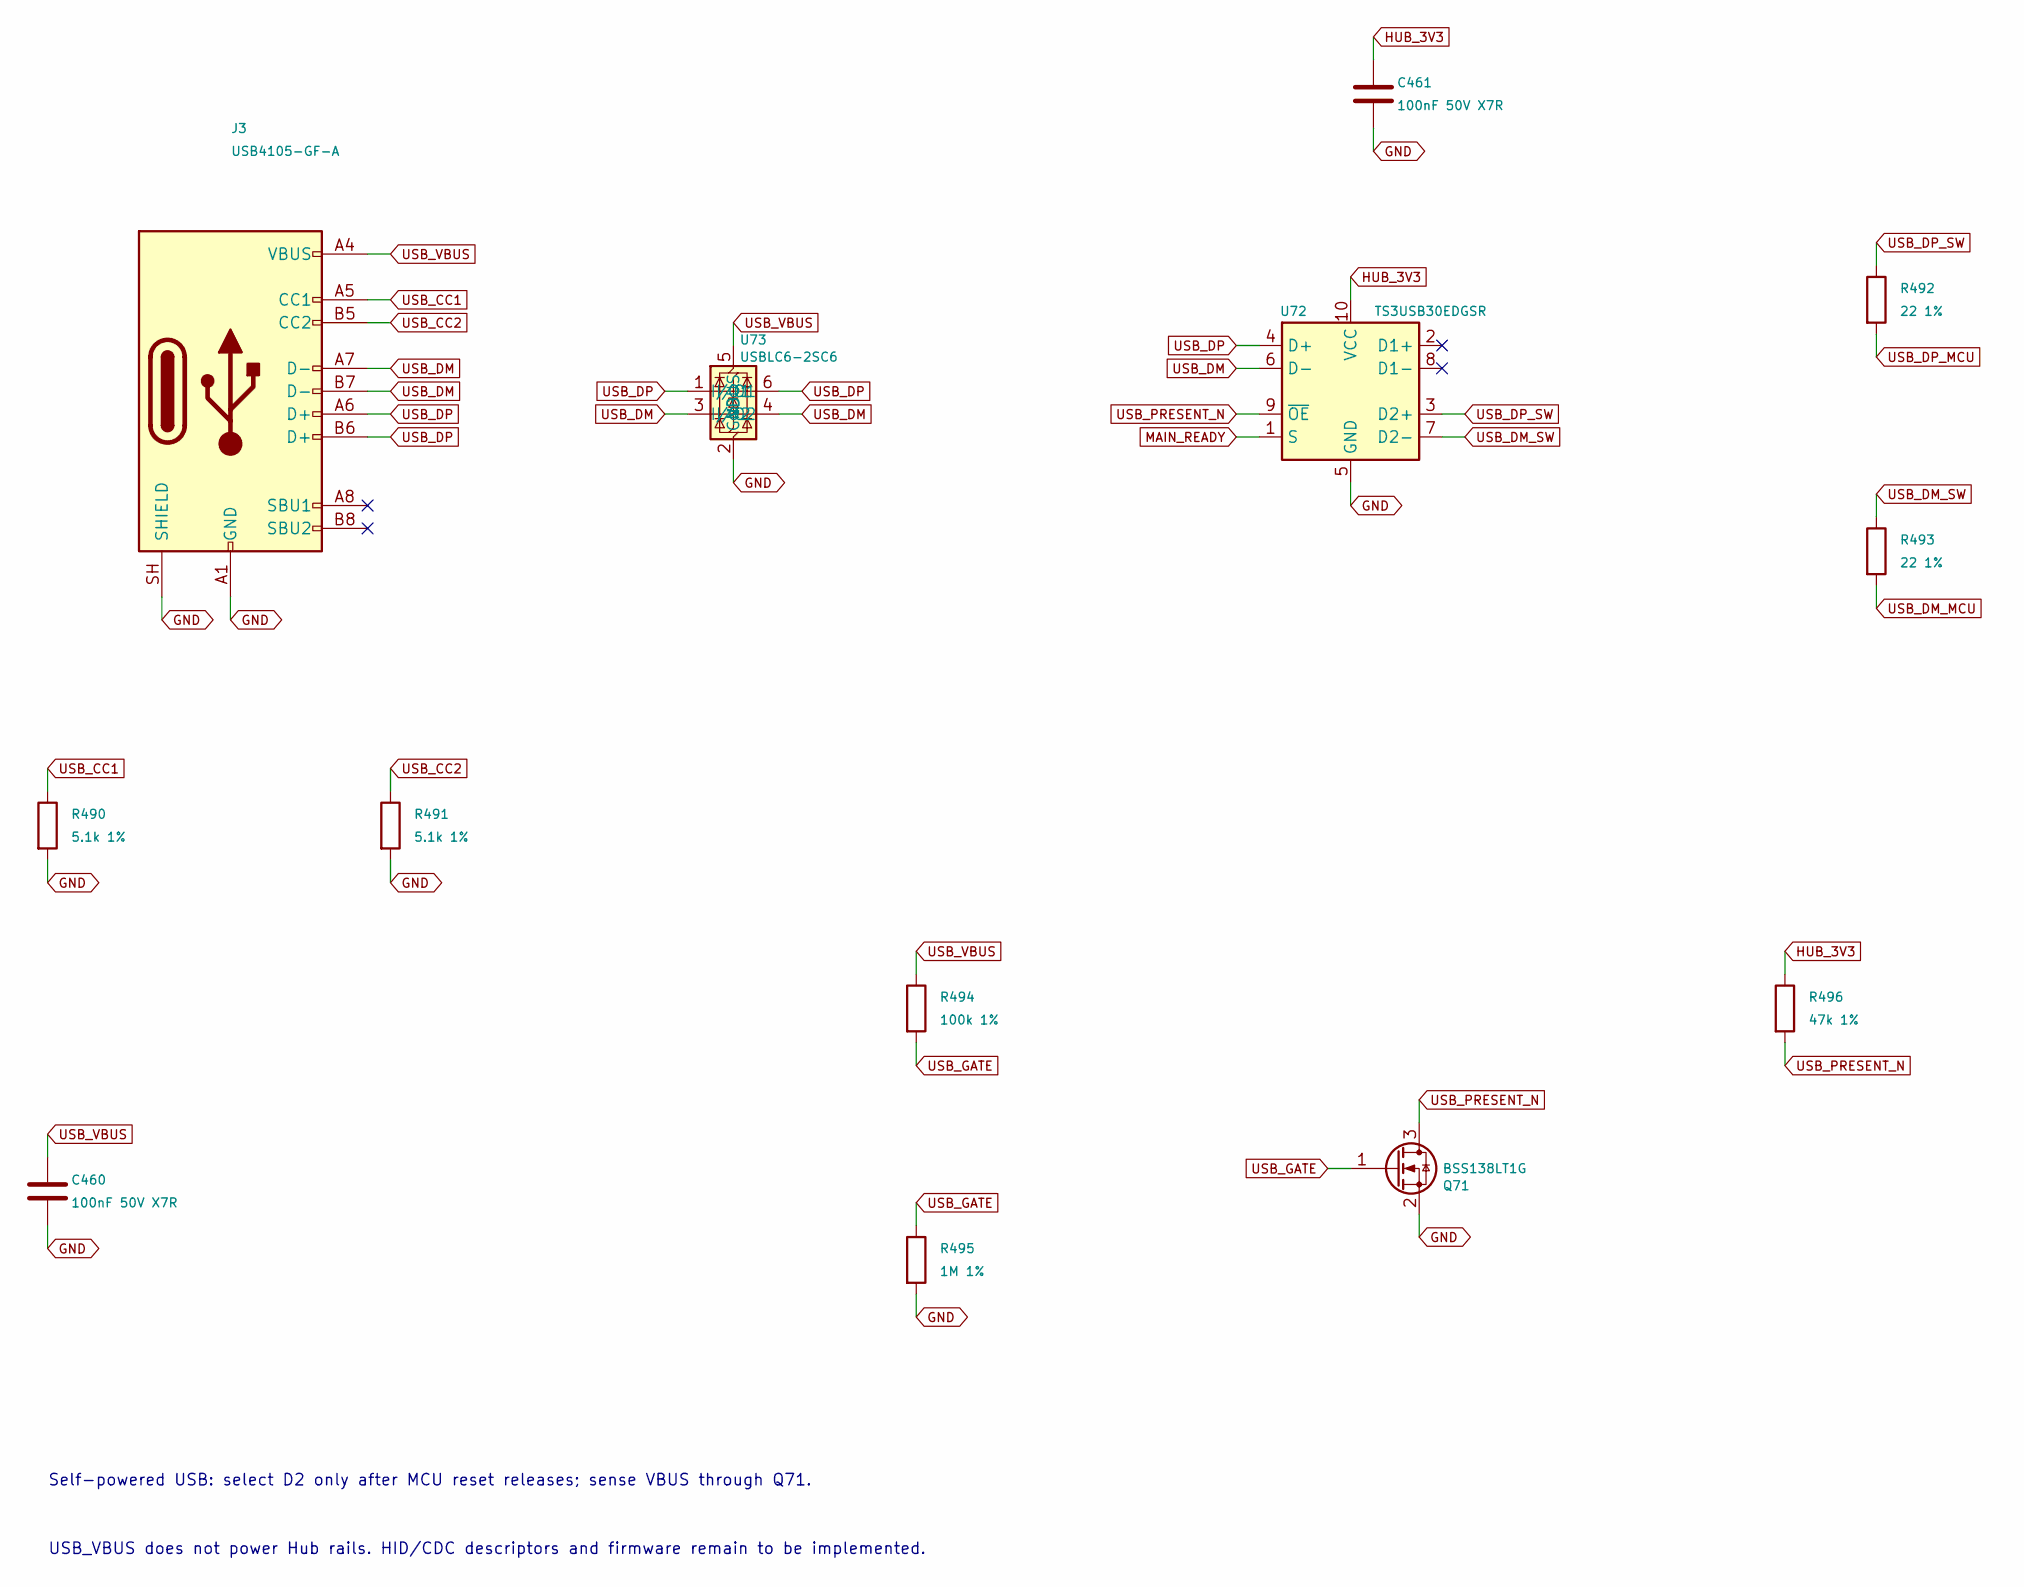
[picture p80: schematic usb-data.kicad_sch, Klink Hub - USB data]

Parts:
C460, C461: 100nF 50V X7R; C_0805_2012Metric; MPN C2012X7R1H104K125AE
J3: USB4105-GF-A; USB_C_Receptacle_GCT_USB4105_RoundedGround; MPN USB4105-GF-A
Q71: BSS138LT1G; SOT-23; MPN BSS138LT1G
R490, R491: 5.1k 1%; R_0805_2012Metric; MPN RC0805FR-075K1L
R492, R493: 22 1%; R_0805_2012Metric; MPN RC0805FR-0722RL
R494: 100k 1%; R_0805_2012Metric; MPN RC0805FR-07100KL
R495: 1M 1%; R_0805_2012Metric; MPN RC0805FR-071ML
R496: 47k 1%; R_0805_2012Metric; MPN RC0805FR-0747KL
U72: TS3USB30EDGSR; TSSOP-10_3x3mm_P0.5mm; MPN TS3USB30EDGSR
U73: USBLC6-2SC6; SOT-23-6; MPN USBLC6-2SC6

Connections:
GND: C460.2, C461.2, J3.A1 (GND), J3.A12 (GND), J3.B1 (GND), J3.B12 (GND), J3.SH (SHIELD), Q71.2 (S), R490.2, R491.2, R495.2, U72.5 (GND), U73.2 (GND); also elsewhere on the board
HUB_3V3: C461.1, R496.1, U72.10 (VCC); also elsewhere on the board
MAIN_READY: U72.1 (S); also elsewhere on the board
USB_CC1: J3.A5 (CC1), R490.1
USB_CC2: J3.B5 (CC2), R491.1
USB_DM: J3.A7 (D-), J3.B7 (D-), U72.6 (D-), U73.3 (I/O2), U73.4 (I/O2)
USB_DM_MCU: R493.2; also elsewhere on the board
USB_DM_SW: R493.1, U72.7 (D2-)
USB_DP: J3.A6 (D+), J3.B6 (D+), U72.4 (D+), U73.1 (I/O1), U73.6 (I/O1)
USB_DP_MCU: R492.2; also elsewhere on the board
USB_DP_SW: R492.1, U72.3 (D2+)
USB_GATE: Q71.1 (G), R494.2, R495.1
USB_PRESENT_N: Q71.3 (D), R496.2, U72.9 (~OE); also elsewhere on the board
USB_VBUS: C460.1, J3.A4 (VBUS), J3.A9 (VBUS), J3.B4 (VBUS), J3.B9 (VBUS), R494.1, U73.5 (VBUS)

Notes on the sheet:
Self-powered USB: select D2 only after MCU reset releases; sense VBUS through Q71.
USB_VBUS does not power Hub rails. HID/CDC descriptors and firmware remain to be implemented.

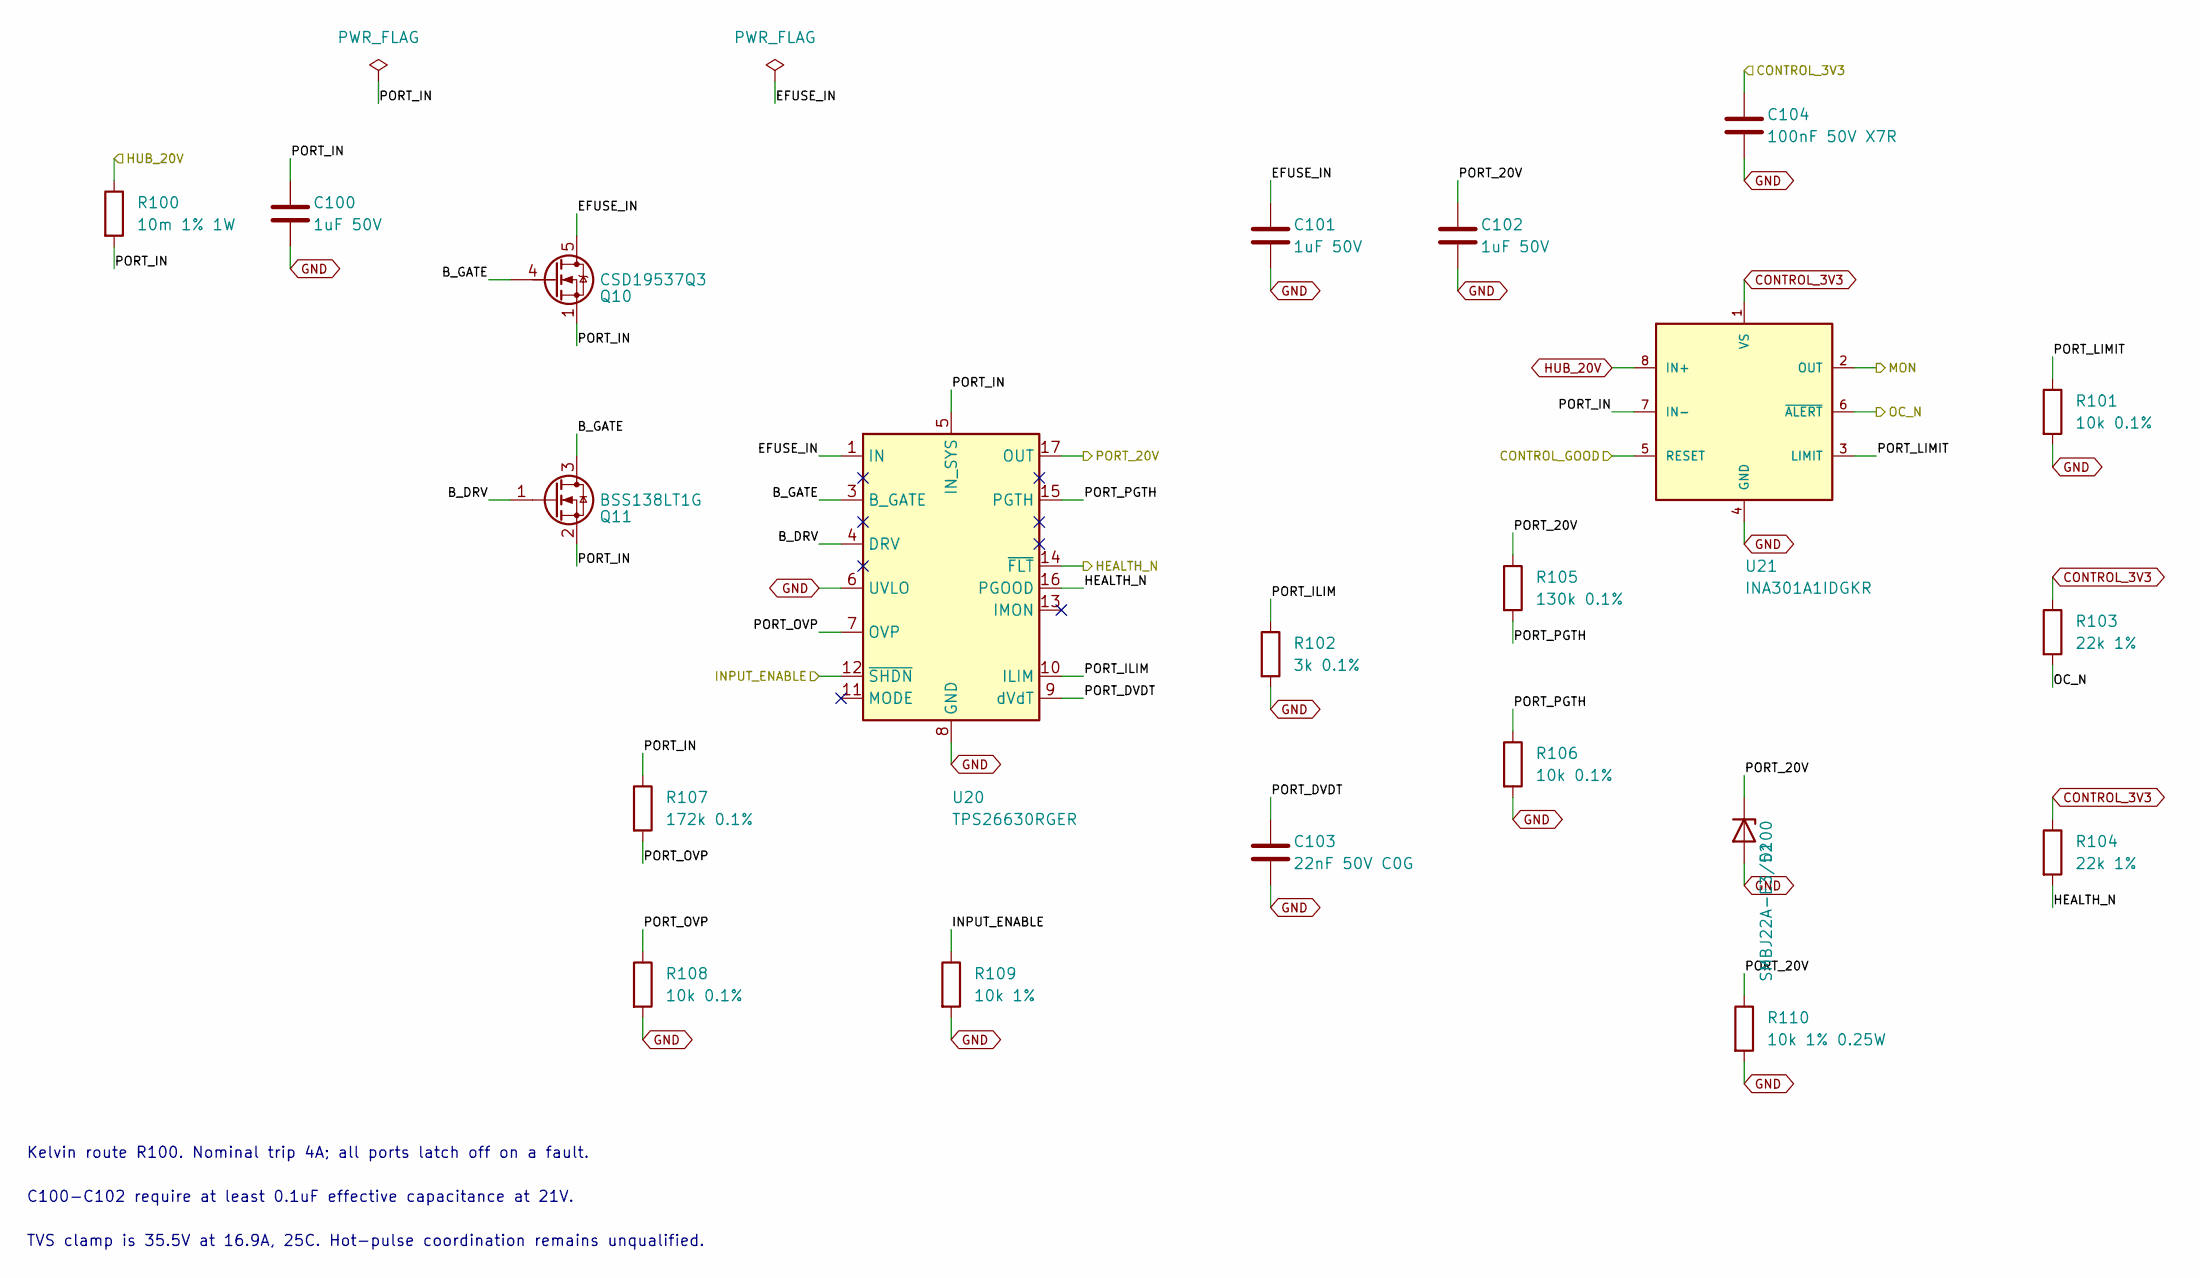
[picture p81: schematic port-power.kicad_sch, Klink Hub - port power]

Parts:
C100, C101, C102: 1uF 50V; C_0805_2012Metric; MPN C2012X7R1H105K125AB
C103: 22nF 50V C0G; C_TDK_C2012_Reflow; MPN C2012C0G1H223J125AA
C104: 100nF 50V X7R; C_0805_2012Metric; MPN C2012X7R1H104K125AE
D100: SMBJ22A-E3/52; D_SMB; MPN SMBJ22A-E3/52
Q10: CSD19537Q3; CSD19537Q3_TI; MPN CSD19537Q3
Q11: BSS138LT1G; SOT-23; MPN BSS138LT1G
R100: 10m 1% 1W; R_Vishay_WSL2512_10m; MPN WSL2512R0100FEA
R101, R106, R108: 10k 0.1%; R_0805_2012Metric; MPN TNPW080510K0BEEA
R102: 3k 0.1%; R_0805_2012Metric; MPN TNPW08053K00BEEA
R103, R104: 22k 1%; R_0805_2012Metric; MPN RC0805FR-0722KL
R105: 130k 0.1%; R_0805_2012Metric; MPN TNPW0805130KBEEA
R107: 172k 0.1%; R_0805_2012Metric; MPN TNPW0805172KBEEA
R109: 10k 1%; R_0805_2012Metric; MPN RC0805FR-0710KL
R110: 10k 1% 0.25W; R_1206_3216Metric; MPN RC1206FR0710KL
U20: TPS26630RGER; Texas_RGE0024H_VQFN-24-1EP_4x4mm_P0.5mm_EP2.7x2.7mm_Thermal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; MPN TPS26630RGER
U21: INA301A1IDGKR; VSSOP-8_3x3mm_P0.65mm; MPN INA301A1IDGKR

Connections:
/Distribution/PORT1_20V: C102.1, D100.1 (K), R105.1, R110.1, U20.17 (OUT), U20.18 (OUT); also elsewhere on the board
/Distribution/Port 1/B_DRV: Q11.1 (G), U20.4 (DRV)
/Distribution/Port 1/B_GATE: Q10.4 (G), Q11.3 (D), U20.3 (B_GATE)
/Distribution/Port 1/EFUSE_IN: C101.1, Q10.5 (D), U20.1 (IN), U20.2 (IN)
/Distribution/Port 1/PORT_DVDT: C103.1, U20.9 (dVdT)
/Distribution/Port 1/PORT_ILIM: R102.1, U20.10 (ILIM)
/Distribution/Port 1/PORT_IN: C100.1, Q10.1 (S), Q10.2 (S), Q10.3 (S), Q11.2 (S), R100.2, R107.1, U20.5 (IN_SYS), U21.7 (IN-)
/Distribution/Port 1/PORT_LIMIT: R101.1, U21.3 (LIMIT)
/Distribution/Port 1/PORT_OVP: R107.2, R108.1, U20.7 (OVP)
/Distribution/Port 1/PORT_PGTH: R105.2, R106.1, U20.15 (PGTH)
/INPUT_ENABLE: R109.1, U20.12 (~SHDN); also elsewhere on the board
CONTROL_3V3: C104.1, R103.1, R104.1, U21.1 (VS); also elsewhere on the board
CONTROL_GOOD: U21.5 (RESET); also elsewhere on the board
GND: C100.2, C101.2, C102.2, C103.2, C104.2, D100.2 (A), R101.2, R102.2, R106.2, R108.2, R109.2, R110.2, U20.6 (UVLO), U20.8 (GND), U20.25 (GND), U21.4 (GND); also elsewhere on the board
HUB_20V: R100.1, U21.8 (IN+); also elsewhere on the board
PORT1_HEALTH_N: R104.2, U20.14 (~FLT), U20.16 (PGOOD); also elsewhere on the board
PORT1_MON: U21.2 (OUT); also elsewhere on the board
PORT1_OC_N: R103.2, U21.6 (~ALERT); also elsewhere on the board

Parts of its further copies:
C110, C111, C112, C120, C121, C122, C130, C131, C132, C140, C141, C142, C150, C151, C152: 1uF 50V; C_0805_2012Metric; MPN C2012X7R1H105K125AB
C113, C123, C133, C143, C153: 22nF 50V C0G; C_TDK_C2012_Reflow; MPN C2012C0G1H223J125AA
C114, C124, C134, C144, C154: 100nF 50V X7R; C_0805_2012Metric; MPN C2012X7R1H104K125AE
D101, D102, D103, D104, D105: SMBJ22A-E3/52; D_SMB; MPN SMBJ22A-E3/52
Q12, Q14, Q16, Q18, Q20: CSD19537Q3; CSD19537Q3_TI; MPN CSD19537Q3
Q13, Q15, Q17, Q19, Q21: BSS138LT1G; SOT-23; MPN BSS138LT1G
R120, R140, R160, R180, R200: 10m 1% 1W; R_Vishay_WSL2512_10m; MPN WSL2512R0100FEA
R121, R126, R128, R141, R146, R148, R161, R166, R168, R181, R186, R188, R201, R206, R208: 10k 0.1%; R_0805_2012Metric; MPN TNPW080510K0BEEA
R122, R142, R162, R182, R202: 3k 0.1%; R_0805_2012Metric; MPN TNPW08053K00BEEA
R123, R124, R143, R144, R163, R164, R183, R184, R203, R204: 22k 1%; R_0805_2012Metric; MPN RC0805FR-0722KL
R125, R145, R165, R185, R205: 130k 0.1%; R_0805_2012Metric; MPN TNPW0805130KBEEA
R127, R147, R167, R187, R207: 172k 0.1%; R_0805_2012Metric; MPN TNPW0805172KBEEA
R129, R149, R169, R189, R209: 10k 1%; R_0805_2012Metric; MPN RC0805FR-0710KL
R130, R150, R170, R190, R210: 10k 1% 0.25W; R_1206_3216Metric; MPN RC1206FR0710KL
U22, U24, U26, U28, U30: TPS26630RGER; Texas_RGE0024H_VQFN-24-1EP_4x4mm_P0.5mm_EP2.7x2.7mm_Thermal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; MPN TPS26630RGER
U23, U25, U27, U29, U31: INA301A1IDGKR; VSSOP-8_3x3mm_P0.65mm; MPN INA301A1IDGKR

Connections of its further copies:
/Distribution/PORT2_20V: C112.1, D101.1 (K), R125.1, R130.1, U22.17 (OUT), U22.18 (OUT); also elsewhere on the board
/Distribution/PORT3_20V: C122.1, D102.1 (K), R145.1, R150.1, U24.17 (OUT), U24.18 (OUT); also elsewhere on the board
/Distribution/PORT4_20V: C132.1, D103.1 (K), R165.1, R170.1, U26.17 (OUT), U26.18 (OUT); also elsewhere on the board
/Distribution/PORT5_20V: C142.1, D104.1 (K), R185.1, R190.1, U28.17 (OUT), U28.18 (OUT); also elsewhere on the board
/Distribution/PORT6_20V: C152.1, D105.1 (K), R205.1, R210.1, U30.17 (OUT), U30.18 (OUT); also elsewhere on the board
/Distribution/Port 2/B_DRV: Q13.1 (G), U22.4 (DRV)
/Distribution/Port 2/B_GATE: Q12.4 (G), Q13.3 (D), U22.3 (B_GATE)
/Distribution/Port 2/EFUSE_IN: C111.1, Q12.5 (D), U22.1 (IN), U22.2 (IN)
/Distribution/Port 2/PORT_DVDT: C113.1, U22.9 (dVdT)
/Distribution/Port 2/PORT_ILIM: R122.1, U22.10 (ILIM)
/Distribution/Port 2/PORT_IN: C110.1, Q12.1 (S), Q12.2 (S), Q12.3 (S), Q13.2 (S), R120.2, R127.1, U22.5 (IN_SYS), U23.7 (IN-)
/Distribution/Port 2/PORT_LIMIT: R121.1, U23.3 (LIMIT)
/Distribution/Port 2/PORT_OVP: R127.2, R128.1, U22.7 (OVP)
/Distribution/Port 2/PORT_PGTH: R125.2, R126.1, U22.15 (PGTH)
/Distribution/Port 3/B_DRV: Q15.1 (G), U24.4 (DRV)
/Distribution/Port 3/B_GATE: Q14.4 (G), Q15.3 (D), U24.3 (B_GATE)
/Distribution/Port 3/EFUSE_IN: C121.1, Q14.5 (D), U24.1 (IN), U24.2 (IN)
/Distribution/Port 3/PORT_DVDT: C123.1, U24.9 (dVdT)
/Distribution/Port 3/PORT_ILIM: R142.1, U24.10 (ILIM)
/Distribution/Port 3/PORT_IN: C120.1, Q14.1 (S), Q14.2 (S), Q14.3 (S), Q15.2 (S), R140.2, R147.1, U24.5 (IN_SYS), U25.7 (IN-)
/Distribution/Port 3/PORT_LIMIT: R141.1, U25.3 (LIMIT)
/Distribution/Port 3/PORT_OVP: R147.2, R148.1, U24.7 (OVP)
/Distribution/Port 3/PORT_PGTH: R145.2, R146.1, U24.15 (PGTH)
/Distribution/Port 4/B_DRV: Q17.1 (G), U26.4 (DRV)
/Distribution/Port 4/B_GATE: Q16.4 (G), Q17.3 (D), U26.3 (B_GATE)
/Distribution/Port 4/EFUSE_IN: C131.1, Q16.5 (D), U26.1 (IN), U26.2 (IN)
/Distribution/Port 4/PORT_DVDT: C133.1, U26.9 (dVdT)
/Distribution/Port 4/PORT_ILIM: R162.1, U26.10 (ILIM)
/Distribution/Port 4/PORT_IN: C130.1, Q16.1 (S), Q16.2 (S), Q16.3 (S), Q17.2 (S), R160.2, R167.1, U26.5 (IN_SYS), U27.7 (IN-)
/Distribution/Port 4/PORT_LIMIT: R161.1, U27.3 (LIMIT)
/Distribution/Port 4/PORT_OVP: R167.2, R168.1, U26.7 (OVP)
/Distribution/Port 4/PORT_PGTH: R165.2, R166.1, U26.15 (PGTH)
/Distribution/Port 5/B_DRV: Q19.1 (G), U28.4 (DRV)
/Distribution/Port 5/B_GATE: Q18.4 (G), Q19.3 (D), U28.3 (B_GATE)
/Distribution/Port 5/EFUSE_IN: C141.1, Q18.5 (D), U28.1 (IN), U28.2 (IN)
/Distribution/Port 5/PORT_DVDT: C143.1, U28.9 (dVdT)
/Distribution/Port 5/PORT_ILIM: R182.1, U28.10 (ILIM)
/Distribution/Port 5/PORT_IN: C140.1, Q18.1 (S), Q18.2 (S), Q18.3 (S), Q19.2 (S), R180.2, R187.1, U28.5 (IN_SYS), U29.7 (IN-)
/Distribution/Port 5/PORT_LIMIT: R181.1, U29.3 (LIMIT)
/Distribution/Port 5/PORT_OVP: R187.2, R188.1, U28.7 (OVP)
/Distribution/Port 5/PORT_PGTH: R185.2, R186.1, U28.15 (PGTH)
/Distribution/Port 6/B_DRV: Q21.1 (G), U30.4 (DRV)
/Distribution/Port 6/B_GATE: Q20.4 (G), Q21.3 (D), U30.3 (B_GATE)
/Distribution/Port 6/EFUSE_IN: C151.1, Q20.5 (D), U30.1 (IN), U30.2 (IN)
/Distribution/Port 6/PORT_DVDT: C153.1, U30.9 (dVdT)
/Distribution/Port 6/PORT_ILIM: R202.1, U30.10 (ILIM)
/Distribution/Port 6/PORT_IN: C150.1, Q20.1 (S), Q20.2 (S), Q20.3 (S), Q21.2 (S), R200.2, R207.1, U30.5 (IN_SYS), U31.7 (IN-)
/Distribution/Port 6/PORT_LIMIT: R201.1, U31.3 (LIMIT)
/Distribution/Port 6/PORT_OVP: R207.2, R208.1, U30.7 (OVP)
/Distribution/Port 6/PORT_PGTH: R205.2, R206.1, U30.15 (PGTH)
/INPUT_ENABLE: R129.1, R149.1, R169.1, R189.1, R209.1, U22.12 (~SHDN), U24.12 (~SHDN), U26.12 (~SHDN), U28.12 (~SHDN), U30.12 (~SHDN); also elsewhere on the board
CONTROL_3V3: C114.1, C124.1, C134.1, C144.1, C154.1, R123.1, R124.1, R143.1, R144.1, R163.1, R164.1, R183.1, R184.1, R203.1, R204.1, U23.1 (VS), U25.1 (VS), U27.1 (VS), U29.1 (VS), U31.1 (VS); also elsewhere on the board
CONTROL_GOOD: U23.5 (RESET), U25.5 (RESET), U27.5 (RESET), U29.5 (RESET), U31.5 (RESET); also elsewhere on the board
GND: C110.2, C111.2, C112.2, C113.2, C114.2, C120.2, C121.2, C122.2, C123.2, C124.2, C130.2, C131.2, C132.2, C133.2, C134.2, C140.2, C141.2, C142.2, C143.2, C144.2, C150.2, C151.2, C152.2, C153.2, C154.2, D101.2 (A), D102.2 (A), D103.2 (A), D104.2 (A), D105.2 (A), R121.2, R122.2, R126.2, R128.2, R129.2, R130.2, R141.2, R142.2, R146.2, R148.2, R149.2, R150.2, R161.2, R162.2, R166.2, R168.2, R169.2, R170.2, R181.2, R182.2, R186.2, R188.2, R189.2, R190.2, R201.2, R202.2, R206.2, R208.2, R209.2, R210.2, U22.6 (UVLO), U22.8 (GND), U22.25 (GND), U23.4 (GND), U24.6 (UVLO), U24.8 (GND), U24.25 (GND), U25.4 (GND), U26.6 (UVLO), U26.8 (GND), U26.25 (GND), U27.4 (GND), U28.6 (UVLO), U28.8 (GND), U28.25 (GND), U29.4 (GND), U30.6 (UVLO), U30.8 (GND), U30.25 (GND), U31.4 (GND); also elsewhere on the board
HUB_20V: R120.1, R140.1, R160.1, R180.1, R200.1, U23.8 (IN+), U25.8 (IN+), U27.8 (IN+), U29.8 (IN+), U31.8 (IN+); also elsewhere on the board
PORT2_HEALTH_N: R124.2, U22.14 (~FLT), U22.16 (PGOOD); also elsewhere on the board
PORT2_MON: U23.2 (OUT); also elsewhere on the board
PORT2_OC_N: R123.2, U23.6 (~ALERT); also elsewhere on the board
PORT3_HEALTH_N: R144.2, U24.14 (~FLT), U24.16 (PGOOD); also elsewhere on the board
PORT3_MON: U25.2 (OUT); also elsewhere on the board
PORT3_OC_N: R143.2, U25.6 (~ALERT); also elsewhere on the board
PORT4_HEALTH_N: R164.2, U26.14 (~FLT), U26.16 (PGOOD); also elsewhere on the board
PORT4_MON: U27.2 (OUT); also elsewhere on the board
PORT4_OC_N: R163.2, U27.6 (~ALERT); also elsewhere on the board
PORT5_HEALTH_N: R184.2, U28.14 (~FLT), U28.16 (PGOOD); also elsewhere on the board
PORT5_MON: U29.2 (OUT); also elsewhere on the board
PORT5_OC_N: R183.2, U29.6 (~ALERT); also elsewhere on the board
PORT6_HEALTH_N: R204.2, U30.14 (~FLT), U30.16 (PGOOD); also elsewhere on the board
PORT6_MON: U31.2 (OUT); also elsewhere on the board
PORT6_OC_N: R203.2, U31.6 (~ALERT); also elsewhere on the board

Notes on the sheet:
Kelvin route R100. Nominal trip 4A; all ports latch off on a fault.
C100-C102 require at least 0.1uF effective capacitance at 21V.
TVS clamp is 35.5V at 16.9A, 25C. Hot-pulse coordination remains unqualified.
