Bruhdows/klink/hardware/electronics/hub/hub.kicad_pcb

## KiCad design hardware/electronics/hub/hub.kicad_pcb (continued)

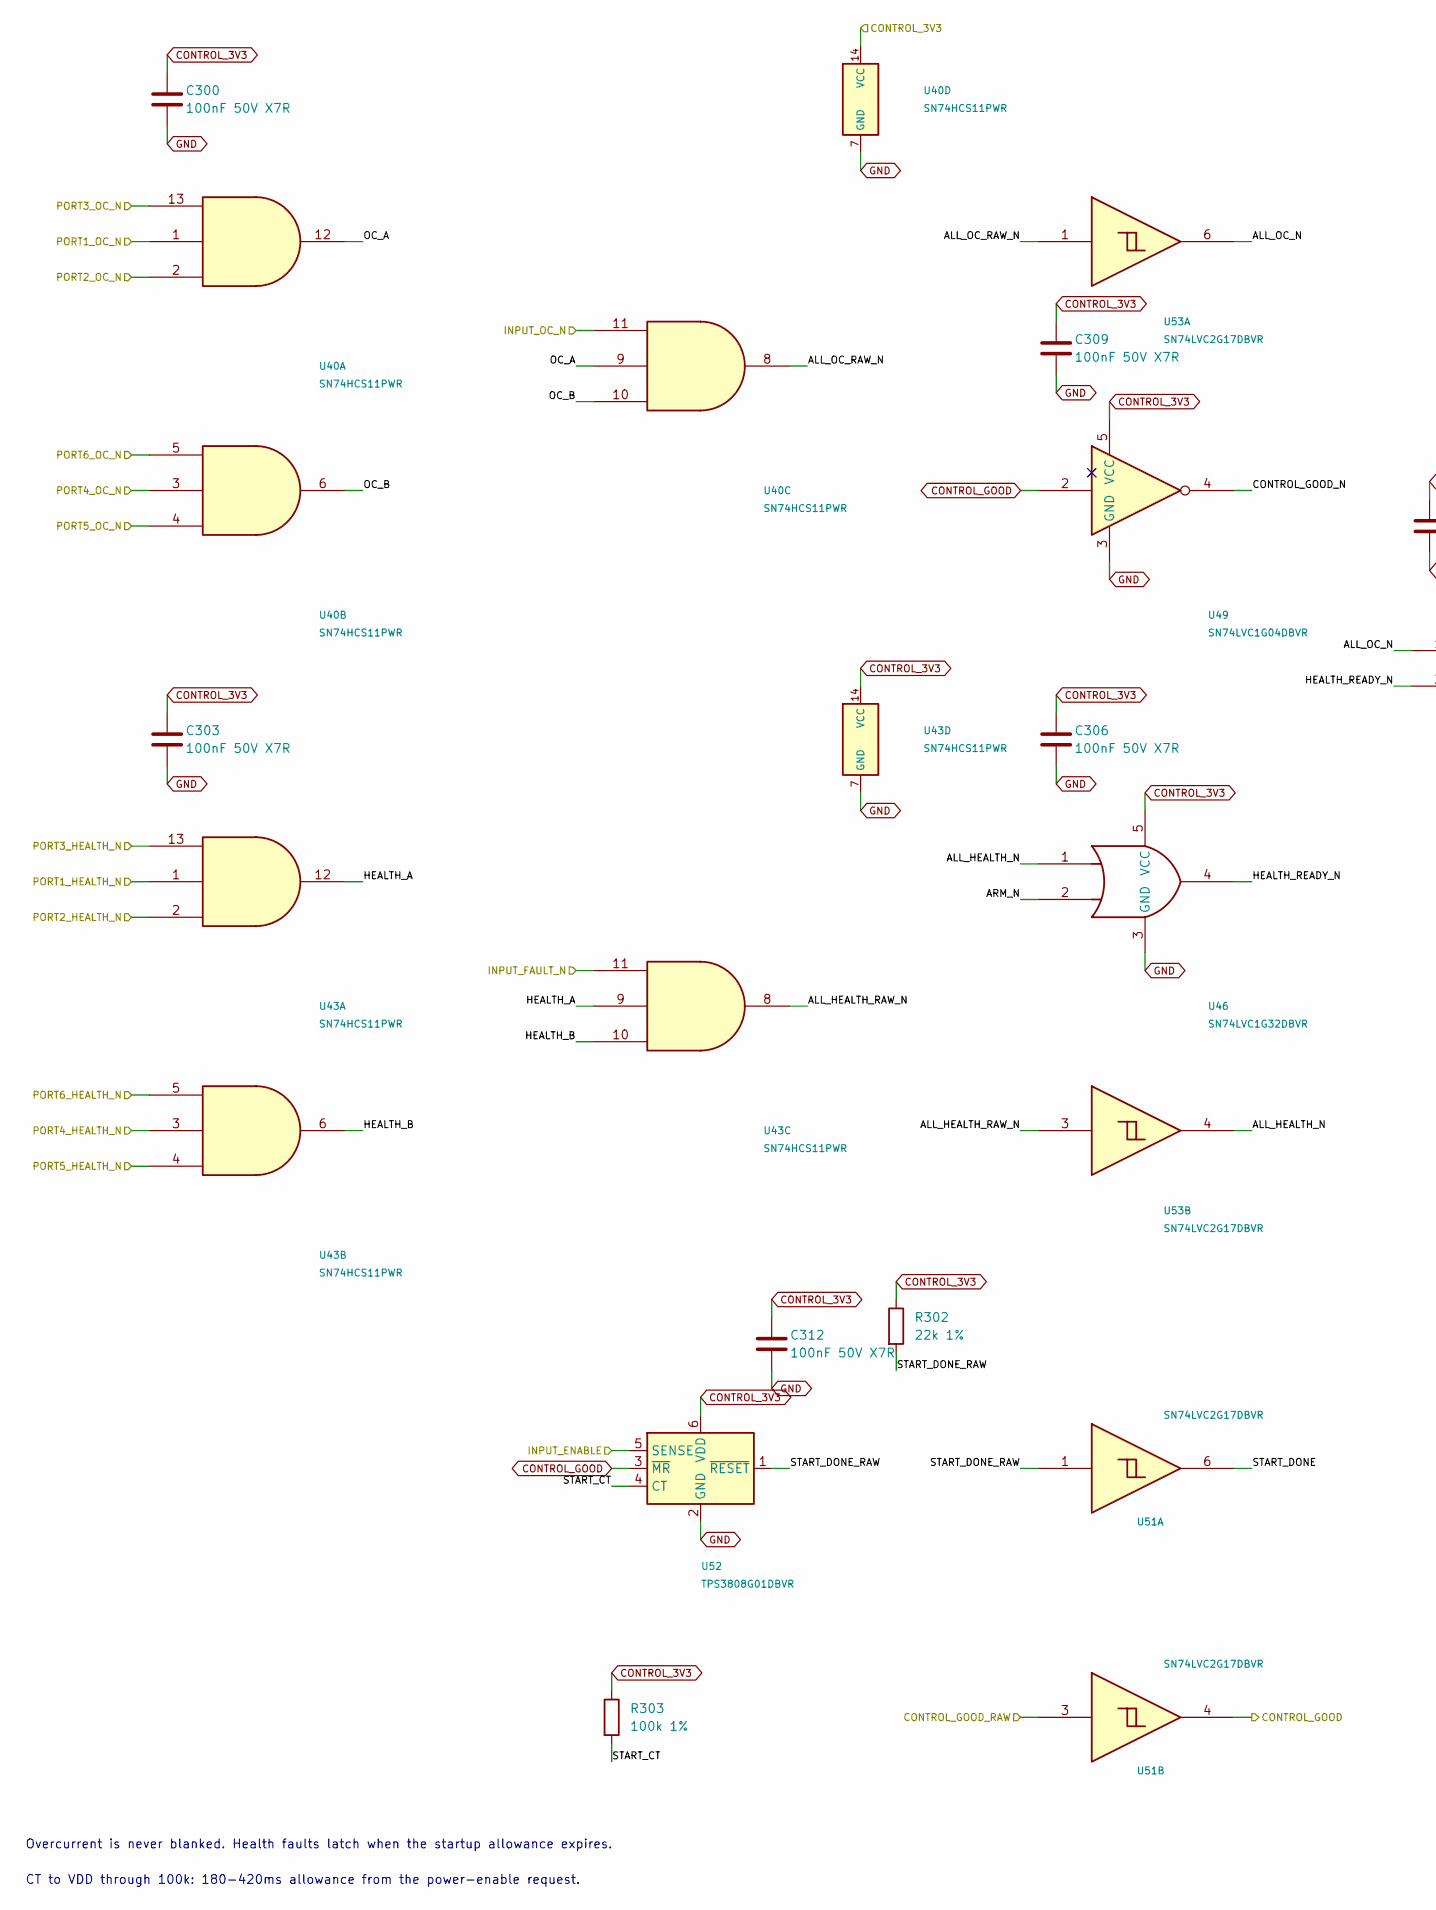
[picture p82: schematic shutdown.kicad_sch, Klink Hub - fault shutdown, part in row 1, column 1]

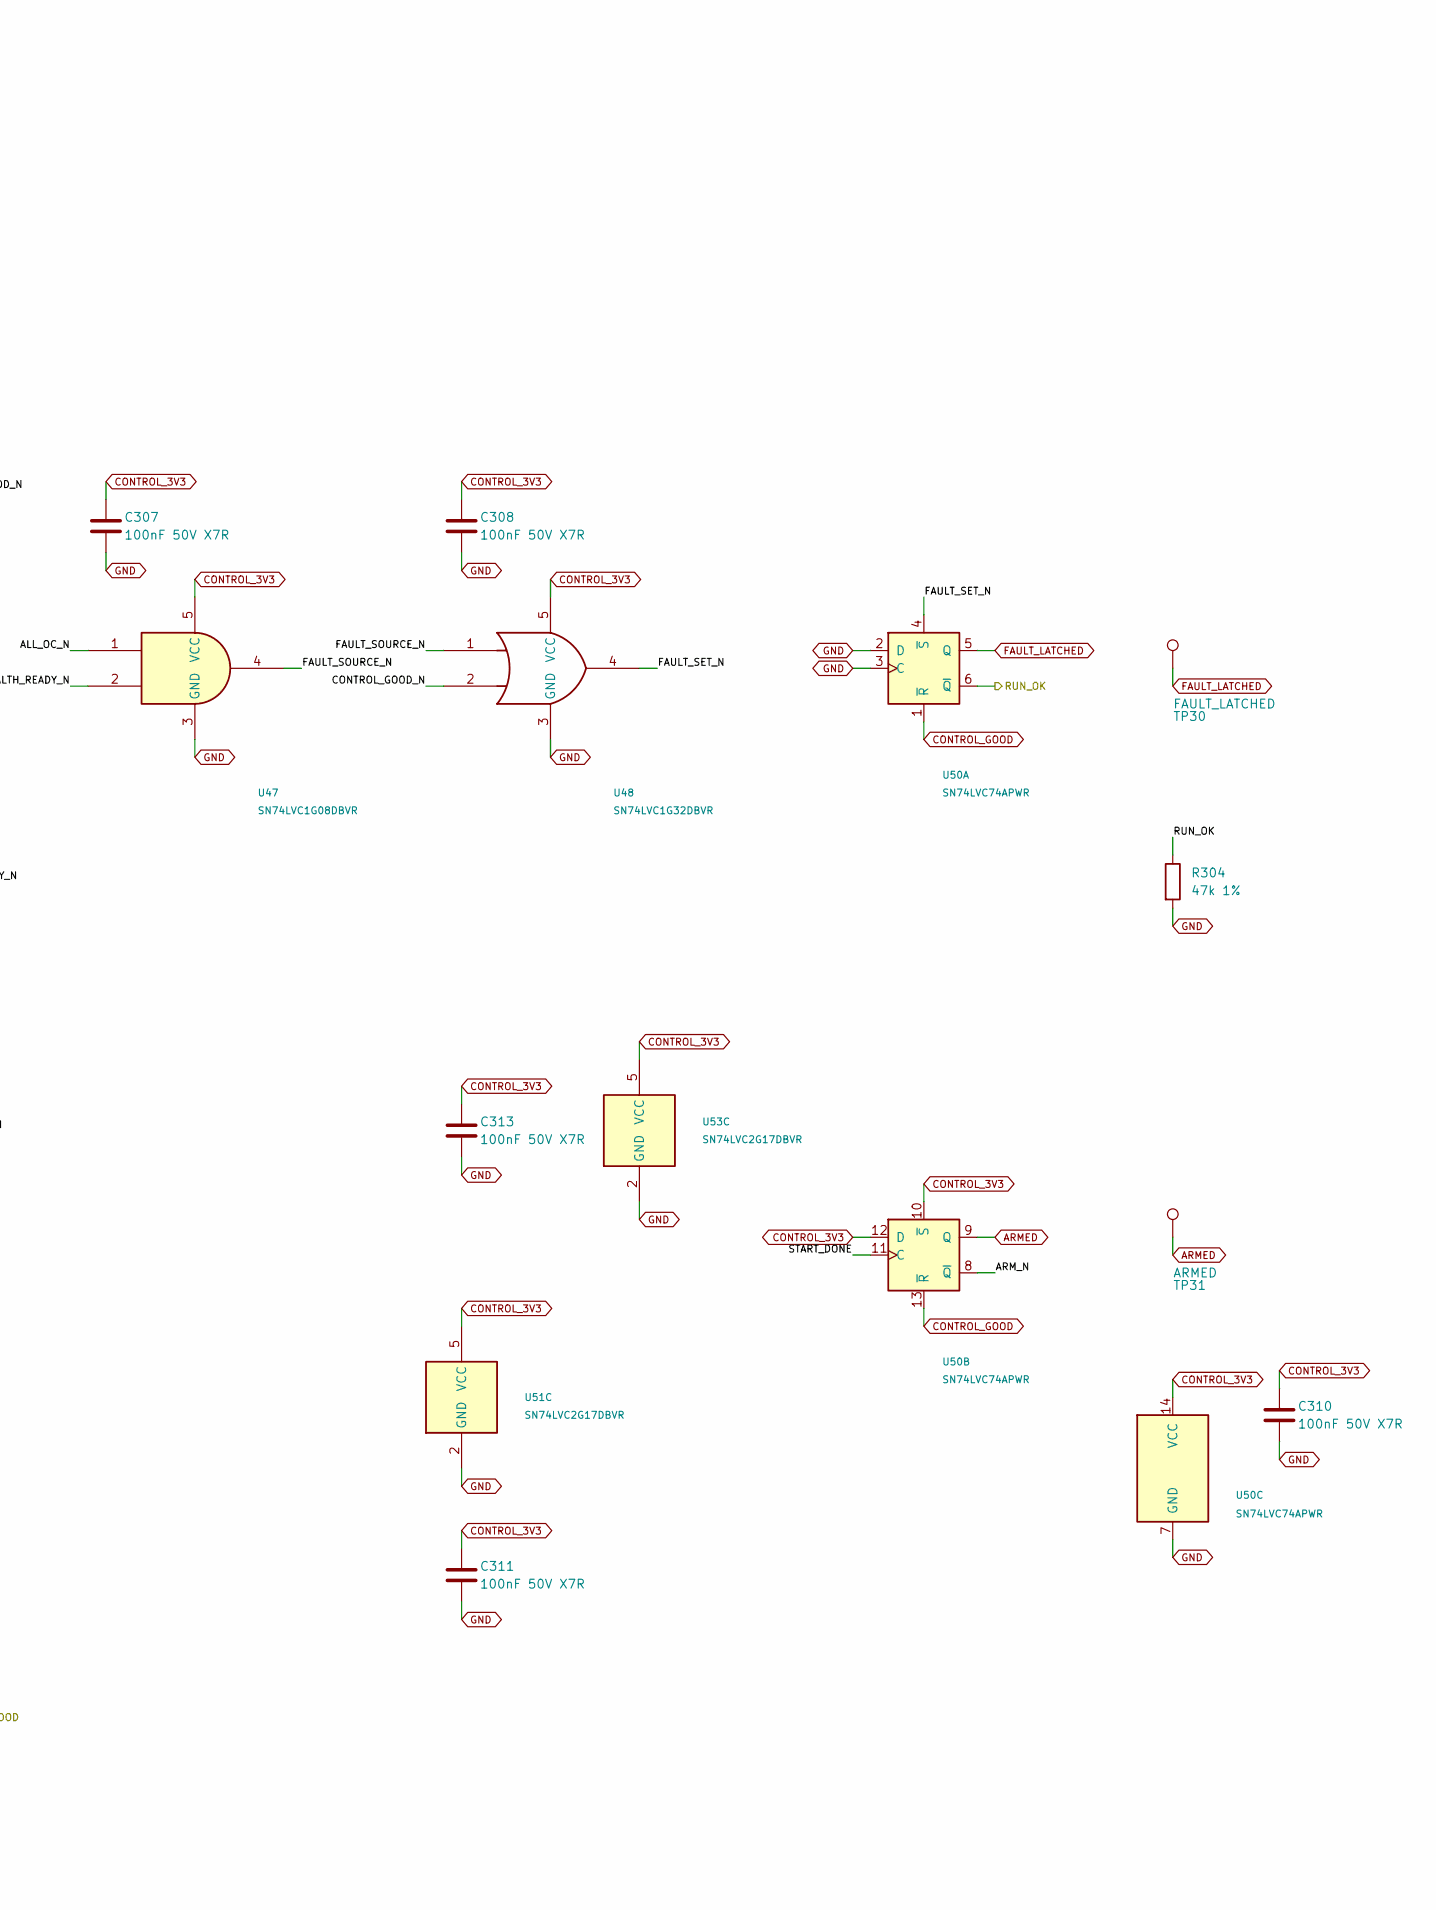
[picture p83: schematic shutdown.kicad_sch, Klink Hub - fault shutdown, part in row 1, column 2]

Parts:
C300, C303, C306, C307, C308, C309, C310, C311, C312, C313: 100nF 50V X7R; C_0805_2012Metric; MPN C2012X7R1H104K125AE
R302: 22k 1%; R_0805_2012Metric; MPN RC0805FR-0722KL
R303: 100k 1%; R_0805_2012Metric; MPN RC0805FR-07100KL
R304: 47k 1%; R_0805_2012Metric; MPN RC0805FR-0747KL
TP30: FAULT_LATCHED; TestPoint_Pad_D2.0mm
TP31: ARMED; TestPoint_Pad_D2.0mm
U40, U43: SN74HCS11PWR; TSSOP-14_4.4x5mm_P0.65mm; MPN SN74HCS11PWR
U46, U48: SN74LVC1G32DBVR; SOT-23-5; MPN SN74LVC1G32DBVR
U47: SN74LVC1G08DBVR; SOT-23-5; MPN SN74LVC1G08DBVR
U49: SN74LVC1G04DBVR; SOT-23-5; MPN SN74LVC1G04DBVR
U50: SN74LVC74APWR; TSSOP-14_4.4x5mm_P0.65mm; MPN SN74LVC74APWR
U51, U53: SN74LVC2G17DBVR; SOT-23-6; MPN SN74LVC2G17DBVR
U52: TPS3808G01DBVR; SOT-23-6; MPN TPS3808G01DBVR

Connections:
/CONTROL_GOOD_RAW: U51.3; also elsewhere on the board
/Distribution/Fault shutdown/ALL_HEALTH_N: U46.1, U53.4
/Distribution/Fault shutdown/ALL_HEALTH_RAW_N: U43.8, U53.3
/Distribution/Fault shutdown/ALL_OC_N: U47.1, U53.6
/Distribution/Fault shutdown/ALL_OC_RAW_N: U40.8, U53.1
/Distribution/Fault shutdown/ARM_N: U46.2, U50.8 (~Q)
/Distribution/Fault shutdown/CONTROL_GOOD_N: U48.2, U49.4
/Distribution/Fault shutdown/FAULT_SET_N: U48.4, U50.4 (~S)
/Distribution/Fault shutdown/FAULT_SOURCE_N: U47.4, U48.1
/Distribution/Fault shutdown/HEALTH_A: U43.9, U43.12
/Distribution/Fault shutdown/HEALTH_B: U43.6, U43.10
/Distribution/Fault shutdown/HEALTH_READY_N: U46.4, U47.2
/Distribution/Fault shutdown/OC_A: U40.9, U40.12
/Distribution/Fault shutdown/OC_B: U40.6, U40.10
/Distribution/Fault shutdown/START_CT: R303.2, U52.4 (CT)
/Distribution/Fault shutdown/START_DONE: U50.11 (C), U51.6
/Distribution/Fault shutdown/START_DONE_RAW: R302.2, U51.1, U52.1 (~RESET)
/INPUT_ENABLE: U52.5 (SENSE); also elsewhere on the board
/RUN_OK: R304.1, U50.6 (~Q); also elsewhere on the board
ARMED: TP31.1, U50.9 (Q); also elsewhere on the board
CONTROL_3V3: C300.1, C303.1, C306.1, C307.1, C308.1, C309.1, C310.1, C311.1, C312.1, C313.1, R302.1, R303.1, U40.14 (VCC), U43.14 (VCC), U46.5 (VCC), U47.5 (VCC), U48.5 (VCC), U49.5 (VCC), U50.10 (~S), U50.12 (D), U50.14 (VCC), U51.5 (VCC), U52.6 (VDD), U53.5 (VCC); also elsewhere on the board
CONTROL_GOOD: U49.2, U50.1 (~R), U50.13 (~R), U51.4, U52.3 (~MR); also elsewhere on the board
FAULT_LATCHED: TP30.1, U50.5 (Q); also elsewhere on the board
GND: C300.2, C303.2, C306.2, C307.2, C308.2, C309.2, C310.2, C311.2, C312.2, C313.2, R304.2, U40.7 (GND), U43.7 (GND), U46.3 (GND), U47.3 (GND), U48.3 (GND), U49.3 (GND), U50.2 (D), U50.3 (C), U50.7 (GND), U51.2 (GND), U52.2 (GND), U53.2 (GND); also elsewhere on the board
INPUT_FAULT_N: U43.11; also elsewhere on the board
INPUT_OC_N: U40.11; also elsewhere on the board
PORT1_HEALTH_N: U43.1; also elsewhere on the board
PORT1_OC_N: U40.1; also elsewhere on the board
PORT2_HEALTH_N: U43.2; also elsewhere on the board
PORT2_OC_N: U40.2; also elsewhere on the board
PORT3_HEALTH_N: U43.13; also elsewhere on the board
PORT3_OC_N: U40.13; also elsewhere on the board
PORT4_HEALTH_N: U43.3; also elsewhere on the board
PORT4_OC_N: U40.3; also elsewhere on the board
PORT5_HEALTH_N: U43.4; also elsewhere on the board
PORT5_OC_N: U40.4; also elsewhere on the board
PORT6_HEALTH_N: U43.5; also elsewhere on the board
PORT6_OC_N: U40.5; also elsewhere on the board

Notes on the sheet:
Overcurrent is never blanked. Health faults latch when the startup allowance expires.
CT to VDD through 100k: 180-420ms allowance from the power-enable request.

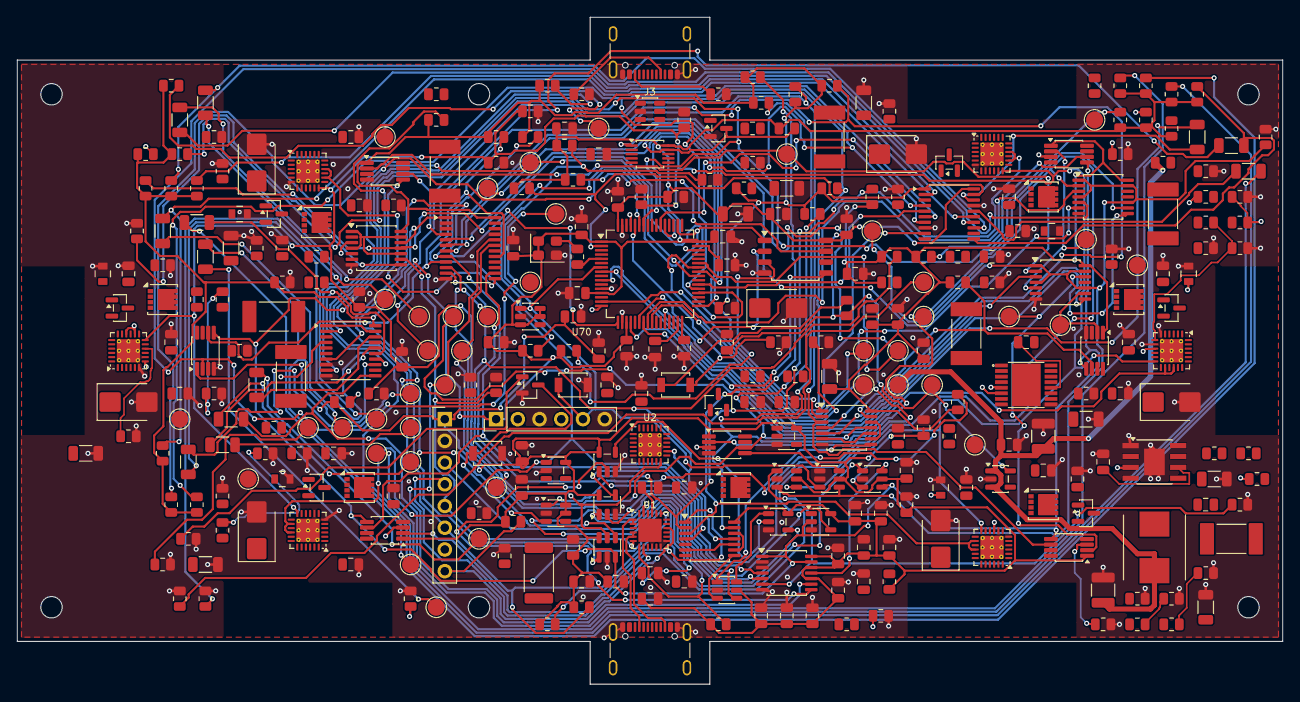
[picture p84: board hub.kicad_pcb from above]

Board: 4 copper layers, 148.0 x 78.0 mm, 356 parts (0 on the bottom side), 227 nets.

Other parts of the board:
H1, H2, H3, H4, H5, H6: MountingHole_2.5mm
