Bruhdows/klink/hardware/electronics/elevator/elevator.kicad_pcb

## KiCad design hardware/electronics/elevator/elevator.kicad_pcb (2026-11-09)

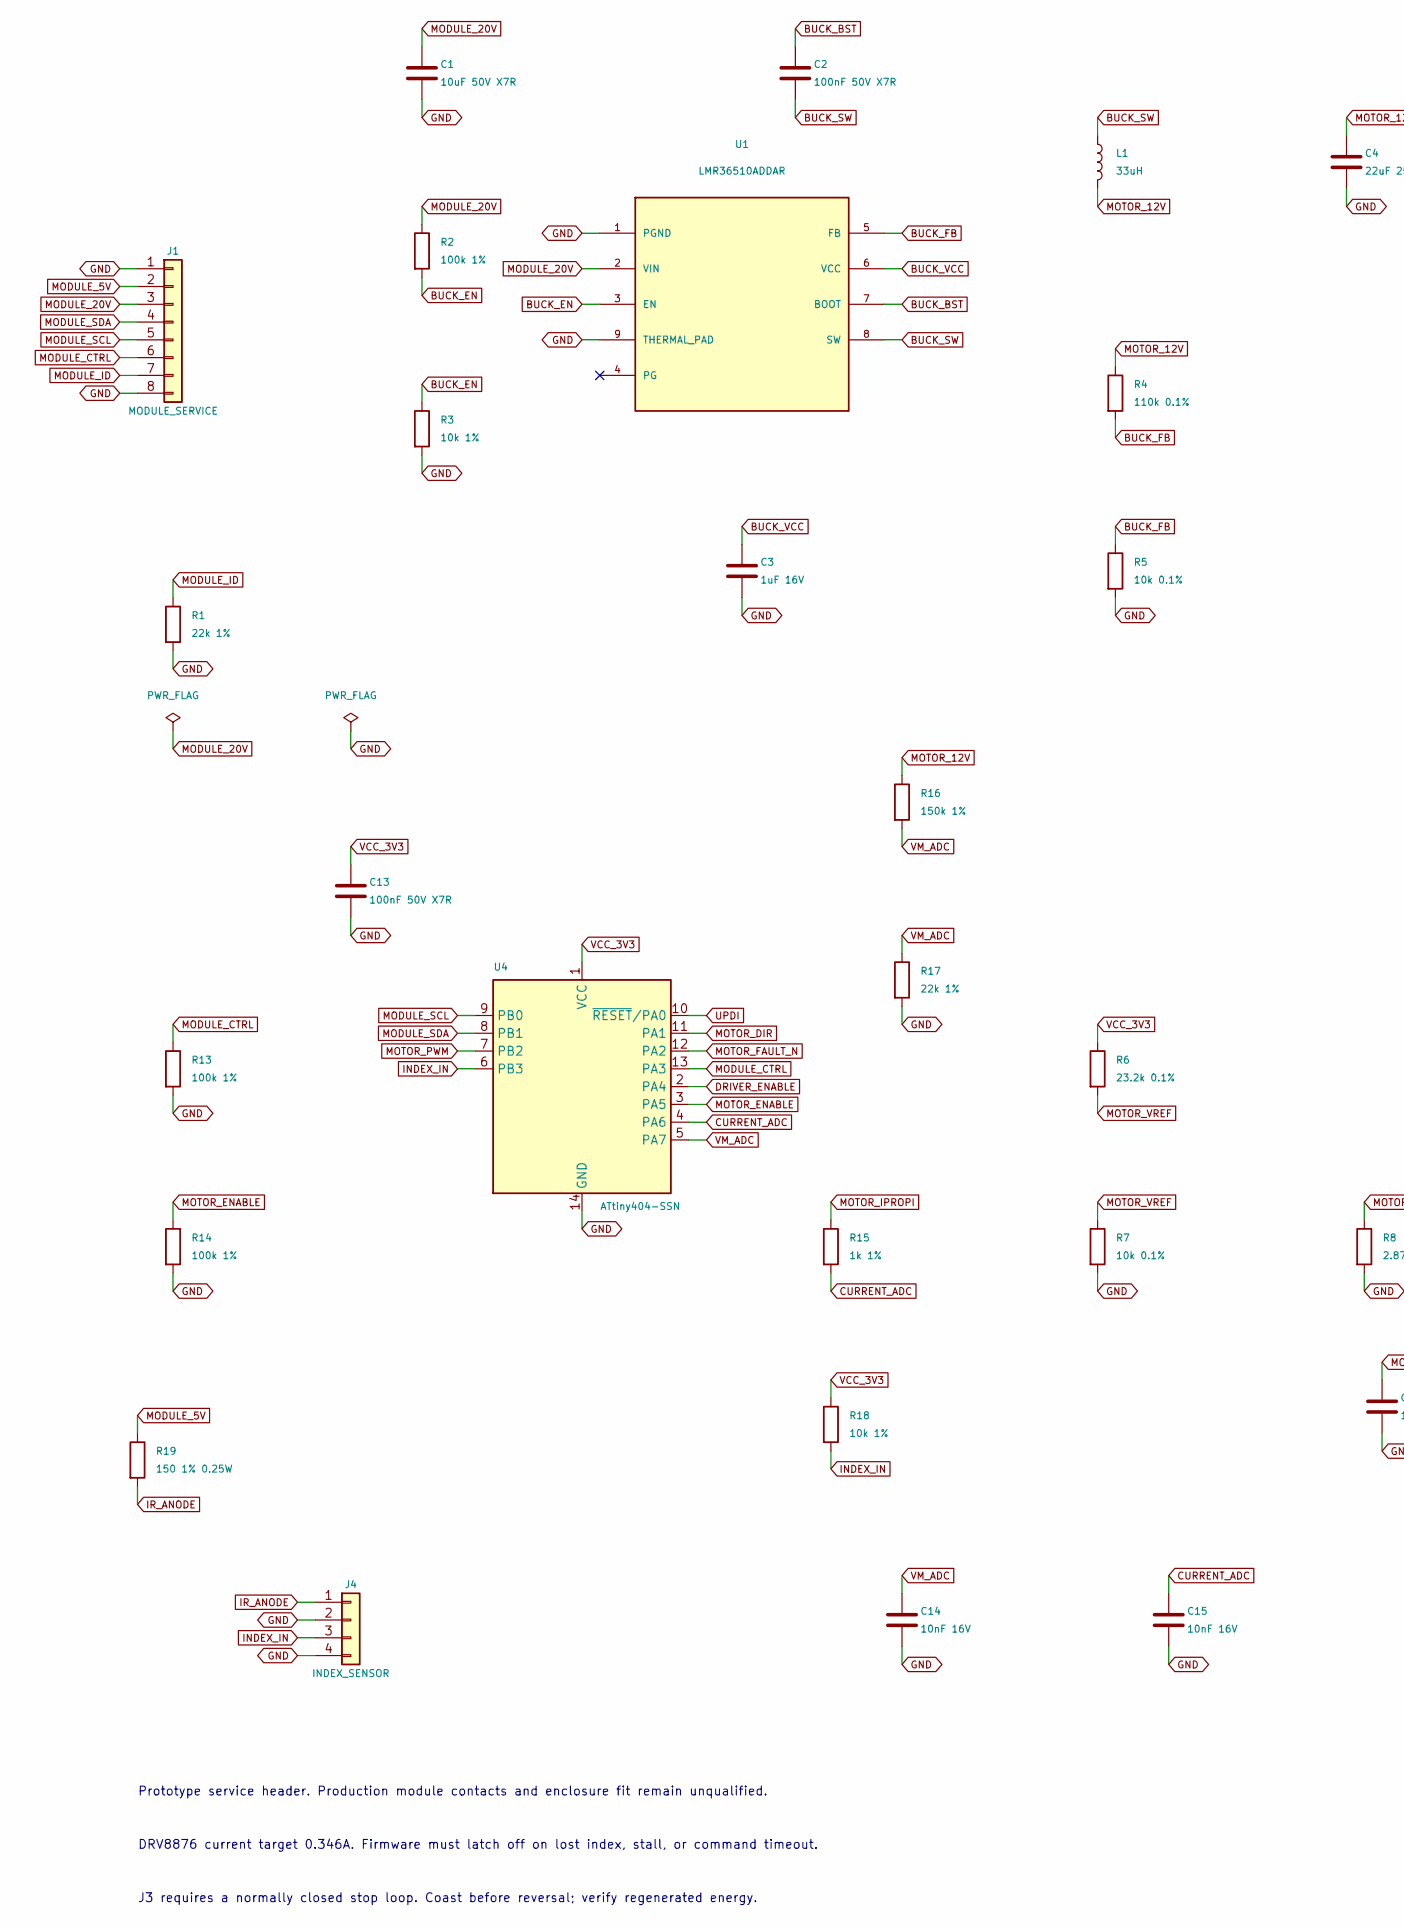
[picture p85: schematic elevator.kicad_sch, Klink elevator, part in row 1, column 1]

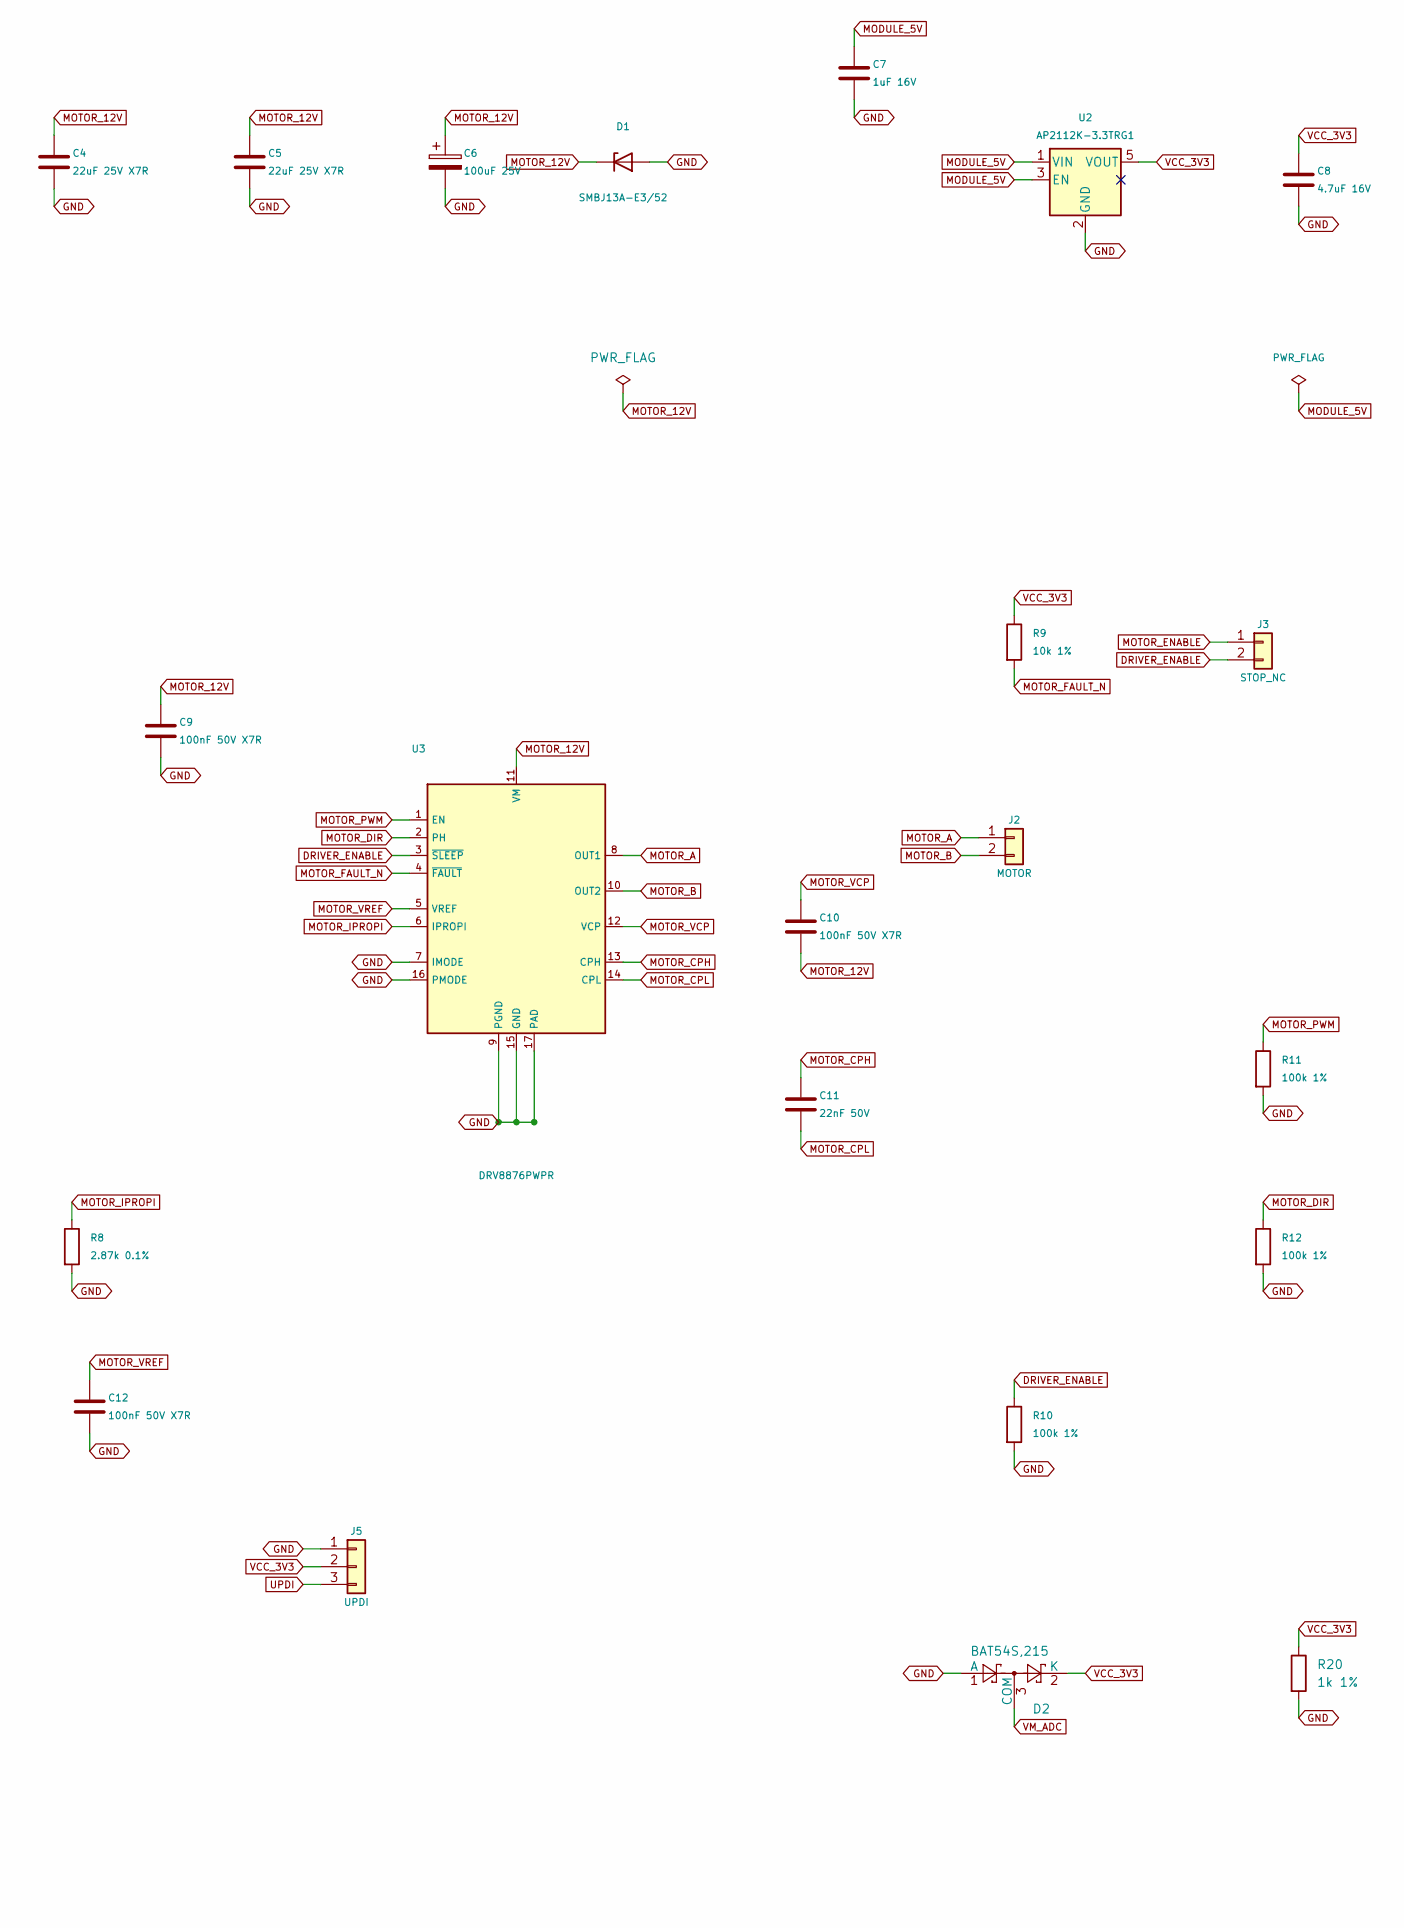
[picture p86: schematic elevator.kicad_sch, Klink elevator, part in row 1, column 2]

Parts:
C1: 10uF 50V X7R; C_1206_3216Metric; MPN C3216X7R1H106K160AC
C2, C9, C10, C12, C13: 100nF 50V X7R; C_0805_2012Metric; MPN C2012X7R1H104K125AE
C3, C7: 1uF 16V; C_0805_2012Metric; MPN C2012X7R1H105K125AB
C4, C5: 22uF 25V X7R; C_1210_3225Metric; MPN C1210C226K3RACTU
C6: 100uF 25V; CP_Elec_6.3x7.7; MPN EEH-ZC1E101XP
C8: 4.7uF 16V; C_0805_2012Metric; MPN C2012X7R1C475K125AB
C11: 22nF 50V; C_TDK_C2012_Reflow; MPN C2012C0G1H223J125AA
C14, C15: 10nF 16V; C_0805_2012Metric; MPN CC0805KRX7R9BB103
D1: SMBJ13A-E3/52; D_SMB; MPN SMBJ13A-E3/52
D2: BAT54S,215; SOT-23; MPN BAT54S,215
J1: MODULE_SERVICE; PinHeader_1x08_P2.54mm_Vertical; MPN TSW-108-07-G-S
J2: MOTOR; PinHeader_1x02_P2.54mm_Vertical; MPN TSW-102-07-G-S
J3: STOP_NC; PinHeader_1x02_P2.54mm_Vertical; MPN TSW-102-07-G-S
J4: INDEX_SENSOR; PinHeader_1x04_P2.54mm_Vertical; MPN TSW-104-07-G-S
J5: UPDI; PinHeader_1x03_P2.54mm_Vertical; MPN TSW-103-07-G-S
L1: 33uH; L_Bourns_SRP7050TA; MPN SRP7050TA-330M
R1, R17: 22k 1%; R_0805_2012Metric; MPN RC0805FR-0722KL
R2, R10, R11, R12, R13, R14: 100k 1%; R_0805_2012Metric; MPN RC0805FR-07100KL
R3, R9, R18: 10k 1%; R_0805_2012Metric; MPN RC0805FR-0710KL
R4: 110k 0.1%; R_0805_2012Metric; MPN RT0805BRD07110KL
R5, R7: 10k 0.1%; R_0805_2012Metric; MPN RT0805BRD0710KL
R6: 23.2k 0.1%; R_0805_2012Metric; MPN RT0805BRD0723K2L
R8: 2.87k 0.1%; R_0805_2012Metric; MPN RT0805BRD072K87L
R15, R20: 1k 1%; R_0805_2012Metric; MPN RC0805FR-071KL
R16: 150k 1%; R_0805_2012Metric; MPN RC0805FR-07150KL
R19: 150 1% 0.25W; R_1206_3216Metric; MPN RC1206FR-07150RL
U1: LMR36510ADDAR; TI_SO-PowerPAD-8; MPN LMR36510ADDAR
U2: AP2112K-3.3TRG1; SOT-23-5; MPN AP2112K-3.3TRG1
U3: DRV8876PWPR; TI_PWP0016A_Mask3.3x3.3; MPN DRV8876PWPR
U4: ATtiny404-SSN; SOIC-14_3.9x8.7mm_P1.27mm; MPN ATTINY404-SSN

Connections:
BUCK_BST: C2.1, U1.7 (BOOT)
BUCK_EN: R2.2, R3.1, U1.3 (EN)
BUCK_FB: R4.2, R5.1, U1.5 (FB)
BUCK_SW: C2.2, L1.1, U1.8 (SW)
BUCK_VCC: C3.1, U1.6 (VCC)
CURRENT_ADC: C15.1, R15.2, U4.4 (PA6)
DRIVER_ENABLE: J3.2, R10.1, U3.3 (~SLEEP), U4.2 (PA4)
GND: C1.2, C3.2, C4.2, C5.2, C6.2, C7.2, C8.2, C9.2, C12.2, C13.2, C14.2, C15.2, D1.2 (A), D2.1 (A), J1.1, J1.8, J4.2, J4.4, J5.1, R1.2, R3.2, R5.2, R7.2, R8.2, R10.2, R11.2, R12.2, R13.2, R14.2, R17.2, R20.2, U1.1 (PGND), U1.9 (THERMAL_PAD), U2.2 (GND), U3.7 (IMODE), U3.9 (PGND), U3.15 (GND), U3.16 (PMODE), U3.17 (PAD), U4.14 (GND)
INDEX_IN: J4.3, R18.2, U4.6 (PB3)
IR_ANODE: J4.1, R19.2
MODULE_5V: C7.1, J1.2, R19.1, U2.1 (VIN), U2.3 (EN)
MODULE_20V: C1.1, J1.3, R2.1, U1.2 (VIN)
MODULE_CTRL: J1.6, R13.1, U4.13 (PA3)
MODULE_ID: J1.7, R1.1
MODULE_SCL: J1.5, U4.9 (PB0)
MODULE_SDA: J1.4, U4.8 (PB1)
MOTOR_12V: C4.1, C5.1, C6.1, C9.1, C10.2, D1.1 (K), L1.2, R4.1, R16.1, U3.11 (VM)
MOTOR_A: J2.1, U3.8 (OUT1)
MOTOR_B: J2.2, U3.10 (OUT2)
MOTOR_CPH: C11.1, U3.13 (CPH)
MOTOR_CPL: C11.2, U3.14 (CPL)
MOTOR_DIR: R12.1, U3.2 (PH), U4.11 (PA1)
MOTOR_ENABLE: J3.1, R14.1, U4.3 (PA5)
MOTOR_FAULT_N: R9.2, U3.4 (~FAULT), U4.12 (PA2)
MOTOR_IPROPI: R8.1, R15.1, U3.6 (IPROPI)
MOTOR_PWM: R11.1, U3.1 (EN), U4.7 (PB2)
MOTOR_VCP: C10.1, U3.12 (VCP)
MOTOR_VREF: C12.1, R6.2, R7.1, U3.5 (VREF)
UPDI: J5.3, U4.10 (~RESET/PA0)
VCC_3V3: C8.1, C13.1, D2.2 (K), J5.2, R6.1, R9.1, R18.1, R20.1, U2.5 (VOUT), U4.1 (VCC)
VM_ADC: C14.1, D2.3 (COM), R16.2, R17.1, U4.5 (PA7)

Notes on the sheet:
Prototype service header. Production module contacts and enclosure fit remain unqualified.
DRV8876 current target 0.346A. Firmware must latch off on lost index, stall, or command timeout.
J3 requires a normally closed stop loop. Coast before reversal; verify regenerated energy.

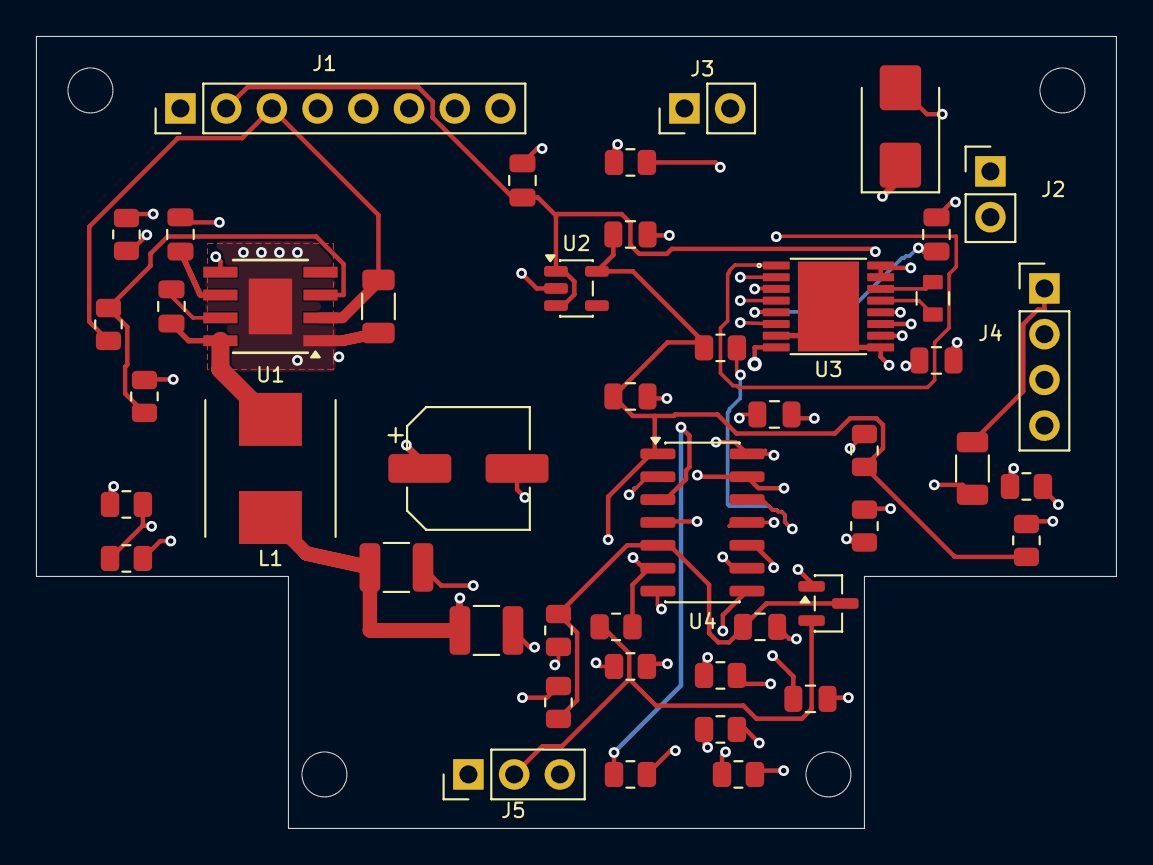
[picture p87: board elevator.kicad_pcb from above]

Board: 4 copper layers, 60.0 x 44.0 mm, 51 parts (0 on the bottom side), 31 nets.

Other parts of the board:
H1, H2, H3, H4: MountingHole_2.5mm
