Bruhdows/klink/hardware/electronics/button/button.kicad_pcb

## KiCad design hardware/electronics/button/button.kicad_pcb (2026-11-09)

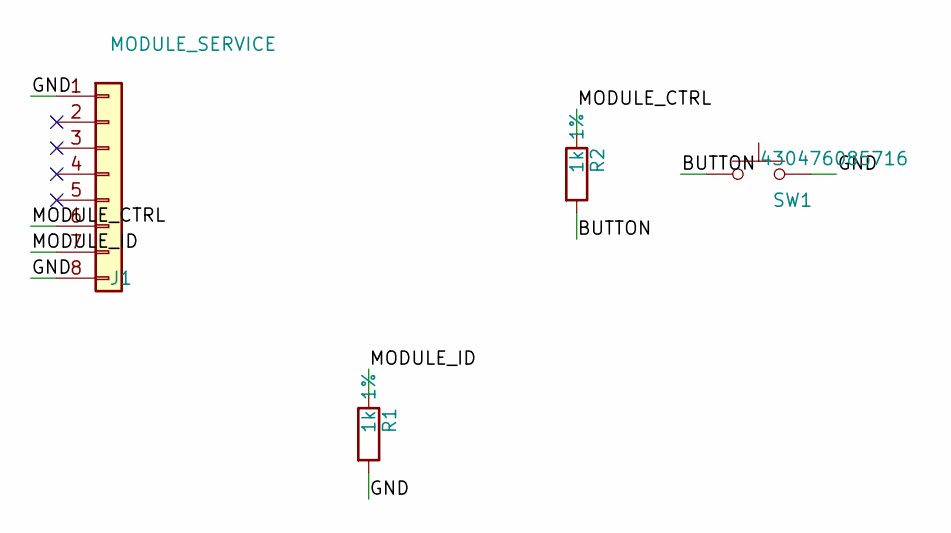
[picture p88: schematic button.kicad_sch]

Parts:
J1: MODULE_SERVICE; PinHeader_1x08_P2.54mm_Vertical; MPN M20-9990846
R1, R2: 1k 1%; R_0805_2012Metric; MPN RC0805FR-071KL
SW1: 430476085716; SW_PUSH-12mm_Wuerth-430476085716; MPN 430476085716

Connections:
/BUTTON: R2.2, SW1.1
/GND: J1.1, J1.8, R1.2, SW1.2
/MODULE_CTRL: J1.6, R2.1
/MODULE_ID: J1.7, R1.1

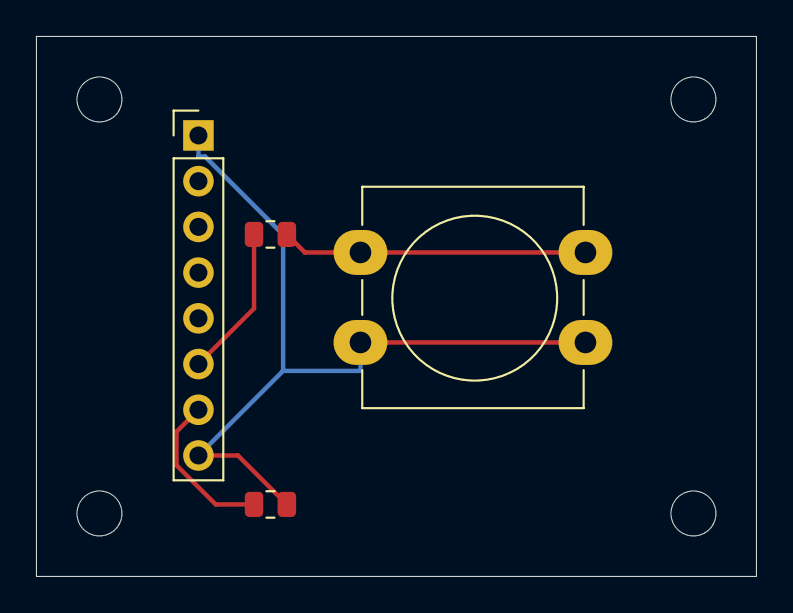
[picture p89: board button.kicad_pcb from above]

Board: 2 copper layers, 40.0 x 30.0 mm, 8 parts (0 on the bottom side), 4 nets.

Other parts of the board:
H1, H2, H3, H4: MountingHole_2.5mm
