Bruhdows/klink/hardware/electronics/marble-sensor/marble-sensor.kicad_pcb

## KiCad design hardware/electronics/marble-sensor/marble-sensor.kicad_pcb (2026-11-09)

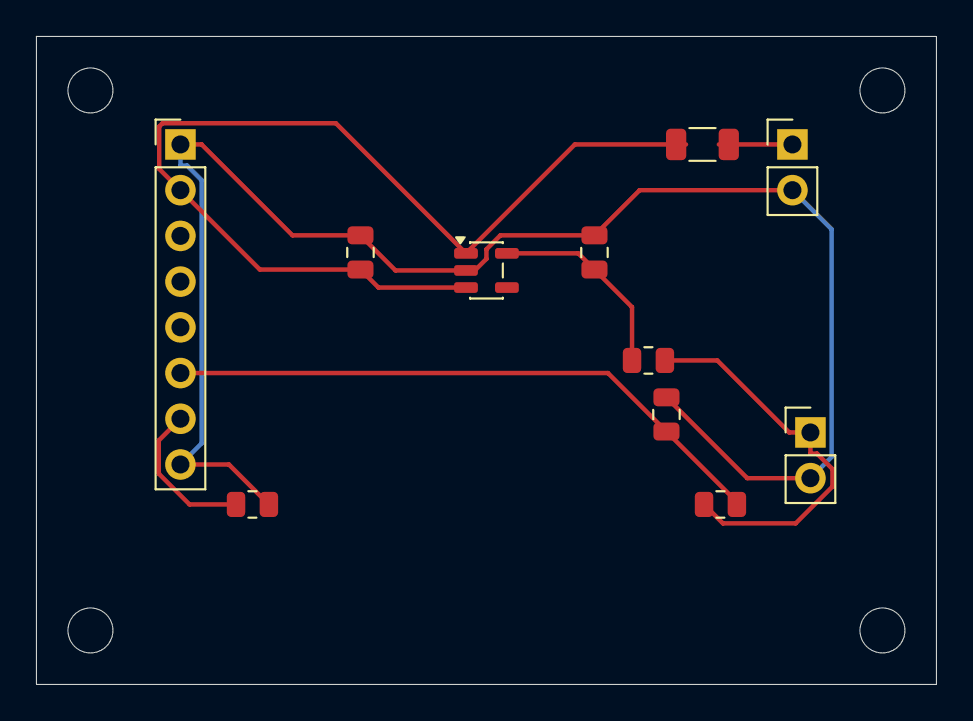
[picture p90: board marble-sensor.kicad_pcb from above]

Board: 2 copper layers, 50.0 x 36.0 mm, 15 parts (0 on the bottom side), 7 nets.

Parts:
C1, C2: 1uF 16V; C_0805_2012Metric
C3: 1nF 50V; C_0805_2012Metric
H1, H2, H3, H4: MountingHole_2.5mm
J1: MODULE_SERVICE; PinHeader_1x08_P2.54mm_Vertical
J2: IR_EMITTER; PinHeader_1x02_P2.54mm_Vertical
J3: PHOTOTRANSISTOR_C_E; PinHeader_1x02_P2.54mm_Vertical
R1: 2.2k 1%; R_0805_2012Metric
R2: 220 1% 0.25W; R_1206_3216Metric
R3: 10k 1%; R_0805_2012Metric
R4: 1k 1%; R_0805_2012Metric
U1: AP2112K-3.3TRG1; SOT-23-5

Connections:
/GND: C1.2, C2.2, C3.2, J1.1, J1.8, J2.2, J3.2, R1.2, U1.2
/IR_ANODE: J2.1, R2.2
/MODULE_5V: C1.1, J1.2, R2.1, U1.1, U1.3
/MODULE_CTRL: C3.1, J1.6, R4.2
/MODULE_ID: J1.7, R1.1
/SENSE: J3.1, R3.2, R4.1
/SENSOR_3V3: C2.1, R3.1, U1.5
