Bruhdows/klink/hardware/electronics/contact-test/side-flat-test.kicad_pcb

## KiCad design hardware/electronics/contact-test/side-flat-test.kicad_pcb (2026-11-09)

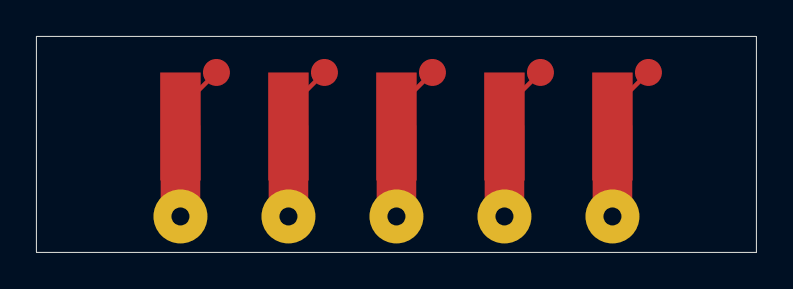
[picture p91: board side-flat-test.kicad_pcb from above]

Board: 2 copper layers, 40.0 x 12.0 mm, 15 parts (0 on the bottom side), 5 nets.

Parts:
J1, J2, J3, J4, J5: TIN MATE TEST
TP1, TP2, TP3, TP4, TP5: FORCE
TP6, TP7, TP8, TP9, TP10: SENSE

Connections:
CHANNEL_1: J1.1, TP1.1, TP6.1
CHANNEL_2: J2.1, TP2.1, TP7.1
CHANNEL_3: J3.1, TP3.1, TP8.1
CHANNEL_4: J4.1, TP4.1, TP9.1
CHANNEL_5: J5.1, TP5.1, TP10.1
