Bruhdows/klink/hardware/electronics/contact-test/spring-contact-test.kicad_pcb

## KiCad design hardware/electronics/contact-test/spring-contact-test.kicad_pcb (2026-11-04)

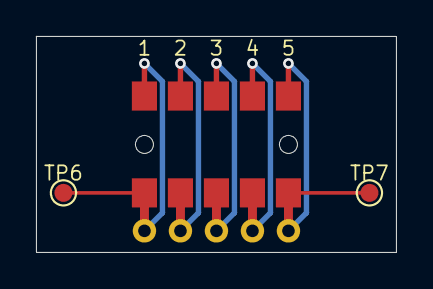
[picture p92: board spring-contact-test.kicad_pcb from above]

Board: 2 copper layers, 20.0 x 12.0 mm, 8 parts (0 on the bottom side), 5 nets.

Parts:
J1: UNQUALIFIED CONTACT TEST; SAMZO_03E315320_TestOnly
TP1: CH1
TP2: CH2
TP3: CH3
TP4: CH4
TP5: CH5
TP6: CH1_SENSE; TestPoint_Pad_D1.0mm
TP7: CH5_SENSE; TestPoint_Pad_D1.0mm

Connections:
CH1: J1.1, TP1.1, TP6.1
CH2: J1.2, TP2.1
CH3: J1.3, TP3.1
CH4: J1.4, TP4.1
CH5: J1.5, TP5.1, TP7.1
