Bruhdows/klink/(commit log)

2026-11-01 Separate magnet test from base tile
2026-11-01 Add straight marble track
2026-11-01 Add initial smart tile schematic
2026-11-01 Ignore KiCad temporary files
2026-11-01 Prototype smart tile electrical connector integration
2026-11-01 Add edge detection and preliminary power protection
2026-11-02 Add Rev A tile protection and connector tests
2026-11-04 Add Hub protection and power distribution checks
2026-11-09 Advance PCB integration and add CAD and manufacturing drafts
2026-11-09 Consolidate funding BOM and document remaining release gates
2026-11-09 Connect tile ground islands with external return vias
2026-11-09 Add Hub ground-return fanouts without changing isolated returns
2026-11-09 Advance core routing, ground returns and funding cost evidence
